UavL/Glider/pcb/r2-mainboard/datasheets/SiC OSD62x-PM/OSD62x-PM Layout Guide _ Octavo Systems_files/Octava-Systems-OSD32MP2-SiP-1024x734.jpg

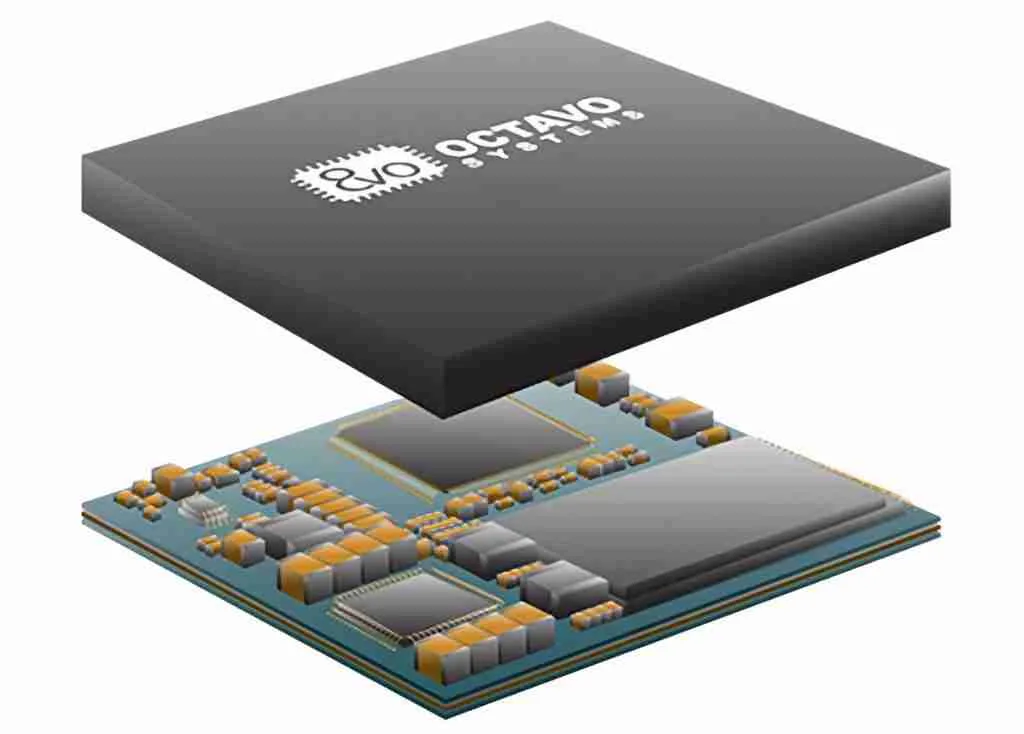
pcb/r2-mainboard/datasheets/SiC OSD62x-PM/OSD62x-PM Layout Guide _ Octavo Systems_files/Octava-Systems-OSD32MP2-SiP-1024x734.jpg
