UavL/Glider/pcb/r2-mainboard/datasheets/SiC OSD62x-PM/OSD62x-PM Thermal Guide _ Octavo Systems_files/osd3358-sm-red-angle-product-carousel.png

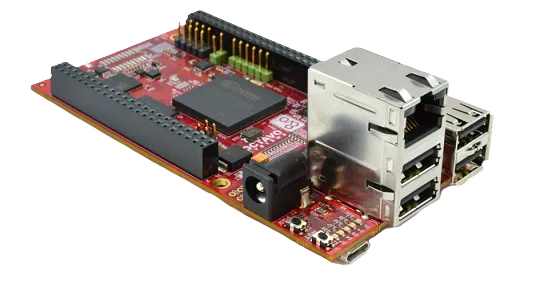
pcb/r2-mainboard/datasheets/SiC OSD62x-PM/OSD62x-PM Thermal Guide _ Octavo Systems_files/osd3358-sm-red-angle-product-carousel.png
