UavL/Glider/pcb/r2-mainboard/docs/libraries.md

# Project-local symbols and footprints — what was made here, and how to check it

Everything in `r2.kicad_sym` and `r2.pretty/` was **created for R2** because it did not exist in
KiCad's stock libraries or in the `pcb_common` submodule that came with Glider. This file is the
audit list: what each thing is, what it was derived from, which script emits it, and what was
actually checked.

**`pcb_common` has never been modified.** It is a submodule shared with R1; every addition went into
the project-local `r2` libraries instead, so `git -C pcb/pcb_common status` should always be clean.
If it is not, something has gone wrong.

Written 2026-08-31, at the owner's request, before rehoming the libraries.

---

## 1. How to re-derive any of these

Every entry is generated by a script in `tools/`, not drawn by hand. That is deliberate: a generated
footprint can be re-emitted and diffed against the datasheet numbers, and most of the generators
assert their own geometry. To check one, read the script's header — it names the drawing and the
page — then re-run it and confirm the file is unchanged.

## 2. Symbols — `r2.kicad_sym`

| Symbol | Part | Generator | Derived from | Checked |
| --- | --- | --- | --- | --- |
| `BQ25892RTW` | charger | `gen_r2_symbols.py` | `datasheets/Battery/bq25890.pdf` pin table | `battery.md` |
| `MAX17048` | fuel gauge | `gen_r2_symbols.py` | `datasheets/Battery/max17048.pdf` | `battery.md` |
| `MT9700` | EPD load switch | `gen_r2_symbols.py` | ported with R1's `epd_power` | `epd-port.md` |
| `SY8120` | buck | `gen_r2_symbols.py` | ported from R1 | `epd-port.md` |
| `TPS22965DSG` | load switch | `gen_r2_symbols.py` | `datasheets/Power/tps22965.pdf` | `power.md` |
| `TPS62A02DRL` | buck | `gen_r2_symbols.py` | `datasheets/Power/tps62a01.pdf` | `power.md` §3 |
| `TPS63802DLA` | buck-boost | `gen_r2_symbols.py` | `datasheets/Power/tps63802.pdf` | `power.md` §3 |
| `TPS7A0233DBV` | LDO | `gen_r2_symbols.py` | `datasheets/Power/tps7a02.pdf` | `power.md` |
| `USBLC6-2SC6` | USB ESD | `gen_r2_symbols.py` | ST datasheet | used on `U202`, `U1403` |
| `LM3630A` | frontlight driver | `gen_frontlight.py` | `datasheets/Frontlight/lm3630a.pdf` | `frontlight.md` |
| `BOM_ITEM` | placeholder for bought items with no pins (`X500`, `MK500`) | `gen_som.py` | — | `som.md` §10 |
| `BTH-060_AB` | SoM connector, module columns A+B | `gen_som_symbol.py` | `som_pinout.json` ← PHYTEC `L-1038e.A5` Tables 7–10 | `som.md` §10–11 |
| `BTH-060_CD` | SoM connector, columns C+D | `gen_som_symbol.py` | same | `som.md` §10–11 |
| **`TPS2553DBV`** | **USB current-limited switch** | **`gen_usb_host.py`** | **`datasheets/Power/tps2553.pdf` Pin Functions table** | **§4 below** |
| **`KLM8G1GETF-B041`** | **Samsung eMMC 5.1, 8 GB, 153-ball FBGA** | **`gen_emmc_symbol.py`** | **`datasheets/Storage/samsung_emmc.pdf` Rev. 1.21 [Table 2], parsed at run time, checked against a hand transcription of Figure 1** | **asserted by the generator: 153 pin numbers = the stock `LFBGA-153…` pads, names verbatim, types by rule, three units, no hidden pin, no two pins at one position, all on the 2.54 grid. Rendered with `kicad-cli sym export svg` and looked at. `sic.md` §6.1** |

The eMMC's **footprint is not ours**: `Package_BGA:LFBGA-153_11.5x13mm_Layout14x14_P0.5mm` from
KiCad's stock library, used as it is (JEDEC MO-276F, 153 lands of 0.24 mm at 0.5 mm pitch). It was
checked against the Samsung drawing — 11.5 × 13 mm body, 0.30 mm balls — and every ball the
datasheet names has a land. The board already places three other stock `Package_BGA` footprints, so
nothing was copied into the project.

## 3. Footprints — `r2.pretty/`

| Footprint | For | Generator | Derived from | Checked |
| --- | --- | --- | --- | --- |
| `Texas_DLA0010A_VSON-HR-10_2x3mm_P0.5mm` | `U13` `TPS63802` | `gen_power.py` | `tps63802.pdf` drawing **4223750/D** p.36 land pattern | `layout.md` §3.1 — two independent geometry assertions |
| `Texas_YFQ0012_DSBGA-12_1.91x1.39mm_Layout3x4_P0.4mm` | `U1300` `LM3630A` | `gen_yfq0012.py` | `lm3630a.pdf` mechanical drawing | `frontlight.md` §9.1 |
| `BTH-060-01-L-D-A-K_AB` | `J501` | `gen_som_footprint.py` | PHYTEC DXF `PCM-071_1573-1.dxf` + Samtec drawing | `som.md` §11, `check_pcb_connectors.py` |
| `BTH-060-01-L-D-A-K_CD` | `J502` | `gen_som_footprint.py` | same | same |
| `PCM-071_Module` | `X500` — outline + 2× M2.5, **no pads** | `gen_som_footprint.py` | PHYTEC DXF, `BOARD_OUTLINE` layer | `som.md` §11 |
| `SolderPads_1x03_P3.50mm_Wire` | `J25` cell solder pads | `gen_solderpads.py` | drawn to spec, no datasheet | `battery.md` §9 |
| **`HC-FPC-05-09-8RLTAG_Mirrored`** | **`J1300` frontlight** | **`gen_mirrored_fpc.py`** | **mirror of `pcb_common`'s `HC-FPC-05-09-8RLTAG`** | **§4 below** |
| **`Omron_XF2M-4015-1A_1x40-1MP_P0.5mm_Horizontal_Mirrored`** | **`J1000` panel** | **`gen_mirrored_fpc.py`** | **mirror of KiCad's stock `Omron_XF2M-4015-1A…`** | **§4 below** |

## 4. The three added 2026-08-30/31, in more detail

These are the newest and the least reviewed, so they are worth checking first.

### 4.1 `TPS2553DBV` symbol

Pin assignment is straight off the datasheet's **Pin Functions** table (SOT-23 column), which lists
two variants — the `TPS2552` has `EN` active *low* on pin 3 and the **`TPS2553` has `EN` active
high**. We fit the `TPS2553`, so `EN` is active high, which is what lets the SoM's `X_USB1_DRVVBUS`
drive it directly with no inverter.

| Pin | Name | Type |
| ---: | --- | --- |
| 1 | `IN` | power_in |
| 2 | `GND` | power_in |
| 3 | `EN` | input — **active high** |
| 4 | `~{FAULT}` | open_collector |
| 5 | `ILIM` | passive |
| 6 | `OUT` | power_out |

**Footprint is KiCad's stock `Package_TO_SOT_SMD:SOT-23-6`** — nothing new was drawn for it.

⚠ **What to check:** that pin 3 really is `EN` and not `EN` on the part you order. The `-1` suffix is
the latch-off version and the `TPS2552` is the active-low sibling; both are the same package with the
same pin *numbers*. We specify `TPS2553DBVR`, LCSC `C55266`.

### 4.2 The two `_Mirrored` FPC footprints

These are **not new land patterns**. Each is its parent with the *numbered pads mirrored in X* and
the pin-1 silkscreen tick moved; the body, the courtyard and the mechanical pads are untouched.

Both parts happen to carry **two symmetric mechanical pads** (±2.75 mm and ±11.4 mm), so the land
pattern is geometrically identical to the original — the same physical connector solders down in the
same orientation, and only *which net reaches which contact* changes.

They exist because the panel's two tails arrive with their pin 1 at opposite ends, and neither stock
footprint matched: `HC-FPC-05-09-8RLTAG` numbers from +x, `Omron XF2M-4015-1A` from −x. Full
reasoning and the bench measurement in `epd-port.md` §9.6.

⚠ **What to check:** `gen_mirrored_fpc.py` asserts, on every run, that pad 1 lands on pad *N*'s old
x and that the mechanical pads did not move. Re-run it and confirm the files are byte-identical. Then
check the *silkscreen pin-1 marker* has moved with the pads — it is the only thing an assembler sees.

This is also the convention `pcb_common` already uses: it ships **eight** `_Mirrored` variants
(`Xunpu_FPC-05F-8PH20_…`, `Hirose_FH12-…`) for exactly this reason. We put ours in `r2.pretty`
instead of adding to the submodule.

## 5. Not ours

For completeness, so the audit does not chase them:

- **`SAMTEC_BTH-060-X-X-D-A-K.kicad_mod`** in `datasheets/SoM Phycore AM62x/BTH-060-01-L-D-A-K-TR/`
  is Samtec's own download. It is *not* what the board uses — `gen_som_footprint.py` emits the two
  half-connectors with the module's pad names instead (`som.md` §10.2).
- Everything under `pcb_common/` came with Glider and is shared with R1.
- `Connector_Generic_MountingPin:Conn_01x40_MountingPin`, embedded in `epd.kicad_sch`, is KiCad's own
  symbol — but this machine has no KiCad symbol libraries installed, so `patch_j6_40pin.py` generated
  it by transforming the 50-pin variant already embedded in that sheet (drop pins 41–50, shift the
  rest by 12.7 mm). It is why ERC reports one `lib_symbol_mismatch` for it. **If you install KiCad's
  stock libraries, replace the embedded copy with the real one** and that warning goes away.

## 6. The owner's `Reflow` library — entries the assistant generated or checked

`library/Reflow.kicad_sym` and `library/Reflow.pretty/` are the owner's. Two entries arrived on
2026-09-11 from the SamacSys model Mouser links to (`library/LIB_OSD6254-1G-IPM.zip`).

| Entry | Part | Generator / origin | Derived from | Checked |
| --- | --- | --- | --- | --- |
| `OSD6254-1G-IPM` (symbol) | Octavo `OSD62x-PM` SiP | **`gen_osd62x_symbol.py`** — replaces SamacSys's single-unit import in place, same name | `datasheets/SiC OSD62x-PM/osd62x_pm_pinout.json` ← datasheet Rev. 2.0 Tables 5-1…5-7 (`parse_osd62x_pinout.py`), cross-checked against Octavo's own Eagle library in the BRK files, 500/500 | asserted by the generator: pin numbers = datasheet balls = footprint pads; names verbatim; types per `osd62x-symbol-guide.md` §3.3; 11 units, no hidden pin, no two pins at one position, all on the 2.54 grid; `VIDEO` = the 22 DPI balls. Rendered with `kicad-cli sym export svg` and looked at |
| `BGA500C50P28X18_1400X900X130` (footprint) | same | SamacSys, KiCad-5 `(module …)` format, used as downloaded | SamacSys | 500 pads named exactly as the datasheet's balls; **0.20 mm round lands**; 0.5 mm pitch, 28 × 18; row A along the top (top view). **Not yet checked:** courtyard, fab and silk outline against the datasheet's p. 31 drawing. Its 3D model path is a bare `OSD6254-1G-IPM.stp`, which will not resolve |
| `OSD62x-PM` (symbol) | — | the owner's | — | an empty stub — no pins, blank fields, used by no sheet. Left alone |
| **`TPS6521903`** (symbol) | **TI `TPS65219` PMIC — `U1501`** | **`gen_pmic_symbol.py`** — the owner created the container (name, Value, Description, an **embedded copy of the datasheet**); the script supplies pins, body and fields and writes the embedded block back verbatim | **`datasheets/Power/tps65219.pdf` (`SLVSGA0D`) Table 5-1**, transcribed and re-parsed from the PDF at run time | asserted by the generator: 29 of 33 rows re-parse and match the transcription (the other four defeat pdftotext's columns — the script asserts *which* four); pin numbers 1–33 = the stock footprint's pads; names verbatim; no hidden pin, no two pins at one position, all on the 2.54 grid; the embedded datasheet kept. Rendered and looked at |

The PMIC's **footprint is not ours** either: `Package_DFN_QFN:Texas_RHB0032E_VQFN-32-1EP_5x5mm_P0.5mm_EP3.45x3.45mm_ThermalVias`
from KiCad's stock library. The datasheet's package is **`RHB0032W`** (5 × 5 mm, 0.5 mm pitch, exposed
pad 3.5 mm), so the stock `…E` land pattern is 0.05 mm under on the pad; the `_ThermalVias` variant
already carries the ≥ 9 vias the datasheet requires under the power pad. `RHB0032M` is wrong — its
pad is 1.4 mm too small.

The SamacSys originals stay as they arrived: `library/OSD6254-1G-IPM.kicad_sym` (one unit, 500 `passive`
pins, names mangled where the datasheet wraps a line, e.g. `MCU__UART0_RTSN`) and the zip.
