UavL/Glider/pcb/r2-mainboard/docs/layout.md

# Layout — R2 Stage D

Status (2026-09-11): **routing under way on a six-layer, 0.8 mm board** (§4.1.1, owner-confirmed).
The DDR3 bus is being routed. **The SoM corner is frozen:** the compute module is switching from the
`PCM-071` to Octavo's `OSD62x-PM` (`NOTES-R2-osd62x-plan.md`), so `J501`/`J502`/`X500` will be
deleted; the sections below that place and escape the `PCM-071` are the record of that design.
~~Preparation done, placement blocked on ONE owner decision (§1) — where the SoM sits. Nothing has
been placed; `r2.kicad_pcb` does not exist yet.~~

This is the board-level plan. The *circuit-level* rules live with their sheets, and they were
written while each datasheet was open rather than reconstructed now:

| Sheet | Guidelines | The one thing that matters most |
| --- | --- | --- |
| `battery` | `battery.md` §11 | the grounds are not all the same net |
| `power` | `power.md` §11 | four converters, one rule they share; `TPS63802` has **two** switching nodes |
| `mcu` | `mcu.md` §11 | the 32.768 kHz crystal is the most layout-sensitive circuit on that sheet |
| `epd`, `epd_power`, `power_mon` | `epd-port.md` §11 | ⚠ **two ICs have a `GND` pin that is not ground** |
| `fpga_io`, `fpga_ddr`, `fpga_config` | `fpga.md` §11 | 666 MT/s against a 1066 part — the margin is the useful fact |
| `som`, `dpi_in` | `som.md` §8 | MMC1 length-match 12.7 mm; `DPI_R6`/`R206` carry no components |

**Read `epd-port.md` §11.1 before placing anything on the HV chain.** `U1103` and `U1106` are inverting
buck-boosts: their `GND` pins sit on `-VGL` (−20 V) and `-VN` (−15 V), verified from the exported
netlist. Each needs a local copper island with the plane cut away beneath it, and connecting either
to the ground plane destroys the part. It is the only thing on this board that a competent person
would "fix" into failure.

---

## 1. What blocks placement, and what does not

**Revised 2026-08-17. Two of the three are answered; one remains.**

1. **Board outline — the two objects that set it are now known.** The panel module
   (`GDEP103TC2-FT11`) is **174.4 × 216.7 × 1.93 mm**, 110 g ‡, with a 157.25 × 209.66 mm active
   area; the cell (`PL706090`) is **60 × 90 × 7.0 mm**. Those bound the enclosure, and the board has
   to fit in what is left behind the panel and beside the cell. R1 is **90 × 80 mm** for reference —
   so R1's area fits behind this panel with room over, and **thickness, not area, is the binding
   dimension.** The outline itself is still the owner's to draw, but it is no longer unconstrained.
   `panel.md` §0, `battery.md` §8.1.
2. ~~**Where the SoM sits, and on which side**~~ — **position ANSWERED 2026-08-20, side inferred.**
   See §1.1.
3. ~~**Battery cell size and position**~~ — size **closed** (60 × 90 × 7.0 mm). Position follows
   from decision 2.

### 1.1 The SoM goes top-right, beside the USB ports — owner, 2026-08-20

> ⚠ **2026-09-11:** the module in this section is the `PCM-071`, being replaced by the `OSD62x-PM`
> (`NOTES-R2-osd62x-plan.md`). The **position** reasoning carries over unchanged — the USB pair is still
> why the SoC sits beside the ports. The **thickness** table does not: the SiP is 1.3 mm tall, not a
> 5.0 mm stack, so the 7.0 mm cell becomes what sets the device's depth (inferred).

From the owner's layout sketch and its covering note: *"The SoM should be located near the top right
where I would place the USB ports."* Everything else on that sketch is recorded in §1.2.

**Position: top right, adjacent to the USB connectors.** This is the right call for a reason the
sketch does not say out loud, and it is worth writing down because it constrains everything after
it: the `X500` escape carries `USB_DP`/`DM` as a 90 Ω pair (§4), and USB 2.0 high-speed is the one
signal group on this board that is genuinely intolerant of a long, stubby, via-laden route. Putting
the module next to the socket makes that pair short and straight. Nothing else on the module's
escape has that property — DPI is 22 slow single-ended lines, MMC1 is length-matched but short, and
the rest is SPI and UART.

**Side: the face pointing *away* from the panel. Confirmed by the owner 2026-08-20.** The panel is
216.7 × 174.4 mm and sits directly over the board, so a 5 mm module on the panel-facing side would
force a cut-out or a spacer through the largest and most fragile component in the device. The back
face has nothing above it but the case.

The thickness bookkeeping, since it also fixes the enclosure's depth:

| Stack | Height |
| --- | ---: |
| panel module | 1.93 mm |
| mainboard, panel side | PCB ~1.0 mm + whatever is placed there |
| mainboard, back side | + **5.0 mm** for the SoM's stack height, + the module's own PCB |
| the cell, in its own area of the enclosure | 7.0 mm |

**The cell and the SoM do not stack.** The sketch draws the board and the cell as two separate
rectangles that do not overlap in plan — the cell has its own patch of the enclosure beside the
board, rather than sitting behind it. So the device's depth is the *larger* of the two stacks, not
their sum, and the SoM is no longer "the thickest thing in the device" the way earlier revisions of
this section claimed.

**This also decides which side `J1` mounts on** — a mid-mount or through-hole USB-C socket has a
side, and `USB1` (`NOTES-R2-review-round-2.md` D-3) would join it.

**One thing the position costs, and it is not free.** Top-right is also where the panel's own tails
want to be (§1.2), and `epd-port.md` §11 needs the HV chain near `J1000`. Those two groups now compete
for the same corner. The resolution is in `Project_description.md`'s favour: the SoM's USB pair is
the timing-critical one, the HV chain is DC, so **the HV chain moves and the SoM does not**.

### 1.2 The rest of the sketch — recorded, and what each thing constrains

Read off the owner's hand sketch of 2026-08-20. Dimensions are approximate where the sketch says so.

| Object | Sketch | Against what is already known |
| --- | --- | --- |
| Enclosure | ≈ **220 × 180 mm** | panel module is 216.7 × 174.4 mm ‡ — so the case is the panel plus ~3 mm of bezel each way. Consistent. |
| Mainboard | ≈ **90 × 70 mm**, *"the same as R1 but can be made bigger"* | R1 is 90 × 80 mm. So R2 is R1's footprint or slightly smaller, with room to grow. |
| Cell | **90 × 60 mm**, beside the board | matches `PL706090` exactly (60 × 90 × 7.0 mm, `battery.md` §8.1) ✓ |
| Power switch | right-hand edge, marked `ON` / `OFF` | this is `SW400` (`mcu.md` §5.5). An edge slider, not the recessed pinhole the doc left open. |
| Touch | its own small board | consistent with `io-expansion.md` §4 — the `GT9110H` is on its own PCB, not on the panel flex. |
| *"TTL Interface"* | a block ≈ **40 × 37 mm** | **not a board** — see below |

**The `TTL Interface` block is not a second PCB — it is where the panel's flex lands.** The owner,
2026-08-20: *"the TTL interface is just the flex cable that is bent under the display and that's
about where it lands on the PCB, so the connector can be fit accordingly."* **This closes D-7 as
"no separate board"**, and it turns the block from an architectural question into the most useful
kind of layout constraint: a fixed landing zone.

So `J1000` is **enclosure-fixed, and now positionally fixed too**. It is not free to move to wherever
routing prefers; it goes where the folded tail arrives, facing the fold. Two consequences worth
carrying into placement:

- The **HV chain has to follow `J1000`** (`epd-port.md` §11), and §1.1 already said the HV chain is
  what moves when it competes with the SoM. That is now settled in both directions: the SoM is
  fixed at top-right by USB, `J1000` is fixed by the flex, and the HV chain fits around both.
- The connector's **orientation matters as much as its position.** A tail folded under the panel
  arrives from one direction only; a horizontal FPC connector facing the wrong way adds a 180° loop
  in a 0.5 mm flex, which is a reliability problem, not a routing one.

**`J1400`/`J1401`, touch and pen, are the same story.** The owner: *"touch is also a flexible connector
that is folded under."* So they join `J1000` and `J1300` in the enclosure-fixed group and want the same
treatment — landing zone first, orientation second, routing last. `io-expansion.md` §4's open item
is unaffected: it is about the *pin order* on the `GT9110H`'s tail, which is still a vendor
question, not about where the connector sits.

**`J1300`, the frontlight, is the one that is still undrawn.** The owner: *"the frontlight I still
haven't drawn because the schematics in the display docs don't define it."* That is consistent with
`frontlight.md` §6.2 — the tail is `LED1±`/`LED2±`, bare anodes and cathodes, and the vendor has not
given the per-string current. The 8-pin FPC is on the board and the `LM3630A` drives it; what is
missing is a number for the bench to confirm, not a circuit.

**Three placement facts that arrived with the panel**, none of them blocking:

- **A new connector, `J1300`** — the 8-pin frontlight FPC (`frontlight.md` §6.2). It joins `J1000`,
  `J1400` and `J1401` in the enclosure-fixed group, because all four tails emerge from the panel.
  That corner is now four connectors plus a DSBGA boost.
- **`frontlight`'s layout rules changed completely.** `power.md` §11.2 no longer applies to that
  sheet — different part, different topology, and asynchronous, so the diode is in the hot loop.
  `frontlight.md` §9 is the replacement.
- **`epd_power` gains one changed resistor**, `R1117` (`epd-port.md` §10). No geometry consequence.

**Not blocking, and worth saying so:** the layer count. R1 runs *this same* DDR3-666 and Spartan-6
on **4 layers** (`F.Cu / In1.Cu / In2.Cu / B.Cu`, 0.127 prepreg / 0.6 core / 0.127 prepreg, ~1.0 mm),
and it works. R2 adds the SoM, but the module carries its own DDR4 and eMMC internally; what
crosses `X500` is DPI at ~101 MP/s, USB 2.0, SPI, UART and MMC1. **Recommendation: 4 layers, R1's
stackup**, and only revisit if the `X500` escape proves tight — which is unlikely, because 115 of the
240 pins are no-connects and need no escape at all (§4).

## 2. Where the design stands

| | R1 | R2 |
| --- | --- | --- |
| Board | 90 × 80 mm, 4 layers | outline undecided |
| Footprints placed | 379 (333 front, 46 back) | **312 parts, 0 without a footprint** |
| Footprints that do not resolve | — | **2** (§3) |
| Netlist | — | 504 nets, hierarchy fully connected, 0 dangling |

The footprint audit is the useful result: **every one of the 312 parts has a footprint assigned,
and only two do not resolve against the project's own libraries.** The project `fp-lib-table` is
healthy and points at `pcb_common/footprints.pretty` (204 footprints) and `r2.pretty`; the broken
tables are the *global* ones, which are the owner's and do not affect this project.

## 3. Footprints — both gaps closed

### 3.1 ~~`r2:Texas_DLA0010A_VSON-HR-10_2x3mm_P0.5mm`~~ — **built 2026-08-15**

From `datasheets/tps63802.pdf` drawing **4223750/D**, the LAND PATTERN EXAMPLE on p.36, read off
the drawing's printed numerals. KiCad ships the 8-pin sibling (`Texas_VSON-HR-8_1.5x2mm_P0.5mm`)
but not this one, and the generic `WSON-10-1EP_2x3mm` is **not** a substitute — VSON-HR has no
central exposed pad and its pads are deliberately asymmetric.

| Pins | Size | Centre x | Function |
| --- | --- | ---: | --- |
| 1–5 | 0.60 × 0.25 | −0.90 | `EN`, `MODE`, `AGND`, `FB`, `PG` — signals |
| 6, 7, 9, 10 | 0.90 × 0.25 | +0.75 | `VOUT`, `L2`, `L200`, `VIN` — power |
| **8** | **1.30** × 0.25 | +0.55 | **`GND`** — the switching return, hence the widest |

Pitch 0.5 mm, 2.0 mm span, body 2 × 3 mm. **Two independent checks passed**: every pad's outer
edge lands on ±1.20 mm — which is what makes the three different widths and three different centres
consistent rather than arbitrary — and the width tiers match the pin functions exactly, signal
narrow and power-ground widest. The generator asserts both.

### 3.2 The SoM: two connector footprints plus a module outline

> **Built 2026-08-20**, and **restructured the same day** when the owner chose two connector symbols
> over one 240-pin module symbol. `tools/gen_som_footprint.py` now emits three footprints into
> `r2.pretty`. The full derivation and the verification are in **`som.md` §10 and §11**; this
> section keeps what a person placing the board needs.

| Footprint | Ref | Pads | Origin, in the module frame |
| --- | --- | --- | --- |
| `r2:BTH-060-01-L-D-A-K_AB` | `J501` | 120 (`A1`–`A60`, `B1`–`B60`) + 2 NPTH | (4.800, 23.900) |
| `r2:BTH-060-01-L-D-A-K_CD` | `J502` | 120 (`C200`–`C1000`, `D1100`–`D60`) + 2 NPTH | (27.200, 19.100) |
| `r2:PCM-071_Module` | `X500` | **none** — outline and 2× M2.5 only | module centre |

Pads keep the **module's** names, not Samtec's `1`–`120`, so a pad reads straight against
`L-1038e.A5` Tables 7–10 while routing.

| | |
| --- | --- |
| module outline | **32.000 × 43.000 mm**, `BOARD_OUTLINE`, exact |
| connector centrelines | x = **4.800** and **27.200** — 22.400 apart, symmetric about 16.000 |
| stagger | `J502` sits **4.800 mm** lower than `J501` |
| pitch / span | **0.500** / **29.500**, exact |
| rows, left to right | **B A** then **D C**; pin 1 at the bottom |
| M2.5 mounting holes | (2.800, 2.800) and (29.200, 40.200); ⌀2.600 drill, ⌀4.000 plating |
| stack height | 5 mm, set by two M2.5 F-F standoffs |

Both outer rows land **0.990 mm** inside the module's edges, with 0.0 µm of skew — a real check,
since it falls out of the DXF rather than being imposed.

⚠ **`tools/check_pcb_connectors.py` must pass before every fab order.** Nothing in KiCad ties the
three footprints together, so it asserts `J501` = `X500` + (−11.200, −2.400), `J502` = `X500` +
(+11.200, +2.400), same side, same rotation, 122 pads on each receptacle and 2 on the module. It
exits non-zero, so it can gate a release script.

**Two things layout has to know:**

1. **The courtyards cover the connectors, not the module.** The module stands 5 mm off the board, so
   low parts may live underneath — and `X500` has no courtyard at all. ⚠ **DRC will not police
   component height under the SoM.** The 32 × 43 outline is on `F.Fab` and `User.Drawings` with silk
   corner ticks, and *"nothing tall under the module"* is a manual check. Measure against the
   assembled stack, not the 5 mm number.
2. **The alignment holes come from Samtec, not from the DXF** — `som.md` §11.1 explains why the
   DXF's four `MOUNTING_HOLES_LAYER` circles are the *plug's* locating holes rather than ours.
   Trusting them would have put both connectors 0.62 mm out.

**Sourcing:** 2 × `BTH-060-01-L-D-A-K-TR`, LCSC `C3646540`, **60 in stock on 2026-08-20** — 30
boards, the tightest line on the BOM. Plus `MK500`, PHYTEC's M2.5 kit.

## 4. Escape and net classes

115 of the SoM's 240 pins are no-connects, so the `X500` escape is far smaller than the pin count
suggests: about **40 signals plus 3 `VIN` and 45 grounds**. The grounds are what the escape is
really made of, and they are all one net, so they can via straight down.

Proposed net classes, derived from the per-sheet guidelines rather than invented here:

| Class | Nets | Why it is its own class |
| --- | --- | --- |
| `DDR3` | 48 bank-3 nets | length-matched per byte lane; `fpga.md` §11.1 |
| `DDR3_CLK` | `DRAM_CKP`/`CKN` | differential, `R800` 100 Ω at the DRAM end |
| `DPI` | the 22 `DPI_*` | ~101 MP/s, over continuous ground; `DPI_R6`/`R206` carry **no** components |
| `USB` | `USB_DP`/`DM` | 90 Ω differential |
| `MMC1` | the 8 microSD nets | length-match within 12.7 mm; `som.md` §8 |
| `HV` | `+VP`, `+VGH`, `-VCOM`, `-VGL`, `-VN` | not plane nets; clearance, not width |
| `EPD` | the 23 `EPDC_*` | added 2026-08-21 — the table above missed them; R1 had a class for them and they are the second-largest routed group here |
| `PWR` | every rail, and `GND` | width for current |
| default | everything else | |

`DRAM_ADDR13`/`ADDR14` must be **excluded** from the `DDR3` class (`fpga.md` §11.1): they are the
inert density-expansion nets, and a net-class length-match rule would drag the real group's
tolerance around for two dead traces. That is why the address patterns are written as ranges
(`DRAM_ADDR[0-9]`, `DRAM_ADDR1[0-2]`) rather than `DRAM_ADDR*`.

### 4.1 The numbers — imported from R1, 2026-08-21

Run once, with KiCad closed:

```bash
python3 tools/import_r1_settings.py            # dry run, prints every change
python3 tools/import_r1_settings.py --write
```

~~**R2's stackup is byte-identical to R1's**~~ — that was the justification for copying R1's
geometry rather than calculating it, and **it stopped being true on 2026-09-03**, when the owner
chose a 1.0 mm four-layer stack-up (`datasheets/PCB/4-layers PCB.pdf`) and moved to a
**sig / gnd / gnd / sig** arrangement. §4.1.1a has those numbers — and **they were superseded in turn by the 0.8 mm six-layer
board, §4.1.1**. The track widths in the table
below still stand — they are what the BGA escapes and the 76 mm length budget allow — but the
*impedance* they produce has changed, so the copied-from-R1 reasoning no longer carries them.

| Class | Track | Clearance | Via | Pair (W/gap) | Where the number comes from |
| --- | --- | --- | --- | --- | --- |
| default | **0.20** | 0.11 | 0.6/0.3 | 0.2/0.2 | nothing needs less unless it is escaping a fine-pitch part |
| `DDR3` | 0.127 | 0.11 | 0.45/0.3 | 0.127/0.11 | R1's `SDRAM_A`/`_H`/`_L`, verbatim |
| `DDR3_CLK` | 0.127 | 0.11 | 0.45/0.3 | 0.127/0.11 | same, split out so it routes first |
| `DPI` | 0.15 | 0.11 | 0.45/0.3 | — | no length-match to hold, long run |
| `EPD` | 0.11 | 0.11 | 0.45/0.3 | 0.127/0.11 | R1's `EPD`, verbatim |
| `USB` | 0.11 | 0.11 | 0.45/0.3 | 0.15/0.11 | R1's `USB`, verbatim |
| `MMC1` | 0.15 | 0.11 | 0.45/0.3 | — | `som.md` §8 |
| `HV` | 0.30 | 0.11 | 0.6/0.3 | — | handling and etch tolerance, not ampacity |
| `PWR` | **0.60** | 0.11 | 0.8/0.35 | — | a **floor**, not a target — see below |

⚠ **The table above is the import, not the file.** As of 2026-09-03 `r2.kicad_pro` has drifted:
`DDR3` and `DDR3_CLK` are at 0.10 mm clearance with 0.6/0.3 vias, `DDR3_CLK` has no pattern and is
dead, and a new `DDR_DIFF` class (patterns `/fpga_ddr*P` and `/fpga_ddr*N`, which correctly catch
exactly the six differential nets and nothing else) carries the three pairs. Classes `Signals_NET`,
`TX/RX` and `I2C` were added by hand and are not described here at all; `HV <- /EPD*` is putting EPD
signals into the 0.3 mm HV class, which looks unintended. §4.3 covers what to change in `DDR_DIFF`.
Read the file, not this table, before relying on a number.

**Two of these are easy to misread.**

`PWR`'s 0.60 mm is the narrowest a rail may ever neck down to, not the width to draw. `power.md`
§11.6 item 2: the boost pulls **~2.8 A off `+VSYS` at 1 MHz** and wants real copper. `+VSYS` is a
plane. A 0.6 mm trace carries roughly 1.5–2 A on 1 oz outer copper, so anything at that width on a
rail is a mistake waiting to be found with a thermal camera.

`HV`'s clearance is **0.11 mm like everything else**, which looks wrong for rails running +28.4 V to
−20 V. The separation those need is enforced in `r2.kicad_dru` instead, as a rule restricted to
tracks — because a net-class clearance is *also* checked pad-to-pad inside a footprint, and `+VGH`
lands on a 0.5 mm-pitch VSON-HR-10 whose own pads sit 0.25 mm apart. Raising the class clearance
would produce DRC errors that no amount of routing can clear.

### 4.1.1 The 0.8 mm six-layer stack-up — current, owner-confirmed 2026-09-11

**R2 is a six-layer board.** The owner, 2026-09-11: *"It is definitely a 6-layer stack up."* Source:
**`datasheets/PCB/6-layers PCB_3313.pdf`** (2026-09-06; the fab is not named in the PDF, but it uses
the same template as the four-layer PDFs of §4.1.1a). **§4.1.1a — the four-layer decision of
2026-09-03 — is superseded.**

| Layer | Material | After lamination | Role on the board — `r2.kicad_pcb` zones and tracks, 2026-09-10 |
| --- | --- | --- | --- |
| L1 `F.Cu` | 0.5 oz plated to 1 oz | 0.0348 mm finished | signals; `U700`, `U800` |
| prepreg | 3313 RC58 %, DK 4.45 | **0.0925** | |
| L2 `In1.Cu` | 1 oz | 0.035 | **GND**, whole board (the zone is *named* "Power Plane" but its net is `GND`) |
| core | DK 4.6 | 0.13 (0.2 with copper) | |
| L3 `In2.Cu` | 1 oz | 0.035 | **power pours** — `VSYS`, `+3V3`, `+3V3_AON`, `+1V5`, `+1V2_FPGA` |
| prepreg | 3313 RC58 %, DK 4.45 | 0.082 | |
| L4 `In3.Cu` | 1 oz | 0.035 | signals (119 segments) |
| core | DK 4.6 | 0.13 (0.2 with copper) | |
| L5 `In4.Cu` | 1 oz | 0.035 | **GND**, whole board |
| prepreg | 3313 RC58 %, DK 4.45 | 0.0925 | |
| L6 `B.Cu` | 0.5 oz plated to 1 oz | 0.0348 finished | signals |

0.8 mm finished, ENIG.

**What it settles.**

- **UG388's ground reference for the top-side DDR bus is met:** `F.Cu` sits 0.0925 mm over `In1.Cu`,
  which is ground. That was the whole reason §4.1.1a gave up its power plane; six layers get it
  without giving anything up.
- **Impedance** *(inferred — the same Hammerstad–Jensen method as §4.1.1a, outer layers, h 0.0925 mm,
  εr 4.45, t 0.0348 mm; check against the fab's calculator)*: 0.11 mm → 54 Ω · **0.127 mm → 50 Ω** ·
  0.15 mm → 46 Ω · pair 0.11 / 0.17 → 99 Ω · pair 0.127 / 0.15 → 90 Ω. So the DDR bus's 0.127 mm is
  already ~50 Ω, and §4.1.1a's "0.30 mm for 50 Ω is impossible" problem is gone.
- **Crosstalk:** §4.3's 0.38 mm spacing is **4.1 × h** here, against 2.0 × h on the 7628 board.
- **The `OSD62x-PM` swap relies on this stack-up** — `In2.Cu` carries its `VDD_CORE`/`VDDS_DDR`
  island (`NOTES-R2-osd62x-plan.md`).

**Three things to watch.**

1. **`In3.Cu`'s nearest plane is `In2.Cu` — power, 0.082 mm away — not `In4.Cu` (GND, 0.13 mm).** A
   signal on `In3.Cu` returns through whatever `In2.Cu` pour is above it, so keep those pours solid
   under the route, decouple them to ground, and don't route `In3.Cu` across a pour boundary (inferred).
2. **KiCad's Physical Stackup differs from the PDF in two small places:** dielectric 4 (the
   `In3`–`In4` core) is 0.12 mm in KiCad and 0.13 mm in the PDF, and dielectric 5 has εr 4.5 against
   the PDF's 4.45. Fix both in Board Setup; they move impedance and delay figures slightly.
3. **Four real shorts** reported by DRC on 2026-09-10 are all `In3.Cu` tracks crossing through-vias of
   other nets — worth a look before routing more on that layer.

### 4.1.1a ~~The 1.0 mm stack-up, and sig/gnd/gnd/sig — owner, 2026-09-03~~ — superseded

> Kept for the record. Its **reasoning** still applies — the DDR bus on `F.Cu` must reference ground
> (it does: `In1.Cu`), and crosstalk scales with s/h — but its **numbers** belong to a board that will
> not be built: the 7628 dielectric, the 73 Ω / "0.30 mm for 50 Ω" problem and the two-solid-grounds
> arrangement are all gone. The current stack-up is §4.1.1.

`datasheets/PCB/4-layers PCB.pdf`, verbatim: 1.0 mm finished, prepreg **7628 RC46 %, 0.1960 mm
pressed to 0.1855 mm, DK 4.74**, core **0.43 mm, DK 4.6** (0.5 mm with copper), inner copper 1 oz,
**outer 0.5 oz base plated to 1 oz (0.0348 mm)**, 70 % inner residual copper ratio.

⚠ **This file was replaced on 2026-09-03 and the numbers moved a long way.** The first version was
2116 RC58 % (0.1125 mm pressed, DK 4.45) with **2 oz** outer copper. 2 oz was the disqualifier —
§4.1.2 — so the owner took the 1 oz option, and it comes with 7628 prepreg instead: **65 % more
dielectric height and a higher DK**. Anything quoting 0.1125 mm or DK 4.45 predates that swap.

**The plane arrangement changes with it.** R2 inherited R1's sig / pwr / gnd / sig, which put
`In1.Cu` — the layer 0.1125 mm under `F.Cu`, and therefore the reference for everything routed
there — on **`+3V3`**, not ground. UG388 p.42 requires the DDR data group to reference a **GROUND**
plane, and `U700` and `U800` are both on `F.Cu`. The owner's decision is **sig / gnd / gnd / sig**:
`In1.Cu` and `In2.Cu` both solid ground, power distributed as pours on `F.Cu`/`B.Cu`.

Why it is the right call for this board specifically, rather than as general advice:

- It is the only arrangement that satisfies UG388 for a top-side DDR bus, and the bus has 0.05 % of
  timing margin at the MCB (§7.2). It removes the need for any layer change on the data group —
  breakout vias only, inside UG388's two-via budget.
- A signal hopping `F.Cu` → `B.Cu` gets a stitching via to return through. Across a GND/PWR pair the
  return has to cross through decoupling capacitors instead, which is what quietly costs margin.
- Almost nothing is given up: the interplane capacitance of a GND/PWR pair across a **0.6 mm** core
  is negligible, so it was never doing decoupling work.

⚠ **Three conditions come with it.**

1. **Keep `In1.Cu` and `In2.Cu` both solid.** Carving power into `In2.Cu` puts everything on `B.Cu`
   back to a power reference. If some has to go there, confine it to the battery/charger/buck corner,
   which is spatially clear of the FPGA/DDR corner, and keep `B.Cu` signals out of those regions.
   The `-VGL`/`-VN` island cut-outs of §7.1 remain deliberate local breaks in both grounds.
2. **Stitch the two grounds** around the DDR group, the SoM, and every signal via. Two ground planes
   that are not well tied are worse than one.
3. **The PDN gets harder, not easier.** `fpga.md` §11.5 already has the bulk-substitution question
   open; losing the `+3V3` plane raises the inductance from bulk to ball. The 470 nF parts hard
   against their balls with their own vias stops being a preference.

**Impedance on the new geometry** *(inferred — Hammerstad-Jensen with thickness correction, no field
solver, solder mask ignored, ±5 %; check against the fab's own calculator before ordering)*:

Use the **finished** outer copper, 0.0348 mm, not the 0.0175 mm base foil — plating adds copper to
the outer layers and the field sees what is there at the end. Entering the base foil over-estimates
Z0 and sends the width 5 % wide (0.313 mm instead of 0.298 mm).

| At 0.127 mm width | R1 (proven) | 2116, superseded | **7628, current** |
| --- | --- | --- | --- |
| Z0 single-ended | ≈ 64 Ω | 59 Ω | **73 Ω** |
| Γ into the MCB's 50 Ω driver | 12 % | 8 % | **19 %** |
| Width for 50 Ω | 0.19 mm | 0.18 mm | **0.30 mm** |
| §4.3's 0.38 mm spacing, in units of h | 3.0 × h | 3.4 × h | **2.0 × h** |
| Pair geometry for 100 Ω | 0.11 / 0.11 | 0.11 / 0.11 | **0.15 / 0.11** |
| Delay | — | 6.04 ps/mm | 6.11 ps/mm |

Three things follow, and only the first is obvious.

1. **0.30 mm is geometrically impossible on this bus.** The FTG256 leaves 0.60 mm between adjacent
   pads (§4.3), so a 0.30 mm trace at the 0.1 mm floor needs 0.5 mm — exactly one trace fits between
   two balls, and the 3×-width spacing rule is violated everywhere. 43 signals at that width will not
   fit the corner, let alone inside the 76 mm length budget.
2. **Crosstalk is worse on this stack-up at the same spacing**, because coupling scales with s/h, not
   with s. The 0.38 mm rule is 3.4 × h on 2116 and 2.0 × h on 7628 — same rule, roughly twice the
   coupling. The return loop area grows with h too, which erodes part of what §4.1.1's plane change
   was bought for.
3. **The differential pairs get easier.** 0.15 mm on a 0.11 mm gap lands on 100 Ω here, where the
   2116 stack wanted 0.11 / 0.11.

**So: route 0.127 mm through both BGA escapes, where there is no choice, then widen to 0.20–0.25 mm
(61–55 Ω) in the open channel between `U700` and `U800`.** The escape stub is short compared with the
edge rate, and this puts the impedance where it matters over most of the length. R1 runs this bus at
≈ 64 Ω and works — 50 Ω is a target, not a requirement, and it is not the budget that binds here.

⚠ Worth knowing so the tension does not read as an error: **UG388's own "trace widths should be 3 to
5 mils" cannot produce 50 Ω on any four-layer outer layer.** Xilinx wrote it assuming internal-layer
stripline, which is also why p.41 says to route memory on internal layers — something this stack-up
cannot do. Micron's 50 Ω and Xilinx's 3–5 mil are already in conflict on a board like this, and the
width wins, because the BGA escape enforces it.

### 4.1.2 ⚠ Two things to settle before the fab order

> ⚠ **2026-09-11: both items are moot on the six-layer board.** The 2116-versus-7628 question belonged to
> the four-layer PDFs; the six-layer stack uses 3313. And KiCad's Physical Stackup now describes the
> six-layer board, apart from the two small differences listed in §4.1.1.

~~**2 oz outer copper is probably wrong for this board.**~~ **Closed 2026-09-03** — the owner took
PCBWay's 1 oz option. The reasoning stands for the record: 2 oz finished outer raises a fab's minimum
track/space to roughly 0.15–0.2 mm and worsens the etch factor, and this board routes DDR3 at
0.127 mm, `EPD` and `USB` at 0.11 mm, with a 0.125 mm pad gap on the BQ25792 (§4.2).

**Open, and worth one email: ask PCBWay for 2116 prepreg with 1 oz finished outer.** The two options
in front of the owner were 2116-with-2 oz and 7628-with-1 oz, and each is disqualified by its second
term. A 1.0 mm four-layer with 2116 prepreg *and* 1 oz outer is not exotic — 2116 is a stock
prepreg, and impedance-controlled orders are routinely built to a requested stack; the configurator's
list is what is pre-canned, not what the factory can build. The payoff is large: 59 Ω at the existing
0.127 mm width instead of 73 Ω, half the crosstalk coupling, and a tighter return path. Send both
PDF revisions and ask for the hybrid.

**KiCad's stackup still describes the old board.** Board Setup → Physical Stackup says 0.127 mm
prepreg, εr 4.2, 0.035 mm outer copper. Until it matches the PDF, every impedance and length-tuning
number KiCad reports is computed from the wrong dielectric.

### 4.2 ⚠ Why clearance is 0.11 mm and not 0.2 mm

§6.1 originally said to start at **0.2 mm clearance**. That was written before these footprints
existed and it is wrong. Measured on the placed board (different-net pad pairs, per footprint):

| Part | Tightest different-net pad gap |
| --- | --- |
| `U1` BQ25792 QFN-24 | **0.125 mm** |
| `U1101`/`U1102`/`U1400`/`U1401`, `U14`/`U15` | 0.150 mm |
| `U1300` YFQ0012 DSBGA-12 | 0.160 mm |
| `J501`/`J502` BTH-060 | 0.195 mm |
| `J1` USB-C | 0.200 mm |

KiCad checks class clearance **between pads inside one footprint**, so a 0.2 mm default would flag
eight packages on the day of import, with no fix available short of lowering it again. R1's 0.11 mm
clears every one of them — and is what a board this dense was always going to need.

The DRC *floor* (Board Setup → Constraints → minimum clearance) stays at R1's 0.1 mm.

### 4.3 ⚠ Why the DDR spacings are DRC rules and not net-class clearances

> ⚠ **Superseded 2026-09-10.** The rules and classes described below (`DDR_DIFF`, two pad-excluding rules)
> were replaced: `r2.kicad_dru` now carries region-tiered DDR3 rules keyed to the `U700`/`U800` courtyards,
> an explicit diff-pair gap rule and a working HV rule, with the derivation in the file's own comments;
> the net classes were rewritten the same day. **Owner, 2026-09-11: the new rules get in the way of
> interactive routing — open, to be revisited** (`NOTES-R2-osd62x-plan.md` §7). The escape geometry in the
> table below is still correct.

UG388 p.41 asks for two spacings on the memory bus: three times the trace width between DDR traces,
and 20 mil between the differential clocks/strobes and any other signal, serpentines included. Both
are **routing** numbers, and neither can be a net-class clearance — KiCad checks a class clearance
**pad-to-track** as well as track-to-track, and this bus escapes two BGAs:

| Part | Pitch / pad | Gap between adjacent pads | A 0.127 mm track needs |
| --- | --- | --- | --- |
| `U700` FTG256 | 1.0 / 0.4 mm | 0.60 mm | 2 × clearance + 0.127 |
| `U800` BGA-96 | 0.8 / 0.4 mm | 0.40 mm | 2 × clearance + 0.127 |

At 0.38 mm that is **0.887 mm** and nothing leaves either part; at the 0.1 mm class floor it is
0.327 mm and both escape. Setting 0.38 mm on the `DDR_DIFF` class is what stopped the FPGA fanout on
2026-09-03. The fix is the same one §4.1's `HV` row uses: leave the class at the floor and put the
spacing in `r2.kicad_dru` with `A.Type != 'Pad' && B.Type != 'Pad'`. Both rules are in that file.

**Two riders.**

- The strobe rule carries `B.NetClass != 'DDR_DIFF'`, without which it fires between `DRAM_CKP` and
  `DRAM_CKN` and forbids the 0.11 mm intra-pair gap that sets the differential impedance. The cost is
  that CK-to-DQS spacing is not machine-checked; they run to different parts of the bus, so it is a
  placement matter.
- **16 of the 18 violations these rules raise sit inside the FTG256 body**, at 0.343 mm — the
  geometric best available in the fanout. When that becomes noise, draw a rule area named
  `BGA_escape` over the escape and append `&& !A.insideArea('BGA_escape')` to both conditions. The
  two violations outside it — at ≈ (202.7, 76.2), in the channel between the two parts, one of them
  at 0.11 mm — are real and are worth fixing by hand.

**`DDR_DIFF`'s via is 0.6/0.3 and will not fit `U800`.** On an 0.8 mm pitch a via dropped between
four balls sits 0.566 mm from each ball centre, leaving 0.566 − 0.3 − 0.2 = **0.066 mm**, under the
0.1 mm floor. R1's 0.45/0.3 leaves 0.141 mm. It clears under the FTG256 (0.207 mm), but the DRAM is
the part that binds. Also: `DDR_DIFF` has **no diff-pair width or gap set**, so it inherits Default's
0.2/0.2 — ≈ 87 Ω, not 100. §4.1.1 has the geometry to enter.

## 5. Placement order

Superseded by **§6.3**, which has the same order plus the fixed points the panel's folded flex and
the SoM decision have since pinned down, and the instruction to lock each one as it goes.

## 6. Starting the board in KiCad — the order that avoids rework

> **Where this stands, 2026-08-21.** Steps 1, 2 and 5 are done: the board exists, the stackup
> matches R1 byte for byte, all 327 footprints are imported, and the SoM is placed and grouped.
> Steps 3 and 4 are now one script (below). Step 6 is **half done** — there is an `Edge.Cuts`
> rectangle, but it is **185.5 × 95 mm**, a holding pen for the imported heap rather than the
> ≈ 90 × 70 mm the sketch calls for. Drawing the real outline is the first thing left to do.

### 6.1 Set the board up **before** routing anything — now one command

1. ~~**Open the project** and click **PCB Editor.**~~ Done.
2. ~~**Board Setup → Physical Stackup**, 4 layers, R1's stack.~~ Done, and verified identical to
   R1's: `F.Cu` / 0.127 prepreg / `In1.Cu` / 0.6 core / `In2.Cu` / 0.127 prepreg / `B.Cu`,
   0.035 mm outer copper, ENIG, ≈ **1.0 mm** finished.
   **`In1.Cu` is the ground plane and `In2.Cu` the power plane** — §8's rules about "continuous
   reference" all mean `In1.Cu`.
3. **Constraints, track/via presets and all nine net classes**: **close KiCad**, then

   ```bash
   python3 tools/import_r1_settings.py            # dry run
   python3 tools/import_r1_settings.py --write
   ```

   It refuses to write while KiCad is open, because KiCad holds the whole project in memory and
   rewrites `r2.kicad_pro` on save — the edit would vanish without an error. §4.1 has the numbers
   and why each one is what it is.
4. **Reopen and confirm** in **Board Setup → Net Classes** that the assignment columns are
   populated, not empty, and that the toolbar's track-width dropdown now offers 0.1 → 2.0 mm.
   Then `python3 tools/check_pcb.py` — group 5 should read *8 of 8 expected classes present* with
   no dead patterns.

### 6.2 Import, then draw the outline

5. **Tools → Update PCB from Schematic** (**F8**). Everything arrives in a heap off to one side.
   That is normal.
6. **Draw the outline on `Edge.Cuts`** before placing. The sketch says ≈ **90 × 70 mm** (§1.2) —
   draw it as a rectangle to start; it can grow. Add the mounting holes the enclosure needs.
7. **Run `python3 tools/check_pcb.py`.** At this point it should report every part present and
   nothing extra. That is the cheapest moment to catch a footprint that did not come across.

### 6.3 Place in this order, and lock as you go

The first three are not free choices — they are fixed by the enclosure, and everything else
arranges around them. **Lock each one once placed** (select → `L`), so a later drag cannot nudge it.

| | What | Why it is fixed |
| --- | --- | --- |
| 1 | **`J1000`**, the panel connector | the folded flex lands there (§1.2); its *orientation* matters as much as its position |
| 2 | **`J1400`/`J1401`/`J1300`** — touch, pen, frontlight | same corner, same reason; all three tails emerge from the panel |
| 3 | **`J1`** USB-C, and `USB1` if fitted | case opening |
| 4 | **`X500` + `J501` + `J502`**, the SoM | top right, on the face **away from the panel** (§1.1). Place `X500` first, then the two receptacles against it, then run `tools/check_pcb_connectors.py` |
| 5 | **`U700` + `U800`**, FPGA and DRAM, together | the DDR3 group wants to be short; place them as a pair before anything competes for the space |
| 6 | **The four converters** on `power` | each with its input-capacitor loop closed before anything else is placed near it |
| 7 | **The HV chain** on `epd_power`, near `J1000` | with §7's two islands laid out deliberately |
| 8 | **`U400`**, its crystal, and the buttons | the crystal is placed *against* its constraint, not into the space that is left |
| 9 | Everything else | |

### 6.4 Route in this order

**Set the net class, then route — do not pick widths off the toolbar.** With §4.1 imported, KiCad
picks the width for you from the net's class; the dropdown should sit on *"use net class width"*.
The presets exist for the exceptions (a neck-down through a BGA field, a hand-widened rail), not for
everyday routing.

1. **DDR3** — `DDR3_CLK` first as a proper differential pair, then each byte lane. It has no margin
   at the FPGA (§8), and it is the group that dictates where everything else can go.
2. **`USB_DP`/`DM`** — 90 Ω differential, `J1` → `U202` → `J501`. Short is the whole point (§1.1).
3. **`DPI`** — 22 signals, `J501`/`J502` → FPGA bank 1, over continuous ground.
4. **The switching loops** — by hand, deliberately, per §7. Never autoroute these.
5. **`MMC1`**, then everything else.
6. **Pour `In1.Cu` (GND) last**, and check what it did under the HV islands (§7.1).

## 7. ⚠ The five things that destroy the board

Everything in the per-sheet docs matters. These five are the ones where the failure is *permanent*,
*silent in every file*, and *not caught by DRC*. Read them before placing anything.

### 7.1 `U1103` and `U1106` have a `GND` pin that is not ground

`epd-port.md` §11.1, and it is the single most dangerous item in this project.

| Part | Pin 2, labelled `GND` | Actually sits at |
| --- | --- | --- |
| `U1103` `LGS5145` | `-VGL` | **≈ −20 V** |
| `U1106` `LGS5145` | `-VN` | **≈ −15 V** |

Both are inverting buck-boosts, so the IC's ground reference *is* its negative output. Each needs
its **own local copper island**, with the plane **cut away beneath it** — not merely avoided on the
outer layer. Connect either to the ground plane and the part sees its full input across the wrong
terminals.

> **Silkscreen both islands.** This is the one thing on the board that a competent person will
> "fix". `tools/check_pcb.py` refuses a copper zone on `-VGL` or `-VN`, which catches the
> commonest version of the mistake but not a stray plane stitch.

### 7.2 The DDR3 bus has no margin *at the FPGA*

`fpga.md` §1.1 and §11.1. The `-2` part's MCB is rated **667 Mb/s**; this design runs **666.67**.
The DRAM's 1066 rating is irrelevant — you do not get to spend its headroom.

Match within a byte lane (`DQ[7:0]`+`LDM`+`LDQS`/`#`, then `DQ[15:8]`+`UDM`+`UDQS`/`#`); the two
lanes need not match each other. Address/command matched to the clock pair. **Keep the whole bus
over one continuous GROUND plane** — a split under it is the classic way to lose the margin.

⚠ **This sentence used to say `In1.Cu`, and that was wrong.** `In1.Cu` was the `+3V3` "Power Plane"
zone, so a top-side DDR trace referenced +3V3, against UG388 p.42's "a data group should be
referenced to a GROUND plane." The owner's 2026-09-03 move to sig / gnd / gnd / sig (§4.1.1) makes
both inner layers ground and settles it — but check the zone nets before believing any layer name
here, because R1 has the old arrangement and this document was written from it.

⚠ **`DRAM_ADDR13`/`ADDR14` must be excluded from the matched set.** They are inert at both ends and
look exactly like address lines to a net-class rule; matching them drags the real group around.

### 7.3 The crystal is the easiest thing here to break with copper

`mcu.md` §11.3. `Y400` is a 250–630 nA oscillator. `Y400`, `C405`, `C406` hard against pins 4/5, same
layer, **no vias in `OSC32_IN`/`OSC32_OUT`**, a ground guard ring around the whole circuit and solid
ground beneath. Nothing switching crosses or runs beside it on **any** layer — specifically not
`MCU_SWCLK`, the I²C pair, `FL_PWM1/2`, or anything from `power`. The symptom is an RTC that gains
or loses time, which is a miserable bug to chase.

### 7.4 Every switching converter: the input loop, before the inductor

`power.md` §11.1, which is the same sentence from four different TI datasheets. **The capacitor's
ground must land on the IC's own ground pin, not on a plane somewhere else.** The loop that carries
the chopped current has an area, that area is an inductance, and that inductance turns every edge
into a spike on the IC's own reference.

Two riders worth having in front of you:

- **`U12` `TPS61022`: the critical loop is the *output* loop**, not the input — FET → rectifier →
  output caps → back to the FET's ground (`power.md` §11.2 item 1).
- **`U13` `TPS63802` has *two* switching nodes**, `L200` and `L2`. Both are aggressors
  (`power.md` §11.3).

### 7.5 The 20 mΩ shunts need Kelvin connections

`epd-port.md` §11.5. At 20 mΩ, **1 mΩ of trace is a 5 % error**. Sense traces leave from the
**inside edges** of the shunt pads, symmetrically, as a tight pair, routed together and away from
the converters. A shunt sensed at the wrong end of its own pad measures the pad.

## 8. The review loop

**Starting a fresh session?** Paste `docs/session-prompt-layout.md` — it carries the ground rules,
where the board stands, and what is open, so the assistant does not re-derive any of it. Update its
status list when something changes.

**`python3 tools/check_pcb.py`** — run it after every session, not at the end. It exits non-zero on
a failure and it carries each rule's source, so a complaint tells you which doc to read. It checks:

1. every schematic part is on the board, and nothing extra;
2. `X500`/`J501`/`J502` hold PHYTEC's geometry (delegates to `check_pcb_connectors.py`);
3. **33 proximity rules** taken from the per-sheet guidelines — the decoupling and hot-loop
   distances, which are the ones that quietly drift during placement;
4. no copper zone on `-VGL`, `-VN`, `+DRAM_VREF` or `+3V3_VREF`;
5. the seven net classes of §4 exist;
6. DRC, via `kicad-cli`.

**What it cannot check, and therefore what a human review is for:** loop *area* rather than
component distance; whether the plane is actually continuous under the DDR3 group; what the pour did
beneath the HV islands; whether a "quiet" trace is genuinely quiet; length matching; and every
mechanical question. That list is short, and it is exactly §8 plus the per-sheet docs.

### 8.1 The per-sheet detail, indexed

`check_pcb.py` encodes the numbers. These carry the reasoning, and each was written with the
datasheet open:

| Sheet | Guidelines | The one thing that matters most |
| --- | --- | --- |
| `battery` | `battery.md` §11 | the grounds are not all the same net |
| `power` | `power.md` §11 | four converters, one shared rule; `TPS63802` has **two** switching nodes |
| `mcu` | `mcu.md` §11 | the 32.768 kHz crystal |
| `epd`, `epd_power`, `power_mon` | `epd-port.md` §11 | ⚠ **two ICs have a `GND` pin that is not ground** |
| `fpga_*` | `fpga.md` §11 | no margin at the controller; `M5` (`ZIO`) gets **no copper** |
| `som`, `dpi_in` | `som.md` §8, §10.4 | MMC1 within 12.7 mm; `DPI_R6`/`R206` carry no components |
| `frontlight` | `frontlight.md` §9 | it belongs next to `J1300`, not next to `U12` |
| `io_expansion` | `io-expansion.md` §7 | enclosure-fixed, and the load switches follow their connectors |

## 9. ⚠ If the PCB editor says 305 footprints are missing

**Diagnosed 2026-08-20, and it is not a project problem.** The first `Update PCB from Schematic`
produced 305 `Error: Cannot add … (footprint '…' not found)` — every one of them from a *stock*
KiCad library (`Resistor_SMD`, `Capacitor_SMD`, `Package_TO_SOT_SMD`, `Connector_USB` …), while
every `footprints:` and `r2:` footprint resolved. That split is the whole diagnosis: the two project
libraries are found by relative path, and the global table is broken.

**The cause.** `~/.config/kicad/10.0/fp-lib-table` holds a single entry:

```
(lib (name "KiCad") (type "Table")
     (uri "/tmp/.mount_kicadremp4722615889122143643/share/kicad/template/fp-lib-table"))
```

`/tmp/.mount_<random>` is where an **AppImage mounts itself while it runs** — a new name every launch,
gone the moment it exits. The owner does *not* run the AppImage now: KiCad lives as an extracted
AppDir at `~/Apps/kicad-10.0.4` (a symlink to `./AppDir`) and is launched through `AppRun`. So this
is a leftover, written once during an AppImage run before the extraction, and dead ever since. The
symbol table never broke because it was written with absolute paths — compare
`sym-lib-table`, which points straight at `/home/lum/Apps/kicad-10.0.4/share/kicad/symbols/…`.

This is also standing ask 3: the 305 `footprint_link_issues` in every ERC run since WP1 are this
same fault, dismissed as cosmetic because they had only ever been seen in the schematic.

**The fix is `tools/fix_kicad_paths.sh`.** It is idempotent, backs up everything it replaces with a
timestamp, verifies all 155 library paths exist *before* installing, and **refuses to run while
KiCad is open** — KiCad rewrites these files on exit and would silently undo it.

```bash
# close KiCad first
./tools/fix_kicad_paths.sh
```

It does three things: writes the stock library table with absolute paths taken from the running
install; sets `KICAD10_FOOTPRINT_DIR`, `KICAD10_3DMODEL_DIR` and `KICAD10_SYMBOL_DIR` in
`kicad_common.json` (they were literally `"vars": null`); and probes four representative footprints
plus the 3D model tree to prove the result.

Then in KiCad: reopen the project, `F8`, and `python3 tools/check_pcb.py` — presence should read
327 of 327.

**That is also why the 3D viewer is empty**, and it is the larger half of it: every stock footprint
carries `(model "${KICAD10_3DMODEL_DIR}/…")`, so with the variable unset there is no model to load
even for the parts that *did* place. The other half is that this project's own generated footprints
had no `(model …)` at all until now — §9.1.

⚠ **If footprints vanish again after a KiCad update, run the script again** and look at that file
first. Nothing in this project can cause it.

### 9.1 3D models — 322 of 327, and why the other five are honest

After `fix_kicad_paths.sh` set `KICAD10_3DMODEL_DIR`, **311 of 327 footprints resolved on their
own.** `tools/add_3d_models.py` deals with the rest and makes the project self-contained: every
model it uses ends up in `3dmodels/` referenced by `${KIPRJMOD}`, so the 3D view works on any
machine that clones the repo. Re-runnable, backs the board up, refuses to run while KiCad is open.

**Three different reasons a model was missing, needing three different answers.**

**1 — a real model exists, but the path was somebody else's machine.** `pcb_common` keeps its 66
STEP files *next to* the footprints rather than in a `.3dshapes` directory, which is why a search
for 3D directories finds nothing. Several are referenced absolutely: `J1300`'s pointed at
`/Users/wenting/Documents/projects/Enchanter/…`. Copied into `3dmodels/` and re-pointed — **these
are the real parts**:

| Ref | Model |
| --- | --- |
| `J1` | `HRO_TYPE-C-31-M-12.step` — the actual USB-C receptacle. In `pcb_common` its filename has a **double space**, which is the sort of thing that breaks quietly on another filesystem; renamed on the way in |
| `J1300` | `FPC-SMD_8P-P0.50_HC-FPC-05-09-8RLTAG.step` |
| `J500` | `HY-TF1007B.STEP` — the microSD socket |
| `J1000` | `FPC-SMD_50P-P0.50_FPC-05F-50PH20.step` — the panel connector |
| `X500`, `J501`, `J502` | PHYTEC's and Samtec's own downloads |

**2 — no model exists anywhere, so a dimensional stand-in.** `footprints:Xilinx_FTG256` is a
`pcb_common` custom footprint whose model lived on the Modos author's KiCad 6 install — hence
`${KICAD6_3DMODEL_DIR}`, a variable nothing defines any more — and KiCad's own library has no
`Xilinx_FTG256` either.

| Ref | Stand-in matches | Does not match |
| --- | --- | --- |
| **`U700`** Spartan-6 | `BGA-256_17.0x17.0mm_Layout16x16_P1.0mm` — **the FTG256's exact geometry** | generic BGA, no marking |
| `U1` charger | 4 × 4 mm, 24 pins, 0.5 mm | exposed pad 2.7 vs 2.6 mm |
| `U2` gauge | 2 × 2 mm, 8 pins, 0.5 mm | exposed pad 0.6 vs 0.8 mm |
| `U12` boost | 2 × 2 mm, 0.5 mm | 8 pins drawn where the part has 7 |
| `U1200`×3 `INA3221` | 4 × 4 mm, 16 pins, 0.65 mm | exposed pad 2.7 vs 2.1 mm |
| `SW400` | 4.2 × 3.2 mm, same actuator class | different maker — **check actuator height against the enclosure rather than trusting this** |
| `U13` buck-boost | 2 × 3 mm, 10 pins, 0.5 mm | VSON-HR has no exposed pad |

⚠ **A stand-in is for clearance and collision, not for identity.** The body outline and height are
right; pin detail, markings and often the exact pad field are not. Never read a stand-in as
confirmation that the correct part is fitted — that is the BOM's job.

**3 — nothing suitable exists, so nothing is faked.** Five remain, and each is reported by name
every time the tool runs:

| Ref | Why | Where a real one would come from |
| --- | --- | --- |
| `X900` | KiCad ships no `ASE-4Pin` model | Abracon |
| `L200` | no `NR-30xx` model anywhere | Taiyo Yuden publish STEP |
| `J2` | only 1.25 mm PicoBlade exists, a *different* connector — and this one sits at the board edge, where a wrong body would mislead the enclosure check | Molex publish STEP for 504050 |
| `U1300` | 1.9 mm DSBGA, nothing dimensionally close | cosmetic at this size |
| `J25` | bare copper solder pads | **correctly has none** |

**One thing worth knowing about KiCad here:** a footprint edited in the library does **not**
propagate to a board that already has it placed. `X500` kept the model-less copy it was imported with
long after the generator started emitting one. `add_3d_models.py` refreshes every `r2:` footprint's
model from its library file for exactly that reason — so if a model looks stale, run it again.

**To attach one yourself:** right-click the part → *Open in Footprint Editor* →
*Footprint Properties → 3D Models → Add*, then set offset / scale / rotation against the live
preview. Put the file in `3dmodels/` and write the path as `${KIPRJMOD}/3dmodels/<file>` so it is
not machine-specific. KiCad reads `.step`, `.stp` and `.wrl`.

⚠ **The `BTH-060` model's rotation is still a guess** — Samtec draw the connector along X and this
board stands it along Y, so `MODEL_CONN_ROT` is `(0, 0, 90)`. Check it in the viewer and flip to
−90 if it faces the wrong way. Nothing electrical depends on it.

### 9.2 ⚠ `kicad-cli pcb drc` will not tell you a custom rule is broken

`r2.kicad_dru` holds the HV track-separation rule (§4.1). If its syntax is wrong, **`kicad-cli pcb
drc` ignores the file and reports success** — no error, no warning, exit status 0, the rules simply
never applied. Verified 2026-08-21 by feeding it a deliberately unterminated rule: identical clean
output.

So a clean command-line DRC is *not* evidence the rules are live. The only check is the GUI:
**Board Setup → Custom Rules → Check rule syntax.** Do that once after any edit to the file.

The same caution as §9 applies in reverse — `tools/check_pcb.py` reports what `kicad-cli` says, and
`kicad-cli` cannot see this class of problem at all.

### 9.3 ⚠ If `kicad-cli` says &ldquo;Failed to load board&rdquo;

Found 2026-08-21, and it had been silently true from the first board: **`kicad-cli pcb` could not
open `r2.kicad_pcb` at all.** Every `pcb` subcommand — DRC, drill, gerber, render — refused it.

**The cause was ours.** `gen_som_footprint.py` wrote `(layer "User.Drawings")`. That is KiCad's
*display alias*; the canonical name in a board file is **`Dwgs.User`**. The footprint editor accepts
the alias — the library exports to SVG fine — but the board parser does not. On import, Pcbnew put
those three rectangles on a layer literally named **`"Rescue"`**, which is not in the board's layer
list, and from then on its own CLI would not read the file it had just written.

Fixed in the generator, and the placed copy was repaired in place. The lesson generalises:
**write canonical layer names in generated footprints**, and if the CLI ever refuses a board,
compare the layers a footprint uses against the board's `(layers …)` block.

⚠ **This also invalidated a number reported earlier.** `check_pcb.py` was loading
`/tmp/r2-drc.json` without checking that the run had succeeded, so it reported the *previous* run's
results — a board that would not open was described as having 4250 DRC violations. The script now
deletes the report first, checks the exit status, and says `DRC: DID NOT RUN` rather than inventing
a number. A check that reports stale data is worse than no check.

### 9.4 ⚠ Pcbnew's save writes the schematics back, and will undo an edit made under it

Hit on 2026-08-30. A schematic patch ran, was verified by ERC, and reverted minutes later with no
error anywhere. `epd.kicad_sch`, `mcu.kicad_sch` and `r2.kicad_sch` all carried the *same* mtime
afterwards — the signature of KiCad writing the whole project from memory.

**What happened:** the schematic editor was open with state loaded *before* the patch. Saving the
project wrote that stale state over the changed files. `epd.kicad_sch` survived only because KiCad
had been prompted to reload it; the two files patched later did not.

**The rule: close the schematic editor, or File → Revert, before editing a `.kicad_sch` outside
KiCad — and reload afterwards.** The failure is silent in both directions: the patch script reports
success, and KiCad reports nothing. The tell is an ERC violation you had already fixed coming back.

### 9.5 ⚠ Never substitute a designator by bare string — ball names look identical

`tools/renumber_by_page.py` converts every sheet to the owner's page-based designator scheme.
Its first two runs **corrupted the netlist**, both times the same way, and the failure is silent:
a blanket "replace the quoted string `C1`" also rewrites strings that are not designators at all.

Two families collide with the designator grammar:

| Family | Examples | Where they live |
|---|---|---|
| FPGA ball names (`XC6SLX16-FTG256`) | `C1 C2 C7 D1 D2 D4 D5 D7 F1 G7 J1 J2 L1 L6 N11 P3 R1 R2 R4 R7 T1` | `(pin "…")` on `U700`, and every `.ucf` ball |
| BTH-060 pin names | `A1`–`A60`, `B1`–`B60`, `C1`–`C60`, `D1`–`D60` | `J501`/`J502`, and the pin→net maps in `gen_som.py` / `gen_dpi_in.py` |

Run 1 rewrote ball names inside the schematics: 21 collisions, ERC unchanged at 14/32, but **40
named nets came back with a different pin multiset** — the board had been rewired without a
single error message. Run 2 rewrote the pin→net *maps in the generators*: `BOOTMODE_PINS =
{"D2": 16, "D4": 17}` became `{"D1101": 16, "D1103": 17}`, and `("9", "L1", …)` — pin 9 of the
LM3630A, whose **name** is `L1` — became `L200`.

Two rules, both now enforced by the tool:

1. **In a schematic or board, substitute only at the two positions that actually store an
   instance's designator** — `(property "Reference" "X"` and `(reference "X")`. Nothing else.
2. **In Python and Markdown, exclude any name that is also a pin name anywhere in the design.**
   The tool builds that set from every `(name "…")` in the sheets plus the four BTH columns, and
   prints what it held back. `check_pcb.py` is the one file that takes the unrestricted map, and
   only because it quotes no pad names — verify that assumption before relying on it.

**Only the three checkers get updated; the sheet writers do not.** `tools/` splits cleanly into
three scripts that *read* the design (`check_pcb.py`, `check_pcb_connectors.py`, `check_ucf.py`)
and forty-odd `gen_*`/`patch_*`/`port_r1.py` that *wrote* a sheet once and have not been re-runnable
since it was hand-edited in Eeschema. The checkers must track the current names. The writers are a
historical record: rewriting them would claim `gen_power.py` emitted `R1216` when it emitted `R207`,
and `port_r1.py` is worse still — its dict **keys are R1 designators** (`{"R7": "R207"}`) that were
never renumbered, and half its values are computed (`f"C{n + 200}"`), so a literal substitution
corrupts the keys and only half-updates the values. Leave them at the names they actually produced.

**A rename map recovered by diffing needs an invariant.** Reconstructing old→new by matching symbol
UUIDs between `git show HEAD:<sheet>` and the working tree produced 297 pairs, five of which were
false — `R207 -> R1216`, `R311 -> R700` and three more, each pointing at a real but *different* part
on another sheet. They are caught by one cheap assertion: **a genuine rename's old name must no
longer exist anywhere in the design.** `R207` was still on `battery`, so the pair is bogus. Assert
that, and assert every target does exist, before letting a recovered map touch a file.

**How to prove a renumber was clean.** ERC counts are not sufficient — run 1 left them identical.
Compare the *netlist* before and after:

```
nets: 519 -> 519
named nets present in both whose pin multiset changed: 0 []
total pin connections: 1563 -> 1563
```

Then run `tools/check_ucf.py`, which resolves 113 gateware constraints to board nets **by ball
name** and is therefore the sharpest detector of exactly this corruption: 99 matched / 0 failures
means the FPGA's ball→net map survived. And do not use `git stash` to obtain the "before" state —
see [`NOTES-R2-plan.md`] and the DRC-baseline note; the working tree carries the owner's
uncommitted layout work. Read the old file with `git show HEAD:<path>` instead.

## 10. Open

1. ~~**Board outline, SoM position, cell size**~~ — **all answered.** Panel and cell have
   dimensions; the SoM is top-right beside the USB ports, on the face pointing **away from the
   panel** (owner, 2026-08-20). §1.1. **Nothing blocks placement any more.**
2. ~~**The `PCM-071` footprint**~~ — **built and then rebuilt on PHYTEC's DXF, 2026-08-20**, §3.2
   and `som.md` §11. The `footprints:` → `r2:` rename is done. ⚠ **What replaced it as an open
   item is the connector BOM line** — 2 × `C3646540` per board, 60 in stock, `som.md` §10.
3. ~~**The `TPS63802` footprint**~~ — **stale, it exists**: `r2:Texas_DLA0010A_VSON-HR-10_2x3mm_P0.5mm`,
   §3.1. A full audit on 2026-08-20 resolved every `Footprint` property in all 14 sheets against
   `r2.pretty` (4 footprints) and `pcb_common/footprints.pretty` (139), plus 37 KiCad stock
   libraries. **`PCM-071` was the only gap, and it is closed.**
4. **`EPD_THROT` still occupies `U41.M16`** and nothing drives it (`fpga.md` §2.1).
   `NOTES-R2-plan.md` says decide before Stage D: reclaim the ball or keep it reserved.
5. ~~**WP6 is not drawn.**~~ **Both sheets are drawn as of 2026-08-17.** ~~`FL_INT#` now has a pin —
   `PB12`, `mcu.md` §3.4~~ **`FL_INT#` was deleted 2026-08-23 — `frontlight.md` §9.1** — leaving only the DNP touch/pen connectors, whose pad order is a vendor
   question (`io-expansion.md` §5).
6. **A PDS impedance simulation** for the FPGA rails is still the honest answer to `fpga.md` §11.5,
   and is a Stage-D item rather than a defect.
7. **⚠ New, and it is a placement constraint rather than a footprint one: the DDR3 bus has no
   margin at the FPGA.** `fpga.md` §1.1 — the `-2` part's MCB is rated 667 Mb/s against the
   666.67 Mb/s this design runs. §11.1's "666 MT/s is a lot of margin" is true of the DRAM only.
8. ~~**D-7, the separate panel-connector PCB**~~ — **CLOSED 2026-08-20: there is no second board.**
   The sketch's "TTL Interface" block is where the panel's flex lands after folding under the
   display. `J1000` gains a fixed position and, more importantly, a fixed **orientation**; `J1400`/`J1401`
   are the same. §1.2.
9. **`J1300`, the frontlight tail, is drawn but its current is undefined** — the display docs do not
   specify the frontlight, so the per-string current is a bench measurement (`frontlight.md` §6.2,
   D-8). Not a layout blocker; the connector and the `LM3630A` are placed either way.
