UavL/Glider/pcb/r2-mainboard/docs/power.md

# `power.kicad_sch` — rail tree — R2 work package 2

> ⚠ **2026-09-11 — the SoM is being replaced** by Octavo's `OSD62x-PM` (`NOTES-R2-osd62x-plan.md`). Three
> parts of this document describe the `PCM-071` and are rewritten in the plan's Phase 2: **§1** (the SoM
> on `+5V_DCDC`; a `TPS65219` PMIC joins the tree), **§5.1** (the PHYTEC-driven rail order is replaced, not
> edited — the PMIC sequences the SoC itself) and **§8.1** (`+5V_DCDC` loses the SoM's 1.0 A).
> The refdes in this file predate the page scheme: `U10`/`U12`/`U13`/`U14`/`U15` are now
> `U300`/`U301`/`U302`/`U303`/`U304`.

Status: **reviewed once; review-1 fixes applied.** Last updated 2026-08-11.

**§10 answers the points raised in `../manual-analysis/Analysis_power.md` and lists what changed in
the schematic as a result. Read that section first if you are coming from those notes.** One of them
found a real error: the `TPS61022` *does* have true output disconnect in shutdown, so the
`TPS22965` load switch that §2.2 existed to justify has been deleted. Everything here cites either a
datasheet in `../datasheets/` (with the page or table), the LCSC catalogue, or a file in this repo.
Estimates are marked **(est.)** and are the things a bench measurement has to replace.

The sheet has been hand-edited and saved in Eeschema, so **`power.kicad_sch` — not
`tools/gen_power.py` — is the source of truth.** Review-1 was applied with
`tools/patch_power_review1.py`, which patches the file in place and refuses to run twice.

This is the sheet R2 exists for. R1's `pcb/mainboard/power.kicad_sch` wires every buck's `~SHDN`
pin to `+5V`, so 82 % of idle power sits on rails no firmware can switch off (`NOTES-STATUS.md`).
Here **every rail below `+3V3_AON` has a named enable net, a named owner, and a pull-down that makes
"off" the state the board powers up in.**

---

## 1. Rail tree

```
+VSYS  (charger power-path output, battery.kicad_sch; 3.0-4.4 V)
  |
  +-- U10  TPS7A0233   LDO        -> +3V3_AON_DCDC   always on          ~25 nA Iq
  +-- U12  TPS61022    boost      -> +5V_DCDC        MCU_EN_5V
  +-- U13  TPS63802    buck-boost -> +3V3_DCDC       MCU_EN_3V3
  +-- U14  TPS62A02    buck       -> +1V2_DCDC       MCU_EN_FPGA_CORE
  +-- U15  TPS62A02    buck       -> +1V5_DCDC      MCU_EN_DDR
```

`U11` is deliberately absent: it was a `TPS22965` load switch in front of the boost, deleted in
review 1 (§2.2, §10.7). Its reference is not reused, so that the git history and the review notes
stay legible.

`*_DCDC` is R1's naming convention: the converter output goes to a shunt on `power_mon`, and the
load-side net that comes back out of that shunt is the plain rail name. So this sheet ends at
`+3V3_AON_DCDC` / `+5V_DCDC` / `+3V3_DCDC` / `+1V2_DCDC` / `+1V5_DCDC`, and `power_mon` produces
`+3V3_AON`, `+5V`, `+3V3`, `+1V2_FPGA`, `+1V5`. Keeping the convention makes WP4's port of
`power_mon` from R1 a straight copy.

| Rail | Topology | Part | LCSC | Stock | Enable | Loads |
| --- | --- | --- | --- | --- | --- | --- |
| `+3V3_AON_DCDC` | LDO 200 mA | `TPS7A0233DBVR` | `C5142805` | 433 | none (EN tied to IN) | STM32G0, I²C pull-ups, buttons, charger/gauge I²C |
| `+5V_DCDC` | boost 5.0 V | `TPS61022RWUR` | `C915088` | 39457 | `MCU_EN_5V` | SoM `VIN`, EPD HV chain |
| `+3V3_DCDC` | buck-boost 2 A | `TPS63802DLAR` | `C2845237` | 1338 | `MCU_EN_3V3` | FPGA `VCCO`/`VCCAUX`, config NOR, panel logic |
| `+1V2_DCDC` | buck 2 A | `TPS62A02DRLR` | `C5350187` | 3202 | `MCU_EN_FPGA_CORE` | Spartan-6 `VCCINT` |
| `+1V5_DCDC` | buck 2 A | `TPS62A02DRLR` | `C5350187` | 3202 | `MCU_EN_DDR` | DDR3L, FPGA DDR bank `VCCO` |

Four rails, four identical control patterns: one `MCU_EN_*` net, one 100 kΩ pull-down, one
enable pin. That uniformity is a review-1 result — before it, the 5 V rail was the odd one out.

Not on this sheet: the frontlight boost (`frontlight.kicad_sch`, WP6 — an LED driver runs from
`+VSYS` directly, one conversion instead of two), the EPD HV chain (`epd_power.kicad_sch`, WP4,
from `+5V`), and `+3V3_TOUCH` / `+3V3_PEN` (`io_expansion.kicad_sch`, WP6).

## 2. Two findings that changed the plan — and one that was wrong

### 2.1 A 1S cell cannot buck to 3.3 V — `+3V3` needs a buck-boost

`NOTES-R2-plan.md` says "run the bucks from the cell, not from a 5 V intermediate", and for 1.2 V
and 1.5 V that is exactly right. It does not work for 3.3 V: `+VSYS` runs from about 4.4 V down to
3.0 V, so a step-down converter drops out somewhere around half the discharge curve and the FPGA's
I/O rail sags with the battery.

Three ways out, and why the third wins:

| | Efficiency | Cost |
| --- | --- | --- |
| Buck from `+5V_DCDC` | ~92 % boost × ~92 % buck = **~85 %** | ties `+3V3` to the 5 V rail — R1's mistake in a new place |
| LDO from `+5V_DCDC` | 3.3/5.0 = **66 %** | worse |
| **Buck-boost from `+VSYS`** | **~93 %** across the whole cell range | one extra part type |

`TPS63802` also brings **true shutdown with load disconnect** (datasheet §1): when disabled it
isolates the output instead of leaking through a body diode. That matters for standby — see §8.

### 2.2 The boost needs no load switch — **corrected in review 1**

This section previously argued that "a boost passes its input through when disabled", that
`TPS61022`'s high-side body diode would leave ~3.4 V on the SoM's `VIN`, and that a `TPS22965`
(`U11`) was therefore needed on the boost's input. **That was wrong, and `U11` has been deleted.**

`tps61022.pdf` says the opposite three times:

- **p.1 Features:** "**True disconnection between input and output during shutdown**."
- **p.1 Description:** "During shutdown, the load is completely disconnected from the input power."
- **§7.3.2:** "When the voltage at the `EN` pin is below 0.4 V, the internal enable comparator turns
  the device into shutdown mode. In the shutdown mode, the device is entirely turned off. **The
  output is disconnected from input power supply.**"

And §6.5 quantifies it in the direction that matters most: `IVOUT_LKG`, "Leakage current into `VOUT`
pin", is **1 µA typ / 3 µA max** measured at "IC disabled, `VIN` = 0 V, `VSW` = 0 V, `VOUT` = 5.5 V".
Forcing 5.5 V onto a dead `VOUT` and seeing 1 µA proves the isolation blocks `VOUT → VIN` as well as
`VIN → VOUT`; a body-diode path in either direction would show milliamps.

The physics is consistent with the claim. §7.3.5 and Table 5-1 name the high-side device a **PMOS**;
in a synchronous boost built for true shutdown its source sits on `SW`, so its body diode faces
`VOUT → SW` and blocks the `VIN → L → SW → VOUT` path. The price is that the part cannot rectify
through a diode, only through the channel — which is why it is synchronous-only. §7.3.5, the section
the old text cited, describes pass-through while the device is **enabled** and `VIN` exceeds the
setpoint. It says nothing about the disabled state; citing it for the disabled state was the mistake.

So `MCU_EN_5V` now drives `U12.EN` directly, with `R300` 100 kΩ as its pull-down, and the boost runs
from `+VSYS` directly. `VSYS_SW` no longer exists. What the deletion cost and did not cost:

| | |
| --- | --- |
| saved | one 6 A load switch, `C23` (`CT`), `C24` (`VBIAS`) |
| saved, reading state | `VBIAS` quiescent 30–50 µA ‡ (`tps22965.pdf` §7.5/§7.6) ≈ 0.15 mW |
| saved, at load | `RON` 16 mΩ ‡ × (2.3 A **(est.)** input) ² ≈ **85 mW** and 37 mV of drop |
| lost | the switch's quick-output-discharge, a 225 Ω pull-down on its output ‡ §9.3.2 |
| lost | `CT`-programmed 800 µs inrush ramp — see §3.4 for what replaces it |
| not lost | shutdown leakage: `U11` was ≤ 2 µA ‡, `U12` alone is 0.25 µA typ / 3.5 µA max ‡ §6.5 |

The one thing worth watching on a bench: with nothing pulling `+5V_DCDC` down, the rail decays
through the SoM's and the EPD chain's input leakage rather than being discharged. `C304`+`C305` are
44 µF nominal, so the decay is fast if that leakage is tens of µA and slow if it is nanoamps.
**Needs a hardware test.** If it turns out slow enough to matter, the fix is one resistor to `GND`,
not a load switch.

## 3. Arithmetic

### 3.1 Feedback dividers

`VOUT = VFB × (1 + R_top / R_bot)`.

| Rail | VFB | R_top | R_bot | Result | Source |
| --- | --- | --- | --- | --- | --- |
| `+5V_DCDC` | 0.600 V | `R301` 732 k | `R302` 100 k | 0.600 × (1 + 7.32) = **4.992 V** | `tps61022.pdf` §6.5, §8.2.2.1 |
| `+3V3_DCDC` | 0.500 V | `R304` 511 k | `R305` 91 k | 0.500 × (1 + 5.615) = **3.308 V** | `tps63802.pdf` Table 10-5 — TI's own row for 3.3 V |
| `+1V2_DCDC` | 0.600 V | `R309` 100 k | `R310` 100 k | 0.600 × 2 = **1.200 V** | `tps62a01.pdf` §8.2.2.1 |
| `+1V5_DCDC` | 0.600 V | `R313` 150 k | `R314` 100 k | 0.600 × (1 + 1.50) = **1.500 V** | as above |

All E96, all 1 %, all stocked at LCSC in 0402 (checked 2026-08-06).

Margin checks. SoM `VIN` is 4.5–5.5 V; 4.992 V ±2.5 % reference tolerance gives 4.87–5.12 V, inside
with room for load regulation.

**The DDR bank is 1.5 V, not 1.35 V — changed in WP5, 2026-08-12.** The binding number is
not the DRAM's but the FPGA's: `ds162.pdf` Table 7 specifies `SSTL15_II` over VCCO **1.425–1.575 V**
(VREF 0.69–0.81 V), and Caster's UCF constrains all 48 DDR pins to that standard. The previous
1.344 V sat 81 mV below the minimum, and Spartan-6 has no 1.35 V I/O standard to relabel to. At
1.500 V the two windows coincide exactly — DDR3 1.5 V ±0.075 V is also 1.425–1.575 V — which is no
accident, since `SSTL15` exists to drive DDR3. `mt41k64m16.pdf` p.1 makes it legal on the memory
side: "Backward compatible to VDD = VDDQ = 1.5V ±0.075V", so `MT41K64M16TW` stays the fitted part
and simply runs in its 1.5 V compatible mode. **One consequence to carry into WP5:** that same page
says "Refer to the DDR3 (1.5V) SDRAM data sheet specifications when running in 1.5V compatible
mode", so the AC/DC tables in `mt41k64m16.pdf` no longer apply and Micron's DDR3 datasheet is
needed for `fpga_ddr`'s timing and termination work.

`R_bot` is held at or below 100 kΩ everywhere, which is what all three datasheets ask for
(noise sensitivity, and keeping divider current at least 100× the FB leakage). Worst case is
`+3V3_DCDC`: 0.5 V / 91 k = 5.5 µA against 100 nA max FB leakage — 55×, so the 91 k value is TI's
own trade and is kept rather than raised.

### 3.2 Inductors

Ratings re-read off the LCSC catalogue 2026-08-11, because the schematic's `Value` fields said
"/6A" and no inductor here is rated for that (§10.11):

| Ref | Rail | Value | Part | LCSC | Size | Isat | Irms | Rdc |
| --- | --- | --- | --- | --- | --- | --- | --- | --- |
| `L300` | `+5V_DCDC` | 1 µH | `DFE322512F-1R0M` | `C3224227` | 1210 | 4.8 A | 3.8 A | 32 mΩ |
| `L301` | `+3V3_DCDC` | 0.47 µH | `DFE252012F-R47M` | `C703140` | 1008 | 7.4 A | 4.9 A | 23 mΩ |
| `L302` | `+1V2_DCDC` | 1 µH | `DFE322512F-1R0M` | `C3224227` | 1210 | 4.8 A | 3.8 A | 32 mΩ |
| `L303` | `+1V5_DCDC` | 1 µH | `DFE322512F-1R0M` | `C3224227` | 1210 | 4.8 A | 3.8 A | 32 mΩ |

Values: 1 µH for the boost (`tps61022.pdf` Fig. 8-1), 0.47 µH for the buck-boost
(`tps63802.pdf` Table 10-1), 1 µH for both bucks (`tps62a01.pdf` Table 8-3, row `1.2 ≤ VOUT < 1.8`).

Boost peak current, worst case (`tps61022.pdf` eq. 1–3), at `VIN` = 3.0 V, `VOUT` = 5.0 V,
`IOUT` = 1.5 A **(est.)**, η = 0.9:

```
I_L,dc = 5.0 × 1.5 / (3.0 × 0.9)          = 2.78 A   -> vs Irms 3.8 A, 37 % margin
D      = (5.0 − 3.0) / 5.0                = 0.40
ΔI_L   = 3.0 × 0.40 / (1 µH × 1 MHz)      = 1.20 A p-p
I_L,pk = 2.78 + 0.60                      = 3.38 A   -> vs Isat 4.8 A, 42 % margin
```

**Correction to the previous text, which claimed `DFE322512F` is rated "above `TPS61022`'s 6.5 A
minimum valley current limit". It is not: Isat is 4.8 A.** Under an output overload the inductor
therefore soft-saturates before the IC's own limit acts. That is tolerable rather than wrong,
because `DFE322512F` is a metal-composite part: Murata's Isat is the −30 % inductance point and the
roll-off is gradual, so the consequence is more ripple and an earlier valley-limit trip, not the
thermal runaway a ferrite would give. In normal operation the peak is 42 % below Isat. **If the
SoM's `VIN` current comes back from PHYTEC materially above 1.5 A, re-run this block** — at
`IOUT` = 2.0 A the peak is 4.31 A and the margin is gone.

The two bucks are nowhere near their inductors' limits. R1 measured `FPGA CORE` at 165.6 mW active
(`NOTES-STATUS.md`) — about 138 mA at 1.2 V — and `FPGA DDR` at 101.5 mW, about 75 mA at 1.35 V. At
`fSW` = 2.4 MHz ‡ and 1 µH, ΔI_L is 0.36 A p-p and the peak is ~0.32 A, a fifteenth of Isat. The
1210 part is kept anyway because it covers `TPS62A02`'s own 2.7–3.4 A high-side current limit ‡
§6.5, i.e. an output short cannot saturate it, and because three of the four inductors are then one
line item.

### 3.3 Capacitors — all from the datasheets' own tables

| Ref | Value | Where | Source |
| --- | --- | --- | --- |
| `C300`, `C301` | 1 µF/16 V | `U10` in, out | `tps7a02.pdf` §6.3 Recommended Operating Conditions: `CIN` 1 µF nom, `COUT` 1 µF nom (1 µF min, 22 µF max, ≥ 0.5 µF effective for stability) |
| `C302` | 22 µF/10 V | `+VSYS` bulk | not a datasheet requirement; bulk at the rail entry, and the boost draws ~2.8 A pulses at 1 MHz off this plane |
| `C303` | 22 µF/10 V | `U12` in | `tps61022.pdf` §8.2.2.5 — "a 10-µF input capacitor is sufficient for most applications, larger values may be used"; Fig. 8-1 draws 10 µF |
| `C304`, `C305` | 22 µF/10 V | `U12` out | §8.2.2.3 asks for 10–50 µF **effective**; 2 × 22 µF derates into that band at 5 V |
| `C306` | 100 pF/50 V **DNP** | `U12` feedforward | §8.2.2.4: `C202` = 1/(2π·fFFZ·R1) = 1/(2π · 2 kHz · 732 k) = 109 pF, and the 2 kHz zero is only wanted above 40 µF effective — see §10.9 |
| `C307` | 10 µF/10 V | `U13` in | `tps63802.pdf` §10.2.2.4 |
| `C308` | 22 µF/10 V | `U13` out | §10.2.2.3, single 22 µF for VOUT ≤ 3.6 V |
| `C309`, `C311` | 4.7 µF/10 V | `U14`, `U15` in | `tps62a01.pdf` §8.2.2.3 and Table 8-2 |
| `C310`, `C312` | 22 µF/10 V | `U14`, `U15` out | Table 8-3, the `++` recommended combination; 10 V per Table 8-2 (§10.12) |

`C23` and `C24` were `U11`'s `CT` and `VBIAS` parts and are deleted with it (§2.2). The reference
numbers are not reused.

### 3.4 Inrush — now the boost's own, not a load switch's

With `U11` deleted (§2.2) the 800 µs `CT` ramp is gone and `TPS61022`'s own start-up sequence is what
limits the current the cell sees. `tps61022.pdf` §7.3.2 and §6.5:

1. Below `VOUT` = 0.4 V, the pre-charge current is `ILIM_CHG` = **400 mA min / 700 mA typ**.
2. Above 0.4 V and until `VOUT` reaches `VIN`, it charges with "output current capability to drive a
   1 Ω resistance load", bounded by `ILIM_CHG_max` = **2.0 A min / 2.4 A typ**.
3. Only then does it start switching. Typical `tSS` is 700 µs to regulation with 30 µF effective and
   no load.

So the worst case the cell must supply on a 5 V enable is ~2.4 A for a few hundred µs, against
~115 mA over 800 µs before. At a 5000 mAh cell's ~50–100 mΩ ESR that is a **120–240 mV dip on
`+VSYS`**, plus whatever the charger's `SYS` impedance adds. Everything on the board tolerates it:
`+3V3_AON`'s LDO has 270 mV dropout at 200 mA ‡ and `+VSYS` sits at 3.0 V worst case with 3.3 V
wanted — so a dip while the cell is nearly flat is the one case to watch — and the other three
converters have their own UVLOs well below (`TPS63802` 1.25 V ‡, `TPS62A02` 2.3 V ‡).

`C302` + `C303` = 44 µF nominal on `+VSYS` at the boost input is what holds that dip down, which is why
`C302` is kept even though it no longer belongs to a load switch. **Needs a hardware test:** enable
the 5 V rail with the cell at 3.3 V and scope `+VSYS`. If the dip is a problem the answer is more
input bulk, or firmware enabling the rail before the panel rails rather than after.

## 4. Control and status

| Net | Direction | Drives | Default with the MCU unpowered | Guaranteed-on / guaranteed-off |
| --- | --- | --- | --- | --- |
| `MCU_EN_5V` | in | `U12.EN` | **low** — `R300` 100 k pull-down | ≥ 1.2 V / ≤ 0.35 V ‡ `tps61022.pdf` §6.5 |
| `MCU_EN_3V3` | in | `U13.EN` | **low** — `R306` 100 k pull-down | ≥ 1.2 V / ≤ 0.4 V ‡ `tps63802.pdf` §8.5 |
| `MCU_EN_FPGA_CORE` | in | `U14.EN` | **low** — `R311` 100 k pull-down | ≥ 1.2 V / ≤ 0.4 V ‡ `tps62a01.pdf` §6.5 |
| `MCU_EN_DDR` | in | `U15.EN` | **low** — `R315` 100 k pull-down | as above |
| `PG_3V3` | out | `U13.PG` | open-drain, `R308` 470 k to `+3V3_AON` | |
| `PG_1V2` | out | `U14.PG` | open-drain, `R312` 470 k to `+3V3_AON` | |
| `PG_1V5` | out | `U15.PG` | open-drain, `R316` 470 k to `+3V3_AON` | |

Every one of those four `EN` pins carries an explicit "do not leave floating" instruction in its
datasheet, and a pull-down satisfies it in the safe direction. The rails come up **only** because
firmware asked. There is no series resistor in any enable path, so an `MCU_EN_*` pin driven high sits
at the full `+3V3_AON` — 3.3 V against a 1.2 V threshold and a 6.5 V absolute maximum ‡. Held low, the
pull-down has to sink only the pin's own leakage: 100 nA max ‡ × 100 kΩ = **10 mV**, and 0.2 µA ‡ ×
100 kΩ = 20 mV on the `TPS63802`, both far under the 0.35–0.4 V guaranteed-off level. See §10.1.

Three details worth stating:

- **Pull-ups are 470 kΩ, not the 100 kΩ TI draws.** A power-good pin is low whenever its rail is off,
  which in standby is all of them. TI's own figures use 100 kΩ (`tps63802.pdf` Fig. 10-1 `R202`,
  `tps62a01.pdf` Fig. 8-2 `R203` at 499 kΩ), which here would burn 3 × 33 µA = 0.33 mW — about 3 % of
  the ~10 mW standby target, for nothing. At 470 k it is 3 × 7 µA = 0.07 mW. The honest size of the
  win is 0.26 mW; the reason to take it is that it costs no margin at either end. See §10.6 for the
  `VOL` and rise-time arithmetic.
- **They pull up to `+3V3_AON`**, the one rail that is always present, so the MCU can read them
  before it enables anything. Both parts allow a pull-up rail different from their own `VIN`
  (`tps62a01.pdf` §7.4.2: "a pullup resistor to any voltage up to the recommended input voltage
  level"; `tps63802.pdf` §9.3.10: "any voltage rail less than 5.5 V"). §10.4 works through the one
  caveat that comes with that — `VIN` must be present for `PG` to read low — and why it is satisfied
  here.
- **There is no `PG_5V`.** `TPS61022` has no power-good pin — it is a 7-pin part with no room for
  one. The 5 V rail's health is read from its `INA3221` bus-voltage channel on `power_mon` instead,
  which is a measurement the board already has to make.

**`MODE` pins are tied low through a 0 Ω link** (`R303` on `U12`, `R307` on `U13`), selecting automatic
power-save mode on both. This is a hardwired pin, which is the thing R1 got wrong — the difference
is that it is hardwired to the *low-power* state, and no operating mode of this board wants forced
PWM on a rail that spends its life at light load. The 0 Ω link rather than a direct tie leaves a
place to lift it if a bench measurement ever disagrees.

## 5. Sequencing

Enable order is firmware's, and it is not interlocked in hardware — no supervisor, no
enable-chaining. The MCU asserts, waits for `PG`, then asserts the next.

Xilinx recommends `VCCINT → VCCAUX → VCCO` for Spartan-6, which for this board means
`MCU_EN_FPGA_CORE`, then `MCU_EN_3V3` (which carries both `VCCAUX` and `VCCO`), then
`MCU_EN_DDR`.

~~**Whether Spartan-6 actually requires that order or merely prefers it is not verified here.**~~
**Closed in WP5, 2026-08-12: the order is advisory, not required.** `ds162.pdf` is now in
`../datasheets/`, and note 2 under Table 6 says it in one sentence: *"Spartan-6 devices do not have
a required power-on sequence."* So no interlock is needed and firmware's ordering is a preference —
R1 bringing all rails up together was not getting away with something.

**But DS162 replaces that question with a stricter one nobody has checked: Table 6 requires each
supply to ramp within 0.20–50.0 ms.** It applies to `VCCINT`, `VCCAUX` and `VCCO2` alike (`VCCINTR`,
`VCCAUXR`, `VCCO2` — all "0.20 to 50.0 ms"). A rail that ramps *too slowly* is a violation, not just
an inelegance, and nothing in this document has yet been checked against it: the soft-start times of
`U13` (`TPS63802`), `U14`/`U15` (`TPS62A02`) and the `+3V3` buck-boost all need comparing against
that 50 ms ceiling, including the worst case of a nearly-flat cell. **New open item in §9.**

Two smaller requirements from the same table, both already satisfied: `VCCO2` must be ≥ 1.65 V for
power-on reset and configuration (bank 2 is on `+3V3`, so fine), and `VCCO2` is explicitly *not*
required for data retention.

`+3V3_AON` needs no sequencing: it is up whenever `+VSYS` is, which is whenever a cell or USB is
present.

### 5.1 ⚠ SoM rail order — `+5V_SOM`, then `+3V3`, and reset held across both

**Revised 2026-08-15, and the earlier version of this section was wrong in the dangerous
direction.** It concluded "`MCU_EN_3V3` and `PG_3V3` before `MCU_EN_5V`". That is backwards, and it
violates a requirement `L-1038e.A5` §5.4 states as **mandatory**:

> "It is **mandatory to avoid driving the I/O pins of the phyCORE-AM62x SOM when the SOM is not
> fully powered up.** Prematurely driving the pins may cause current to flow through the I/O pins
> before the processor is properly powered, potentially resulting in damage or unknown behavior
> after power-up or reset. Therefore, the peripheral carrier board power should be switched
> on/enabled by the `X_PGOOD` signal … This should be used to sequence the baseboard power supplies
> (3.3V, 1.8V, etc.)."

`+3V3` is `VCCO` for FPGA banks 0/1/2, and bank 1 is the twenty-two DPI lines that face the SoM. So
bringing `+3V3` up first is exactly the case PHYTEC says can damage the module. The old text
reached the opposite conclusion because it optimised for one constraint (below) without checking
whether the SoM had a rule of its own. **It did, in the same manual, three sections earlier.**

**The other constraint is still real.** Two of the eighteen DPI signals — `DPI_R7` and `DPI_R6` —
land on the module's `BOOTMODE_9`/`BOOTMODE_8`, part of the **primary boot mode selection**
(`L-1038e.A5` Table 31 states the mapping outright: `VOUT0_DATA16` → `X1 D2` →
`X_GPMC0_AD8/BOOTMODE_8`, `VOUT0_DATA17` → `X1 D4` → `X_GPMC0_AD9/BOOTMODE_9`, both 100 kΩ pullup
on the SOM). An FPGA whose `VCCO` is off does not present a high impedance — its input ESD
structure clamps toward the unpowered rail, and a forward-biased clamp diode beats a 100 kΩ
pull-up. If `+3V3` is down when the SoM **samples** boot mode, `BOOTMODE_9` latches 0 instead of 1.

**Both are satisfiable, because "the SoM is powered" and "the SoM samples boot mode" are two
different instants** — separated by cold reset, which we already control. `X_nRESET_IN` (`X1 C52`,
10 kΩ pullup + 100 nF on the SOM, Table 13) is the cold system reset input, and `mcu.md` §4 has
declared `SOM_RESET#` as an open-drain GPIO on `PA15` since WP3. Hold it low across the 5 V ramp:

| # | Step | Which rule it serves |
| --- | --- | --- |
| 1 | `SOM_RESET#` asserted low (open-drain, so it sinks; no injection into an unpowered pin) | — |
| 2 | `MCU_EN_5V` high → `+5V_SOM`. SoM PMIC sequences. `+3V3` still **off**, so every FPGA pin facing the SoM is unpowered and drives nothing | **PHYTEC §5.4** |
| 3 | Wait for `X_PGOOD` (`X500` C54, open-drain, 100 kΩ pullup on the SOM) | **PHYTEC §5.4** |
| 4 | `MCU_EN_3V3` high, wait `PG_3V3` → FPGA `VCCO` up | — |
| 5 | Release `SOM_RESET#`. The SOM's own 10 kΩ × 100 nF ≈ 1 ms RC delays the actual release, then `BOOTMODE_8/9` are sampled with `+3V3` already stable | **BOOTMODE** |

The manual gives the latch criterion exactly, which is better than "before reset releases": *"The
BOOTMODE signals must be held at the desired configuration **until `X_PORz_OUT` goes high** to be
properly latched into the system"* (§6.3). Holding `X_nRESET_IN` low holds `PORz` asserted, so
`X_PORz_OUT` (`X1 C57`) cannot go high until step 5 — the sequence satisfies the stated condition by
construction rather than by timing luck. `X_PORz_OUT` is an output and could be brought to the MCU
as a confirmation, but it is not needed to *make* the sequence correct, only to observe it.

Step 4 also keeps the Spartan-6 preference above intact (`MCU_EN_FPGA_CORE` → `MCU_EN_3V3` →
`MCU_EN_DDR`); it simply moves that whole group after the SoM instead of before it. The 100 nF on
`X_nRESET_IN` is a gift here — it makes step 5 self-delaying rather than something firmware has to
time.

**This adds one signal to the design, and it is not drawn yet.** `X_PGOOD` must reach the MCU:

> **`PG_SOM`** — `X500` C54 → a spare MCU GPIO. `PC8` is the suggestion (a plain GPIO; the four
> ADC-capable spares are worth keeping for analogue). The pin is open-drain with its pull-up on the
> SOM's own 3.3 V, so when the SoM is unpowered the net floats — **enable the MCU's internal
> pull-down** so "no SoM" reads as "not good" rather than as noise. A pull-down is the safe
> direction: it sinks, it does not inject.

That is a WP8 item on `som.kicad_sch` and a small edit to `mcu.kicad_sch`, listed in `mcu.md` §9's
open items rather than made silently on a reviewed sheet.

**No hardware interlock is proposed**, though PHYTEC's Figure 20 shows one (a load switch on the
baseboard rails, enabled by `X_PGOOD`). Ours is firmware sequencing against `PG_SOM`, which costs
no parts and keeps firmware's ability to run the SoM with the FPGA rail down — a state the reading
architecture may want. The trade is that a firmware bug can now do what a load switch would have
prevented, so the sequence above is a **hard requirement on `power.c`, not a preference**.

**Not verified on hardware.** Two distinct failure modes now, and they differ in severity: getting
step 4 before step 2 risks *module damage* (PHYTEC's wording), and getting step 5 before step 4
gives an *intermittent wrong boot device*. The first is why this correction matters more than the
original note did.

One ordering consequence of deleting `U11` (§2.2): the boost no longer has to wait for a switched
input to cross its 1.8 V start-up UVLO ‡, so `MCU_EN_5V` high starts it immediately. Firmware's
5 V step is now a plain "assert, wait `tSS` ≈ 700 µs ‡ plus margin, read the rail on `power_mon`" —
there is no `PG_5V` (below), so the 5 V rail is the one step that is confirmed by measurement
rather than by a pin. With `PG_SOM` added, the *SoM* side of that step does get a pin.

## 6. Deviations from `NOTES-R2-plan.md`

| Plan | Here | Why |
| --- | --- | --- |
| `+5V_SOM`, enable `MCU_EN_SOM` | `+5V_DCDC`, enable `MCU_EN_5V` | the rail feeds the SoM *and* the EPD HV chain, so naming it after one consumer misleads |
| "needs a load switch on the boost input" | no load switch | the plan's premise — that a disabled boost passes its input through — is not true of `TPS61022`. §2.2, §10.7 |
| `+3V3_SYS` and `+3V3_FPGA_IO` as two rails | one `+3V3_DCDC` | each 3.3 V rail costs a whole buck-boost (§2.1), and the plan itself says not to build around powering a `VCCO` bank down while the die is configured. Per-rail *measurement* is not lost: `power_mon`'s shunts can still split them |
| bucks direct from the cell | true for 1.2 V and 1.5 V; 3.3 V is buck-boost | §2.1 |
| `+5V2_FL` in the rail table | moved to `frontlight.kicad_sch` | an LED boost from `+VSYS` is one conversion, not two |

## 7. Footprints

Three of the four ICs land on stock KiCad 10 footprints, checked against the package names in each
datasheet's orderable-devices table:

| Part | Package | Footprint |
| --- | --- | --- |
| `TPS7A0233DBVR` | DBV | `Package_TO_SOT_SMD:SOT-23-5` |
| `TPS61022RWUR` | RWU0007A | `Package_DFN_QFN:Texas_RWU0007A_VQFN-7_2x2mm_P0.5mm` |
| `TPS62A02DRLR` | DRL | `Package_TO_SOT_SMD:SOT-563` |
| `TPS63802DLAR` | DLA0010A | **`r2:Texas_DLA0010A_VSON-HR-10_2x3mm_P0.5mm` — does not exist yet** |

Three things to settle before layout:

1. **Author the `DLA0010A` footprint** from `tps63802.pdf`'s mechanical drawing (VSON-HR, 2 × 3 mm,
   0.5 mm pitch, 1 mm max height). VSON-HR has no exposed pad — KiCad's own
   `Texas_VSON-HR-8_1.5x2mm_P0.5mm` numbers pads 1–8 and nothing else, confirming the family
   convention. This is the only footprint that has to be drawn from scratch, and it is the one
   `footprint_link_issues` warns about in ERC today.
2. ~~**`Texas_RWU0007A_VQFN-7_2x2mm_P0.5mm` leaves its thermal-pad segments unnumbered**, so the
   netlist does not connect them and `TPS61022`'s heat path is not tied to `GND`.~~
   **WRONG — withdrawn 2026-08-22. No fix needed; do not "correct" this footprint.**
   The six unnumbered pads are **`F.Paste` only**. They are stencil apertures, not copper: each of
   the three large pads is split into two paste openings to control solder volume, which is the
   standard KiCad idiom for a pad this size. Read off the placed footprint:

   | pad | layers | net |
   | --- | --- | --- |
   | *(six unnumbered)* | `F.Paste` | — |
   | `1` | `F.Cu` `F.Mask` | `GND` |
   | `2` | `F.Cu` `F.Mask` | `Net-(U12-SW)` |
   | `3` | `F.Cu` `F.Mask` | `+5V_DCDC` |
   | `4`–`7` | `F.Cu` `F.Mask` `F.Paste` | `FB`, `MCU_EN_5V`, `MODE`, `+VSYS` |

   Every copper pad is numbered and netted. Pin 1 *is* the thermal path (‡ Table 5-1) and it is on
   `GND`. The original note was written from a pad list that did not show the layer field, and it
   would have sent someone to copy a correct library footprint into `r2.pretty` and renumber paste
   apertures into copper — creating the short it was trying to prevent. §11.2 item 5 amended to
   match.
3. **Both inductor footprints are placeholders.** KiCad has no land pattern for either Murata DFE
   series, so `L300`/`L302`/`L303` currently carry `Inductor_SMD:L_1210_3225Metric` and `L301` carries
   `Inductor_SMD:L_1008_2520Metric`. Those are the right body sizes — 3.2 × 2.5 mm and
   2.5 × 2.0 mm — but a generic chip land is not a molded-inductor land. Check both against
   Murata's recommended pattern and copy corrected versions into `r2.pretty`. Two pads each; low
   risk, but it is a guess until checked.

Deleting `U11` (§2.2) removed the `Texas_DSG0008A_WSON-8-1EP_2x2mm_P0.5mm_EP0.9x1.6mm` line item and
with it one of the three `footprint_link_issues`-adjacent worries; the remaining thermal-pad problem
is item 2 above.

## 8. What this sheet costs

Converter overhead only; loads are elsewhere. Quiescent figures are datasheet typicals, load
figures are **(est.)**.

**Standby — `MCU_EN_*` all low, only `+3V3_AON` alive:**

| | typ | max |
| --- | --- | --- |
| `U10` `TPS7A0233` Iq | 25 nA | |
| `U12` `TPS61022` shutdown, `ISD` into `VIN`+`SW` ‡ §6.5 | 0.25 µA | 3.5 µA |
| `U13` `TPS63802` shutdown ‡ §8.5 | 45 nA | 600 nA |
| `U14`, `U15` `TPS62A02` shutdown ‡ §6.5 | 2 × 0.01 µA | 2 × 2 µA |
| three 470 k `PG` pull-ups, all rails low | 21 µA | |
| **total** | **~21.3 µA ≈ 0.08 mW** | ~29 µA |

That is 1.5 µA *higher* than the number this section carried before `U11` was deleted, because `U11`
used to be the thing isolating `U12`'s `VIN` and now `U12` sits on `+VSYS` and leaks its own 0.25 µA.
Against `U11`'s own ≤ 2 µA of `VBIAS` shutdown current it is a wash, and against the ~10 mW standby
target the whole rail tree is still under 1 %.

Every feedback divider is on a converter *output*, and all three switchers actively discharge their
outputs when disabled (`TPS62A02` names the current: 60–76 mA on `SW` ‡ §6.5), so no divider draws
anything in standby. That is why the number is dominated by the `PG` pull-ups — and why they are
470 k, not TI's 100 k.

**Reading state — all rails on, converters idling:** `U12` 27 µA from `VOUT` ‡ + 0.9 µA from `VIN` ‡,
`U13` 11 µA ‡, `U14`/`U15` 20–23 µA each ‡, plus ~13 µA of divider current and 21 µA of `PG`
pull-up — call it **0.4 mW** against a 135–235 mW budget. Deleting `U11` took ~0.15 mW of `VBIAS`
quiescent out of that. Conversion *loss* under load is the number that actually matters, and it is a
property of the load, not of this sheet — except that `U11`'s 16 mΩ is no longer in series with the
boost's 2.3 A **(est.)** input current, which was ~85 mW at full load.

### 8.1 The `+5V_DCDC` load budget — checked 2026-08-15, and it holds

§3.2 sized `L300` against `IOUT` = 1.5 A **(est.)** and left an explicit trigger: *"if the SoM's
`VIN` current comes back from PHYTEC materially above 1.5 A, re-run this block."* It has come back,
from three places in `L-1038e.A5`, and it is **1.0 A** — below the estimate, not above.

| Load on `+5V` | mA @ 5 V | Source |
| --- | ---: | --- |
| SoM `VIN`, **design bound** | **1000** | §5.1: *"must be supplied with … a minimum 1 A capacity"*, *"in testing the current draw of the SOM did not exceed 1 A"*; Table 12 *"Draw 5 W (1 A)"* |
| SoM, measured under heavy load ‡ | 651 | Table 4 `IVIN` — and that load was `memtester 500M` + `iperf3` over ETH0 + 4 × `yes`, with **two Ethernet cables, two USB drives and HDMI attached**. Glider has none of those |
| SoM, measured idle ‡ | 324 | Table 4 `IVIN`, "idle in Linux, external interfaces down" |
| SoM, measured idle ‡ | 297 | `lowpowermode_phytec.pdf` — an independent run, 8 % apart, which is a useful cross-check |
| SoM, Suspend-to-RAM ‡ | 25.7 | same |
| EPD HV chain, R1 measured active ‡ | 14.4 | `NOTES-STATUS.md`, 71.8 mW on the `EPD HV` channel |
| microSD | **0** | it runs from the SoM's own `SoC_VDDSHV5_SDIO`, not from this sheet — `som.md` §4 |
| **USB1 host port**, added 2026-08-30 | **565** | `U1402` `TPS2553` at `RILIM` = 49.9 kΩ; datasheet `IOS` max over −40…125 °C. `io-expansion.md` §7.3 |

Worst realistic case is the SoM's 1.0 A design bound **plus** an EPD refresh, which do coincide: the
page is being rendered while the panel is driven. Taking the EPD chain's peak at a generous ~10×
its measured average gives ≈ **1.3 A**, inside the 1.5 A the inductor was sized for.

⚠ **The USB1 host port moves that to ≈ 1.865 A** if a stick draws its full limit during a refresh —
still under the 2.0 A row below, but that is the whole remaining margin, and it is why the current
limit is set at 500 mA nominal rather than the 1 A or 1.5 A the part can do. Two mitigations, neither
requiring a change: the SoM's 1.0 A is a *design bound* against 651 mA measured under a load Glider
does not run, and firmware owns `USB1_DRVVBUS`, so it can hold the port off during a refresh if
bring-up shows it matters.

Re-running §3.2's block with the datasheet's own duty equation (eq. 2, which includes η — the
earlier text used `(VOUT−VIN)/VOUT` and so understated the ripple), at `VIN` = 3.0 V:

| `IOUT` | `I_L,dc` | `I_L,pk` | vs `Isat` 4.8 A |
| ---: | ---: | ---: | --- |
| 1.00 A — SoM alone | 1.85 A | 2.54 A | Isat is **89 %** above the peak |
| **1.30 A — SoM + EPD refresh (est.)** | 2.41 A | **3.10 A** | Isat is **55 %** above the peak |
| 1.50 A — the design point | 2.78 A | 3.47 A | Isat is 38 % above the peak |
| 2.00 A — "margin is gone" | 3.70 A | 4.39 A | Isat is 9 % above the peak |

D = 0.460, ΔI_L = 1.38 A p-p. The IC itself is nowhere near: eq. 1 with `ILIM_SW` = 6.5 A min ‡
gives `IOUT(CL)` = **3.88 A** before current limiting, and TI's own reference design in §8.2 is this
exact application (Li-ion → 5 V) at **3 A**. The inductor remains the binding element, as §3.2 said.

**Two numbers to carry forward.** `VIN` tolerance: Table 4 gives 4.5 / 5.0 / **5.5 V**, but §5.1
recommends designing to **5 V ±5 %** (4.75–5.25 V). Our 4.992 V ±2.5 % reference = 4.87–5.12 V,
inside the tighter of the two with ~120 mV each side for load regulation and ripple — so the ±50 mV
output ripple TI designs for still fits, but there is not room for much more. And `IVBAT` = **40 nA**
into the SoM's `VBAT` (B2, RTC backup): trivially small, but it is a rail somebody has to supply,
and it is a `som.kicad_sch` decision (§`som.md` §3), not one this sheet makes.

The honest comparison to R1 is not a percentage. R1's problem was never converter efficiency; it was
that four bucks could not be turned off at all. The result here is that they can.

## 9. Open

- **No rail on this sheet has been checked against Spartan-6's supply ramp-time window.** DS162
  Table 6 requires `VCCINT`, `VCCAUX` and `VCCO2` each to ramp in **0.20–50.0 ms** — a rail that
  comes up *too slowly* violates it. Compare the soft-start of `U13` (`TPS63802`), `U14`/`U15`
  (`TPS62A02`) and the `+3V3` buck-boost against that ceiling, worst case being a nearly-flat cell
  where a buck-boost takes longest to reach regulation. Opened by WP5 (§5); it belongs to this sheet
  because the converters are here.
- ~~**Bank 3's voltage is under review and may move `+1V35_DCDC`.**~~ **Closed 2026-08-12: the rail
  is now 1.500 V and the net is `+1V5_DCDC`.** `R313` 124 k → 150 k; see §3.1's margin check.
  Decided by the hardware owner once `ds162.pdf` and `mt41k64m16.pdf` were both in hand.
- ~~**The 1.5 V decision costs ~1.9 mW of standby.**~~ **Revised 2026-08-14 — it probably costs
  nothing, and may save.** That estimate compared `mt41k64m16.pdf`'s `IDD6` at 1.35 V (8 mA Rev. G
  / 12 mA Rev. J → 10.8–16.2 mW) against an assumed 1.5 V figure, because the DDR3L datasheet does
  not specify 1.5 V operation — it says "refer to the DDR3 (1.5V) SDRAM data sheet". That datasheet
  is now in `datasheets/MT41J.pdf`, and it gives **`IDD6` = 7 mA for all speed grades** (Table,
  notes 1–3: TC ≤ 85 °C, ASR and SRT disabled) → **10.5 mW at 1.5 V**, at or below the DDR3L part's
  own 1.35 V figure.
  ⚠ **This is a proxy, not a spec for the fitted part.** `MT41J64M16` and `MT41K64M16` are
  different orderable devices; the board fits the `MT41K` running in its "1.5 V compatible mode",
  and nobody publishes that combination's `IDD6`. It is the closest published number — same
  density, same organisation, same family, the voltage we actually run at — and it moves the
  1.5 V decision from "small cost" to "no measurable cost".
  **Worth a decision at BOM time:** the MIG is configured for `MT41J64M16` (`mig.prj`), we run the
  bank at 1.5 V, and DDR3L's 1.35 V capability is therefore unused — so fitting the `MT41J` would
  make the datasheet match the design exactly. Against that, the `MT41K` is what R1 proves and what
  is priced and stocked at LCSC (`C2060943`, $4.49). Check `MT41J` availability before changing
  anything.
- ~~The DDR in self-refresh is the **largest single term** in the reading state.~~ **Not any
  more.** PHYTEC measured the SoM at **128.6 mW** in Suspend-to-RAM (`NOTES-R2-hardware-facts.md`
  §4.6), which is 6–12× the DDR rail and 51–66 % of the whole reading budget. The 10.5 mW here is
  now a minor term. **The architectural lever noted below still stands** and is still worth having:
  if the SoM re-pushed the framebuffer on wake, `MCU_EN_DDR` could be off in the reading state and
  the whole term would go, at the cost of resume latency and a full redraw. That is a WP8 question,
  noted here because this is where the number lives — but it is no longer the biggest one.
- ~~**This doc still owes a "Layout guidelines" section.**~~ **Written — §11.**
- ~~**`U10`'s output must be renamed to `+3V3_AON_DCDC`.**~~ **Done by the reviewer** in the
  2026-08-11 save: `#PWR205` now reads `+3V3_AON_DCDC`, so `power_mon`'s `U1201` ch2 shunt (`R1217`) has
  a real upstream net and `+3V3_AON` is the load side. Verified in the exported netlist.
- ~~**`battery.kicad_sch`'s `+3V3_AON` `PWR_FLAG` is an ERC error, delete it.**~~ **Withdrawn — keep
  it.** That ask was correct only while `U10.OUT` sat on `+3V3_AON`. Now that `U10` drives
  `+3V3_AON_DCDC`, the only thing feeding `+3V3_AON` is `R1217`, a passive shunt, so the flag is the
  net's *sole* ERC driver. Deleting it would turn one `pin_to_pin` warning into a
  `power_pin_not_driven` error on every `+3V3_AON` load — the STM32G0's `VDD`/`VBAT` and three
  `INA3221` `VS`/`VPU` pins. `#FLG04` at (360.68, 205.74) stays. The `pin_to_pin` violation is gone
  either way; ERC now reports **nothing at all** on `/power/` and nothing on `/battery/` except the
  `CHG_QON#` item that waits on the MCU sheet.
- **Rail load estimates.** Every current in §1 and §3.2 is an estimate. The SoM figure in particular
  waits on PHYTEC; **if `VIN` peak is materially above 1.5 A, re-run §3.2's peak calculation** — at
  2.0 A the boost inductor's Isat margin is gone.
- **`+5V_DCDC` decay when disabled.** New with the `U11` deletion (§2.2): nothing actively discharges
  the rail. Needs a hardware test.
- **`+VSYS` dip at 5 V enable.** New with the `U11` deletion (§3.4): the boost's own pre-charge can
  pull ~2.4 A for a few hundred µs. Needs a hardware test with the cell near 3.3 V.
- ~~**`+5V` for the EPD HV chain.**~~ **Answered in WP4** (`epd-port.md` §4.1): no. The `LGS5145`
  is a buck with a 4.5 V minimum input, run here as an inverting buck-boost. In steady state its
  `GND` pin sits on the negative rail so it sees ~25 V, but **at startup that rail is at 0 V** and
  the part sees `+VSYS` alone — 3.0 V from a flat cell will not start it. The 5 V feed stays.
- **Spartan-6 sequencing** — §5.
- **The `DLA0010A` footprint** — §7. (The `RWU0007A` thermal pad was also listed here; that
  concern was wrong and is withdrawn — §7 item 2.)
- **BOM fields.** `MPN` and `LCSC` symbol properties are not populated on any sheet yet; §10.13 says
  why that is deliberate and when it happens.

## 10. Review 1 (2026-08-11) — the analysis notes, answered

Source: `../manual-analysis/Analysis_power.md`. ‡ = read out of `../datasheets/tps62a01.pdf`
(SLUSEG9E, which covers `TPS62A01` **and** `TPS62A02`), `../datasheets/tps63802.pdf` (SLVSEU9D),
`../datasheets/tps61022.pdf` (SLVSDX7D), `../datasheets/tps22965.pdf` (SLVSBJ0F),
`../datasheets/tps7a02.pdf` (SBVS277C) or `../datasheets/bq25890.pdf` (SLUSC86D).

Also read back in this round: your edits to the sheet. You renamed `#PWR205` to `+3V3_AON_DCDC`
(standing ask #2 — done, §9), rearranged the `+1V2` block, and pasted TI's Table 8-2 rows into the
`Description` fields of `C309`, `C310` and `L302`. The netlist is otherwise unchanged from what was
captured; nothing was broken by the rearrangement, and ERC reports zero violations on `/power/`.
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
