UavL/Glider/pcb/r2-mainboard/docs/session-prompt-layout.md

# Starting a fresh session for R2 layout

Copy everything between the rules into the first message of a new Claude Code session, run from
`/home/lum/Ereader Projekt/Glider_OG`. It is written to be pasted as-is — it assumes the assistant
has read nothing and knows nothing about this branch.

Keep it up to date: whenever a session ends, the "Where the board stands" list is the part that has
gone stale.

---

I'm laying out R2 in KiCad 10 myself and want you checking my work, not doing it. Branch
`Board-Design`, board is `pcb/r2-mainboard/r2.kicad_pcb`.

**Read these first, in this order, before answering anything:**
1. `CLAUDE.md` — the ground rules. They are not negotiable.
2. `pcb/r2-mainboard/docs/layout.md` — the whole Stage D brief. §4.1 has the net classes and every
   track width with the reason attached; §4.2 explains why clearance is 0.11 mm; §6.3/§6.4 are the
   placement and routing order; §7 is the five things that destroy the board; §9 is troubleshooting.
3. The per-sheet doc for whatever circuit I'm asking about — `docs/<sheet>.md`, §11 of each is its
   layout guidance. Don't answer a layout question about a circuit without reading its §11.
4. **`NOTES-R2-osd62x-plan.md`** if the question touches the SoM corner, `som`, `dpi_in`, `power` or `mcu`
   — the compute module is switching to Octavo's `OSD62x-PM` (owner, 2026-09-11).
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
