UavL/Glider/pcb/r2-mainboard/datasheets/SiC OSD62x-PM/OSD62x-PM Power Application Note _ Octavo Systems_files/1212awe-1.webp

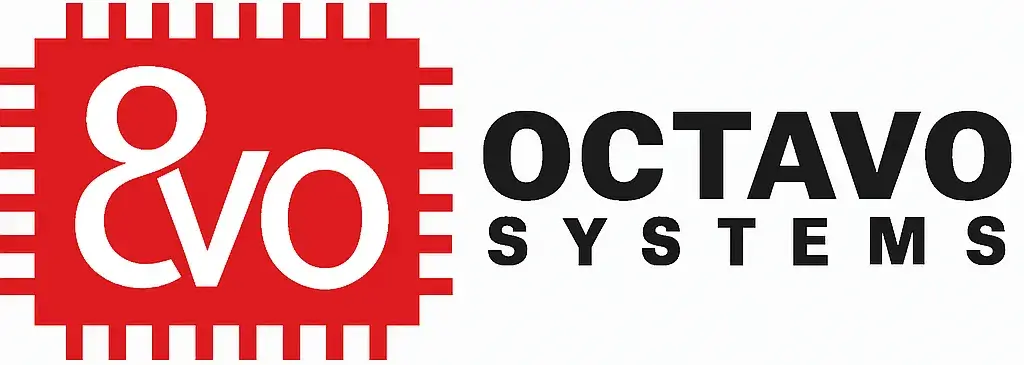
pcb/r2-mainboard/datasheets/SiC OSD62x-PM/OSD62x-PM Power Application Note _ Octavo Systems_files/1212awe-1.webp
