UavL/Glider/pcb/r2-mainboard/datasheets/SiC OSD62x-PM/OSD62x-PM Power Application Note _ Octavo Systems_files/Example-Discrete-Power-Solution-for-OSD62x-PM-875x1024.png

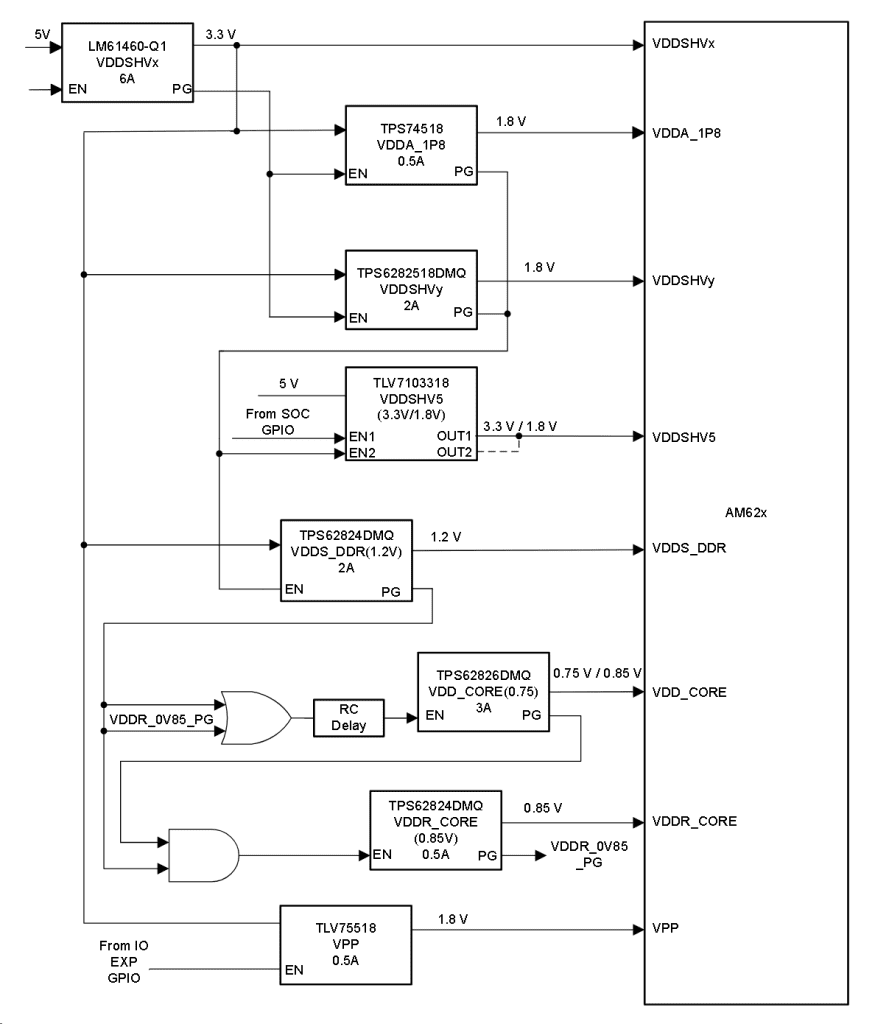
pcb/r2-mainboard/datasheets/SiC OSD62x-PM/OSD62x-PM Power Application Note _ Octavo Systems_files/Example-Discrete-Power-Solution-for-OSD62x-PM-875x1024.png
