UavL/Glider/pcb/r2-mainboard/datasheets/SiC OSD62x-PM/OSD62x-PM Power Application Note _ Octavo Systems_files/osd32mp15x_stack_up_no_words-800x600-c-default.png

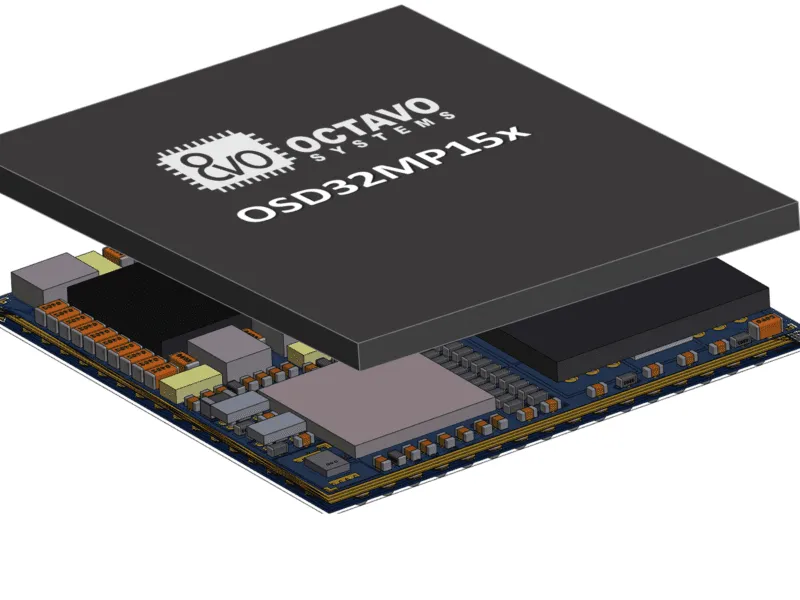
pcb/r2-mainboard/datasheets/SiC OSD62x-PM/OSD62x-PM Power Application Note _ Octavo Systems_files/osd32mp15x_stack_up_no_words-800x600-c-default.png
