UavL/Glider/pcb/r2-mainboard/datasheets/SiC OSD62x-PM/OSD62x-PM Power Application Note _ Octavo Systems_files/OSD62x-PM-Block-Diagram-1.png

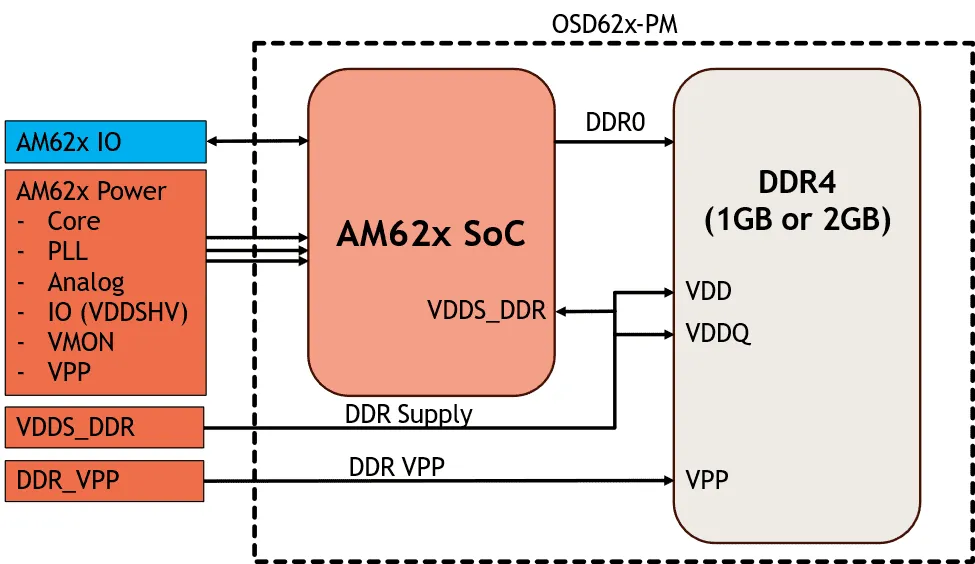
pcb/r2-mainboard/datasheets/SiC OSD62x-PM/OSD62x-PM Power Application Note _ Octavo Systems_files/OSD62x-PM-Block-Diagram-1.png
