UavL/Glider/pcb/r2-mainboard/datasheets/SiC OSD62x-PM/OSD62x-PM Power Application Note _ Octavo Systems_files/OSD62x-PM-Power-Down-Sequencing-1-937x1024.png

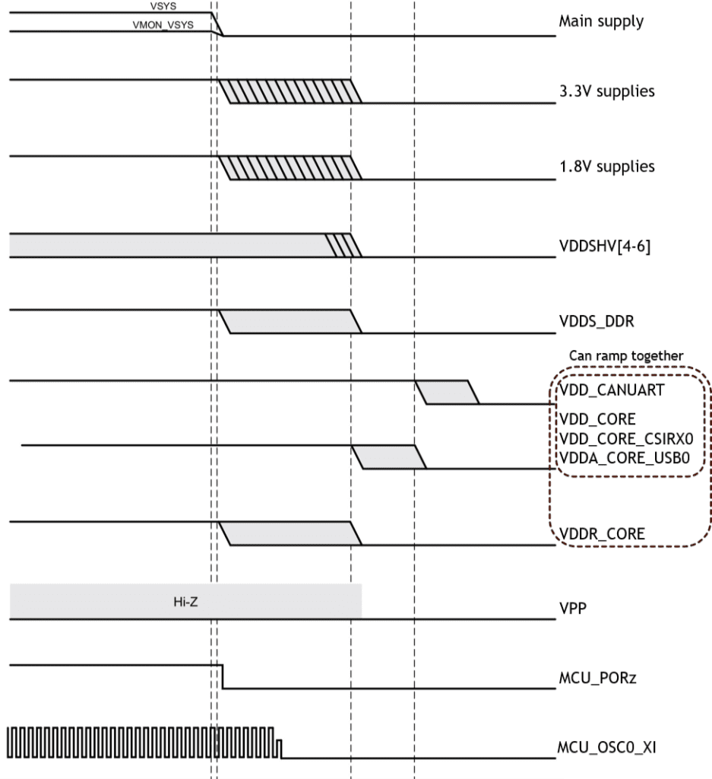
pcb/r2-mainboard/datasheets/SiC OSD62x-PM/OSD62x-PM Power Application Note _ Octavo Systems_files/OSD62x-PM-Power-Down-Sequencing-1-937x1024.png
