UavL/Glider/pcb/r2-mainboard/datasheets/SiC OSD62x-PM/OSD62x-PM Power Design and Budgeting _ Octavo Systems_files/OSD62-PM-BRK-Power-Block-Diagram-1.png

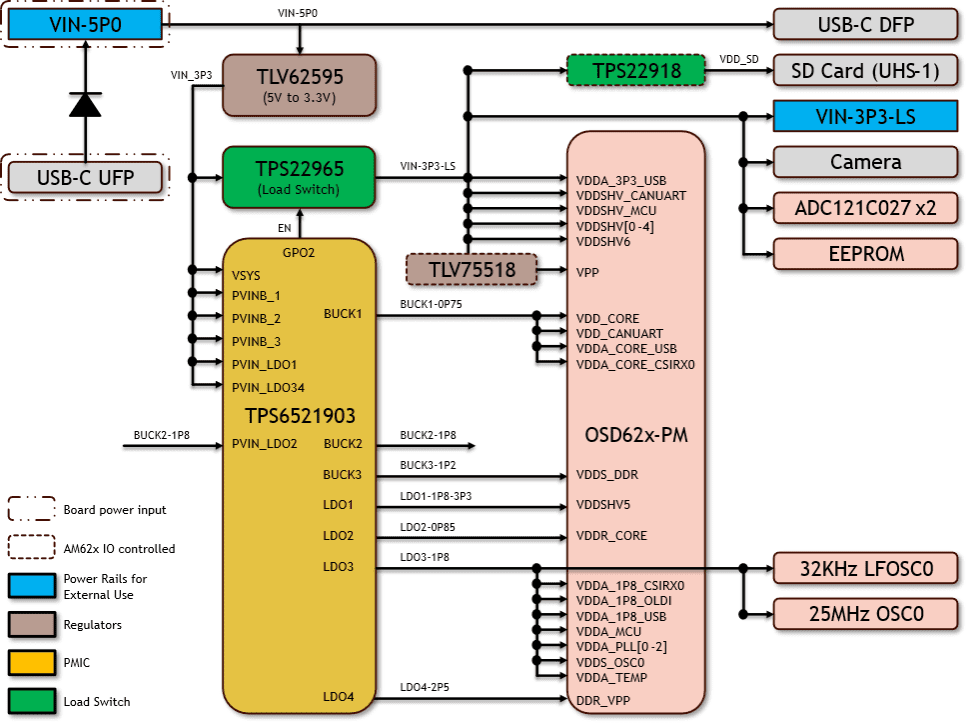
pcb/r2-mainboard/datasheets/SiC OSD62x-PM/OSD62x-PM Power Design and Budgeting _ Octavo Systems_files/OSD62-PM-BRK-Power-Block-Diagram-1.png
