UavL/Glider/pcb/r2-mainboard/datasheets/SiC OSD62x-PM/OSD62x-PM Power Design and Budgeting _ Octavo Systems_files/Power-up-Sequencing-of-the-TPS6521903-1-859x1024.png

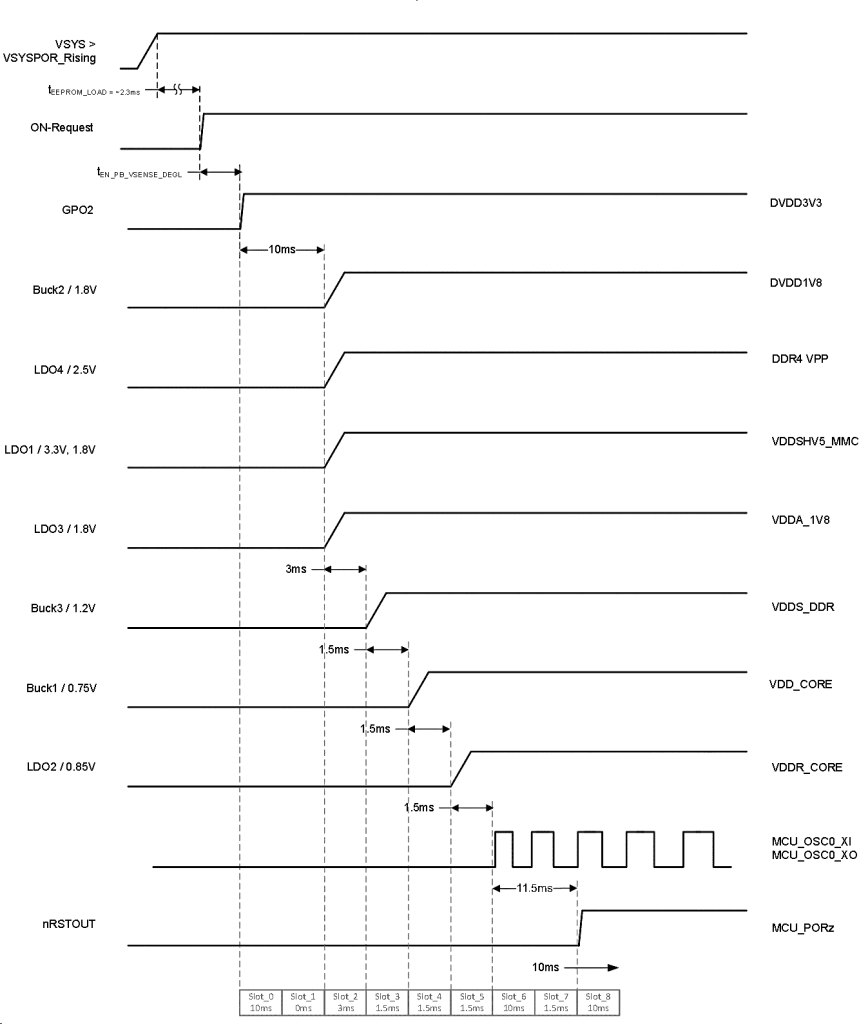
pcb/r2-mainboard/datasheets/SiC OSD62x-PM/OSD62x-PM Power Design and Budgeting _ Octavo Systems_files/Power-up-Sequencing-of-the-TPS6521903-1-859x1024.png
