UavL/Glider/pcb/r2-mainboard/datasheets/SiC OSD62x-PM/OSD62x-PM Power Design and Budgeting _ Octavo Systems_files/TPS6521903-OSD62x-PM-Interface-Connections-1.png

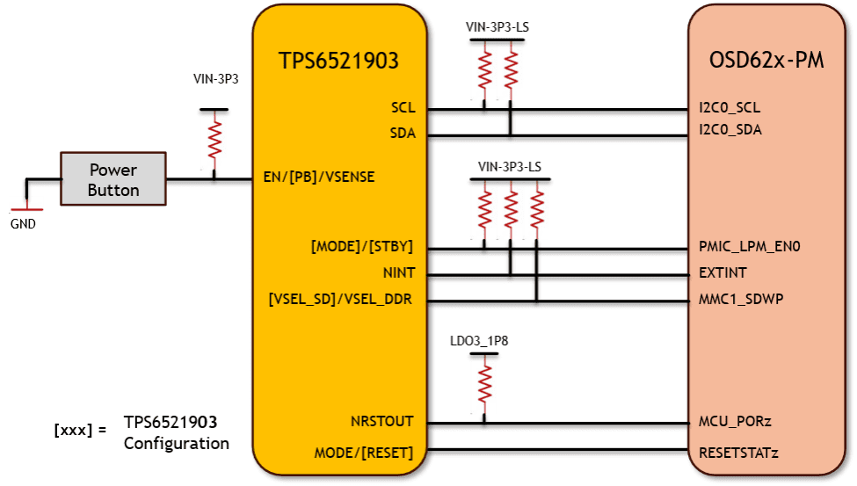
pcb/r2-mainboard/datasheets/SiC OSD62x-PM/OSD62x-PM Power Design and Budgeting _ Octavo Systems_files/TPS6521903-OSD62x-PM-Interface-Connections-1.png
