UavL/Glider/pcb/r2-mainboard/datasheets/SiC OSD62x-PM/OSD62x-PM Schematic Checklist _ Octavo Systems_files/16147-0001-edited.png

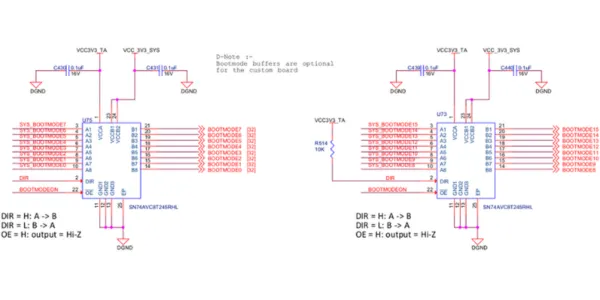
pcb/r2-mainboard/datasheets/SiC OSD62x-PM/OSD62x-PM Schematic Checklist _ Octavo Systems_files/16147-0001-edited.png
