UavL/Glider/pcb/r2-mainboard/datasheets/SiC OSD62x-PM/OSD62x-PM Schematic Checklist _ Octavo Systems_files/word-image-16147-0002.png

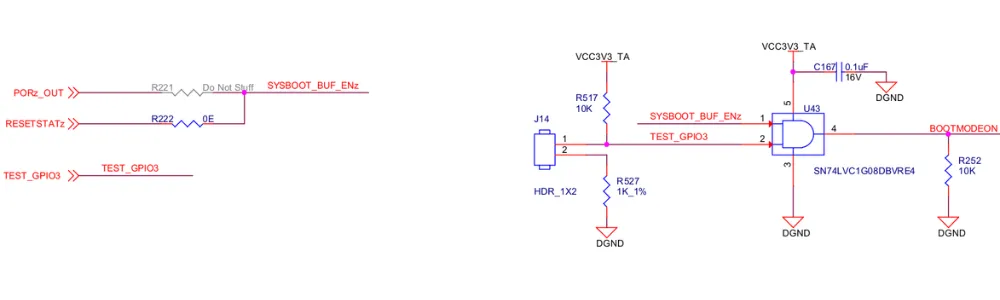
pcb/r2-mainboard/datasheets/SiC OSD62x-PM/OSD62x-PM Schematic Checklist _ Octavo Systems_files/word-image-16147-0002.png
