UavL/Glider/pcb/r2-mainboard/datasheets/SiC OSD62x-PM/OSD62x-PM Thermal Guide _ Octavo Systems_files/Untitled-design-78-1.png

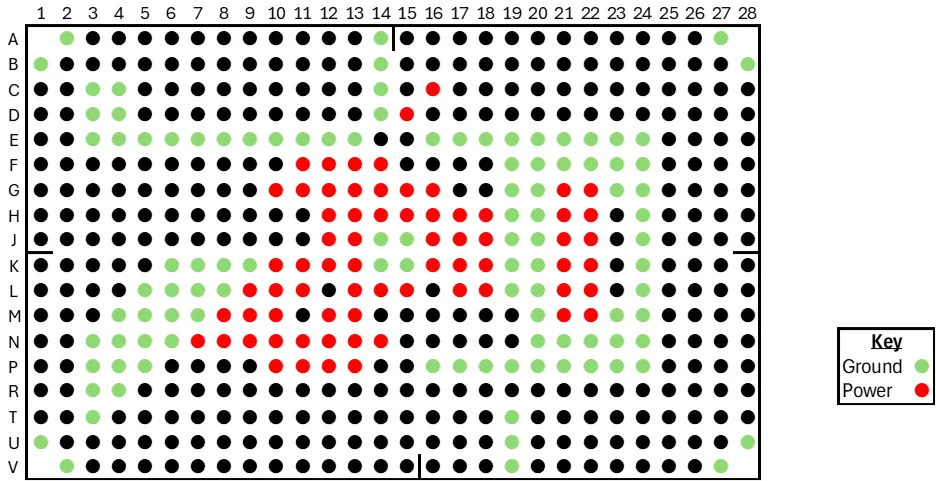
pcb/r2-mainboard/datasheets/SiC OSD62x-PM/OSD62x-PM Thermal Guide _ Octavo Systems_files/Untitled-design-78-1.png
