UavL/Glider/pcb/r2-mainboard/visualisation/glider_r2_power_tree.png

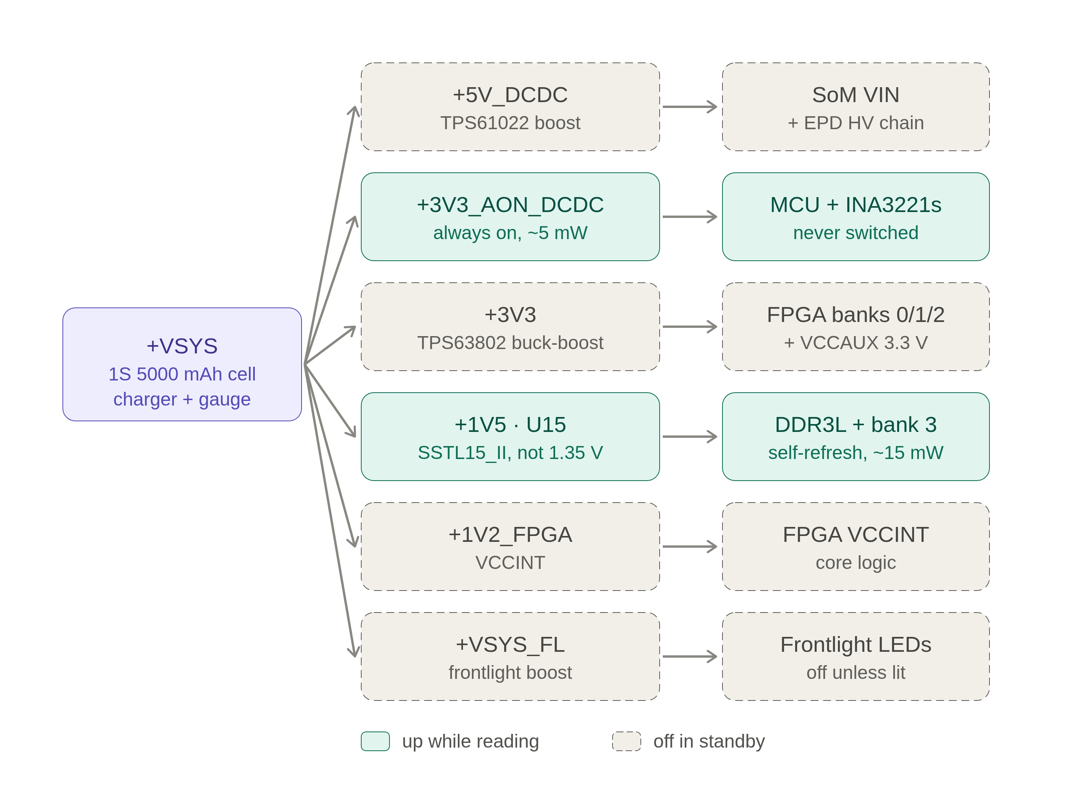
pcb/r2-mainboard/visualisation/glider_r2_power_tree.png
