UavL/Glider/pcb/r2-mainboard/visualisation/glider_r2_signal_architecture.png

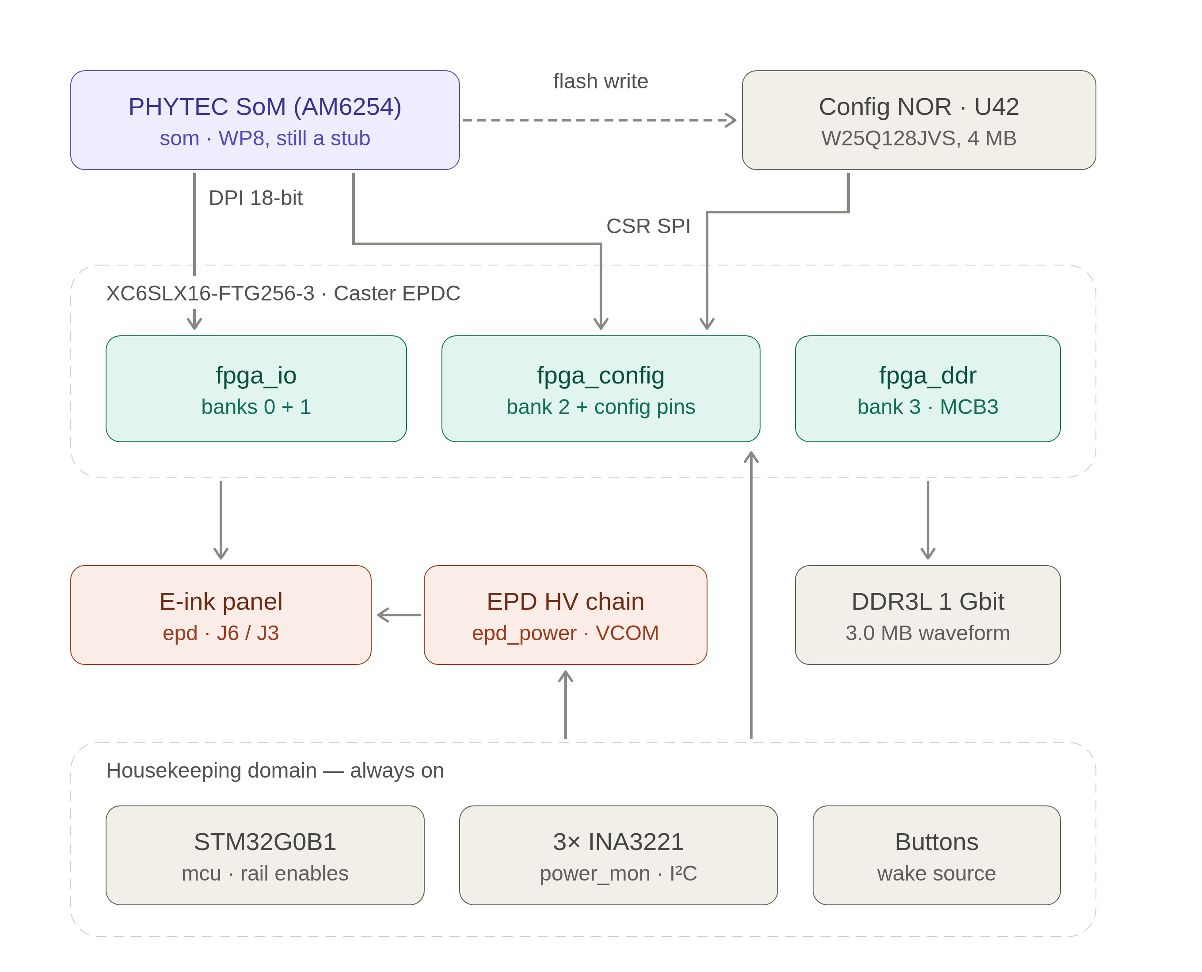
pcb/r2-mainboard/visualisation/glider_r2_signal_architecture.png
