UavL/Glider/parts/parts.md

Batterie: https://dtpbattery.en.made-in-china.com/product/OCvJMfXrkycD/China-Li-Polymer-3-7V-5V-5000mAh-18-5wh-Lipo-Battery-with-Kc-Ce-RoHS-Un38-3-Certificate.html
