UavL/Glider/parts/Battery/battery_description.md

https://de.aliexpress.com/item/1005005956443280.html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

1. Model code : PL706090

2. Cell size : 0.7 cm (thick) x 6.0 cm (width) x 9.0 cm (length)

                                0.27inch x 2.36inch x 3.54inch

3. Nominal capacity: 3.7v 5000mah 18.5Wh

4. Built-in protection circuit PCB for prevent over charging or over discharging.

5. Fit for Remote controller, IPTV Set top box remote controller, LED lighting, Underwater lighting system, Bluetooth device, Mp3/Mp4 player, Safety lamp, GPS, Mobile phone, E-book, Power bank, Portable DVD, Walkie taklie, Notebook, Tablet PC, PDA, Game player, Pos machine, Consumer electronics device, Medical devices, Flash lighting, Garden lighting, Karaoke, Digital Camera, Driving recoder, Recording pen, Headset , Dashcam, Satnav, Navigation, Baby monitor, Navigation, Car camera, Drift camera, Taillight, Bluetooth speaker, Instrumentation, Smart lock, Medical device, Digital light, Air purifier,  Project Desigh ,etc.

6. Each Cell weight : 84g

7. The white wire for thermistor !

Package include :

1pcs 3.7v 5000mah polymer rechargeable li battery 706090 with JST 3pin 1.25mm connector

Electrical characteristics：
1.  if your device still have a PCM protector board lie on motherboard of your device. it will can't work well.
please remove off this PCM from our this li battery. so this battery can work well.
2. if your old one li battery have a PCM board on top of li battery. please instead this old pcm to our new li battery . maybe our PCM board don't fit your device. each device there      are different requirements with PCM board.
3.Standard Charging method ：0.5C （constant current）charge to 4.2V,then CV(constant voltage 4.2V)charge till charge current decline to ≤0.05C
4.  Rated Capacity  ：  The capacity means the discharge capacity of the cell, which is measured with discharge current of 0.2C with 3.0V cut-off voltage after standard charge.
5.   Charging time       ：Standard Charging：3.0 hours(Ref.) ，Rapid charge：     2.0 hours(Ref.)
6.   Max. charge current       ：1.0C
Max. discharge current     ：1.0C
Discharge cut-off voltage   ：3.0V
7.  Operating temperature     ：Charging：  -20℃~60℃  Discharging：-20℃~60℃
8.   Storage temperature       ： -10℃~ +45℃
9.  Cycle life:  600 cycles,Stable performance with 100% in house testing
10.  Warranty: 18 Months
11.  Test condition：
Charge:0.5C to 4.2V
Discharge:0.2C to 3.0V
70% or more of 1st cycle capacity at 0.2C discharge of Operation
Self-discharge ：Residual capacity >90%
After the standard charging, storied the cells under the condition for 30 days, then measured the capacity with 0.2C till 3.0V
12：Temperature  characteristics ：
-20℃: ≥65%
23℃: 100%
60℃: ≥96%
---- According to item at 23±5℃.
----Capacity comparison at each temperature, measured with constant discharge current 0.2C with 3.0V cut-off. Percentage as an index of the capacity compared with 100% at 23℃
13 ：  Mechanical characteristics:
----- Vibration Test : No leakage /  No fire
After standard charging, fixed the cell to vibration table and subjected to vibration cycling that the frequency is to be varied at the rate of 1Hz per minute between 10Hz an 55Hz,the excursion of the vibration is 1.6mm.The cell shall be vibrated for 30 minutes per axis of XYZ axes.
-----  Drop Test : No fire/ no leakage.
The cell is to be dropped from a height of meter twice onto concrete ground.
