UavL/Glider/parts/Display/2817fc604b.jpg

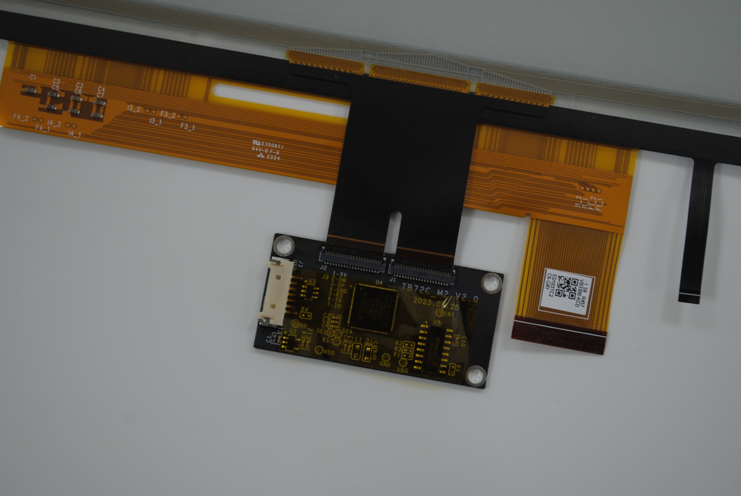
parts/Display/2817fc604b.jpg
