UavL/Glider/parts/Display/Bildschirmfoto_20260819_162728.png

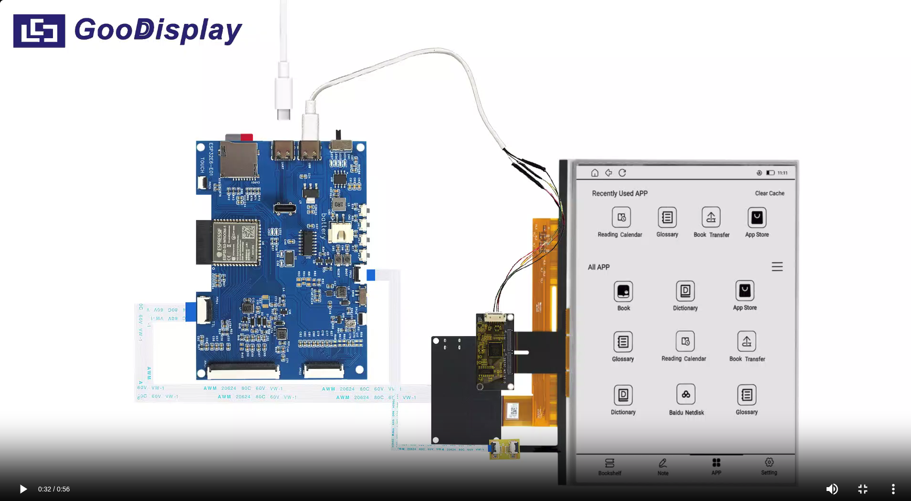
parts/Display/Bildschirmfoto_20260819_162728.png
