UavL/Glider/parts/Display/Download.png

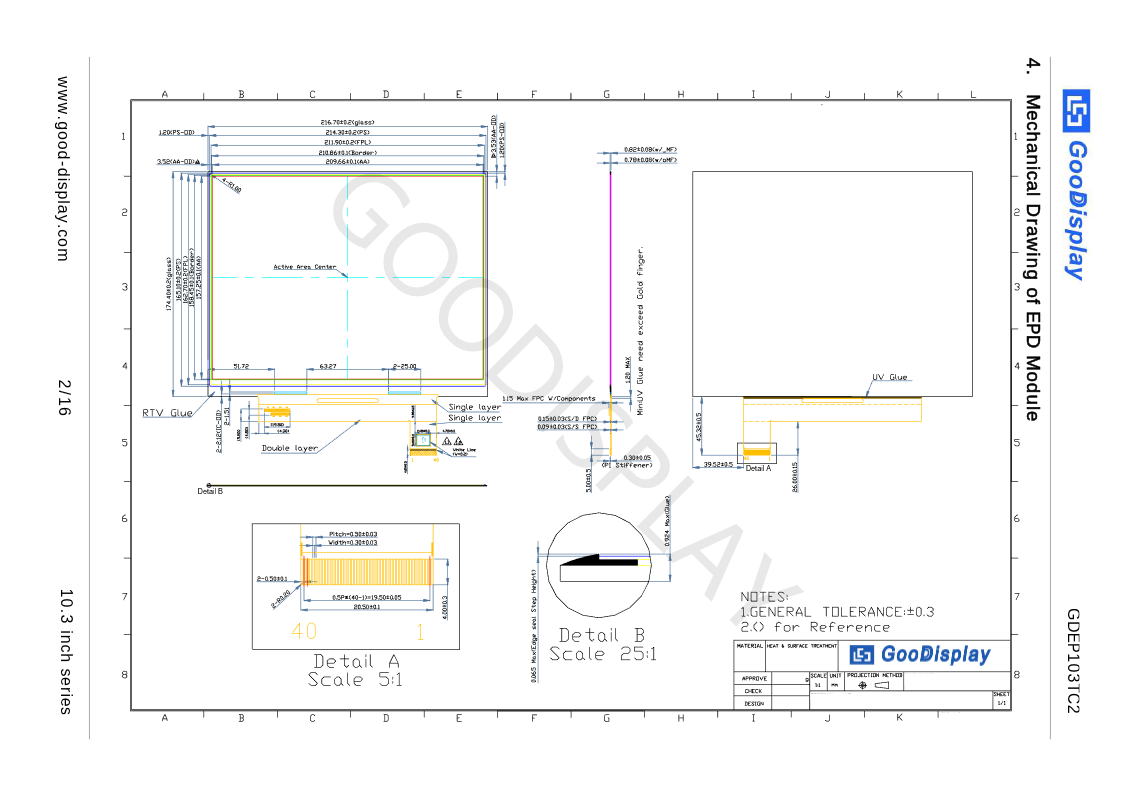
parts/Display/Download.png
