UavL/Glider/parts/Buttons/EVQPU-LC-02K.STEP

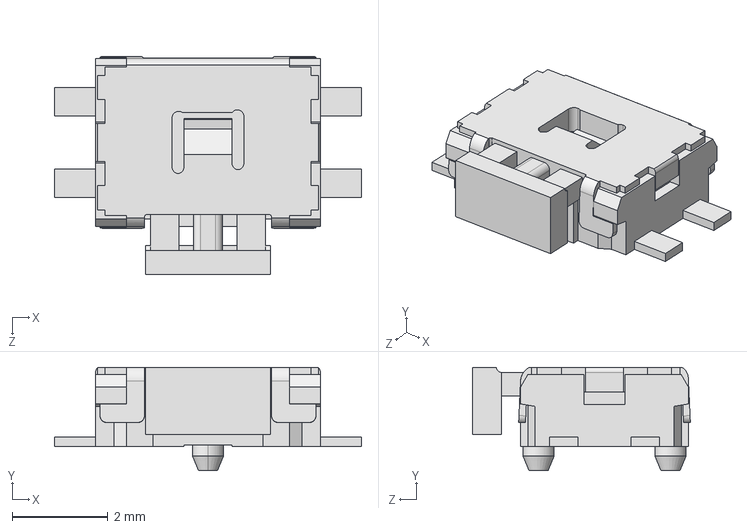
[picture p38: CAD file, 2026-08-26]
parts/Buttons/EVQPU-LC-02K.STEP
6.40 x 2.15 x 4.54 mm
