UavL/Glider/pcb/r2-mainboard/datasheets/SoM Phycore AM62x/PCM-071_1573-1_3d/PCM-071_1573-1.dxf

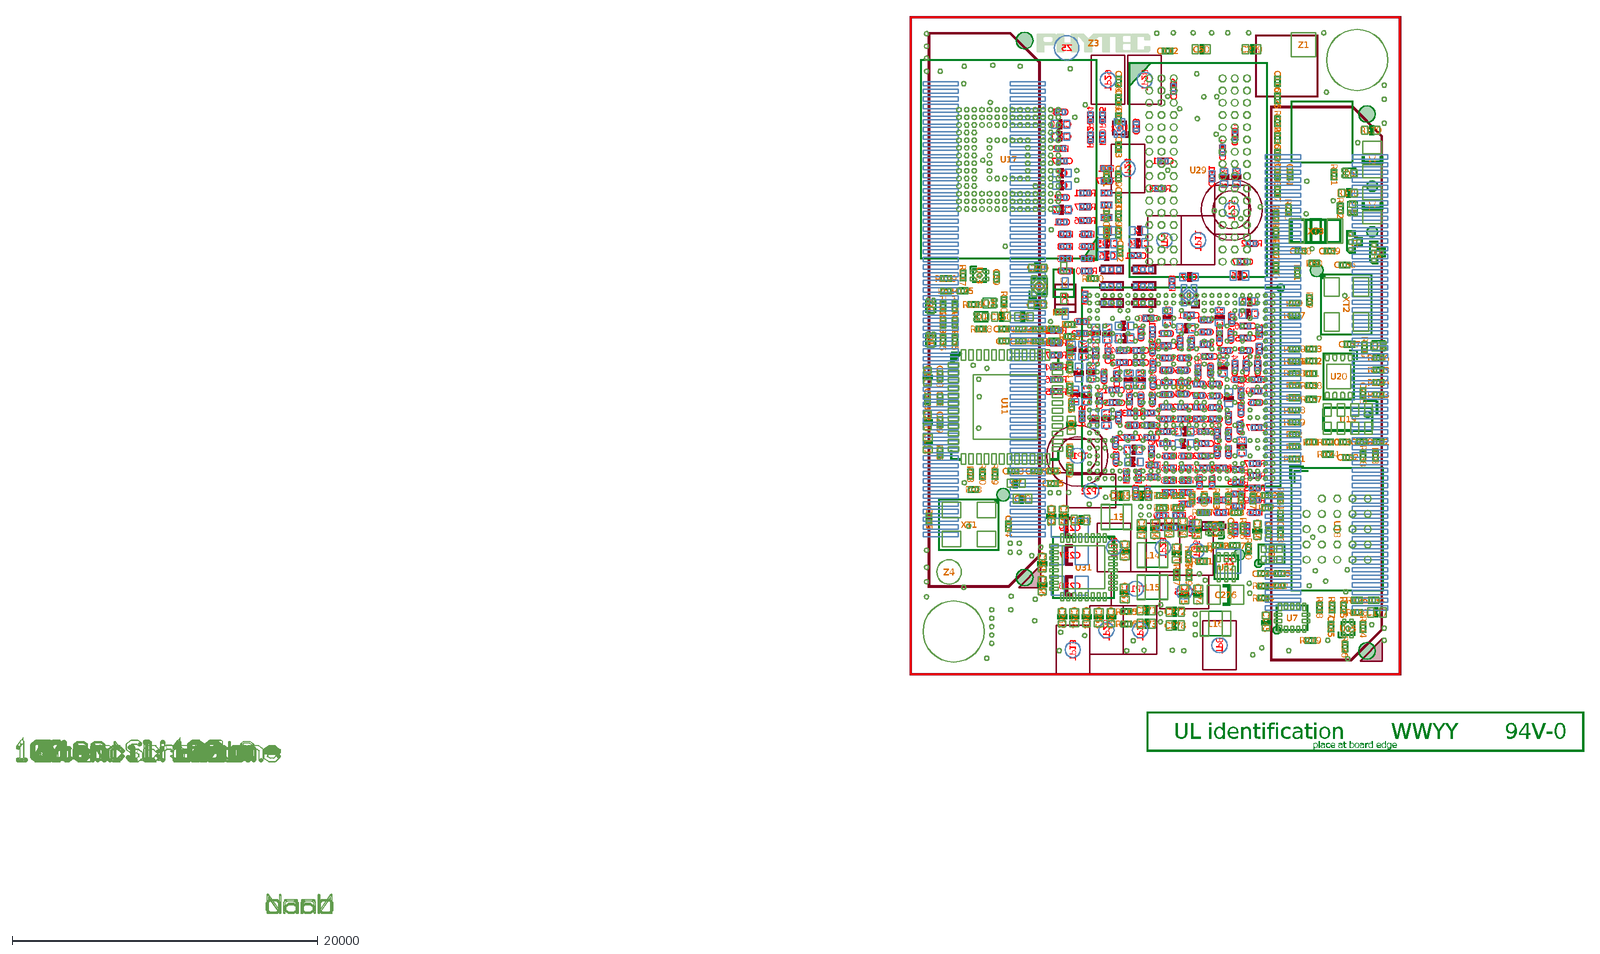
[picture p39: CAD file, 2026-08-20]
pcb/r2-mainboard/datasheets/SoM Phycore AM62x/PCM-071_1573-1_3d/PCM-071_1573-1.dxf
UL identification WWYY 94V-0
place at board edge
C62
C63
C64
C65
C66
R63
C67
C70
C68
C101
C69
C71
C111
C72
C73
TP11
C131
R70
C74
R101
R71
C75
C76
C77
TP29
R131
C171
C78
C80
C181
C201
C81
C79
R129
C169
C211
C191
C82
C179
C221
C83
C231
C84
C219
C199
C241
C85
C86
C239
C87
R189
R84
C88
C90
R85
C89
C91
R86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
