UavL/Glider/pcb/r2-mainboard/datasheets/SoM Phycore AM62x/REF-177862-03.STEP

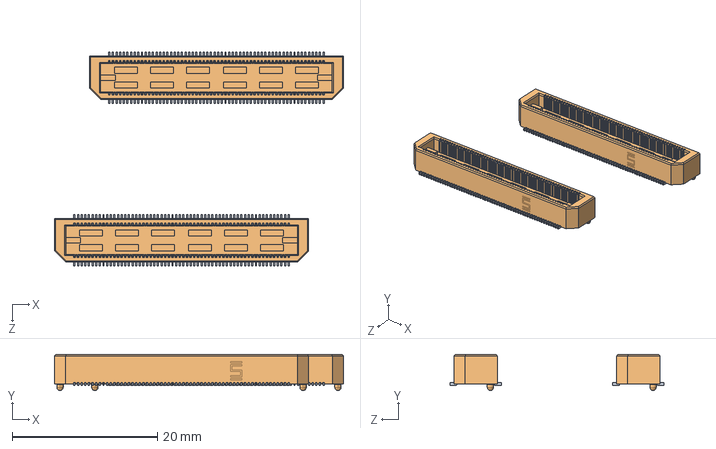
[picture p40: CAD file, 2026-08-20]
pcb/r2-mainboard/datasheets/SoM Phycore AM62x/REF-177862-03.STEP
39.8 x 5.02 x 29.5 mm
T-1S39 x 480
BTH-XX-D x 4
