UavL/Glider/pcb/r2-mainboard/datasheets/SoM Phycore AM62x/ASP-205225-01.STEP

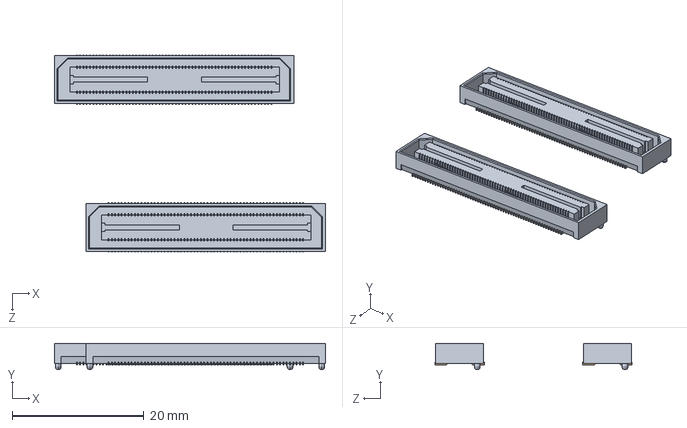
[picture p41: CAD file, 2026-08-20]
pcb/r2-mainboard/datasheets/SoM Phycore AM62x/ASP-205225-01.STEP
41.1 x 4.00 x 29.9 mm
BSH-060-01-L-D-A-TR x 2
