UavL/Glider/pcb/r2-mainboard/docs/manual-analysis/Analysis_dpi_and_som.md

The PIN X_VDOUT0_VSYNC doesnt exist like this but is just: "X_VOUT0_SYNC"; I guess that you just clarified for better understanding and its not a problem. I dont understand the DPI_XY labeling though and why diffrent lines get diffrent labels. instead of data0-15.

In som schematic I dont see the actual physical connectors onto which the som sticks onto? Other then that I will believe you here since your understanding is much better then mine in this complex module.

I additionally want to ask you if there were some changes that have been erased, because I changed some things and then kicad crashed but I clicked to Abort restoration when I started it again.

At last I think that there were some changes you wanted to do to some already reviewed shematics and I think now would be the time to talk about that.
