UavL/Glider/pcb/r2-mainboard/docs/manual-analysis/Analysis_fpga.md

1. 1.5V is fine.
2. Yes, delete J3 connector. What was the reason it existed on the original Caster Design?
3. If this causes no problems, then yeah sure keep the traces, why not?
4. That is a good change you noticed. Its good to keep as the datasheet says.
5. I dont see what decision I have to take here? We dont need DisplayPort, but if you think we need it for debug or prototype purpuses we can discuss for sure.
