UavL/Glider/pcb/r2-mainboard/docs/manual-analysis/Analysis_mcu.md

STM32G0B1RCT6:
    C42: Isnt this capacitor one too much?
    FB20: Where in the doc does it call for this?
    Y20: Doesnt the doc say 8 Mhz resonator? Or am I wrong?
    D20: What is this LED for? Is it only for the prototype or why?
    Buttons: For the final product I want only two buttons. prev and next, since enter will be done with touchscreen. Will these buttons work with mcu unpowered to wake everything up, or why is this specifically mentioned for CHG_QON#? Also I dont know which switches to use since I would like a satisfying click!
    Analysis: I cant really check as much here since the pinconfig and other things are dependent on the code. But is it possible to change things on the mcu if needed? And how do I flash/program the mcu?
