UavL/Glider/pcb/r2-mainboard/datasheets/SiC OSD62x-PM/OSD62x-PM Layout Guide _ Octavo Systems_files/Drill-Annular-Ring-and-Via-Dimensions.png

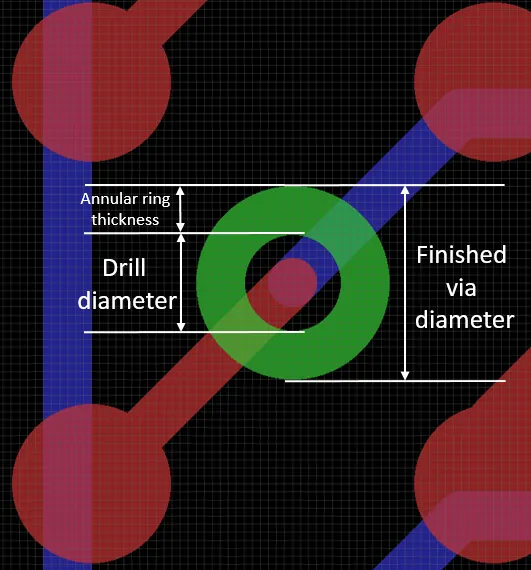
pcb/r2-mainboard/datasheets/SiC OSD62x-PM/OSD62x-PM Layout Guide _ Octavo Systems_files/Drill-Annular-Ring-and-Via-Dimensions.png
