UavL/Glider/pcb/r2-mainboard/datasheets/SiC OSD62x-PM/OSD62x-PM Layout Guide _ Octavo Systems_files/Figure-3-Landing-Pad-Size-for-BGAs-1.png

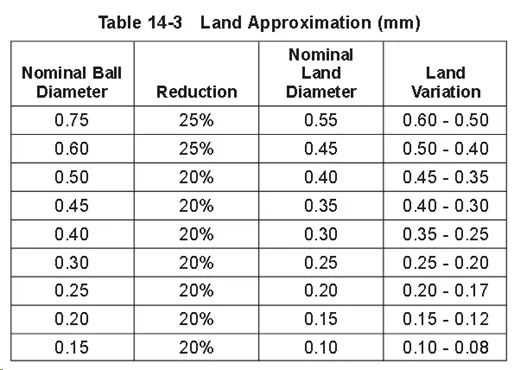
pcb/r2-mainboard/datasheets/SiC OSD62x-PM/OSD62x-PM Layout Guide _ Octavo Systems_files/Figure-3-Landing-Pad-Size-for-BGAs-1.png
