UavL/Glider/pcb/r2-mainboard/datasheets/SiC OSD62x-PM/OSD62x-PM Layout Guide _ Octavo Systems_files/Figure-10-OSD62-PM-BRK-Stack-up-Woutline-1024x492.png

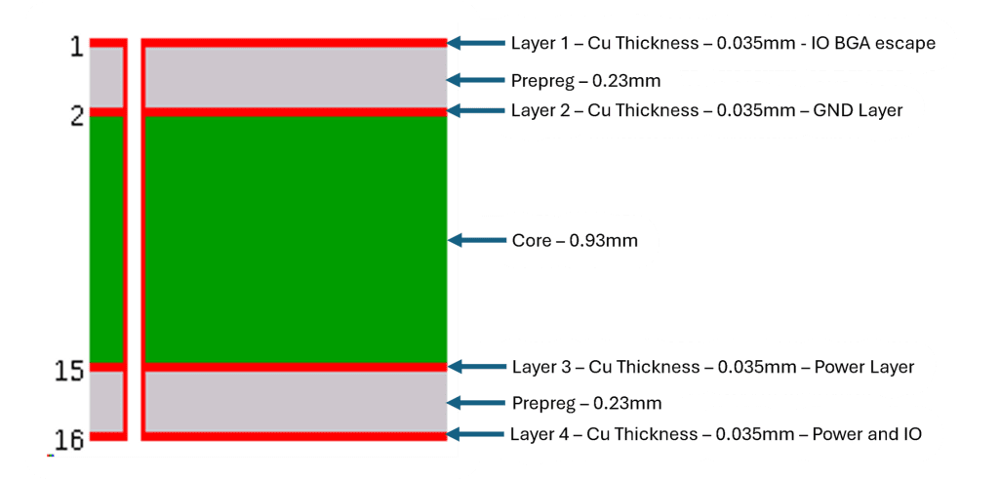
pcb/r2-mainboard/datasheets/SiC OSD62x-PM/OSD62x-PM Layout Guide _ Octavo Systems_files/Figure-10-OSD62-PM-BRK-Stack-up-Woutline-1024x492.png
