UavL/Glider/pcb/r2-mainboard/datasheets/SiC OSD62x-PM/OSD62x-PM Layout Guide _ Octavo Systems_files/Figure-11-OSD62x-PM-Fanout.png

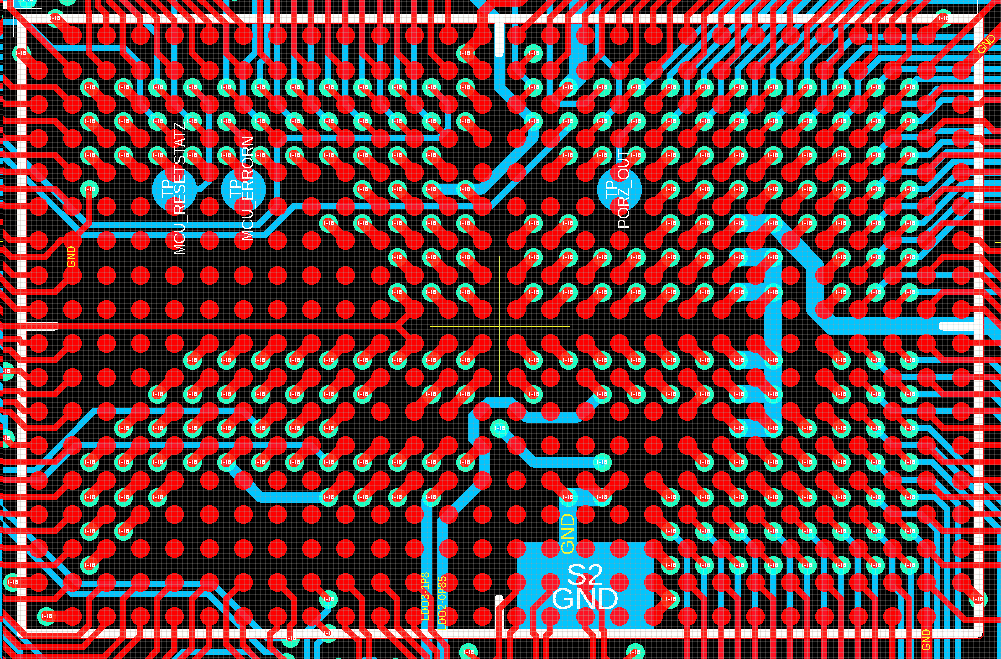
pcb/r2-mainboard/datasheets/SiC OSD62x-PM/OSD62x-PM Layout Guide _ Octavo Systems_files/Figure-11-OSD62x-PM-Fanout.png
