UavL/Glider/pcb/r2-mainboard/datasheets/SiC OSD62x-PM/OSD62x-PM Layout Guide _ Octavo Systems_files/OSD62x-PM-Fanout-with-3mil-Trace-Width-and-Spacing.png

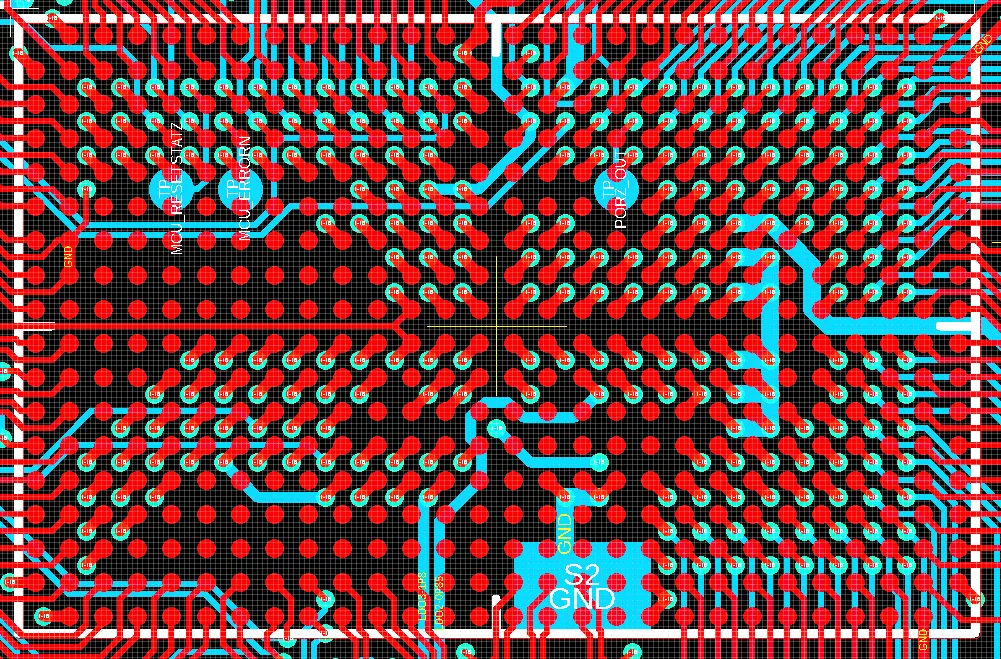
pcb/r2-mainboard/datasheets/SiC OSD62x-PM/OSD62x-PM Layout Guide _ Octavo Systems_files/OSD62x-PM-Fanout-with-3mil-Trace-Width-and-Spacing.png
