UavL/Glider/pcb/r2-mainboard/datasheets/SiC OSD62x-PM/OSD62x-PM Layout Guide _ Octavo Systems_files/Trace-Between-2-Vias-Under-OSD62x-PM-860x1024.png

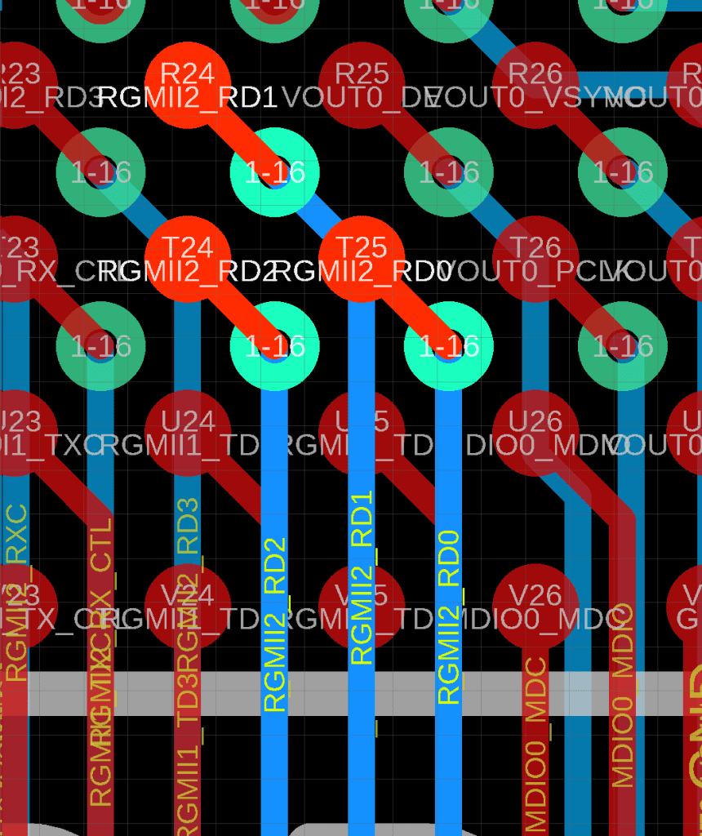
pcb/r2-mainboard/datasheets/SiC OSD62x-PM/OSD62x-PM Layout Guide _ Octavo Systems_files/Trace-Between-2-Vias-Under-OSD62x-PM-860x1024.png
