UavL/Glider/pcb/r2-mainboard/datasheets/SiC OSD62x-PM/OSD62x-PM Thermal Guide _ Octavo Systems_files/a-black-background-with-a-black-square-ai-generat.png

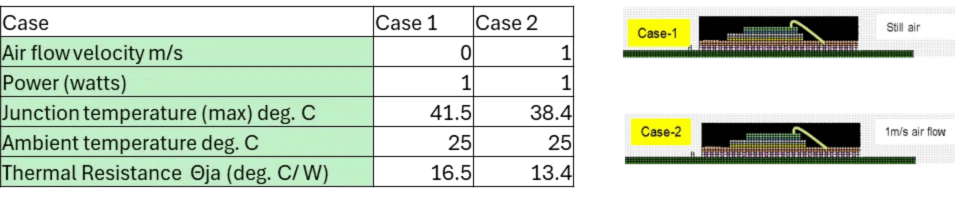
pcb/r2-mainboard/datasheets/SiC OSD62x-PM/OSD62x-PM Thermal Guide _ Octavo Systems_files/a-black-background-with-a-black-square-ai-generat.png
