UavL/Glider/pcb/r2-mainboard/datasheets/SiC OSD62x-PM/OSD62x-PM Thermal Guide _ Octavo Systems_files/a-close-up-of-a-circuit-board-ai-generated-conten-1-1.png

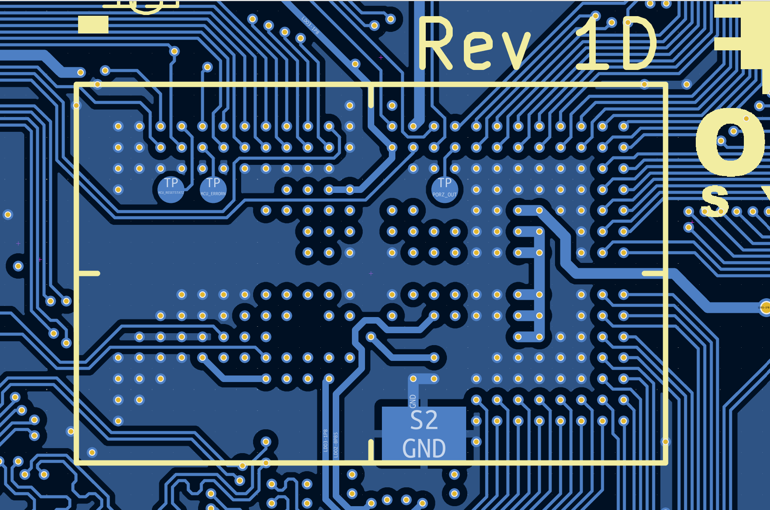
pcb/r2-mainboard/datasheets/SiC OSD62x-PM/OSD62x-PM Thermal Guide _ Octavo Systems_files/a-close-up-of-a-circuit-board-ai-generated-conten-1-1.png
