UavL/Glider/pcb/r2-mainboard/datasheets/SiC OSD62x-PM/OSD62x-PM Thermal Guide _ Octavo Systems_files/a-computer-chip-with-many-dots-and-lines-ai-gener-1-1.png

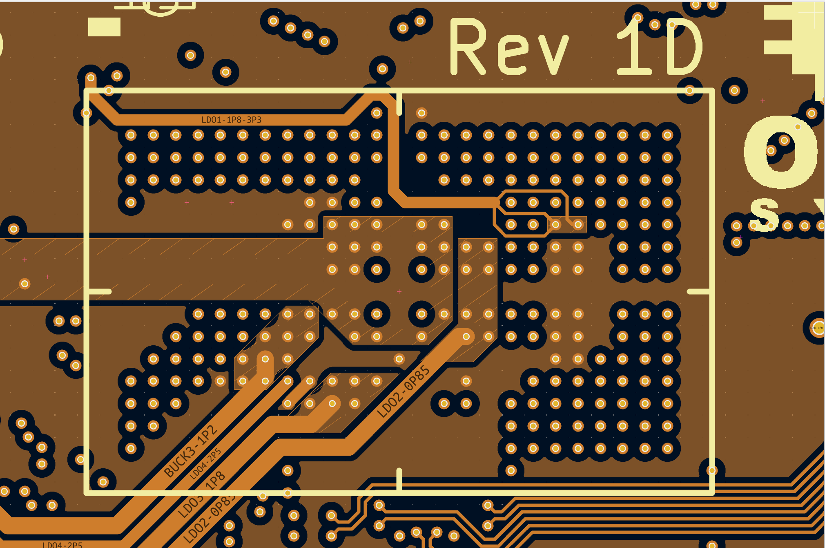
pcb/r2-mainboard/datasheets/SiC OSD62x-PM/OSD62x-PM Thermal Guide _ Octavo Systems_files/a-computer-chip-with-many-dots-and-lines-ai-gener-1-1.png
