UavL/Glider/pcb/r2-mainboard/datasheets/SiC OSD62x-PM/OSD62x-PM Thermal Guide _ Octavo Systems_files/a-red-circuit-board-with-black-and-gold-wires-ai-1.jpeg

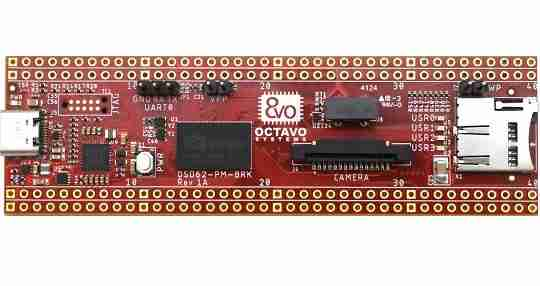
pcb/r2-mainboard/datasheets/SiC OSD62x-PM/OSD62x-PM Thermal Guide _ Octavo Systems_files/a-red-circuit-board-with-black-and-gold-wires-ai-1.jpeg
