UavL/Glider/pcb/r2-mainboard/datasheets/SiC OSD62x-PM/OSD62x-PM Thermal Guide _ Octavo Systems_files/diagram-of-a-diagram-showing-the-flow-of-a-heater-1.png

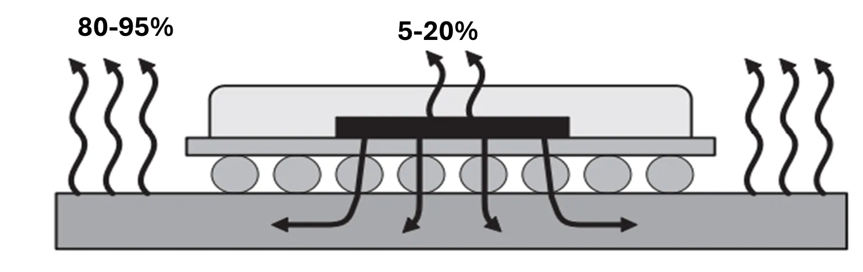
pcb/r2-mainboard/datasheets/SiC OSD62x-PM/OSD62x-PM Thermal Guide _ Octavo Systems_files/diagram-of-a-diagram-showing-the-flow-of-a-heater-1.png
