UavL/Glider/pcb/r2-mainboard/datasheets/SiC OSD62x-PM/OSD62-PM Boot Chain and Debug _ Octavo Systems_files/AM62x-SoC-boot-process.png

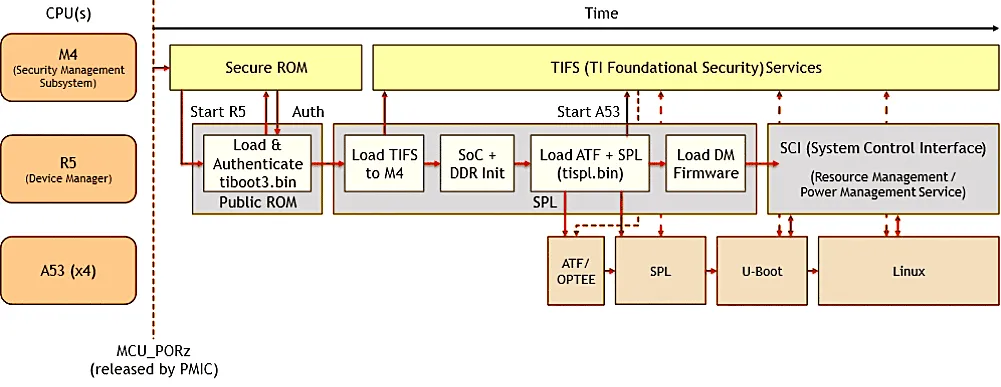
pcb/r2-mainboard/datasheets/SiC OSD62x-PM/OSD62-PM Boot Chain and Debug _ Octavo Systems_files/AM62x-SoC-boot-process.png
