UavL/Glider/pcb/r2-mainboard/visualisation/pcb-F_Cu.pdf

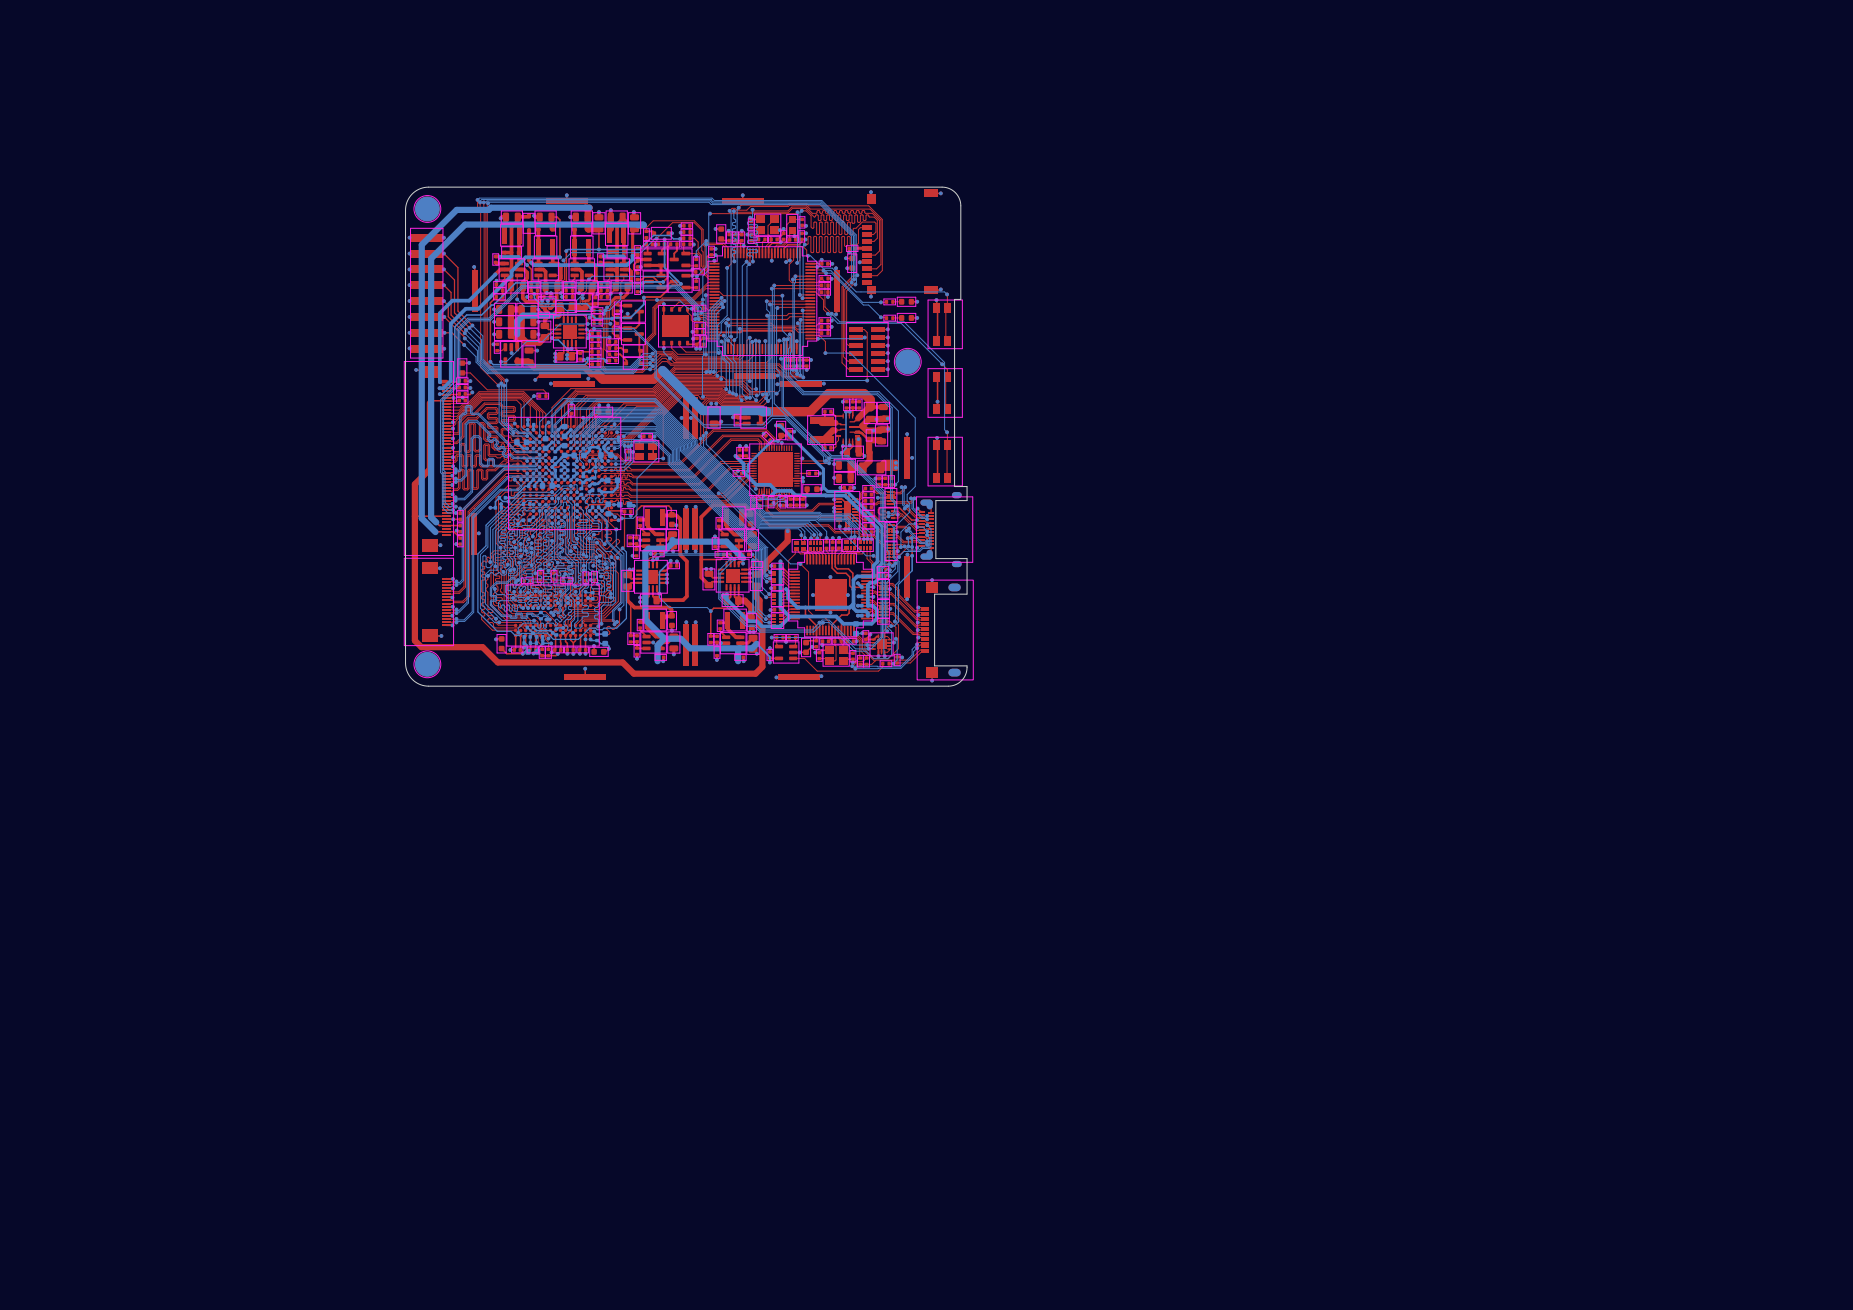
[picture p73: page 1]
