UavL/Glider/pcb/r2-mainboard/r2.kicad_pcb

## KiCad design pcb/r2-mainboard/r2.kicad_pcb (2026-09-11)

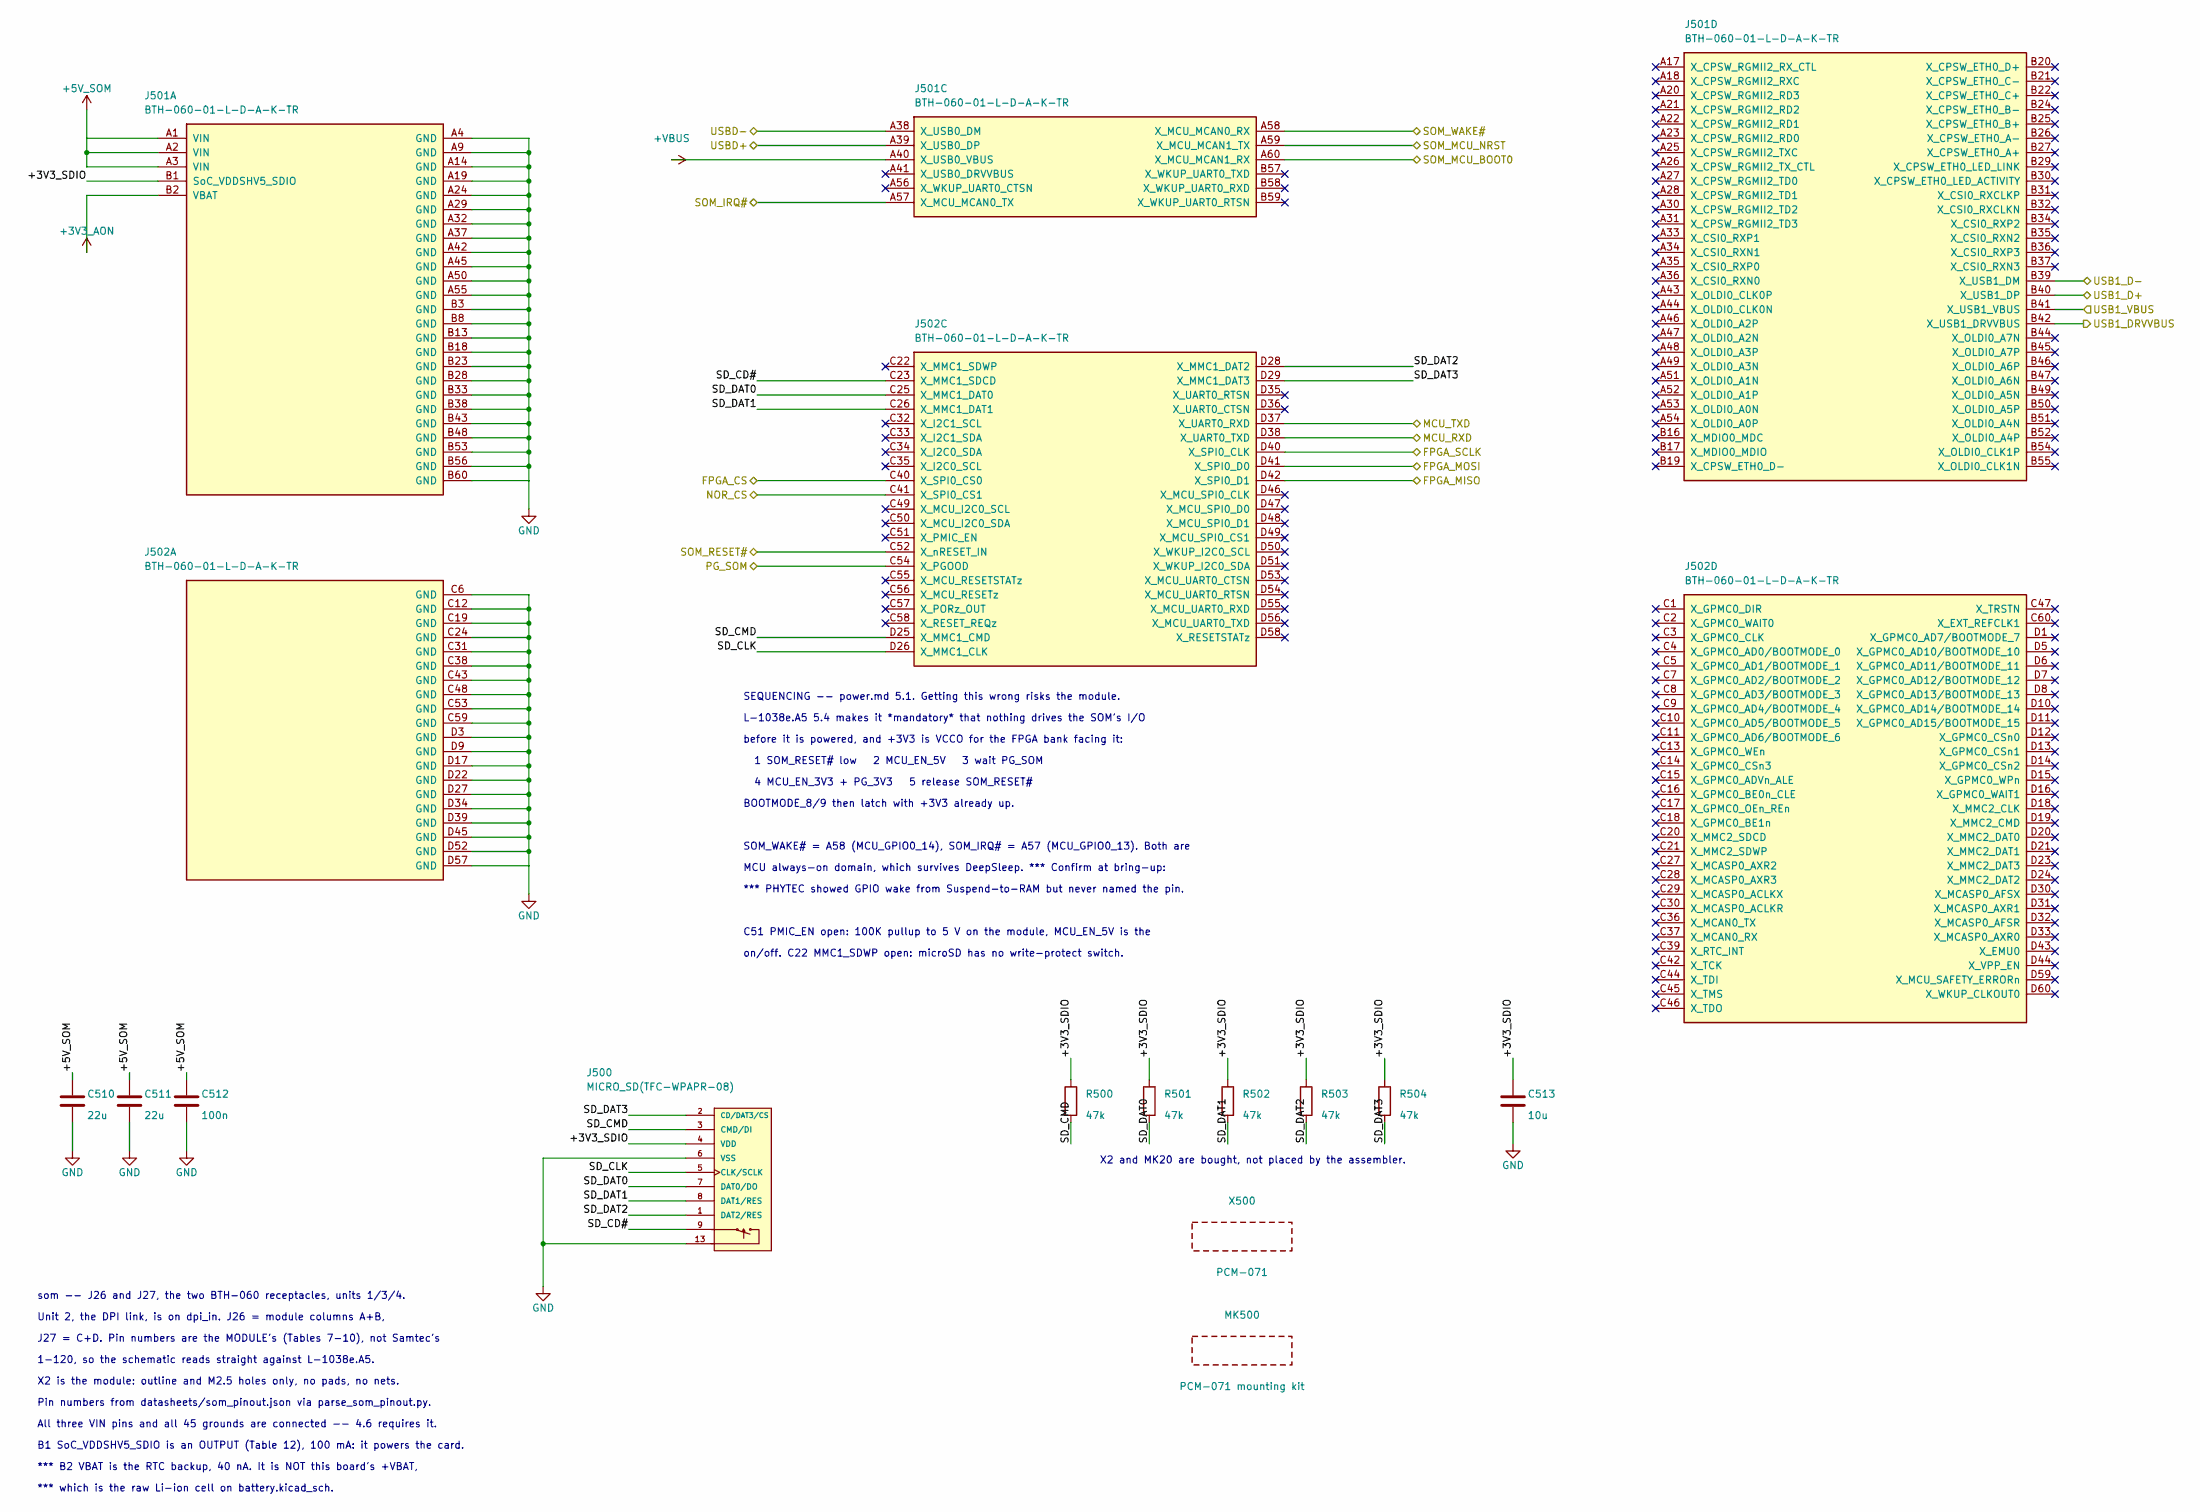
[picture p74: schematic som.kicad_sch, Glider-R2 / Reflow mainboard]

Parts:
C510, C511: 22u; C_0805_2012Metric
C512: 100n; C_0402_1005Metric
C513: 10u; C_0805_2012Metric
J500: MICRO_SD(TFC-WPAPR-08); TFC-WPAPR-08
J501: BTH-060-01-L-D-A-K-TR; BTH-060-01-L-D-A-K_AB; MPN BTH-060-01-L-D-A-K-TR; LCSC C3646540
J502: BTH-060-01-L-D-A-K-TR; BTH-060-01-L-D-A-K_CD; MPN BTH-060-01-L-D-A-K-TR; LCSC C3646540
MK500: PCM-071 mounting kit; MPN 2x M2.5x5 F-F standoff, 4x M2.5x4 screw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
R500, R501, R502, R503, R504: 47k; R_0402_1005Metric
X500: PCM-071; PCM-071_Module; MPN PCM-071

Connections:
+3V3_AON: J501.B2 (VBAT); also elsewhere on the board
+5V_SOM: C510.1, C511.1, C512.1, J501.A1 (VIN), J501.A2 (VIN), J501.A3 (VIN); also elsewhere on the board
+VBUS: J501.A40 (X_USB0_VBUS); also elsewhere on the board
/FPGA_CS: J502.C40 (X_SPI0_CS0); also elsewhere on the board
/FPGA_MISO: J502.D42 (X_SPI0_D1); also elsewhere on the board
/FPGA_MOSI: J502.D41 (X_SPI0_D0); also elsewhere on the board
/FPGA_SCLK: J502.D40 (X_SPI0_CLK); also elsewhere on the board
/MCU_RXD: J502.D38 (X_UART0_TXD); also elsewhere on the board
/MCU_TXD: J502.D37 (X_UART0_RXD); also elsewhere on the board
/NOR_CS: J502.C41 (X_SPI0_CS1); also elsewhere on the board
/PG_SOM: J502.C54 (X_PGOOD); also elsewhere on the board
/SOM_IRQ#: J501.A57 (X_MCU_MCAN0_TX); also elsewhere on the board
/SOM_MCU_BOOT0: J501.A60 (X_MCU_MCAN1_RX); also elsewhere on the board
/SOM_MCU_NRST: J501.A59 (X_MCU_MCAN1_TX); also elsewhere on the board
/SOM_RESET#: J502.C52 (X_nRESET_IN); also elsewhere on the board
/SOM_WAKE#: J501.A58 (X_MCU_MCAN0_RX); also elsewhere on the board
/USB1_D+: J501.B40 (X_USB1_DP); also elsewhere on the board
/USB1_D-: J501.B39 (X_USB1_DM); also elsewhere on the board
/USB1_DRVVBUS: J501.B42 (X_USB1_DRVVBUS); also elsewhere on the board
/USB1_VBUS: J501.B41 (X_USB1_VBUS); also elsewhere on the board
/USBD+: J501.A39 (X_USB0_DP); also elsewhere on the board
/USBD-: J501.A38 (X_USB0_DM); also elsewhere on the board
/som/+3V3_SDIO: C513.1, J500.4 (VDD), J501.B1 (SoC_VDDSHV5_SDIO), R500.1, R501.1, R502.1, R503.1, R504.1
/som/SD_CD#: J500.9, J502.C23 (X_MMC1_SDCD)
/som/SD_CLK: J500.5 (CLK/SCLK), J502.D26 (X_MMC1_CLK)
/som/SD_CMD: J500.3 (CMD/DI), J502.D25 (X_MMC1_CMD), R500.2
/som/SD_DAT0: J500.7 (DAT0/DO), J502.C25 (X_MMC1_DAT0), R501.2
/som/SD_DAT1: J500.8 (DAT1/RES), J502.C26 (X_MMC1_DAT1), R502.2
/som/SD_DAT2: J500.1 (DAT2/RES), J502.D28 (X_MMC1_DAT2), R503.2
/som/SD_DAT3: J500.2 (CD/DAT3/CS), J502.D29 (X_MMC1_DAT3), R504.2
GND: C510.2, C511.2, C512.2, C513.2, J500.6 (VSS), J500.10, J500.11, J500.12, J500.13, J501.A4 (GND), J501.A9 (GND), J501.A14 (GND), J501.A19 (GND), J501.A24 (GND), J501.A29 (GND), J501.A32 (GND), J501.A37 (GND), J501.A42 (GND), J501.A45 (GND), J501.A50 (GND), J501.A55 (GND), J501.B3 (GND), J501.B8 (GND), J501.B13 (GND), J501.B18 (GND), J501.B23 (GND), J501.B28 (GND), J501.B33 (GND), J501.B38 (GND), J501.B43 (GND), J501.B48 (GND), J501.B53 (GND), J501.B56 (GND), J501.B60 (GND), J502.C6 (GND), J502.C12 (GND), J502.C19 (GND), J502.C24 (GND), J502.C31 (GND), J502.C38 (GND), J502.C43 (GND), J502.C48 (GND), J502.C53 (GND), J502.C59 (GND), J502.D3 (GND), J502.D9 (GND), J502.D17 (GND), J502.D22 (GND), J502.D27 (GND), J502.D34 (GND), J502.D39 (GND), J502.D45 (GND), J502.D52 (GND), J502.D57 (GND); also elsewhere on the board

Notes on the sheet:
4 MCU_EN_3V3 + PG_3V3 5 release SOM_RESET#
*** B2 VBAT is the RTC backup, 40 nA. It is NOT this board's +VBAT,
MCU always-on domain, which survives DeepSleep. *** Confirm at bring-up:
BOOTMODE_8/9 then latch with +3V3 already up.
Unit 2, the DPI link, is on dpi_in. J26 = module columns A+B,
Pin numbers from datasheets/som_pinout.json via parse_som_pinout.py.
*** which is the raw Li-ion cell on battery.kicad_sch.
on/off. C22 MMC1_SDWP open: microSD has no write-protect switch.
before it is powered, and +3V3 is VCCO for the FPGA bank facing it:
SEQUENCING -- power.md 5.1. Getting this wrong risks the module.
X2 is the module: outline and M2.5 holes only, no pads, no nets.
B1 SoC_VDDSHV5_SDIO is an OUTPUT (Table 12), 100 mA: it powers the card.
J27 = C+D. Pin numbers are the MODULE's (Tables 7-10), not Samtec's
SOM_WAKE# = A58 (MCU_GPIO0_14), SOM_IRQ# = A57 (MCU_GPIO0_13). Both are
C51 PMIC_EN open: 100K pullup to 5 V on the module, MCU_EN_5V is the
som -- J26 and J27, the two BTH-060 receptacles, units 1/3/4.
1 SOM_RESET# low 2 MCU_EN_5V 3 wait PG_SOM
X2 and MK20 are bought, not placed by the assembler.
*** PHYTEC showed GPIO wake from Suspend-to-RAM but never named the pin.
All three VIN pins and all 45 grounds are connected -- 4.6 requires it.
1-120, so the schematic reads straight against L-1038e.A5.
L-1038e.A5 5.4 makes it *mandatory* that nothing drives the SOM's I/O

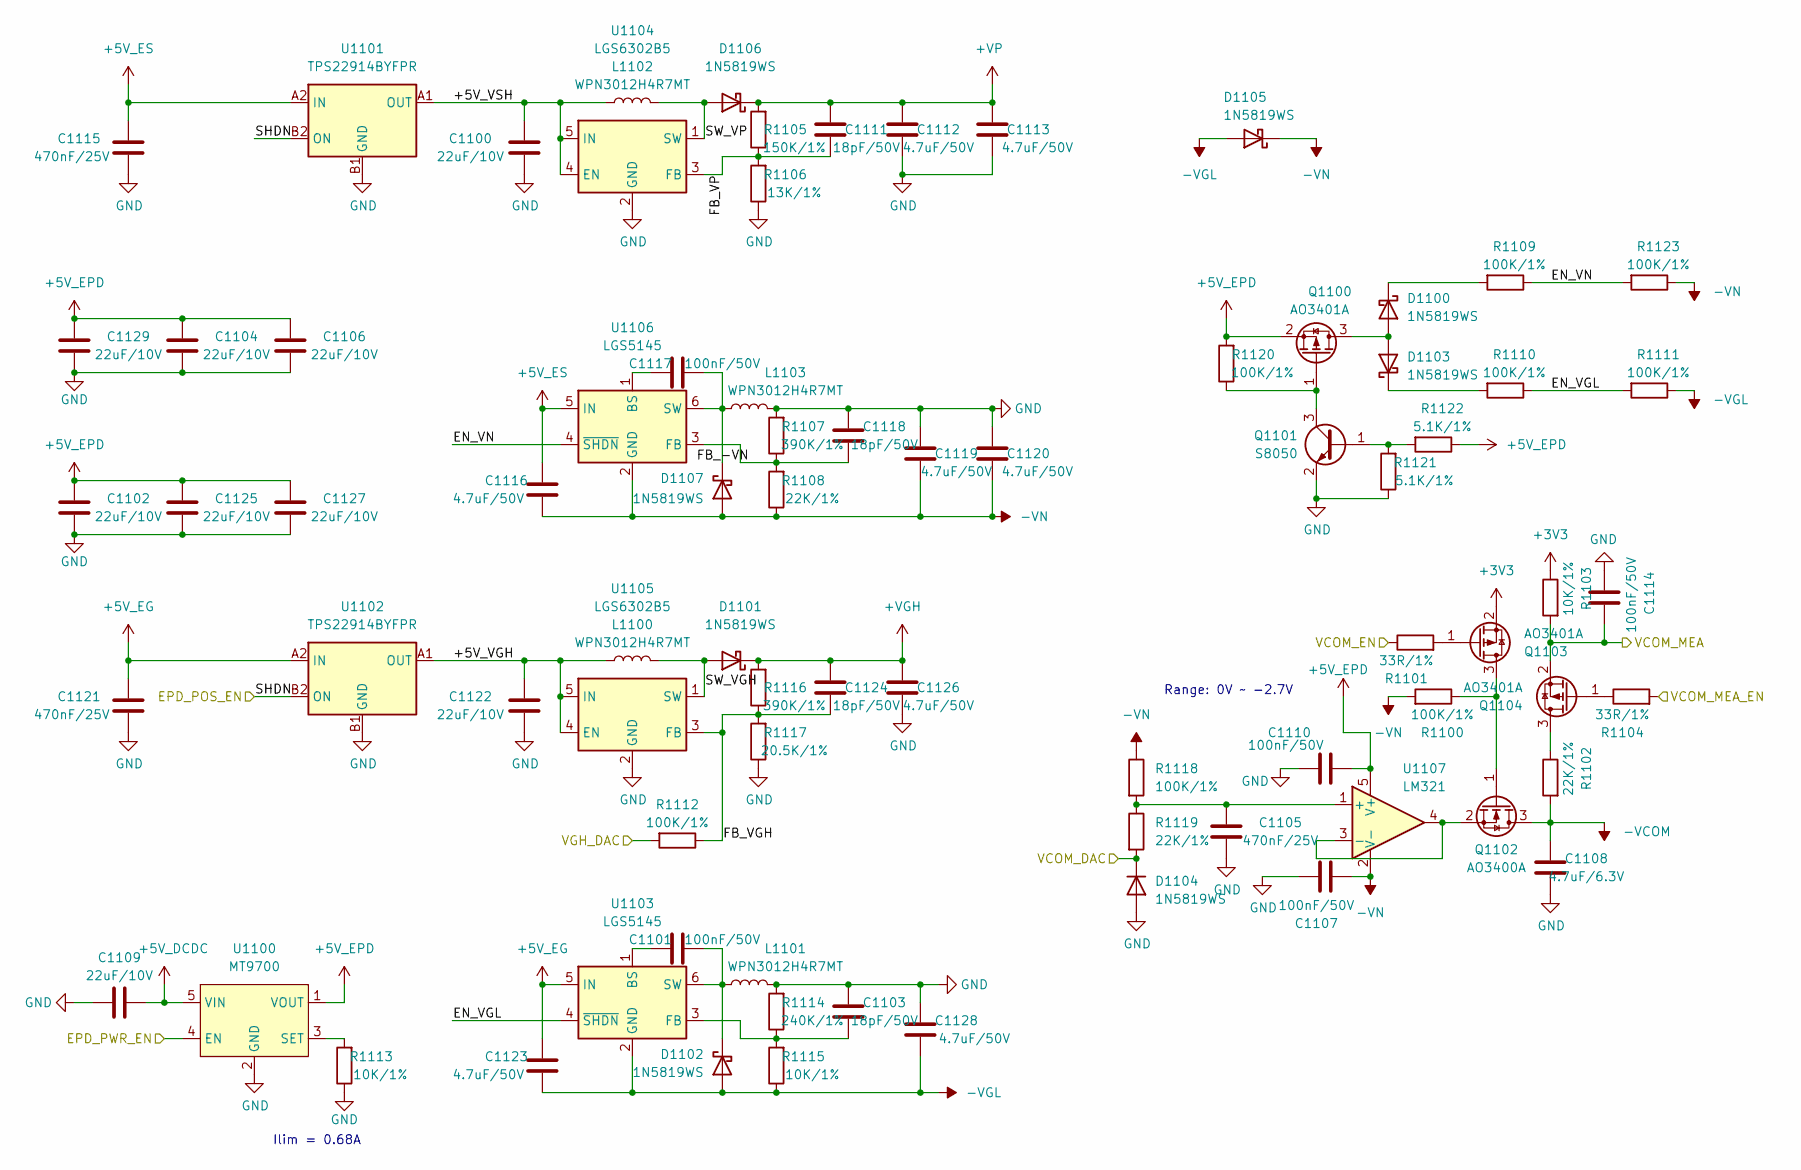
[picture p75: schematic epd_power.kicad_sch, Glider-R2 / Reflow mainboard]

Parts:
C1100, C1102, C1104, C1106, C1109, C1122, C1125, C1127, C1129: 22uF/10V; C_0805_2012Metric; MPN CL21A226MPQNNNE; LCSC C29277
C1101, C1107, C1110, C1114, C1117: 100nF/50V; C_0402_1005Metric; MPN CC0402KRX7R9BB104; LCSC C131394
C1103, C1111, C1118, C1124: 18pF/50V; C_0402_1005Metric; MPN CC0402JRNPO9BN180; LCSC C106202
C1105, C1115, C1121: 470nF/25V; C_0402_1005Metric; MPN CGA0402X5R474K250GT; LCSC C6119801
C1108: 4.7uF/6.3V; C_0402_1005Metric; MPN CL05A475MQ5NRNC; LCSC C307423
C1112, C1113, C1116, C1119, C1120, C1123, C1126, C1128: 4.7uF/50V; C_0805_2012Metric; MPN CGA0805X5R475K500MT; LCSC C6119903
D1100, D1101, D1102, D1103, D1105, D1106, D1107: 1N5819WS; D_SOD-323; MPN B5819WS; LCSC C488405
D1104: 1N5819WS; D_SOD-323_Alt; MPN B5819WS; LCSC C488405
L1100, L1101, L1102, L1103: WPN3012H4R7MT; L_Changjiang_FNR3012S; MPN WPN3012H4R7MT; LCSC C98357
Q1100, Q1103, Q1104: AO3401A; SOT-23; MPN AO3401A; LCSC C347476
Q1101: S8050; SOT-23; MPN S8050; LCSC C444723
Q1102: AO3400A; SOT-23; MPN AO3400A; LCSC C347475
R1100, R1109, R1110, R1111, R1112, R1118, R1120, R1123: 100K/1%; R_0402_1005Metric; MPN 0402WGF1003TCE; LCSC C25741
R1101, R1104: 33R/1%; R_0402_1005Metric; MPN 0402WGF330JTCE; LCSC C25105
R1102, R1108, R1119: 22K/1%; R_0402_1005Metric; MPN 0402WGF2202TCE; LCSC C25768
R1103, R1113, R1115: 10K/1%; R_0402_1005Metric; MPN 0402WGF1002TCE; LCSC C25744
R1105: 150K/1%; R_0402_1005Metric; MPN 0402WGF1503TCE; LCSC C25755
R1106: 13K/1%; R_0402_1005Metric; MPN 0402WGF1302TCE; LCSC C25754
R1107, R1116: 390K/1%; R_0402_1005Metric; MPN HRC0402F3903DNTO; LCSC C54920667
R1114: 240K/1%; R_0402_1005Metric; MPN 0402WGF2403TCE; LCSC C64043
R1117: 20.5K/1%; R_0402_1005Metric; MPN 0402WGF2052TCE; LCSC C57105
R1121, R1122: 5.1K/1%; R_0402_1005Metric; MPN 0402WGF5101TCE; LCSC C25905
U1100: MT9700; SOT-23-5; MPN MT9700; LCSC C89855
U1101, U1102: TPS22914BYFPR; WLCSP-4_0.89x0.89mm_Layout2x2_P0.5mm; MPN TPS22914BYFPR; LCSC C1848394
U1103, U1106: LGS5145; TSOT-23-6; MPN LGS5145; LCSC C5123971
U1104, U1105: LGS6302B5; SOT-23-5; MPN LGS6302B5; LCSC C5123975
U1107: LM321; SOT-23-5; MPN LM321MFX/NOPB; LCSC C9405

Connections:
+3V3: Q1103.2 (S), R1103.1; also elsewhere on the board
+5V_DCDC: C1109.2, U1100.5 (VIN); also elsewhere on the board
+5V_EG: C1121.1, C1123.2, U1102.A2 (IN), U1103.5 (IN); also elsewhere on the board
+5V_EPD: C1102.2, C1104.2, C1106.2, C1110.2, C1125.2, C1127.2, C1129.2, Q1100.2 (S), R1120.2, R1122.1, U1100.1 (VOUT), U1107.5 (V+); also elsewhere on the board
+5V_ES: C1115.1, C1116.2, U1101.A2 (IN), U1106.5 (IN); also elsewhere on the board
+VGH: C1124.2, C1126.2, D1101.1 (K), R1116.2; also elsewhere on the board
+VP: C1111.2, C1112.2, C1113.2, D1106.1 (K), R1105.2; also elsewhere on the board
-VCOM: C1108.2, Q1102.3 (D), R1102.2; also elsewhere on the board
-VGL: C1123.1, C1128.1, D1102.2 (A), D1105.2 (A), R1111.1, R1115.1, U1103.2 (GND); also elsewhere on the board
-VN: C1107.2, C1116.1, C1119.1, C1120.1, D1105.1 (K), D1107.2 (A), R1100.2, R1108.1, R1118.1, R1123.1, U1106.2 (GND), U1107.2 (V-); also elsewhere on the board
/EPD_POS_EN: U1101.B2 (ON), U1102.B2 (ON); also elsewhere on the board
/EPD_PWR_EN: U1100.4 (EN); also elsewhere on the board
/VCOM_DAC: D1104.1 (K), R1119.2; also elsewhere on the board
/VCOM_EN: R1101.1; also elsewhere on the board
/VCOM_MEA: C1114.2, Q1104.2 (S), R1103.2; also elsewhere on the board
/VCOM_MEA_EN: R1104.2; also elsewhere on the board
/VGH_DAC: R1112.2; also elsewhere on the board
/epd_power/+5V_VGH: C1122.2, L1100.1, U1102.A1 (OUT), U1105.4 (EN), U1105.5 (IN)
/epd_power/+5V_VSH: C1100.2, L1102.1, U1101.A1 (OUT), U1104.4 (EN), U1104.5 (IN)
/epd_power/EN_VGL: R1110.1, R1111.2, U1103.4 (~SHDN)
/epd_power/EN_VN: R1109.1, R1123.2, U1106.4 (~SHDN)
/epd_power/FB_-VN: C1118.1, R1107.1, R1108.2, U1106.3 (FB)
/epd_power/FB_VGH: C1124.1, R1112.1, R1116.1, R1117.2, U1105.3 (FB)
/epd_power/FB_VP: C1111.1, R1105.1, R1106.2, U1104.3 (FB)
/epd_power/SW_VGH: D1101.2 (A), L1100.2, U1105.1 (SW)
/epd_power/SW_VP: D1106.2 (A), L1102.2, U1104.1 (SW)
GND: C1100.1, C1102.1, C1103.2, C1104.1, C1105.1, C1106.1, C1107.1, C1108.1, C1109.1, C1110.1, C1112.1, C1113.1, C1114.1, C1115.2, C1118.2, C1119.2, C1120.2, C1121.2, C1122.1, C1125.1, C1126.1, C1127.1, C1128.2, C1129.1, D1104.2 (A), L1101.2, L1103.2, Q1101.2 (E), R1106.1, R1107.2, R1113.1, R1114.2, R1117.1, R1121.1, U1100.2 (GND), U1101.B1 (GND), U1102.B1 (GND), U1104.2 (GND), U1105.2 (GND); also elsewhere on the board
unnamed: D1100.2 (A), D1103.2 (A), Q1100.3 (D)
unnamed: D1100.1 (K), R1109.2
unnamed: C1101.1, D1102.1 (K), L1101.1, U1103.6 (SW)
unnamed: D1103.1 (K), R1110.2
unnamed: C1117.1, D1107.1 (K), L1103.1, U1106.6 (SW)
unnamed: Q1100.1 (G), Q1101.3 (C), R1120.1
unnamed: Q1101.1 (B), R1121.2, R1122.2
unnamed: Q1102.1 (G), Q1103.3 (D), R1100.1
unnamed: Q1102.2 (S), U1107.3 (-), U1107.4
unnamed: Q1103.1 (G), R1101.2
unnamed: Q1104.3 (D), R1102.1
unnamed: Q1104.1 (G), R1104.1
unnamed: R1113.2, U1100.3 (SET)
unnamed: C1101.2, U1103.1 (BS)
unnamed: C1103.1, R1114.1, R1115.2, U1103.3 (FB)
unnamed: C1117.2, U1106.1 (BS)
unnamed: C1105.2, R1118.2, R1119.1, U1107.1 (+)

Notes on the sheet:
Ilim = 0.68A
Range: 0V ~ -2.7V

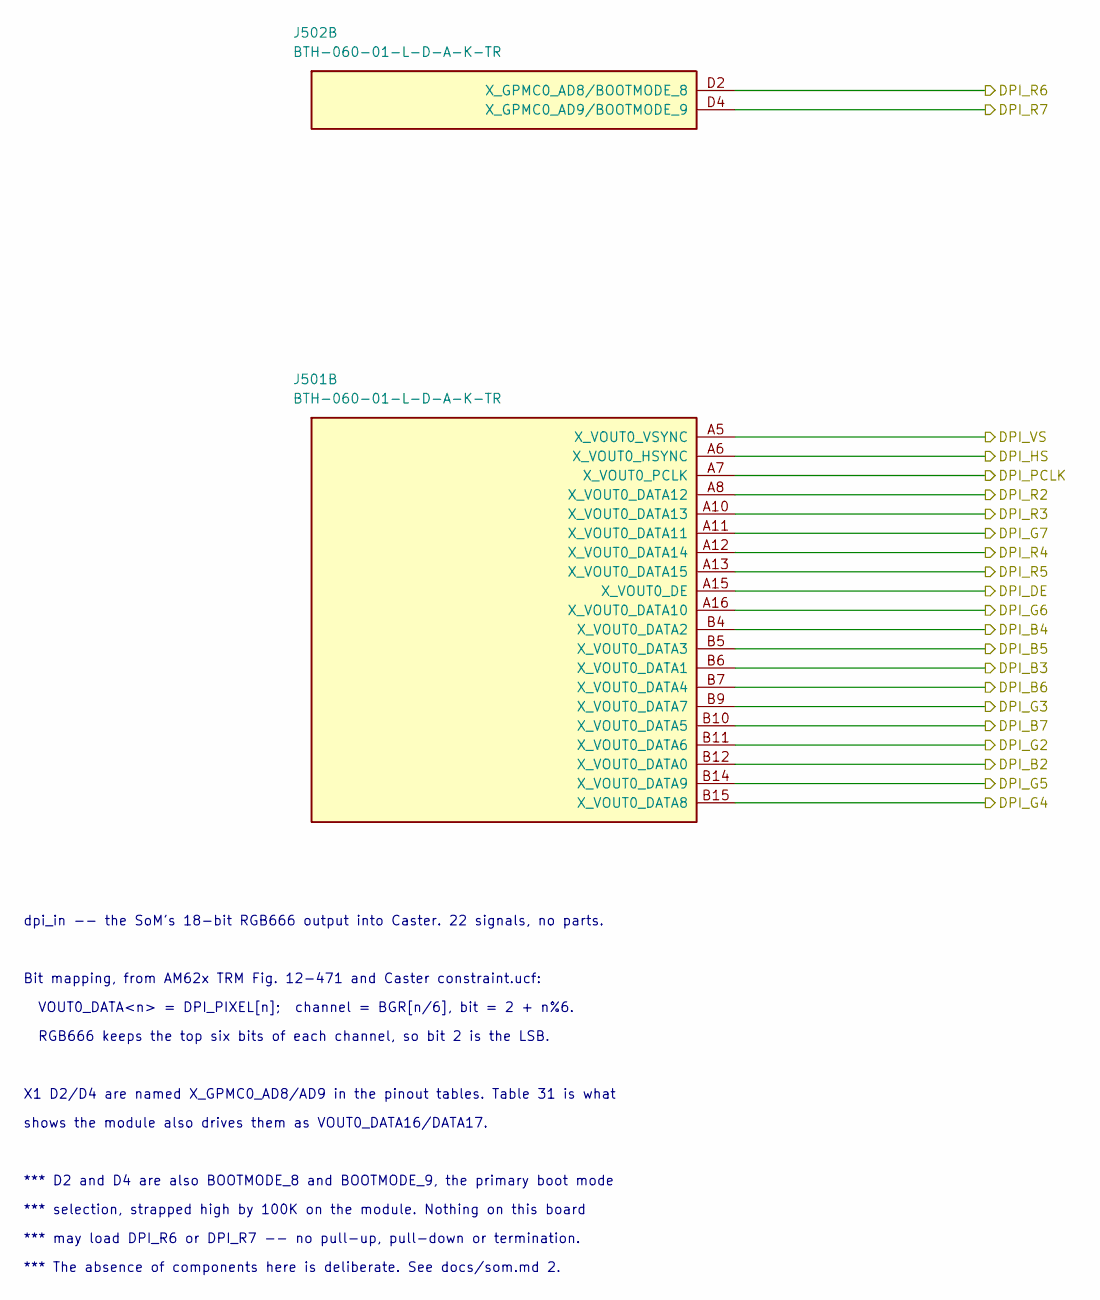
[picture p76: schematic dpi_in.kicad_sch, Glider-R2 / Reflow mainboard]

Parts:
J501: BTH-060-01-L-D-A-K-TR; BTH-060-01-L-D-A-K_AB; MPN BTH-060-01-L-D-A-K-TR; LCSC C3646540
J502: BTH-060-01-L-D-A-K-TR; BTH-060-01-L-D-A-K_CD; MPN BTH-060-01-L-D-A-K-TR; LCSC C3646540

Connections:
/DPI_B2: J501.B12 (X_VOUT0_DATA0); also elsewhere on the board
/DPI_B3: J501.B6 (X_VOUT0_DATA1); also elsewhere on the board
/DPI_B4: J501.B4 (X_VOUT0_DATA2); also elsewhere on the board
/DPI_B5: J501.B5 (X_VOUT0_DATA3); also elsewhere on the board
/DPI_B6: J501.B7 (X_VOUT0_DATA4); also elsewhere on the board
/DPI_B7: J501.B10 (X_VOUT0_DATA5); also elsewhere on the board
/DPI_DE: J501.A15 (X_VOUT0_DE); also elsewhere on the board
/DPI_G2: J501.B11 (X_VOUT0_DATA6); also elsewhere on the board
/DPI_G3: J501.B9 (X_VOUT0_DATA7); also elsewhere on the board
/DPI_G4: J501.B15 (X_VOUT0_DATA8); also elsewhere on the board
/DPI_G5: J501.B14 (X_VOUT0_DATA9); also elsewhere on the board
/DPI_G6: J501.A16 (X_VOUT0_DATA10); also elsewhere on the board
/DPI_G7: J501.A11 (X_VOUT0_DATA11); also elsewhere on the board
/DPI_HS: J501.A6 (X_VOUT0_HSYNC); also elsewhere on the board
/DPI_PCLK: J501.A7 (X_VOUT0_PCLK); also elsewhere on the board
/DPI_R2: J501.A8 (X_VOUT0_DATA12); also elsewhere on the board
/DPI_R3: J501.A10 (X_VOUT0_DATA13); also elsewhere on the board
/DPI_R4: J501.A12 (X_VOUT0_DATA14); also elsewhere on the board
/DPI_R5: J501.A13 (X_VOUT0_DATA15); also elsewhere on the board
/DPI_R6: J502.D2 (X_GPMC0_AD8/BOOTMODE_8); also elsewhere on the board
/DPI_R7: J502.D4 (X_GPMC0_AD9/BOOTMODE_9); also elsewhere on the board
/DPI_VS: J501.A5 (X_VOUT0_VSYNC); also elsewhere on the board

Notes on the sheet:
dpi_in -- the SoM's 18-bit RGB666 output into Caster. 22 signals, no parts.
*** The absence of components here is deliberate. See docs/som.md 2.
RGB666 keeps the top six bits of each channel, so bit 2 is the LSB.
*** may load DPI_R6 or DPI_R7 -- no pull-up, pull-down or termination.
shows the module also drives them as VOUT0_DATA16/DATA17.
VOUT0_DATA<n> = DPI_PIXEL[n]; channel = BGR[n/6], bit = 2 + n%6.
X1 D2/D4 are named X_GPMC0_AD8/AD9 in the pinout tables. Table 31 is what
Bit mapping, from AM62x TRM Fig. 12-471 and Caster constraint.ucf:
*** selection, strapped high by 100K on the module. Nothing on this board
*** D2 and D4 are also BOOTMODE_8 and BOOTMODE_9, the primary boot mode

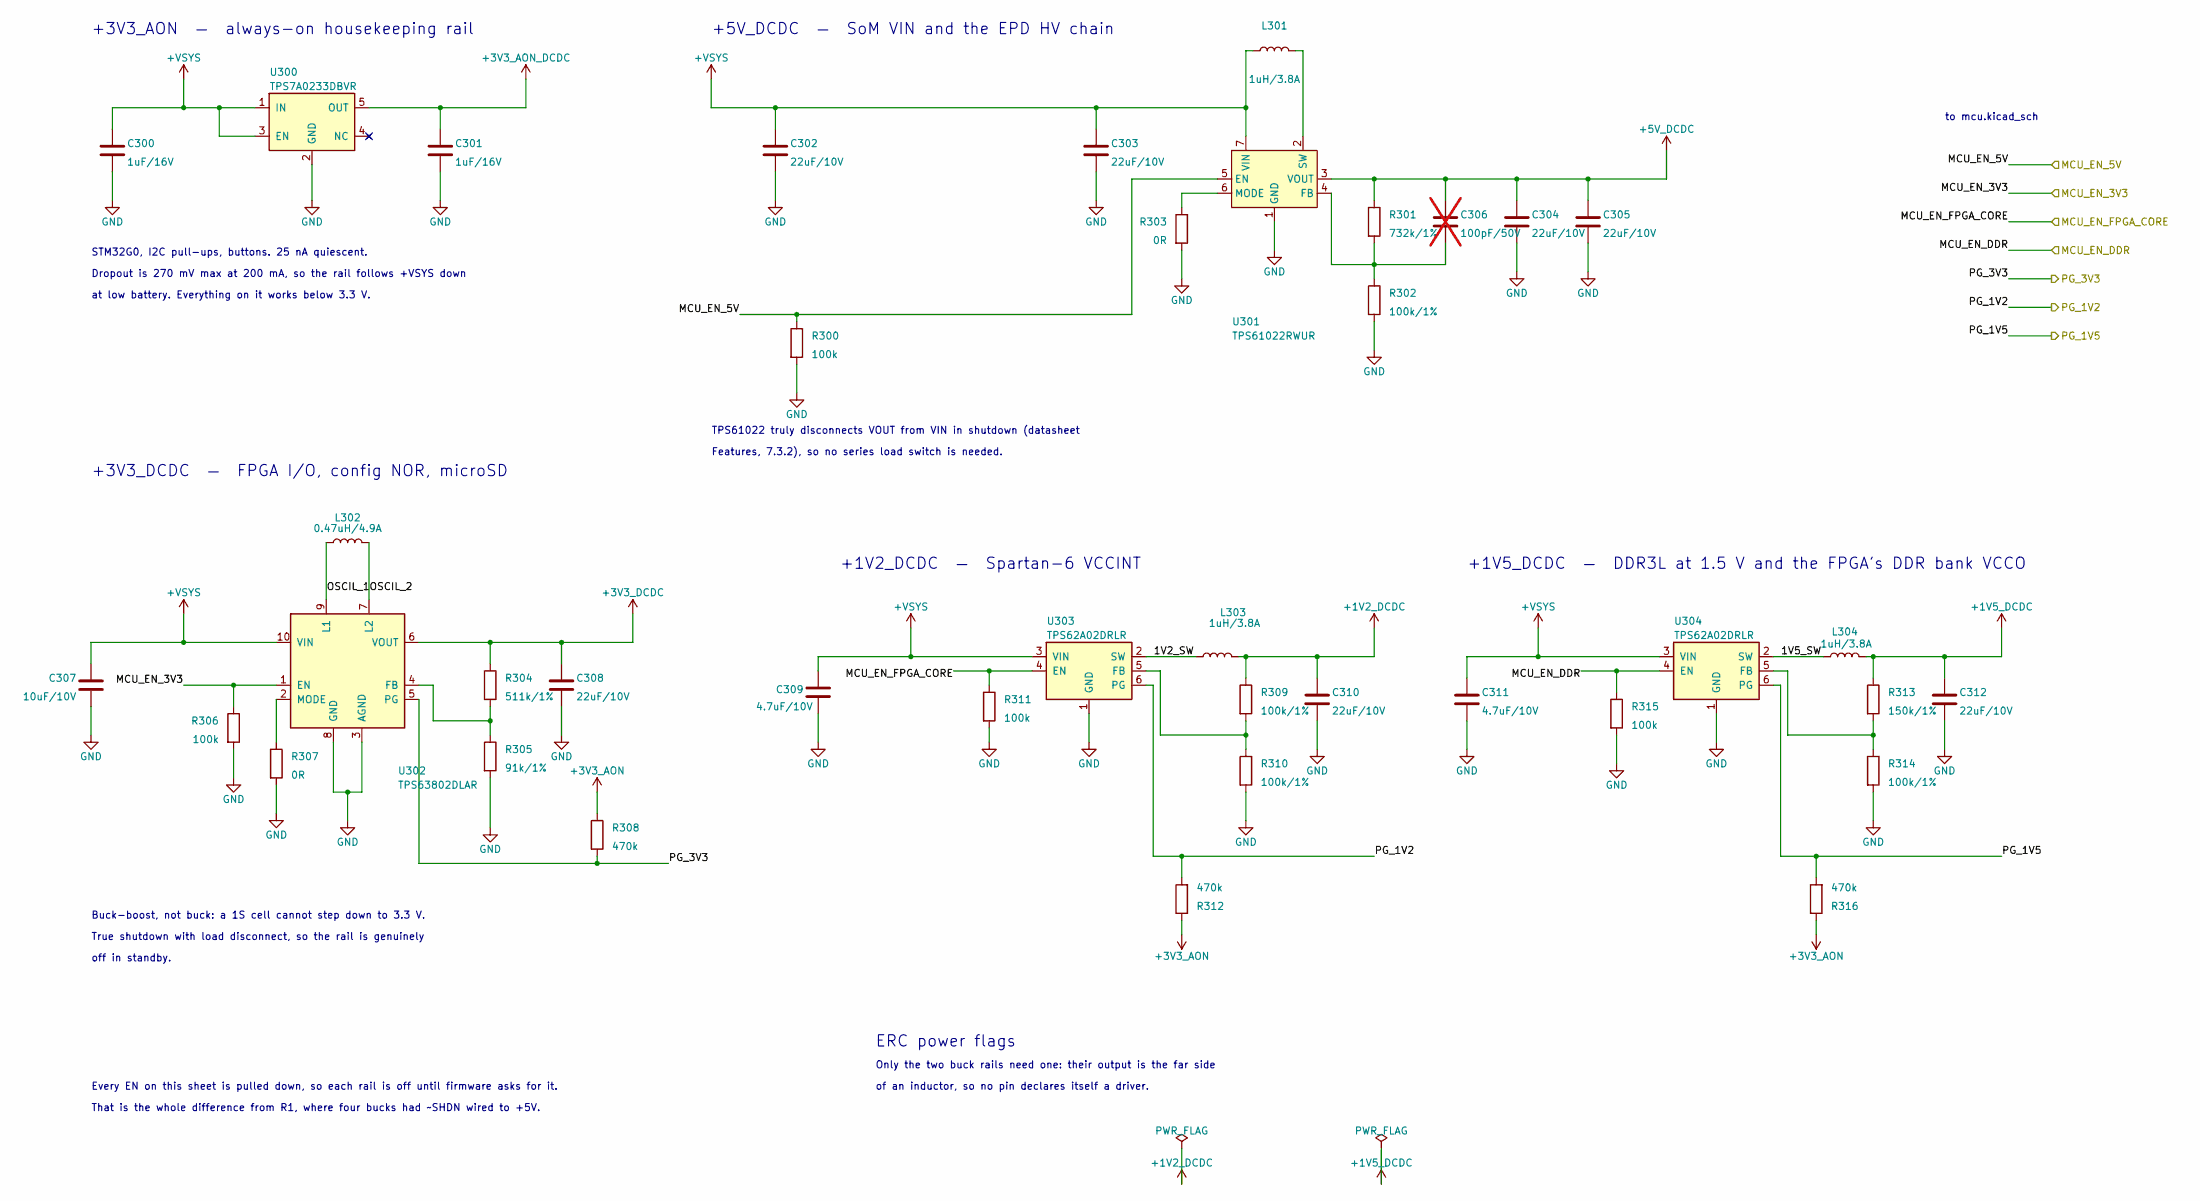
[picture p77: schematic power.kicad_sch, Glider-R2 / Reflow mainboard]

Parts:
C300, C301: 1uF/16V; C_0402_1005Metric
C302, C303, C304, C305, C308, C310, C312: 22uF/10V; C_0805_2012Metric; MPN CL21A226MPQNNNE
C306: 100pF/50V; C_0402_1005Metric; not fitted
C307: 10uF/10V; C_0805_2012Metric
C309, C311: 4.7uF/10V; C_0805_2012Metric
L301, L303, L304: 1uH/3.8A; L_1210_3225Metric; MPN DFE322512F-1R0M; LCSC C3224227
L302: 0.47uH/4.9A; L_1008_2520Metric; MPN DFE252012F-R47M; LCSC C703140
R300, R306, R311, R315: 100k; R_0402_1005Metric
R301: 732k/1%; R_0402_1005Metric
R302, R309, R310, R314: 100k/1%; R_0402_1005Metric
R303, R307: 0R; R_0402_1005Metric
R304: 511k/1%; R_0402_1005Metric
R305: 91k/1%; R_0402_1005Metric
R308, R312, R316: 470k; R_0402_1005Metric
R313: 150k/1%; R_0402_1005Metric
U300: TPS7A0233DBVR; SOT-23-5; MPN TPS7A0233DBVR; LCSC C5142805
U301: TPS61022RWUR; Texas_RWU0007A_VQFN-7_2x2mm_P0.5mm; MPN TPS61022RWUR; LCSC C915088
U302: TPS63802DLAR; Texas_DLA0010A_VSON-HR-10_2x3mm_P0.5mm; MPN TPS63802DLAR; LCSC C2845237
U303, U304: TPS62A02DRLR; SOT-563; MPN TPS62A02DRLR; LCSC C5350187

Connections:
+1V2_DCDC: C310.1, L303.2, R309.1; also elsewhere on the board
+1V5_DCDC: C312.1, L304.2, R313.1; also elsewhere on the board
+3V3_AON: R308.1, R312.1, R316.1; also elsewhere on the board
+3V3_AON_DCDC: C301.1, U300.5 (OUT); also elsewhere on the board
+3V3_DCDC: C308.1, R304.1, U302.6 (VOUT); also elsewhere on the board
+5V_DCDC: C304.1, C305.1, C306.1, R301.1, U301.3 (VOUT); also elsewhere on the board
+VSYS: C300.1, C302.1, C303.1, C307.1, C309.1, C311.1, L301.1, U300.1 (IN), U300.3 (EN), U301.7 (VIN), U302.10 (VIN), U303.3 (VIN), U304.3 (VIN); also elsewhere on the board
/MCU_EN_3V3: R306.1, U302.1 (EN); also elsewhere on the board
/MCU_EN_5V: R300.1, U301.5 (EN); also elsewhere on the board
/MCU_EN_DDR: R315.1, U304.4 (EN); also elsewhere on the board
/MCU_EN_FPGA_CORE: R311.1, U303.4 (EN); also elsewhere on the board
/PG_1V2: R312.2, U303.6 (PG); also elsewhere on the board
/PG_1V5: R316.2, U304.6 (PG); also elsewhere on the board
/PG_3V3: R308.2, U302.5 (PG); also elsewhere on the board
/power/1V2_SW: L303.1, U303.2 (SW)
/power/1V5_SW: L304.1, U304.2 (SW)
/power/OSCIL_1: L302.1, U302.9 (L1)
/power/OSCIL_2: L302.2, U302.7 (L2)
GND: C300.2, C301.2, C302.2, C303.2, C304.2, C305.2, C307.2, C308.2, C309.2, C310.2, C311.2, C312.2, R300.2, R302.2, R303.2, R305.2, R306.2, R307.2, R310.2, R311.2, R314.2, R315.2, U300.2 (GND), U301.1 (GND), U302.3 (AGND), U302.8 (GND), U303.1 (GND), U304.1 (GND); also elsewhere on the board
unnamed: C306.2, R301.2, R302.1, U301.4 (FB)
unnamed: R303.1, U301.6 (MODE)
unnamed: L301.2, U301.2 (SW)
unnamed: R304.2, R305.1, U302.4 (FB)
unnamed: R307.1, U302.2 (MODE)
unnamed: R309.2, R310.1, U303.5 (FB)
unnamed: R313.2, R314.1, U304.5 (FB)

Notes on the sheet:
+5V_DCDC — SoM VIN and the EPD HV chain
off in standby.
at low battery. Everything on it works below 3.3 V.
to mcu.kicad_sch
True shutdown with load disconnect, so the rail is genuinely
Dropout is 270 mV max at 200 mA, so the rail follows +VSYS down
TPS61022 truly disconnects VOUT from VIN in shutdown (datasheet
+3V3_AON — always-on housekeeping rail
STM32G0, I2C pull-ups, buttons. 25 nA quiescent.
Every EN on this sheet is pulled down, so each rail is off until firmware asks for it.
Features, 7.3.2), so no series load switch is needed.
+1V5_DCDC — DDR3L at 1.5 V and the FPGA's DDR bank VCCO
ERC power flags
Buck-boost, not buck: a 1S cell cannot step down to 3.3 V.
+1V2_DCDC — Spartan-6 VCCINT
Only the two buck rails need one: their output is the far side
That is the whole difference from R1, where four bucks had ~SHDN wired to +5V.
of an inductor, so no pin declares itself a driver.
+3V3_DCDC — FPGA I/O, config NOR, microSD

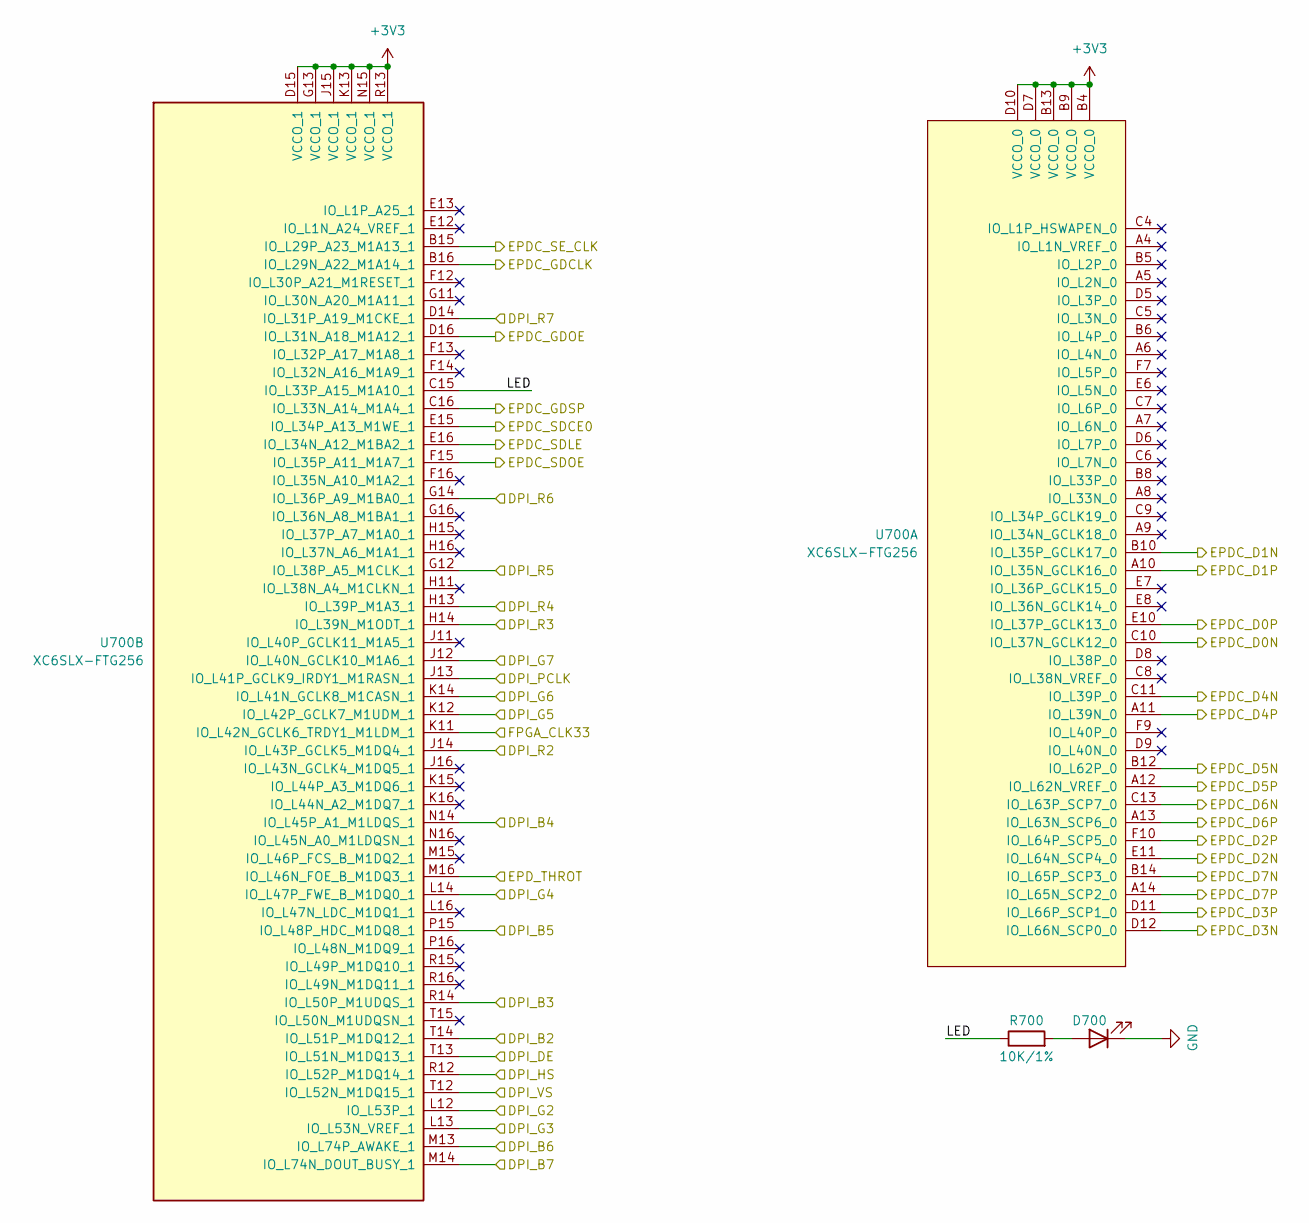
[picture p78: schematic fpga_io.kicad_sch, Glider-R2 / Reflow mainboard]

Parts:
D700: LED GREEN; LED_0603_1608Metric; MPN XL-1608UGC-04; LCSC C965804
R700: 10K/1%; R_0402_1005Metric; MPN 0402WGF1002TCE; LCSC C25744
U700: XC6SLX-FTG256; Xilinx_FTG256; MPN XC6SLX16-2FTG256C; LCSC C39313

Connections:
+3V3: U700.B4 (VCCO_0), U700.B9 (VCCO_0), U700.B13 (VCCO_0), U700.D7 (VCCO_0), U700.D10 (VCCO_0), U700.D15 (VCCO_1), U700.G13 (VCCO_1), U700.J15 (VCCO_1), U700.K13 (VCCO_1), U700.N15 (VCCO_1), U700.R13 (VCCO_1); also elsewhere on the board
/DPI_B2: U700.T14 (IO_L51P_M1DQ12_1); also elsewhere on the board
/DPI_B3: U700.R14 (IO_L50P_M1UDQS_1); also elsewhere on the board
/DPI_B4: U700.N14 (IO_L45P_A1_M1LDQS_1); also elsewhere on the board
/DPI_B5: U700.P15 (IO_L48P_HDC_M1DQ8_1); also elsewhere on the board
/DPI_B6: U700.M13 (IO_L74P_AWAKE_1); also elsewhere on the board
/DPI_B7: U700.M14 (IO_L74N_DOUT_BUSY_1); also elsewhere on the board
/DPI_DE: U700.T13 (IO_L51N_M1DQ13_1); also elsewhere on the board
/DPI_G2: U700.L12 (IO_L53P_1); also elsewhere on the board
/DPI_G3: U700.L13 (IO_L53N_VREF_1); also elsewhere on the board
/DPI_G4: U700.L14 (IO_L47P_FWE_B_M1DQ0_1); also elsewhere on the board
/DPI_G5: U700.K12 (IO_L42P_GCLK7_M1UDM_1); also elsewhere on the board
/DPI_G6: U700.K14 (IO_L41N_GCLK8_M1CASN_1); also elsewhere on the board
/DPI_G7: U700.J12 (IO_L40N_GCLK10_M1A6_1); also elsewhere on the board
/DPI_HS: U700.R12 (IO_L52P_M1DQ14_1); also elsewhere on the board
/DPI_PCLK: U700.J13 (IO_L41P_GCLK9_IRDY1_M1RASN_1); also elsewhere on the board
/DPI_R2: U700.J14 (IO_L43P_GCLK5_M1DQ4_1); also elsewhere on the board
/DPI_R3: U700.H14 (IO_L39N_M1ODT_1); also elsewhere on the board
/DPI_R4: U700.H13 (IO_L39P_M1A3_1); also elsewhere on the board
/DPI_R5: U700.G12 (IO_L38P_A5_M1CLK_1); also elsewhere on the board
/DPI_R6: U700.G14 (IO_L36P_A9_M1BA0_1); also elsewhere on the board
/DPI_R7: U700.D14 (IO_L31P_A19_M1CKE_1); also elsewhere on the board
/DPI_VS: U700.T12 (IO_L52N_M1DQ15_1); also elsewhere on the board
/EPDC_D0N: U700.C10 (IO_L37N_GCLK12_0); also elsewhere on the board
/EPDC_D0P: U700.E10 (IO_L37P_GCLK13_0); also elsewhere on the board
/EPDC_D1N: U700.B10 (IO_L35P_GCLK17_0); also elsewhere on the board
/EPDC_D1P: U700.A10 (IO_L35N_GCLK16_0); also elsewhere on the board
/EPDC_D2N: U700.E11 (IO_L64N_SCP4_0); also elsewhere on the board
/EPDC_D2P: U700.F10 (IO_L64P_SCP5_0); also elsewhere on the board
/EPDC_D3N: U700.D12 (IO_L66N_SCP0_0); also elsewhere on the board
/EPDC_D3P: U700.D11 (IO_L66P_SCP1_0); also elsewhere on the board
/EPDC_D4N: U700.C11 (IO_L39P_0); also elsewhere on the board
/EPDC_D4P: U700.A11 (IO_L39N_0); also elsewhere on the board
/EPDC_D5N: U700.B12 (IO_L62P_0); also elsewhere on the board
/EPDC_D5P: U700.A12 (IO_L62N_VREF_0); also elsewhere on the board
/EPDC_D6N: U700.C13 (IO_L63P_SCP7_0); also elsewhere on the board
/EPDC_D6P: U700.A13 (IO_L63N_SCP6_0); also elsewhere on the board
/EPDC_D7N: U700.B14 (IO_L65P_SCP3_0); also elsewhere on the board
/EPDC_D7P: U700.A14 (IO_L65N_SCP2_0); also elsewhere on the board
/EPDC_GDCLK: U700.B16 (IO_L29N_A22_M1A14_1); also elsewhere on the board
/EPDC_GDOE: U700.D16 (IO_L31N_A18_M1A12_1); also elsewhere on the board
/EPDC_GDSP: U700.C16 (IO_L33N_A14_M1A4_1); also elsewhere on the board
/EPDC_SDCE0: U700.E15 (IO_L34P_A13_M1WE_1); also elsewhere on the board
/EPDC_SDLE: U700.E16 (IO_L34N_A12_M1BA2_1); also elsewhere on the board
/EPDC_SDOE: U700.F15 (IO_L35P_A11_M1A7_1); also elsewhere on the board
/EPDC_SE_CLK: U700.B15 (IO_L29P_A23_M1A13_1); also elsewhere on the board
/EPD_THROT: U700.M16 (IO_L46N_FOE_B_M1DQ3_1); also elsewhere on the board
/FPGA_CLK33: U700.K11 (IO_L42N_GCLK6_TRDY1_M1LDM_1); also elsewhere on the board
/fpga_io/LED: R700.1, U700.C15 (IO_L33P_A15_M1A10_1)
GND: D700.1 (K); also elsewhere on the board
unnamed: D700.2 (A), R700.2
