UavL/Glider/pcb/r2-mainboard/r2.kicad_pcb

## KiCad design pcb/r2-mainboard/r2.kicad_pcb (continued)

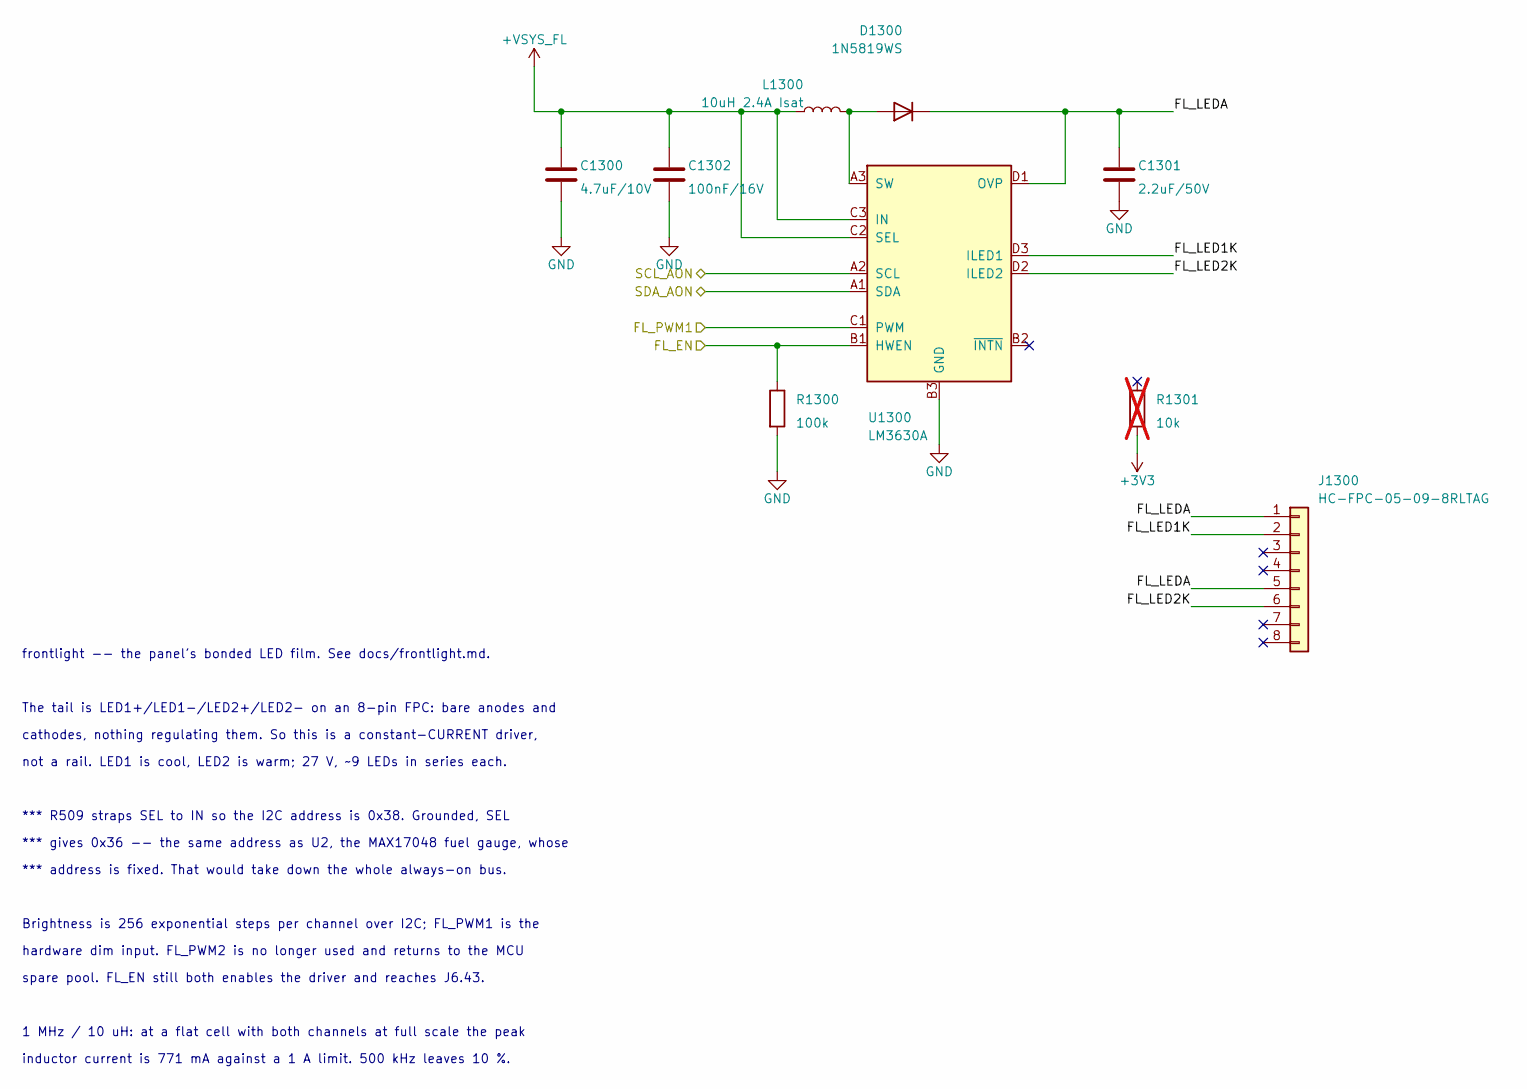
[picture p79: schematic frontlight.kicad_sch, Glider-R2 / Reflow mainboard]

Parts:
C1300: 4.7uF/10V; C_0603_1608Metric
C1301: 2.2uF/50V; C_0805_2012Metric
C1302: 100nF/16V; C_0402_1005Metric
D1300: 1N5819WS; D_SOD-323_Alt; MPN B5819WS; LCSC C488405
J1300: HC-FPC-05-09-8RLTAG; HC-FPC-05-09-8RLTAG_Mirrored; MPN HC-FPC-05-09-8RLTAG; LCSC C5213749
L1300: 10uH 2.4A Isat; L_Changjiang_FNR4030S; MPN FNR4030S100MT; LCSC C167879
R1300: 100k; R_0402_1005Metric
R1301: 10k; R_0402_1005Metric; not fitted
U1300: LM3630A; Texas_YFQ0012_DSBGA-12_1.91x1.39mm_Layout3x4_P0.4mm; MPN LM3630ATMX; LCSC C2678552

Connections:
+VSYS_FL: C1300.1, C1302.1, L1300.1, U1300.C2 (SEL), U1300.C3 (IN); also elsewhere on the board
/FL_EN: R1300.1, U1300.B1 (HWEN); also elsewhere on the board
/FL_PWM1: U1300.C1 (PWM); also elsewhere on the board
/SCL_AON: U1300.A2 (SCL); also elsewhere on the board
/SDA_AON: U1300.A1 (SDA); also elsewhere on the board
/frontlight/FL_LED1K: J1300.2, U1300.D3 (ILED1)
/frontlight/FL_LED2K: J1300.6, U1300.D2 (ILED2)
/frontlight/FL_LEDA: C1301.1, D1300.1 (K), J1300.1, J1300.5, U1300.D1 (OVP)
GND: C1300.2, C1301.2, C1302.2, R1300.2, U1300.B3 (GND); also elsewhere on the board
unnamed: D1300.2 (A), L1300.2, U1300.A3 (SW)

Notes on the sheet:
Brightness is 256 exponential steps per channel over I2C; FL_PWM1 is the
spare pool. FL_EN still both enables the driver and reaches J6.43.
cathodes, nothing regulating them. So this is a constant-CURRENT driver,
hardware dim input. FL_PWM2 is no longer used and returns to the MCU
*** address is fixed. That would take down the whole always-on bus.
1 MHz / 10 uH: at a flat cell with both channels at full scale the peak
*** R509 straps SEL to IN so the I2C address is 0x38. Grounded, SEL
The tail is LED1+/LED1-/LED2+/LED2- on an 8-pin FPC: bare anodes and
*** gives 0x36 -- the same address as U2, the MAX17048 fuel gauge, whose
not a rail. LED1 is cool, LED2 is warm; 27 V, ~9 LEDs in series each.
frontlight -- the panel's bonded LED film. See docs/frontlight.md.
inductor current is 771 mA against a 1 A limit. 500 kHz leaves 10 %.

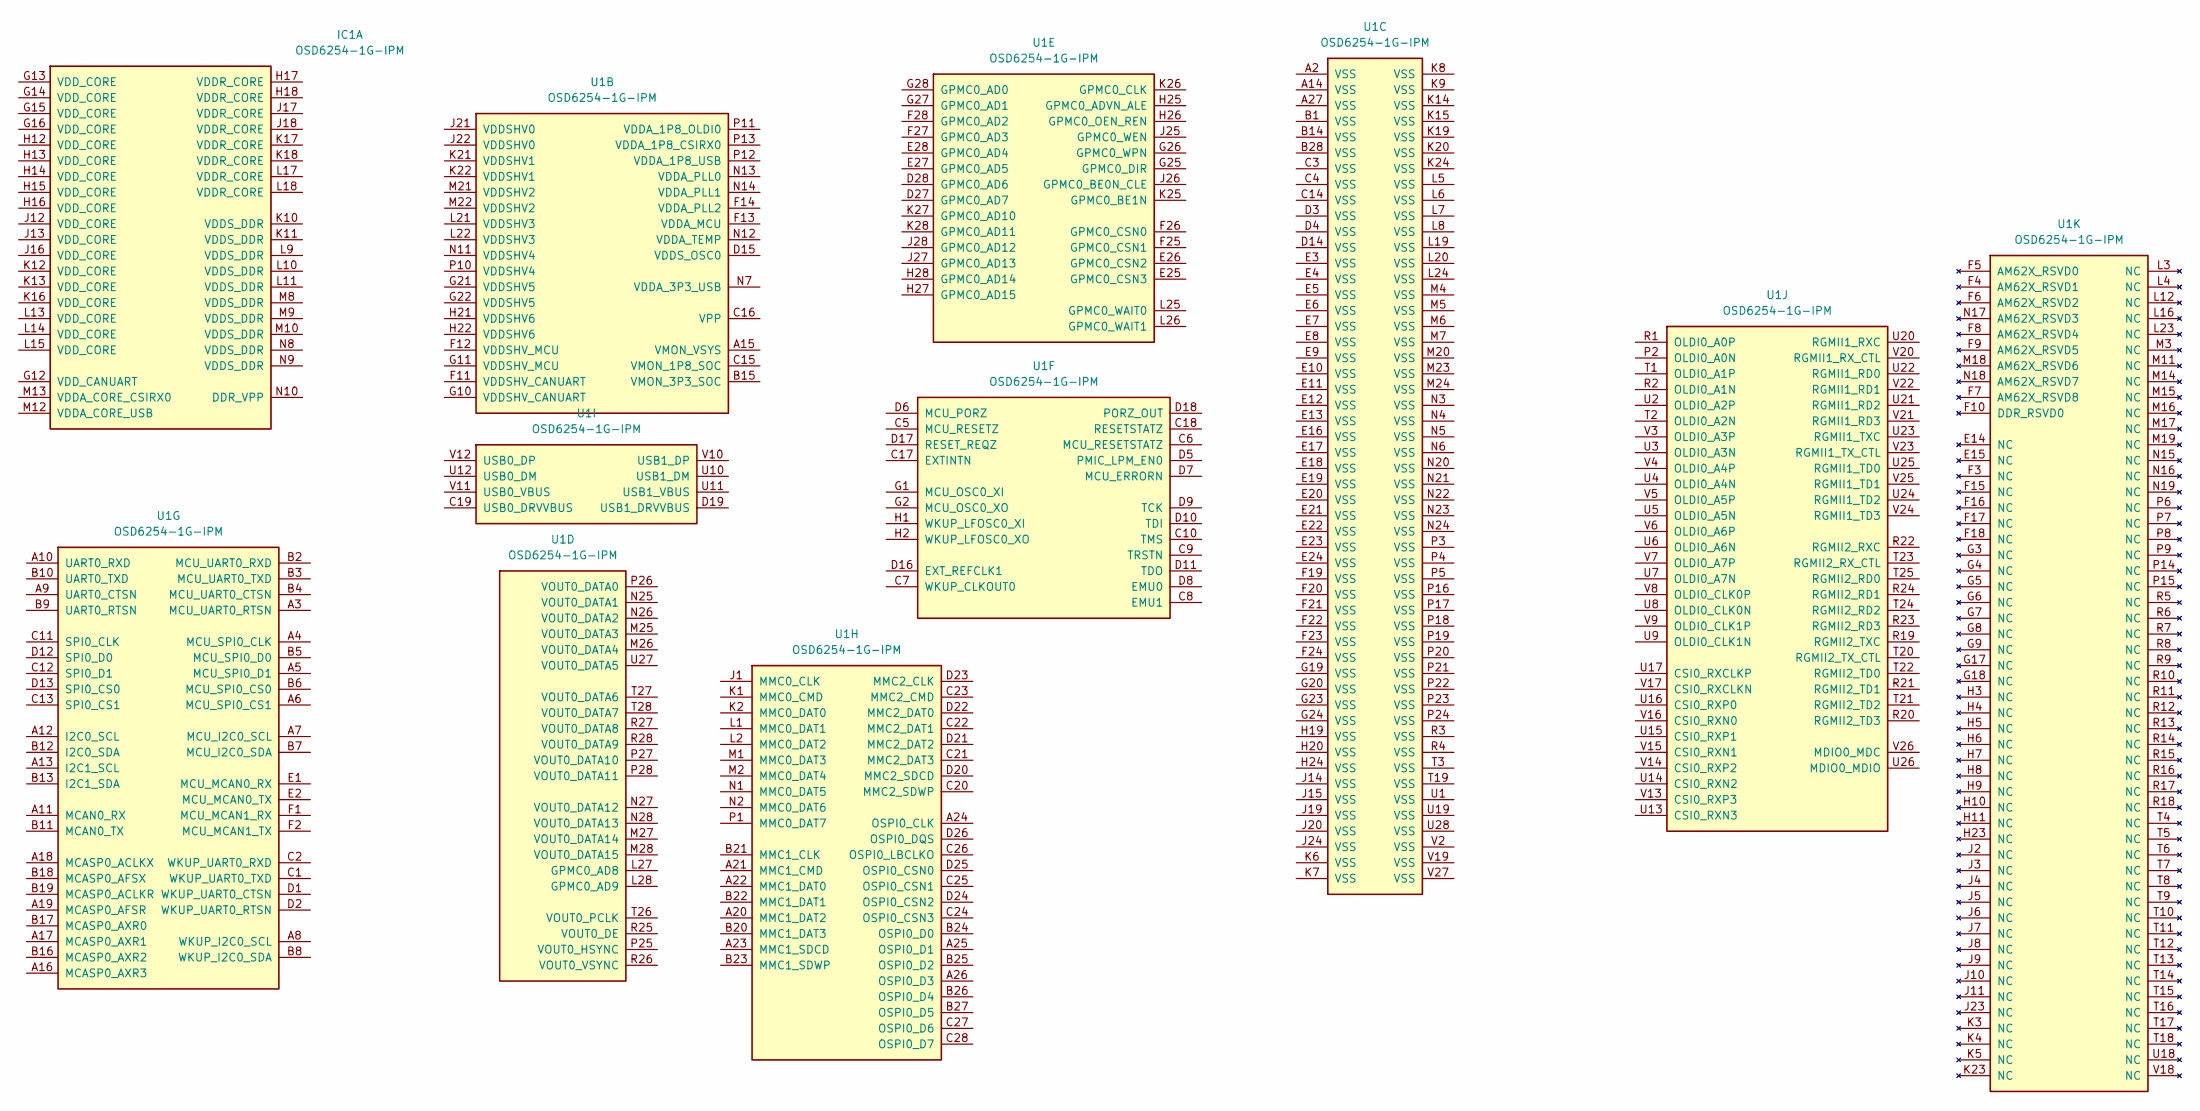
[picture p80: schematic sic.kicad_sch]

Parts:
IC1: OSD6254-1G-IPM; BGA500C50P28X18_1400X900X130; Manufacturer_Part_Number OSD6254-1G-IPM
U1: OSD6254-1G-IPM; BGA500C50P28X18_1400X900X130; Manufacturer_Part_Number OSD6254-1G-IPM

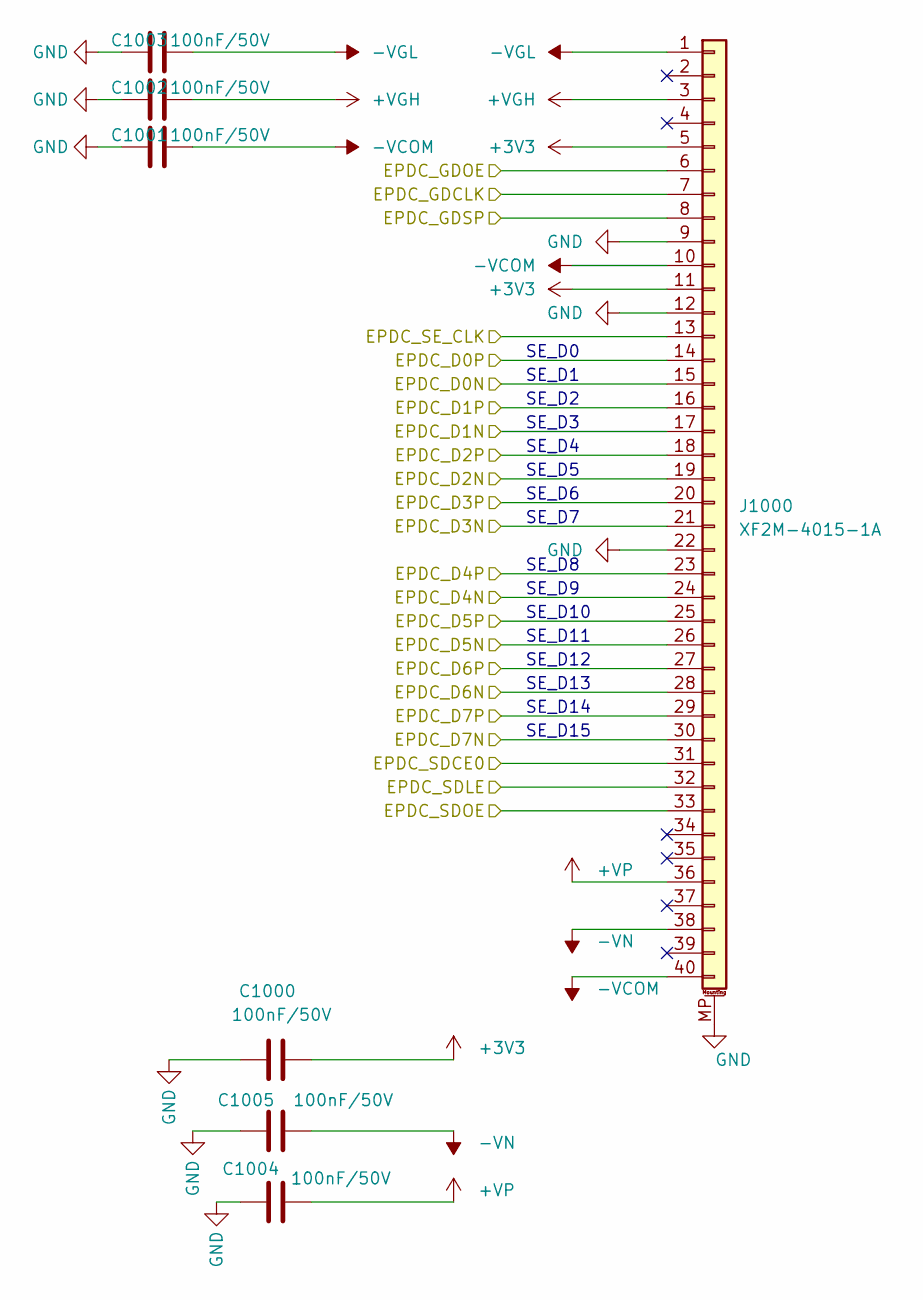
[picture p81: schematic epd.kicad_sch, Glider-R2 / Reflow mainboard]

Parts:
C1000, C1001, C1002, C1003, C1004, C1005: 100nF/50V; C_0402_1005Metric; MPN CC0402KRX7R9BB104; LCSC C131394
J1000: XF2M-4015-1A; Omron_XF2M-4015-1A_1x40-1MP_P0.5mm_Horizontal_Mirrored; MPN XF2M-4015-1A; LCSC C225713

Connections:
+3V3: C1000.1, J1000.5, J1000.11; also elsewhere on the board
+VGH: C1002.1, J1000.3; also elsewhere on the board
+VP: C1004.1, J1000.36; also elsewhere on the board
-VCOM: C1001.1, J1000.10, J1000.40; also elsewhere on the board
-VGL: C1003.1, J1000.1; also elsewhere on the board
-VN: C1005.1, J1000.38; also elsewhere on the board
/EPDC_D0N: J1000.15; also elsewhere on the board
/EPDC_D0P: J1000.14; also elsewhere on the board
/EPDC_D1N: J1000.17; also elsewhere on the board
/EPDC_D1P: J1000.16; also elsewhere on the board
/EPDC_D2N: J1000.19; also elsewhere on the board
/EPDC_D2P: J1000.18; also elsewhere on the board
/EPDC_D3N: J1000.21; also elsewhere on the board
/EPDC_D3P: J1000.20; also elsewhere on the board
/EPDC_D4N: J1000.24; also elsewhere on the board
/EPDC_D4P: J1000.23; also elsewhere on the board
/EPDC_D5N: J1000.26; also elsewhere on the board
/EPDC_D5P: J1000.25; also elsewhere on the board
/EPDC_D6N: J1000.28; also elsewhere on the board
/EPDC_D6P: J1000.27; also elsewhere on the board
/EPDC_D7N: J1000.30; also elsewhere on the board
/EPDC_D7P: J1000.29; also elsewhere on the board
/EPDC_GDCLK: J1000.7; also elsewhere on the board
/EPDC_GDOE: J1000.6; also elsewhere on the board
/EPDC_GDSP: J1000.8; also elsewhere on the board
/EPDC_SDCE0: J1000.31; also elsewhere on the board
/EPDC_SDLE: J1000.32; also elsewhere on the board
/EPDC_SDOE: J1000.33; also elsewhere on the board
/EPDC_SE_CLK: J1000.13; also elsewhere on the board
GND: C1000.2, C1001.2, C1002.2, C1003.2, C1004.2, C1005.2, J1000.9, J1000.12, J1000.22, J1000.MP (MountPin); also elsewhere on the board

Notes on the sheet:
SE_D0
SE_D13
SE_D8
SE_D14
SE_D11
SE_D9
SE_D10
SE_D5
SE_D1
SE_D7
SE_D12
SE_D3
SE_D4
SE_D6
SE_D15
SE_D2

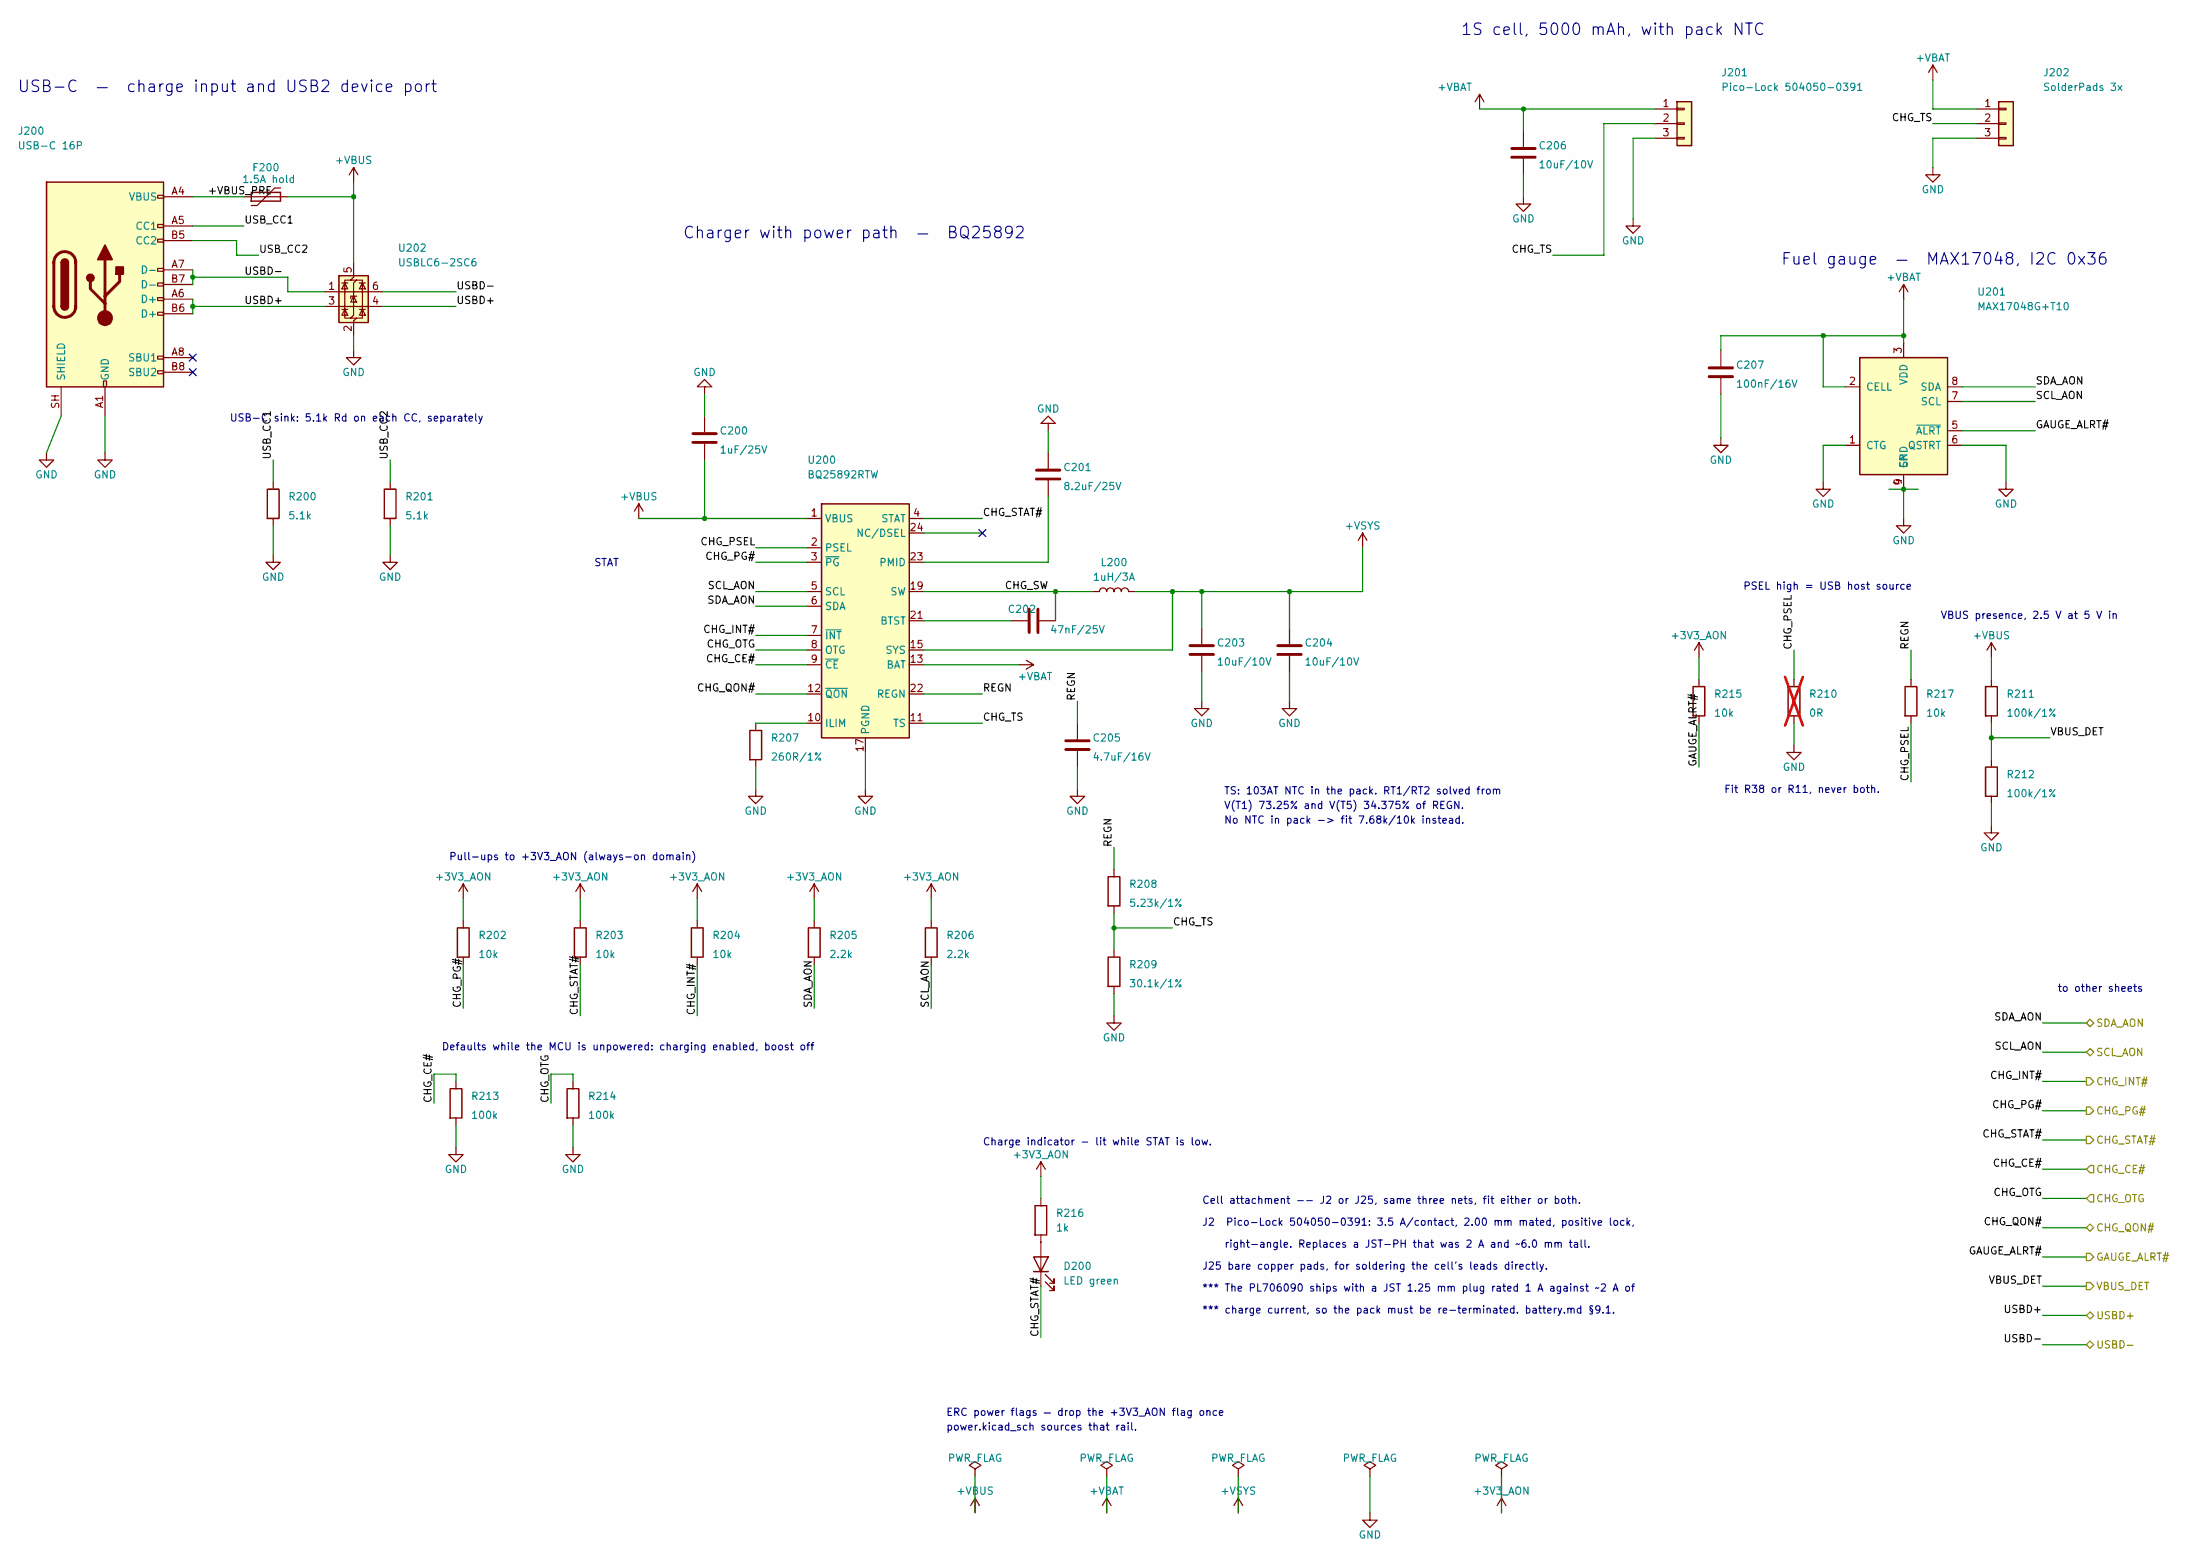
[picture p82: schematic battery.kicad_sch, Glider-R2 / Reflow mainboard]

Parts:
C200: 1uF/25V; C_0402_1005Metric
C201: 8.2uF/25V; C_0805_2012Metric
C202: 47nF/25V; C_0402_1005Metric
C203, C204, C206: 10uF/10V; C_0402_1005Metric
C205: 4.7uF/16V; C_0603_1608Metric
C207: 100nF/16V; C_0402_1005Metric
D200: LED green; LED_0603_1608Metric
F200: 1.5A hold; R_1206_3216Metric
J200: USB-C 16P; USB_C_Receptacle_HRO_TYPE-C-31-M-12; MPN TYPE-C-31-M-12; LCSC C165948
J201: Pico-Lock 504050-0391; Molex_Pico-Lock_504050-0391_1x03-1MP_P1.50mm_Horizontal
J202: SolderPads 3x; SolderPads_1x03_P3.50mm_Wire
L200: 1uH/3A; L_Taiyo-Yuden_NR-30xx
R200, R201: 5.1k; R_0402_1005Metric
R202, R203, R204, R215, R217: 10k; R_0402_1005Metric
R205, R206: 2.2k; R_0402_1005Metric
R207: 260R/1%; R_0402_1005Metric
R208: 5.23k/1%; R_0402_1005Metric
R209: 30.1k/1%; R_0402_1005Metric
R210: 0R; R_0402_1005Metric; not fitted
R211, R212: 100k/1%; R_0402_1005Metric
R213, R214: 100k; R_0402_1005Metric
R216: 1k; R_0402_1005Metric
U200: BQ25892RTW; Texas_RTW_WQFN-24-1EP_4x4mm_P0.5mm_EP2.7x2.7mm_ThermalVias; MPN BQ25892RTWR; LCSC C165480
U201: MAX17048G+T10; TDFN-8-1EP_2x2mm_P0.5mm_EP0.8x1.2mm; MPN MAX17048G+T10; LCSC C2682616
U202: USBLC6-2SC6; SOT-23-6; MPN USBLC6-2SC6; LCSC C7519

Connections:
+3V3_AON: R202.1, R203.1, R204.1, R205.1, R206.1, R215.1, R216.1; also elsewhere on the board
+VBAT: C206.1, C207.1, J201.1, J202.1, U200.13 (BAT), U200.14 (BAT), U201.2 (CELL), U201.3 (VDD)
+VBUS: C200.2, F200.2, R211.1, U200.1 (VBUS), U202.5 (VBUS); also elsewhere on the board
+VSYS: C203.1, C204.1, L200.2, U200.15 (SYS), U200.16 (SYS); also elsewhere on the board
/CHG_CE#: R213.1, U200.9 (~CE); also elsewhere on the board
/CHG_INT#: R204.2, U200.7 (~INT); also elsewhere on the board
/CHG_OTG: R214.1, U200.8 (OTG); also elsewhere on the board
/CHG_PG#: R202.2, U200.3 (~PG); also elsewhere on the board
/CHG_QON#: U200.12 (~QON); also elsewhere on the board
/CHG_STAT#: D200.1 (K), R203.2, U200.4 (STAT); also elsewhere on the board
/GAUGE_ALRT#: R215.2, U201.5 (~ALRT); also elsewhere on the board
/SCL_AON: R206.2, U200.5 (SCL), U201.7 (SCL); also elsewhere on the board
/SDA_AON: R205.2, U200.6 (SDA), U201.8 (SDA); also elsewhere on the board
/USBD+: J200.A6 (USBD+), J200.B6 (USBD+), U202.3 (I/O2), U202.4 (I/O2); also elsewhere on the board
/USBD-: J200.A7 (USBD-), J200.B7 (USBD-), U202.1 (I/O1), U202.6 (I/O1); also elsewhere on the board
/VBUS_DET: R211.2, R212.1; also elsewhere on the board
/battery/+VBUS_PRE: F200.1, J200.A4 (VBUS), J200.A9 (VBUS), J200.B4 (VBUS), J200.B9 (VBUS)
/battery/CHG_PSEL: R210.1, R217.2, U200.2 (PSEL)
/battery/CHG_SW: C202.2, L200.1, U200.19 (SW), U200.20 (SW)
/battery/CHG_TS: J201.2, J202.2, R208.2, R209.1, U200.11 (TS)
/battery/REGN: C205.1, R208.1, R217.1, U200.22 (REGN)
/battery/USB_CC1: J200.A5 (CC1), R200.1
/battery/USB_CC2: J200.B5 (CC2), R201.1
GND: C200.1, C201.1, C203.2, C204.2, C205.2, C206.2, C207.2, J200.A1 (GND), J200.A12 (GND), J200.B1 (GND), J200.B12 (GND), J200.SH (SHIELD), J201.3, J202.3, R200.2, R201.2, R207.2, R209.2, R210.2, R212.2, R213.2, R214.2, U200.17 (PGND), U200.18 (PGND), U200.25 (PGND), U201.1 (CTG), U201.4 (GND), U201.6 (QSTRT), U201.9 (EP), U202.2 (GND); also elsewhere on the board
unnamed: D200.2 (A), R216.2
unnamed: C202.1, U200.21 (BTST)
unnamed: R207.1, U200.10 (ILIM)
unnamed: C201.2, U200.23 (PMID)

Notes on the sheet:
1S cell, 5000 mAh, with pack NTC
*** The PL706090 ships with a JST 1.25 mm plug rated 1 A against ~2 A of
USB-C — charge input and USB2 device port
Charge indicator - lit while STAT is low.
Fuel gauge — MAX17048, I2C 0x36
Defaults while the MCU is unpowered: charging enabled, boost off
right-angle. Replaces a JST-PH that was 2 A and ~6.0 mm tall.
PSEL high = USB host source
ERC power flags — drop the +3V3_AON flag once
J2 Pico-Lock 504050-0391: 3.5 A/contact, 2.00 mm mated, positive lock,
No NTC in pack -> fit 7.68k/10k instead.
J25 bare copper pads, for soldering the cell's leads directly.
TS: 103AT NTC in the pack. RT1/RT2 solved from
power.kicad_sch sources that rail.
Cell attachment -- J2 or J25, same three nets, fit either or both.
*** charge current, so the pack must be re-terminated. battery.md §9.1.
Pull-ups to +3V3_AON (always-on domain)
Charger with power path — BQ25892
to other sheets
V(T1) 73.25% and V(T5) 34.375% of REGN.
STAT
USB-C sink: 5.1k Rd on each CC, separately
VBUS presence, 2.5 V at 5 V in
Fit R38 or R11, never both.

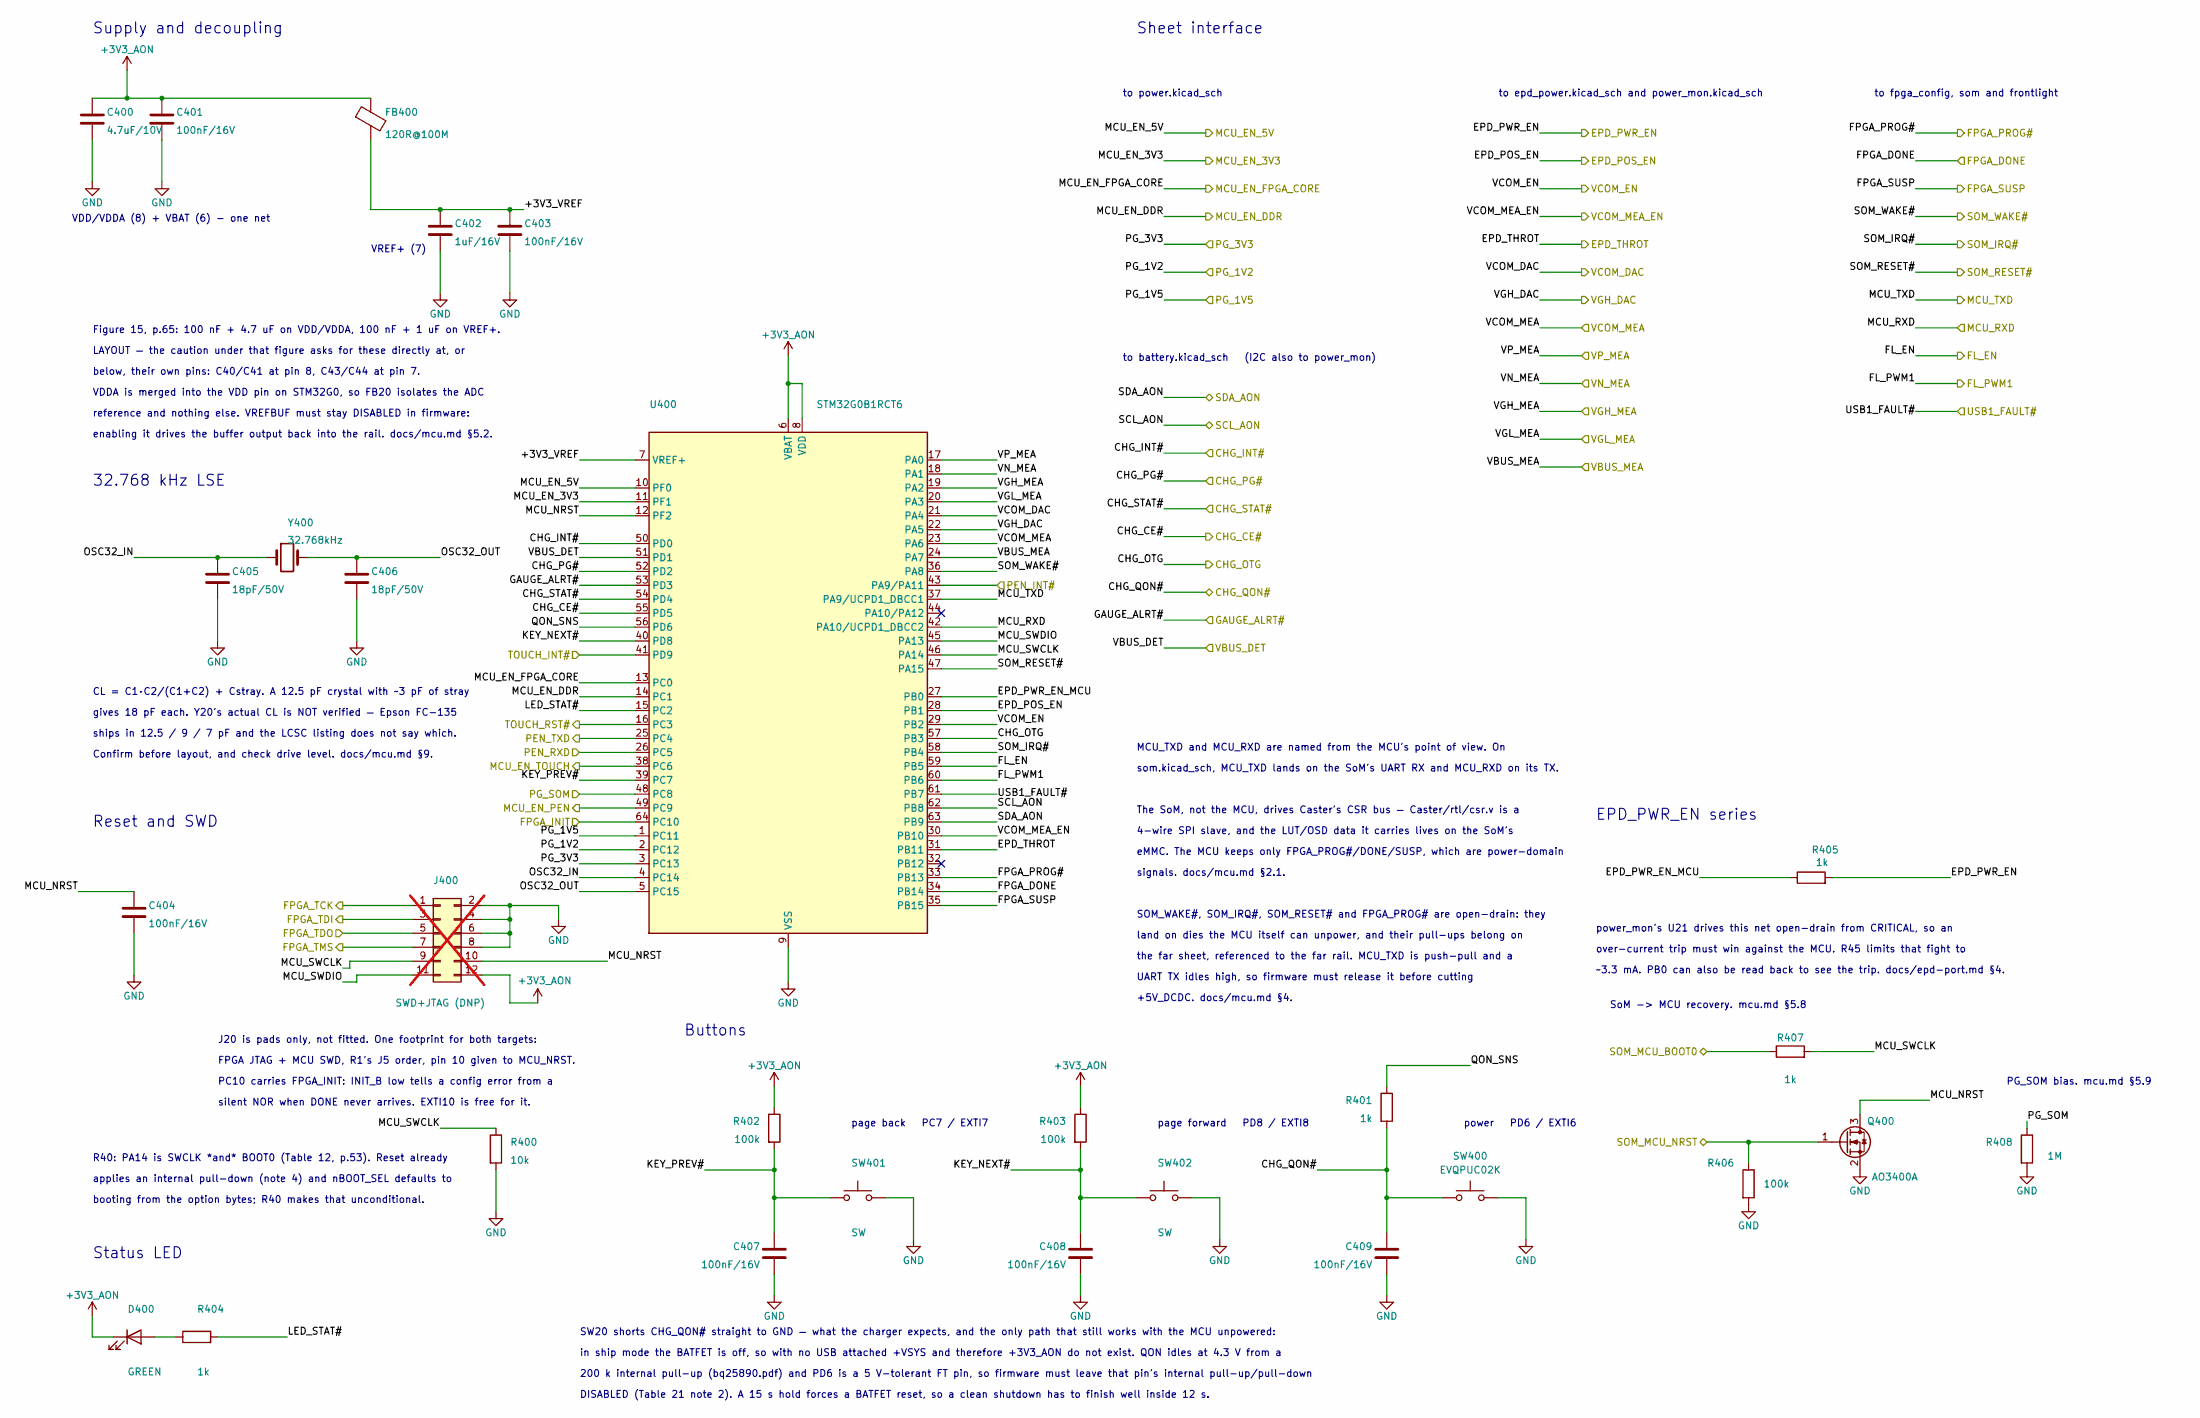
[picture p83: schematic mcu.kicad_sch, Glider-R2 / Reflow mainboard]

Parts:
C400: 4.7uF/10V; C_0402_1005Metric
C401, C403, C404, C407, C408, C409: 100nF/16V; C_0402_1005Metric
C402: 1uF/16V; C_0402_1005Metric
C405, C406: 18pF/50V; C_0402_1005Metric; MPN CC0402JRNPO9BN180
D400: GREEN; LED_0603_1608Metric; MPN LTST-C191KGKT; LCSC C125098
FB400: 120R@100M; L_0402_1005Metric; MPN BLM15AG121SN1D; LCSC C85812
J400: SWD+JTAG (DNP); PinSocket_2x06_P1.27mm_Vertical_SMD; not fitted
Q400: AO3400A; SOT-23; MPN AO3400A; LCSC C347475
R400: 10k; R_0402_1005Metric
R401, R404, R405: 1k; R_0402_1005Metric
R402, R403: 100k; R_0402_1005Metric
R406: 100k; R_0402_1005Metric; MPN 0402WGF1003TCE; LCSC C25741
R407: 1k; R_0402_1005Metric; MPN 0402WGF1001TCE; LCSC C11702
R408: 1M; R_0402_1005Metric; MPN 0402WGF1004TCE; LCSC C26083
SW400: EVQPUC02K; Panasonic_EVQPUL_EVQPUC
SW401, SW402: SW; SW_SPST_Panasonic_EVQPL_3PL_5PL_PT_A15; MPN EVQPLHA15; LCSC C79172
U400: STM32G0B1RCT6; LQFP-64_10x10mm_P0.5mm; MPN STM32G0B1RCT6; LCSC C3034735
Y400: 32.768kHz; Crystal_SMD_3215-2Pin_3.2x1.5mm; MPN Q13FC13500004; LCSC C32346

Connections:
+3V3_AON: C400.1, C401.1, D400.1 (K), FB400.1, J400.12, R402.1, R403.1, U400.6 (VBAT), U400.8 (VDD); also elsewhere on the board
/CHG_CE#: U400.55 (PD5); also elsewhere on the board
/CHG_INT#: U400.50 (PD0); also elsewhere on the board
/CHG_OTG: U400.57 (PB3); also elsewhere on the board
/CHG_PG#: U400.52 (PD2); also elsewhere on the board
/CHG_QON#: C409.1, R401.2, SW400.1; also elsewhere on the board
/CHG_STAT#: U400.54 (PD4); also elsewhere on the board
/EPD_POS_EN: U400.28 (PB1); also elsewhere on the board
/EPD_PWR_EN: R405.2; also elsewhere on the board
/EPD_THROT: U400.31 (PB11); also elsewhere on the board
/FL_EN: U400.59 (PB5); also elsewhere on the board
/FL_PWM1: U400.60 (PB6); also elsewhere on the board
/FPGA_DONE: U400.34 (PB14); also elsewhere on the board
/FPGA_INIT: U400.64 (PC10); also elsewhere on the board
/FPGA_PROG#: U400.33 (PB13); also elsewhere on the board
/FPGA_SUSP: U400.35 (PB15); also elsewhere on the board
/FPGA_TCK: J400.1; also elsewhere on the board
/FPGA_TDI: J400.3; also elsewhere on the board
/FPGA_TDO: J400.5; also elsewhere on the board
/FPGA_TMS: J400.7; also elsewhere on the board
/GAUGE_ALRT#: U400.53 (PD3); also elsewhere on the board
/MCU_EN_3V3: U400.11 (PF1); also elsewhere on the board
/MCU_EN_5V: U400.10 (PF0); also elsewhere on the board
/MCU_EN_DDR: U400.14 (PC1); also elsewhere on the board
/MCU_EN_FPGA_CORE: U400.13 (PC0); also elsewhere on the board
/MCU_EN_PEN: U400.49 (PC9)
/MCU_EN_TOUCH: U400.38 (PC6); also elsewhere on the board
/MCU_RXD: U400.42 (PA10/UCPD1_DBCC2); also elsewhere on the board
/MCU_TXD: U400.37 (PA9/UCPD1_DBCC1); also elsewhere on the board
/PEN_INT#: U400.43 (PA9/PA11)
/PEN_RXD: U400.26 (PC5)
/PEN_TXD: U400.25 (PC4)
/PG_1V2: U400.2 (PC12); also elsewhere on the board
/PG_1V5: U400.1 (PC11); also elsewhere on the board
/PG_3V3: U400.3 (PC13); also elsewhere on the board
/PG_SOM: R408.1, U400.48 (PC8); also elsewhere on the board
/SCL_AON: U400.62 (PB8); also elsewhere on the board
/SDA_AON: U400.63 (PB9); also elsewhere on the board
/SOM_IRQ#: U400.58 (PB4); also elsewhere on the board
/SOM_MCU_BOOT0: R407.1; also elsewhere on the board
/SOM_MCU_NRST: Q400.1 (G), R406.1; also elsewhere on the board
/SOM_RESET#: U400.47 (PA15); also elsewhere on the board
/SOM_WAKE#: U400.36 (PA8); also elsewhere on the board
/TOUCH_INT#: U400.41 (PD9); also elsewhere on the board
/TOUCH_RST#: U400.16 (PC3); also elsewhere on the board
/USB1_FAULT#: U400.61 (PB7); also elsewhere on the board
/VBUS_DET: U400.51 (PD1); also elsewhere on the board
/VBUS_MEA: U400.24 (PA7); also elsewhere on the board
/VCOM_DAC: U400.21 (PA4); also elsewhere on the board
/VCOM_EN: U400.29 (PB2); also elsewhere on the board
/VCOM_MEA: U400.23 (PA6); also elsewhere on the board
/VCOM_MEA_EN: U400.30 (PB10); also elsewhere on the board
/VGH_DAC: U400.22 (PA5); also elsewhere on the board
/VGH_MEA: U400.19 (PA2); also elsewhere on the board
/VGL_MEA: U400.20 (PA3); also elsewhere on the board
/VN_MEA: U400.18 (PA1); also elsewhere on the board
/VP_MEA: U400.17 (PA0); also elsewhere on the board
/mcu/+3V3_VREF: C402.1, C403.1, FB400.2, U400.7 (VREF+)
/mcu/EPD_PWR_EN_MCU: R405.1, U400.27 (PB0)
/mcu/KEY_NEXT#: C408.1, R403.2, SW402.1, U400.40 (PD8)
/mcu/KEY_PREV#: C407.1, R402.2, SW401.1, U400.39 (PC7)
/mcu/LED_STAT#: R404.2, U400.15 (PC2)
/mcu/MCU_NRST: C404.1, J400.10, Q400.3 (D), U400.12 (PF2)
/mcu/MCU_SWCLK: J400.9, R400.1, R407.2, U400.46 (PA14)
/mcu/MCU_SWDIO: J400.11, U400.45 (PA13)
/mcu/OSC32_IN: C405.1, U400.4 (PC14), Y400.1
/mcu/OSC32_OUT: C406.1, U400.5 (PC15), Y400.2
/mcu/QON_SNS: R401.1, U400.56 (PD6)
GND: C400.2, C401.2, C402.2, C403.2, C404.2, C405.2, C406.2, C407.2, C408.2, C409.2, J400.2, J400.4, J400.6, J400.8, Q400.2 (S), R400.2, R406.2, R408.2, SW400.2, SW401.2, SW402.2, U400.9 (VSS); also elsewhere on the board
unnamed: D400.2 (A), R404.1

Notes on the sheet:
J20 is pads only, not fitted. One footprint for both targets:
the far sheet, referenced to the far rail. MCU_TXD is push-pull and a
eMMC. The MCU keeps only FPGA_PROG#/DONE/SUSP, which are power-domain
SW20 shorts CHG_QON# straight to GND — what the charger expects, and the only path that still works with the MCU unpowered:
ships in 12.5 / 9 / 7 pF and the LCSC listing does not say which.
32.768 kHz LSE
PG_SOM bias. mcu.md §5.9
PC10 carries FPGA_INIT: INIT_B low tells a config error from a
VREF+ (7)
below, their own pins: C40/C41 at pin 8, C43/C44 at pin 7.
silent NOR when DONE never arrives. EXTI10 is free for it.
to battery.kicad_sch (I2C also to power_mon)
to fpga_config, som and frontlight
MCU_TXD and MCU_RXD are named from the MCU's point of view. On
page back PC7 / EXTI7
Confirm before layout, and check drive level. docs/mcu.md §9.
SoM -> MCU recovery. mcu.md §5.8
+5V_DCDC. docs/mcu.md §4.
page forward PD8 / EXTI8
VDDA is merged into the VDD pin on STM32G0, so FB20 isolates the ADC
power_mon's U21 drives this net open-drain from CRITICAL, so an
to epd_power.kicad_sch and power_mon.kicad_sch
power PD6 / EXTI6
UART TX idles high, so firmware must release it before cutting
LAYOUT — the caution under that figure asks for these directly at, or
The SoM, not the MCU, drives Caster's CSR bus — Caster/rtl/csr.v is a
land on dies the MCU itself can unpower, and their pull-ups belong on
4-wire SPI slave, and the LUT/OSD data it carries lives on the SoM's
Sheet interface
EPD_PWR_EN series
enabling it drives the buffer output back into the rail. docs/mcu.md §5.2.
over-current trip must win against the MCU. R45 limits that fight to
Reset and SWD
in ship mode the BATFET is off, so with no USB attached +VSYS and therefore +3V3_AON do not exist. QON idles at 4.3 V from a
to power.kicad_sch
SOM_WAKE#, SOM_IRQ#, SOM_RESET# and FPGA_PROG# are open-drain: they
DISABLED (Table 21 note 2). A 15 s hold forces a BATFET reset, so a clean shutdown has to finish well inside 12 s.
booting from the option bytes; R40 makes that unconditional.
gives 18 pF each. Y20's actual CL is NOT verified — Epson FC-135
Figure 15, p.65: 100 nF + 4.7 uF on VDD/VDDA, 100 nF + 1 uF on VREF+.
Buttons
R40: PA14 is SWCLK *and* BOOT0 (Table 12, p.53). Reset already
200 k internal pull-up (bq25890.pdf) and PD6 is a 5 V-tolerant FT pin, so firmware must leave that pin's internal pull-up/pull-down
FPGA JTAG + MCU SWD, R1's J5 order, pin 10 given to MCU_NRST.
som.kicad_sch, MCU_TXD lands on the SoM's UART RX and MCU_RXD on its TX.
CL = C1·C2/(C1+C2) + Cstray. A 12.5 pF crystal with ~3 pF of stray
Status LED
Supply and decoupling
reference and nothing else. VREFBUF must stay DISABLED in firmware:
signals. docs/mcu.md §2.1.
VDD/VDDA (8) + VBAT (6) - one net
~3.3 mA. PB0 can also be read back to see the trip. docs/epd-port.md §4.
applies an internal pull-down (note 4) and nBOOT_SEL defaults to
