UavL/Glider/pcb/r2-mainboard/r2.kicad_pcb

## KiCad design pcb/r2-mainboard/r2.kicad_pcb (continued)

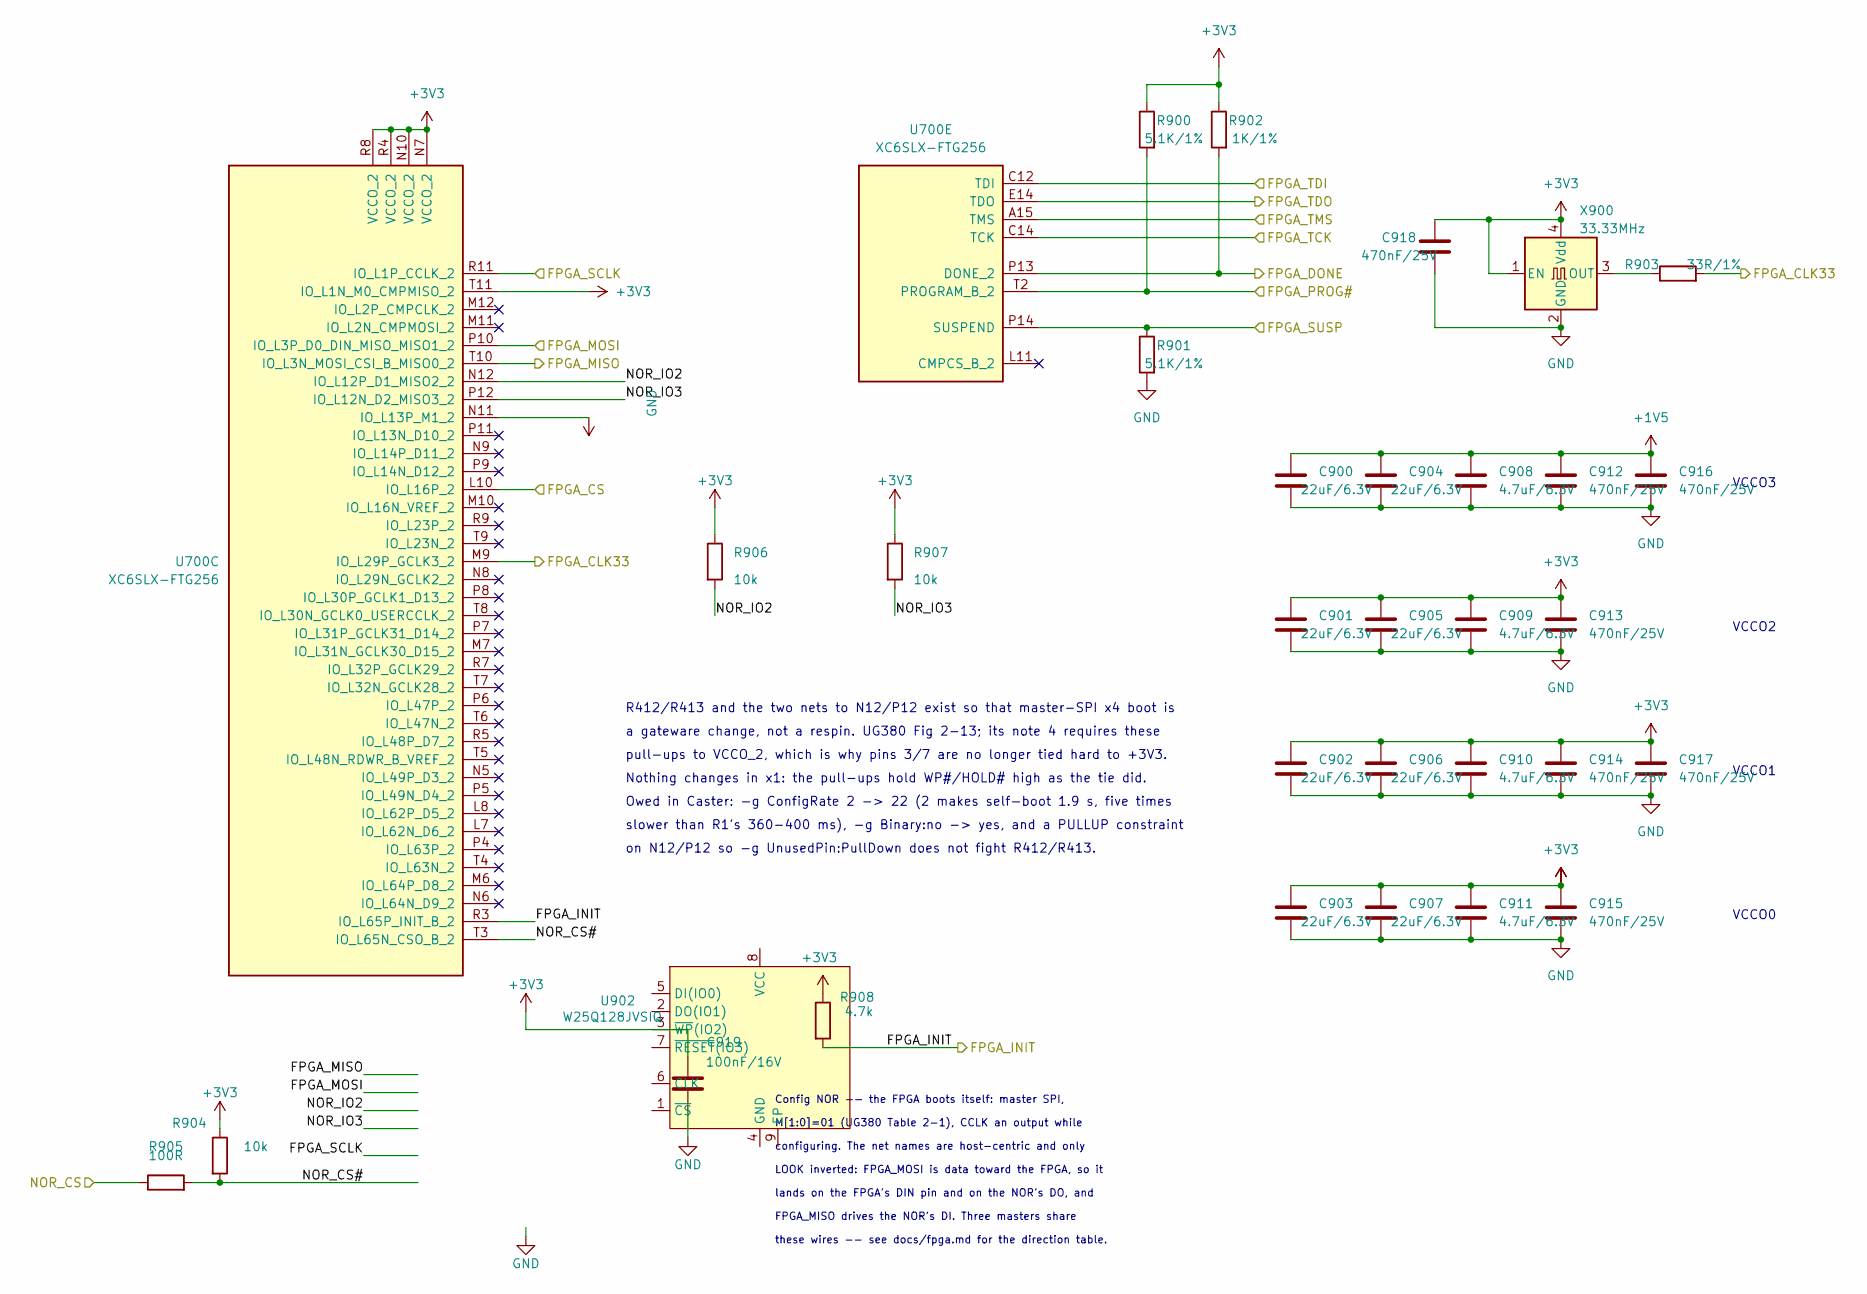
[picture p84: schematic fpga_config.kicad_sch, Glider-R2 / Reflow mainboard]

Parts:
C900, C901, C902, C903, C904, C905, C906, C907: 22uF/6.3V; C_0603_1608Metric; MPN CL10A226MQ8NRNC; LCSC C59461
C908, C909, C910, C911: 4.7uF/6.3V; C_0402_1005Metric; MPN CL05A475MQ5NRNC; LCSC C307423
C912, C913, C914, C915, C916, C917, C918: 470nF/25V; C_0402_1005Metric; MPN CGA0402X5R474K250GT; LCSC C6119801
C919: 100nF/16V; C_0402_1005Metric
R900, R901: 5.1K/1%; R_0402_1005Metric; MPN 0402WGF5101TCE; LCSC C25905
R902: 1K/1%; R_0402_1005Metric; MPN 0402WGF1001TCE; LCSC C11702
R903: 33R/1%; R_0402_1005Metric; MPN 0402WGF330JTCE; LCSC C25105
R904, R906, R907: 10k; R_0402_1005Metric
R905: 100R; R_0402_1005Metric
R908: 4.7k; R_0402_1005Metric
U700: XC6SLX-FTG256; Xilinx_FTG256; MPN XC6SLX16-2FTG256C; LCSC C39313
U902: W25Q128JVSIQ; QSPI Flash SOIC; MPN W25Q128JVSIQ; LCSC C97521
X900: 33.33MHz; Oscillator_SMD_Abracon_ASE-4Pin_3.2x2.5mm; MPN 1532H-33.333JWVDTSL; LCSC C46598403

Connections:
+1V5: C900.1, C904.1, C908.1, C912.1, C916.1; also elsewhere on the board
+3V3: C901.1, C902.1, C903.1, C905.1, C906.1, C907.1, C909.1, C910.1, C911.1, C913.1, C914.1, C915.1, C917.1, C918.2, C919.1, R900.1, R902.1, R904.1, R906.1, R907.1, R908.1, U700.N7 (VCCO_2), U700.N10 (VCCO_2), U700.R4 (VCCO_2), U700.R8 (VCCO_2), U700.T11 (IO_L1N_M0_CMPMISO_2), U902.8 (VCC), X900.1 (EN), X900.4 (Vdd); also elsewhere on the board
/FPGA_CLK33: R903.2, U700.M9 (IO_L29P_GCLK3_2); also elsewhere on the board
/FPGA_CS: U700.L10 (IO_L16P_2); also elsewhere on the board
/FPGA_DONE: R902.2, U700.P13 (DONE_2); also elsewhere on the board
/FPGA_INIT: R908.2, U700.R3 (IO_L65P_INIT_B_2); also elsewhere on the board
/FPGA_MISO: U700.T10 (IO_L3N_MOSI_CSI_B_MISO0_2), U902.5 (DI(IO0)); also elsewhere on the board
/FPGA_MOSI: U700.P10 (IO_L3P_D0_DIN_MISO_MISO1_2), U902.2 (DO(IO1)); also elsewhere on the board
/FPGA_PROG#: R900.2, U700.T2 (PROGRAM_B_2); also elsewhere on the board
/FPGA_SCLK: U700.R11 (IO_L1P_CCLK_2), U902.6 (CLK); also elsewhere on the board
/FPGA_SUSP: R901.1, U700.P14 (SUSPEND); also elsewhere on the board
/FPGA_TCK: U700.C14 (TCK); also elsewhere on the board
/FPGA_TDI: U700.C12 (TDI); also elsewhere on the board
/FPGA_TDO: U700.E14 (TDO); also elsewhere on the board
/FPGA_TMS: U700.A15 (TMS); also elsewhere on the board
/NOR_CS: R905.1; also elsewhere on the board
/fpga_config/NOR_CS#: R904.2, R905.2, U700.T3 (IO_L65N_CSO_B_2), U902.1 (~CS)
/fpga_config/NOR_IO2: R906.2, U700.N12 (IO_L12P_D1_MISO2_2), U902.3 (~WP(IO2))
/fpga_config/NOR_IO3: R907.2, U700.P12 (IO_L12N_D2_MISO3_2), U902.7 (~RESET(IO3))
GND: C900.2, C901.2, C902.2, C903.2, C904.2, C905.2, C906.2, C907.2, C908.2, C909.2, C910.2, C911.2, C912.2, C913.2, C914.2, C915.2, C916.2, C917.2, C918.1, C919.2, R901.2, U700.N11 (IO_L13P_M1_2), U902.4 (GND), X900.2 (GND); also elsewhere on the board
unnamed: R903.1, X900.3 (OUT)

Notes on the sheet:
VCCO1
VCCO2
these wires -- see docs/fpga.md for the direction table.
LOOK inverted: FPGA_MOSI is data toward the FPGA, so it
VCCO3
configuring. The net names are host-centric and only
VCCO0
lands on the FPGA's DIN pin and on the NOR's DO, and
Owed in Caster: -g ConfigRate 2 -> 22 (2 makes self-boot 1.9 s, five times
slower than R1's 360-400 ms), -g Binary:no -> yes, and a PULLUP constraint
a gateware change, not a respin. UG380 Fig 2-13; its note 4 requires these
Config NOR -- the FPGA boots itself: master SPI,
pull-ups to VCCO_2, which is why pins 3/7 are no longer tied hard to +3V3.
Nothing changes in x1: the pull-ups hold WP#/HOLD# high as the tie did.
R412/R413 and the two nets to N12/P12 exist so that master-SPI x4 boot is
on N12/P12 so -g UnusedPin:PullDown does not fight R412/R413.
M[1:0]=01 (UG380 Table 2-1), CCLK an output while
FPGA_MISO drives the NOR's DI. Three masters share

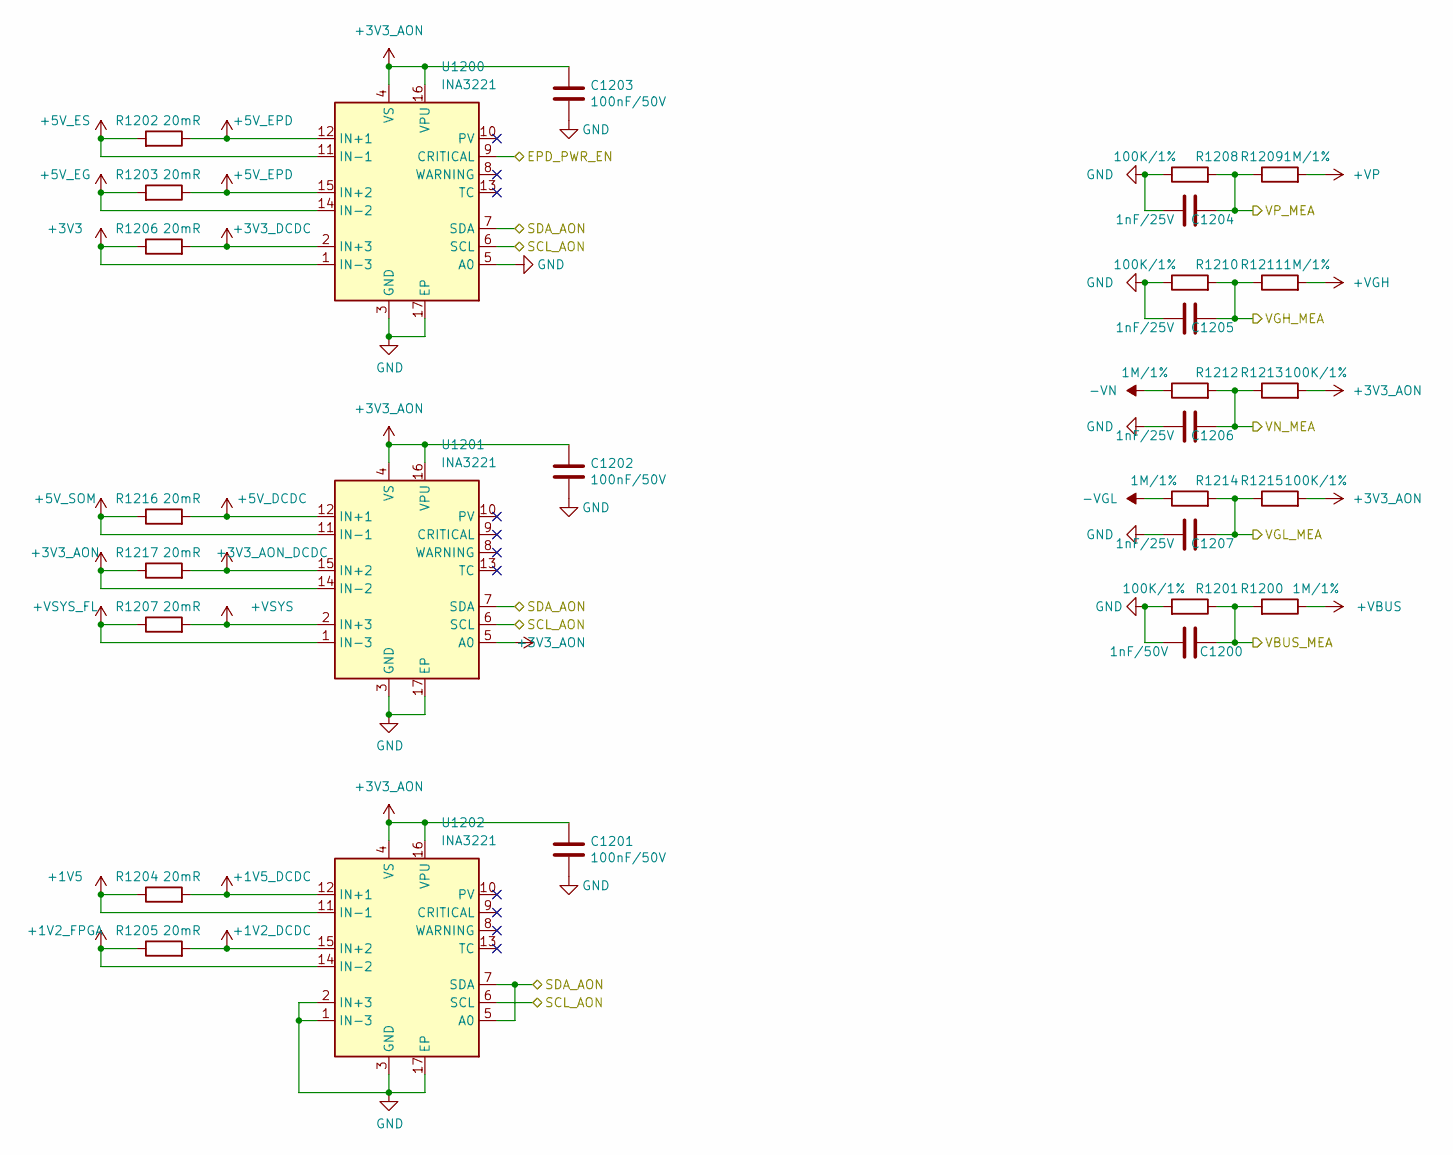
[picture p85: schematic power_mon.kicad_sch, Glider-R2 / Reflow mainboard]

Parts:
C1200: 1nF/50V; C_0402_1005Metric; MPN 0402B102K500NT; LCSC C1523
C1201, C1202, C1203: 100nF/50V; C_0402_1005Metric; MPN CC0402KRX7R9BB104; LCSC C131394
C1204, C1205, C1206, C1207: 1nF/25V; C_0402_1005Metric; MPN 0402B102K500NT; LCSC C1523
R1200, R1209, R1211, R1212, R1214: 1M/1%; R_0402_1005Metric; MPN 0402WGF1004TCE; LCSC C26083
R1201, R1208, R1210, R1213, R1215: 100K/1%; R_0402_1005Metric; MPN 0402WGF1003TCE; LCSC C25741
R1202, R1203, R1204, R1205, R1206, R1207, R1216, R1217: 20mR; R_0805_2012Metric; MPN FRL0805FR020TS; LCSC C7467301
U1200, U1201, U1202: INA3221; Texas_RGV0016A_VQFN-16-1EP_4x4mm_P0.65mm_EP2.1x2.1mm; MPN INA3221AIRGVR; LCSC C181255

Connections:
+1V2_DCDC: R1205.2, U1202.15 (IN+2); also elsewhere on the board
+1V2_FPGA: R1205.1, U1202.14 (IN-2); also elsewhere on the board
+1V5: R1204.1, U1202.11 (IN-1); also elsewhere on the board
+1V5_DCDC: R1204.2, U1202.12 (IN+1); also elsewhere on the board
+3V3: R1206.1, U1200.1 (IN-3); also elsewhere on the board
+3V3_AON: C1201.1, C1202.1, C1203.1, R1213.2, R1215.2, R1217.1, U1200.4 (VS), U1200.16 (VPU), U1201.4 (VS), U1201.5 (A0), U1201.14 (IN-2), U1201.16 (VPU), U1202.4 (VS), U1202.16 (VPU); also elsewhere on the board
+3V3_AON_DCDC: R1217.2, U1201.15 (IN+2); also elsewhere on the board
+3V3_DCDC: R1206.2, U1200.2 (IN+3); also elsewhere on the board
+5V_DCDC: R1216.2, U1201.12 (IN+1); also elsewhere on the board
+5V_EG: R1203.2, U1200.14 (IN-2); also elsewhere on the board
+5V_EPD: R1202.1, R1203.1, U1200.12 (IN+1), U1200.15 (IN+2); also elsewhere on the board
+5V_ES: R1202.2, U1200.11 (IN-1); also elsewhere on the board
+5V_SOM: R1216.1, U1201.11 (IN-1); also elsewhere on the board
+VBUS: R1200.1; also elsewhere on the board
+VGH: R1211.2; also elsewhere on the board
+VP: R1209.2; also elsewhere on the board
+VSYS: R1207.2, U1201.2 (IN+3); also elsewhere on the board
+VSYS_FL: R1207.1, U1201.1 (IN-3); also elsewhere on the board
-VGL: R1214.1; also elsewhere on the board
-VN: R1212.1; also elsewhere on the board
/EPD_PWR_EN: U1200.9 (CRITICAL); also elsewhere on the board
/SCL_AON: U1200.6 (SCL), U1201.6 (SCL), U1202.6 (SCL); also elsewhere on the board
/SDA_AON: U1200.7 (SDA), U1201.7 (SDA), U1202.5 (A0), U1202.7 (SDA); also elsewhere on the board
/VBUS_MEA: C1200.1, R1200.2, R1201.1; also elsewhere on the board
/VGH_MEA: C1205.2, R1210.2, R1211.1; also elsewhere on the board
/VGL_MEA: C1207.2, R1214.2, R1215.1; also elsewhere on the board
/VN_MEA: C1206.2, R1212.2, R1213.1; also elsewhere on the board
/VP_MEA: C1204.2, R1208.2, R1209.1; also elsewhere on the board
GND: C1200.2, C1201.2, C1202.2, C1203.2, C1204.1, C1205.1, C1206.1, C1207.1, R1201.2, R1208.1, R1210.1, U1200.3 (GND), U1200.5 (A0), U1200.17 (EP), U1201.3 (GND), U1201.17 (EP), U1202.1 (IN-3), U1202.2 (IN+3), U1202.3 (GND), U1202.17 (EP); also elsewhere on the board

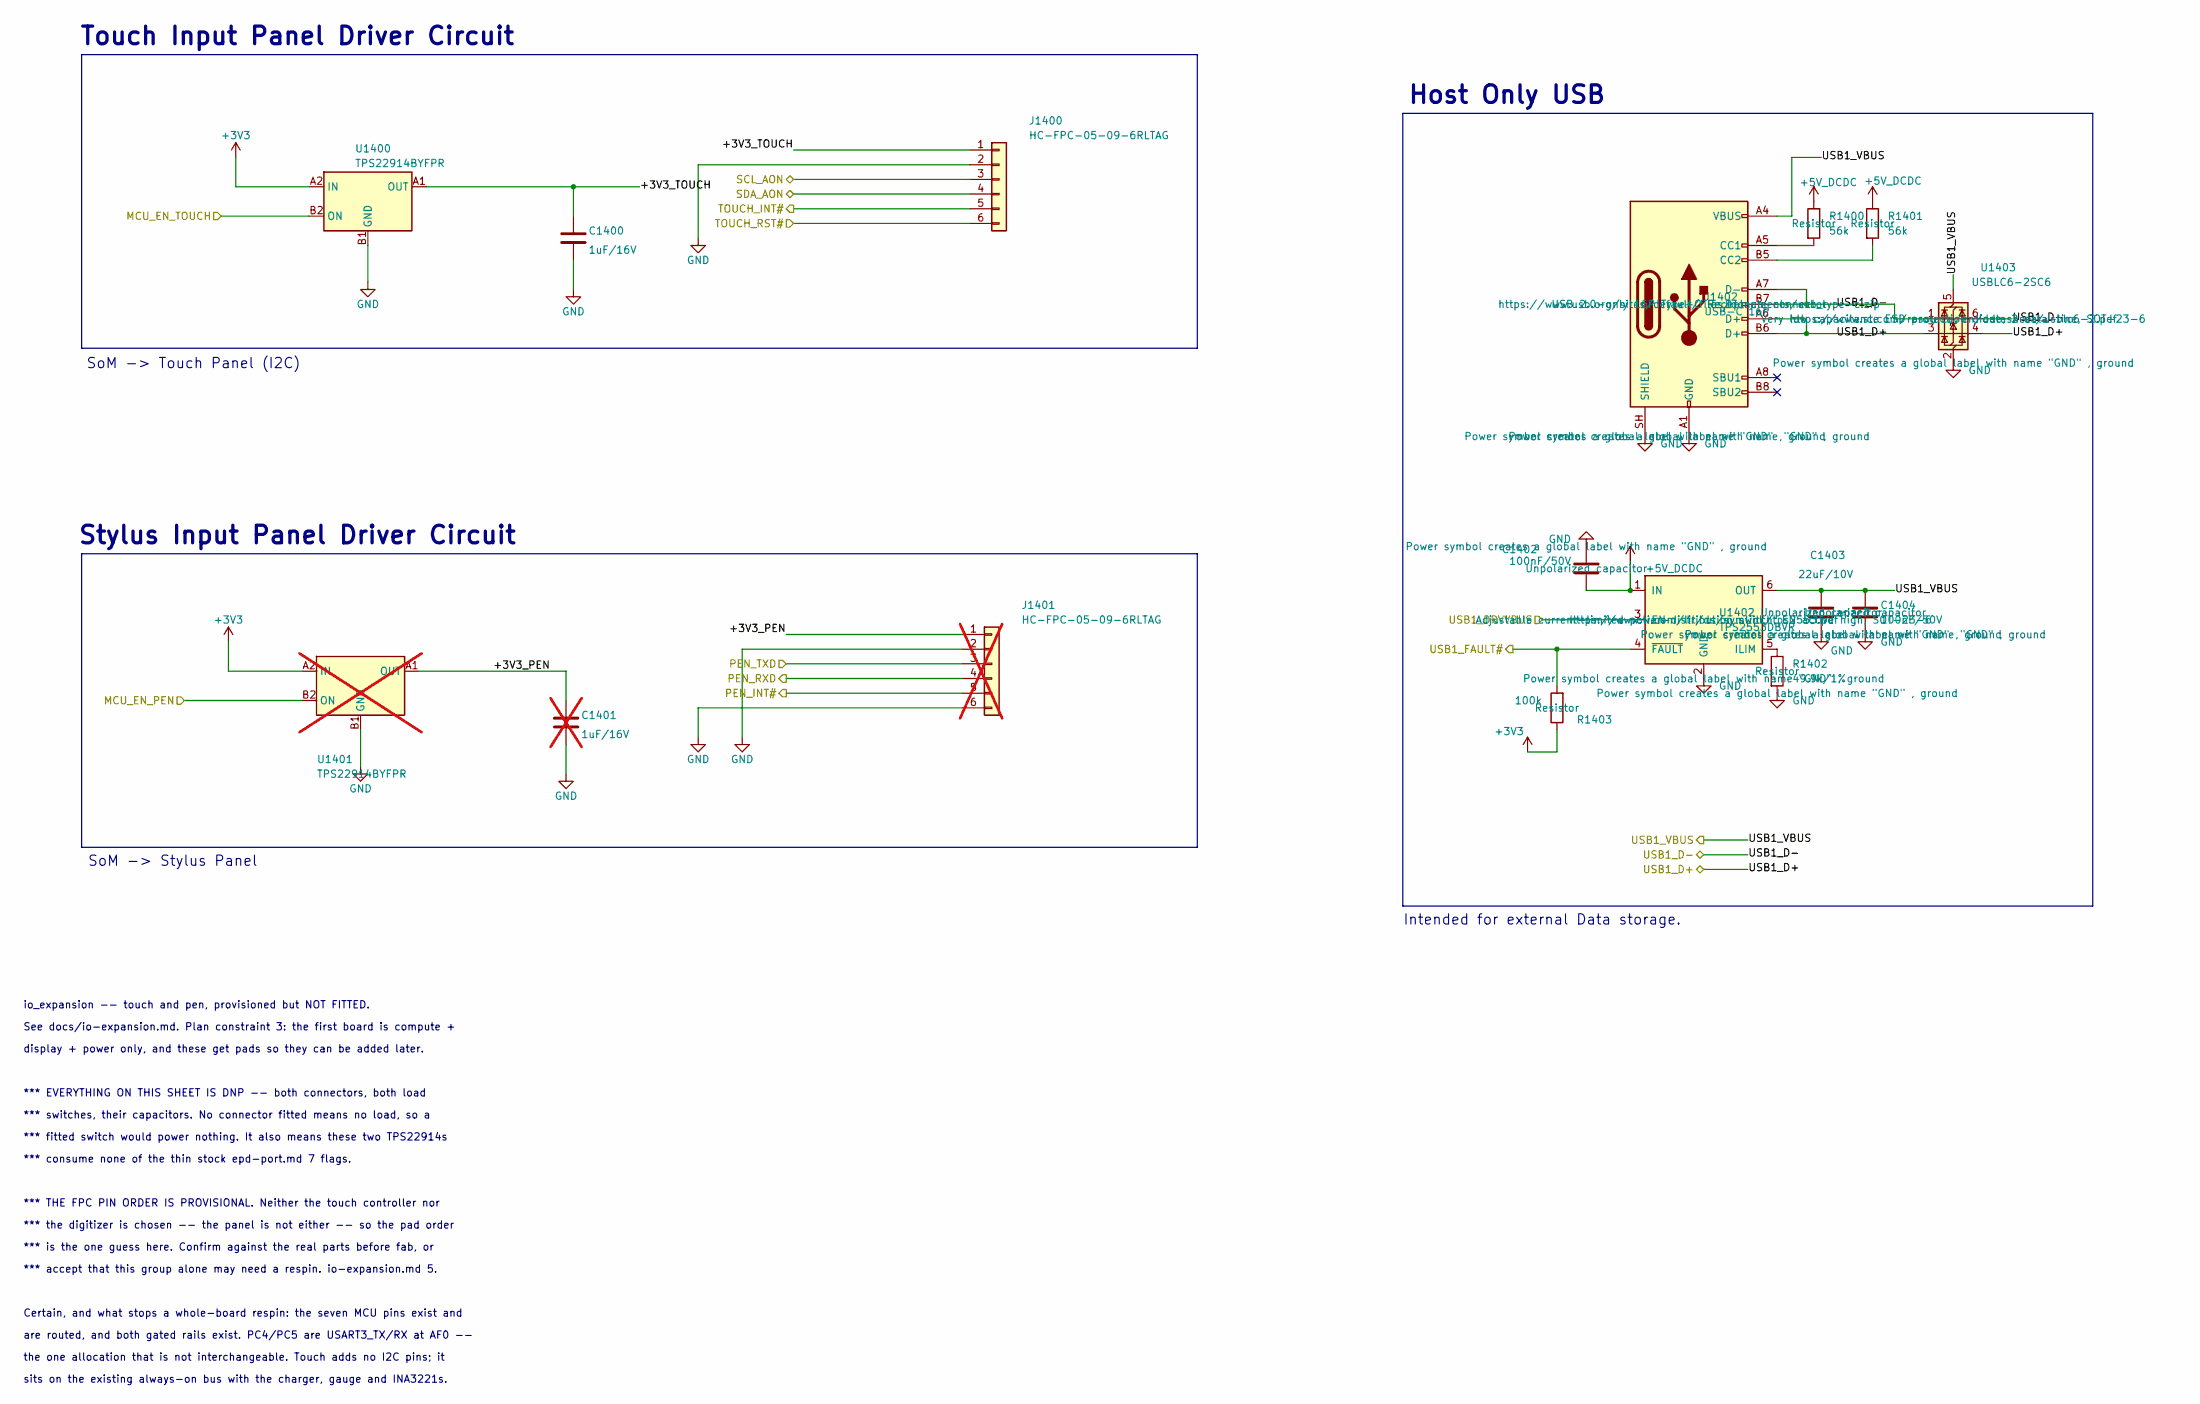
[picture p86: schematic io_expansion.kicad_sch, Glider-R2 / Reflow mainboard]

Parts:
C1400: 1uF/16V; C_0402_1005Metric
C1401: 1uF/16V; C_0402_1005Metric; not fitted
C1402, C1404: 100nF/50V; C_0402_1005Metric
C1403: 22uF/10V; C_0805_2012Metric
J1400: HC-FPC-05-09-6RLTAG; MPN HC-FPC-05-09-6RLTAG; LCSC C5213748
J1401: HC-FPC-05-09-6RLTAG; MPN HC-FPC-05-09-6RLTAG; LCSC C5213748; not fitted
J1402: USB-C 16P; USB_C_Receptacle_HRO_TYPE-C-31-M-12; MPN TYPE-C-31-M-12; LCSC C165948
R1400, R1401: 56k; R_0402_1005Metric
R1402: 49.9k/1%; R_0402_1005Metric
R1403: 100k; R_0402_1005Metric
U1400: TPS22914BYFPR; WLCSP-4_0.89x0.89mm_Layout2x2_P0.5mm; MPN TPS22914BYFPR; LCSC C1848394
U1401: TPS22914BYFPR; WLCSP-4_0.89x0.89mm_Layout2x2_P0.5mm; MPN TPS22914BYFPR; LCSC C1848394; not fitted
U1402: TPS2553DBVR; SOT-23-6; MPN TPS2553DBVR; LCSC C55266
U1403: USBLC6-2SC6; SOT-23-6; MPN USBLC6-2SC6; LCSC C7519

Connections:
+3V3: R1403.1, U1400.A2 (IN), U1401.A2 (IN); also elsewhere on the board
+5V_DCDC: C1402.1, R1400.1, R1401.1, U1402.1 (IN); also elsewhere on the board
/MCU_EN_TOUCH: U1400.B2 (ON); also elsewhere on the board
/SCL_AON: J1400.3; also elsewhere on the board
/SDA_AON: J1400.4; also elsewhere on the board
/TOUCH_INT#: J1400.5; also elsewhere on the board
/TOUCH_RST#: J1400.6; also elsewhere on the board
/USB1_D+: J1402.A6 (USBD+), J1402.B6 (USBD+), U1403.3 (I/O2), U1403.4 (I/O2); also elsewhere on the board
/USB1_D-: J1402.A7 (USBD-), J1402.B7 (USBD-), U1403.1 (I/O1), U1403.6 (I/O1); also elsewhere on the board
/USB1_DRVVBUS: U1402.3 (EN); also elsewhere on the board
/USB1_FAULT#: R1403.2, U1402.4 (~FAULT); also elsewhere on the board
/USB1_VBUS: C1403.1, C1404.1, J1402.A4 (VBUS), J1402.A9 (VBUS), J1402.B4 (VBUS), J1402.B9 (VBUS), U1402.6 (OUT), U1403.5 (VBUS); also elsewhere on the board
/io_expansion/+3V3_TOUCH: C1400.1, J1400.1, U1400.A1 (OUT)
GND: C1400.2, C1401.2, C1402.2, C1403.2, C1404.2, J1400.2, J1401.2, J1401.6, J1402.A1 (GND), J1402.A12 (GND), J1402.B1 (GND), J1402.B12 (GND), J1402.SH (SHIELD), R1402.2, U1400.B1 (GND), U1401.B1 (GND), U1402.2 (GND), U1403.2 (GND); also elsewhere on the board
unnamed: C1401.1, J1401.1, U1401.A1 (OUT)
unnamed: J1402.A5 (CC1), R1400.2
unnamed: J1402.B5 (CC2), R1401.2
unnamed: R1402.1, U1402.5 (ILIM)

Notes on the sheet:
*** is the one guess here. Confirm against the real parts before fab, or
are routed, and both gated rails exist. PC4/PC5 are USART3_TX/RX at AF0 --
sits on the existing always-on bus with the charger, gauge and INA3221s.
display + power only, and these get pads so they can be added later.
*** switches, their capacitors. No connector fitted means no load, so a
*** consume none of the thin stock epd-port.md 7 flags.
Intended for external Data storage.
SoM -> Stylus Panel
Host Only USB
Touch Input Panel Driver Circuit
*** the digitizer is chosen -- the panel is not either -- so the pad order
*** accept that this group alone may need a respin. io-expansion.md 5.
Certain, and what stops a whole-board respin: the seven MCU pins exist and
SoM -> Touch Panel (I2C)
the one allocation that is not interchangeable. Touch adds no I2C pins; it
See docs/io-expansion.md. Plan constraint 3: the first board is compute +
io_expansion -- touch and pen, provisioned but NOT FITTED.
Stylus Input Panel Driver Circuit
*** EVERYTHING ON THIS SHEET IS DNP -- both connectors, both load
*** THE FPC PIN ORDER IS PROVISIONAL. Neither the touch controller nor
*** fitted switch would power nothing. It also means these two TPS22914s

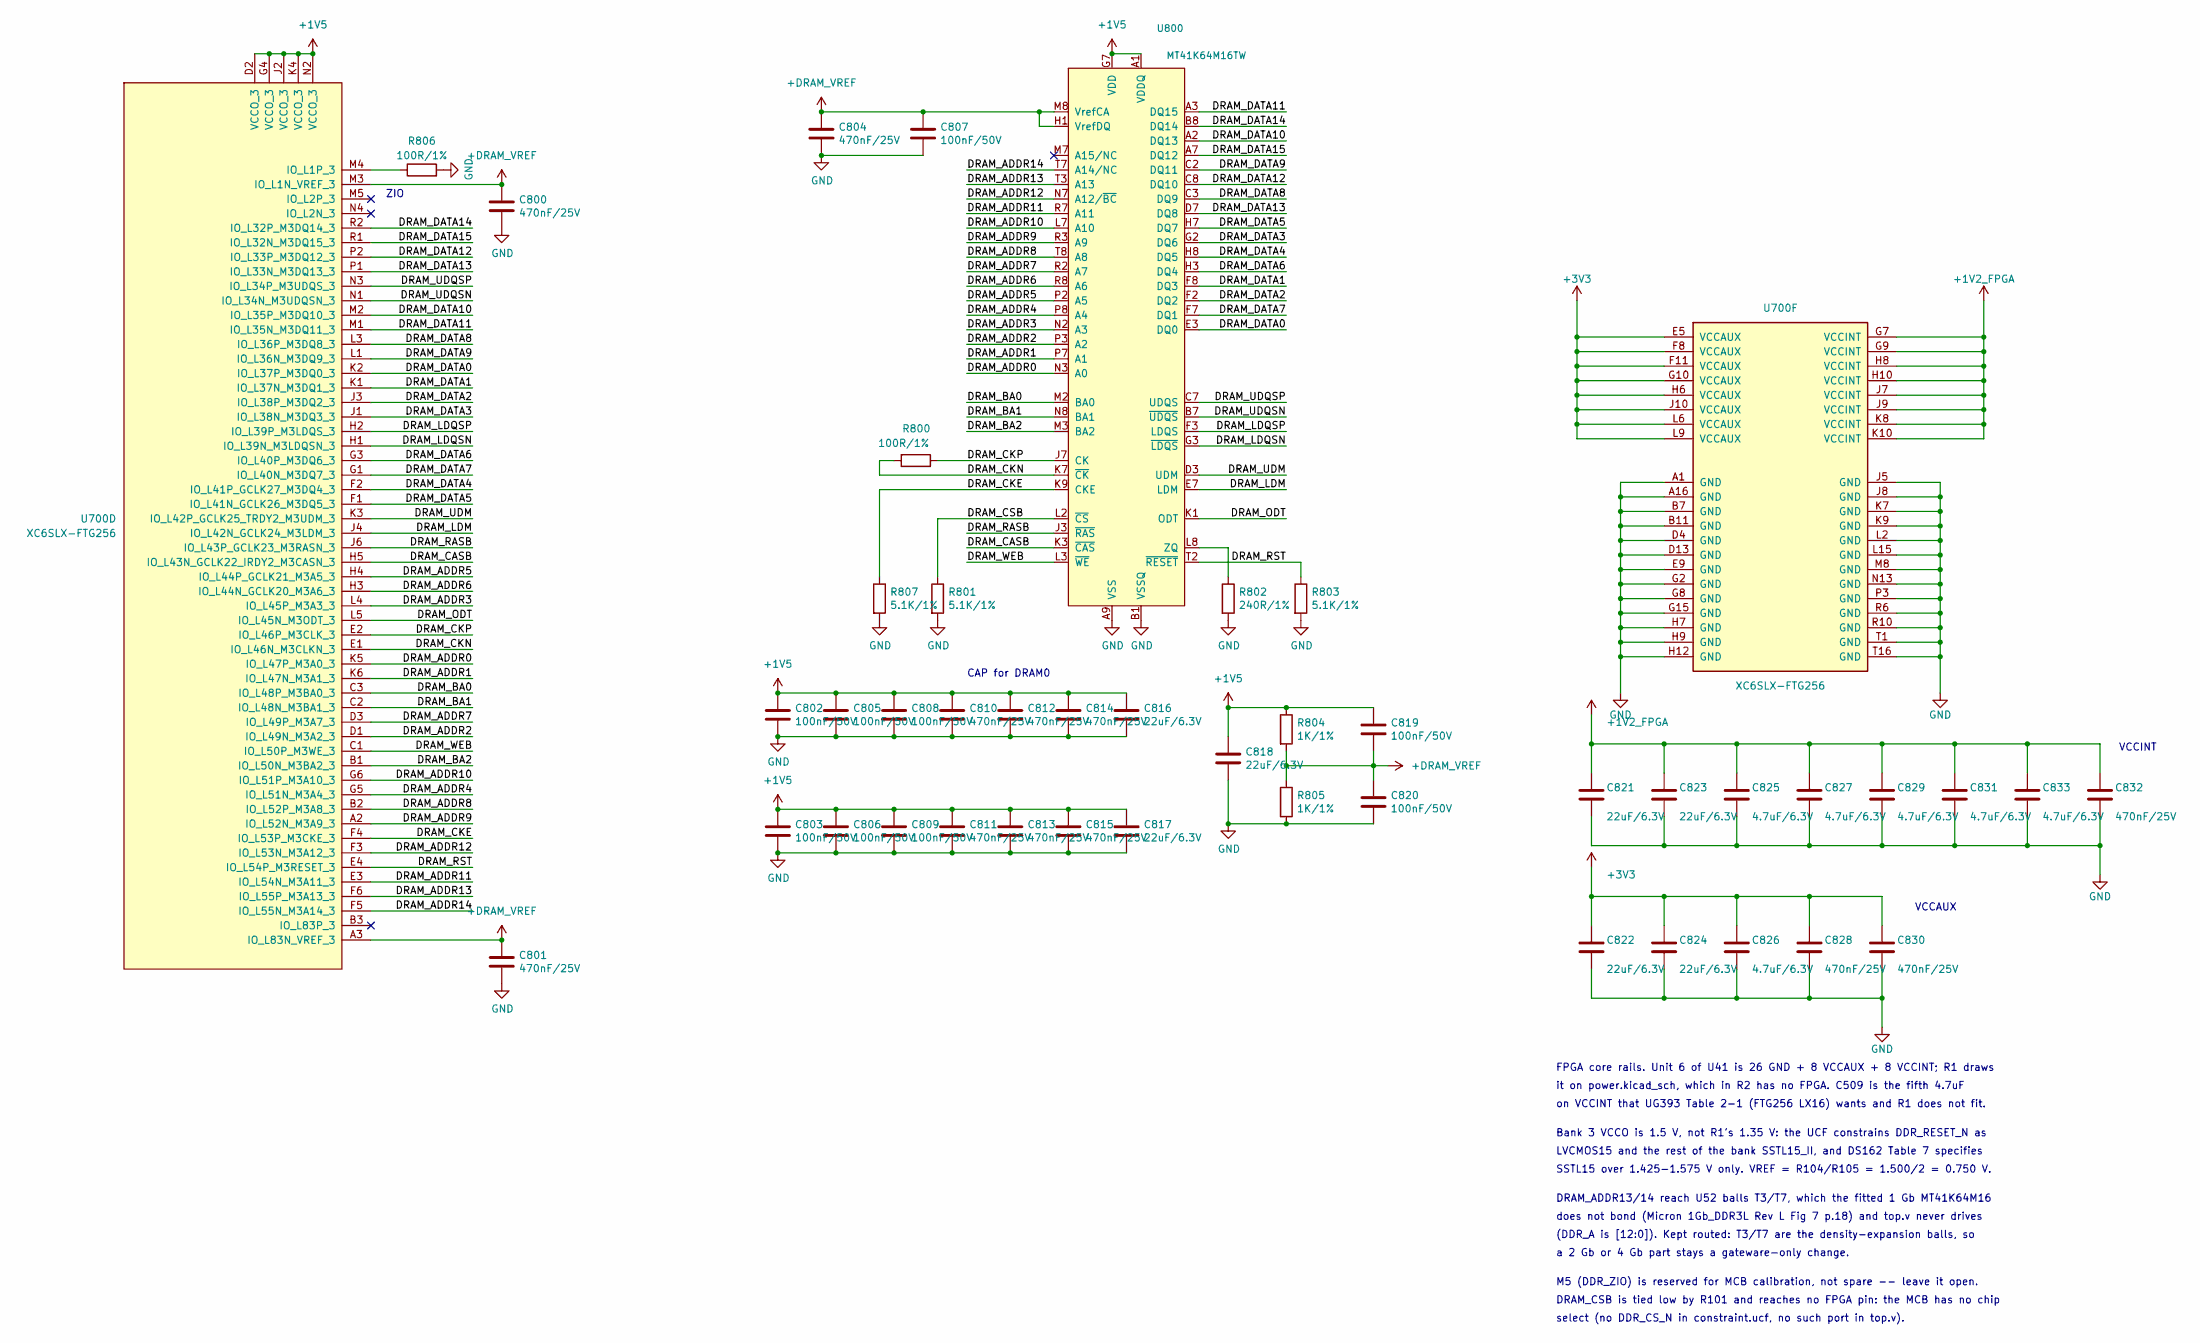
[picture p87: schematic fpga_ddr.kicad_sch, Glider-R2 / Reflow mainboard]

Parts:
C800, C801, C804, C810, C811, C812, C813, C814, C815: 470nF/25V; C_0402_1005Metric; MPN CGA0402X5R474K250GT; LCSC C6119801
C802, C803, C805, C806, C807, C808, C809, C819, C820: 100nF/50V; C_0402_1005Metric; MPN CC0402KRX7R9BB104; LCSC C131394
C816, C817, C818: 22uF/6.3V; C_0603_1608Metric; MPN CL10A226MQ8NRNC; LCSC C59461
C821, C822, C823, C824: 22uF/6.3V; C_0603_1608Metric; MPN CL10A226MQ8NRNC
C825, C826, C827, C829, C831, C833: 4.7uF/6.3V; C_0402_1005Metric; MPN CL05A475MQ5NRNC
C828, C830, C832: 470nF/25V; C_0402_1005Metric; MPN CGA0402X5R474K250GT
R800, R806: 100R/1%; R_0402_1005Metric; MPN 0402WGF1000TCE; LCSC C25076
R801, R803, R807: 5.1K/1%; R_0402_1005Metric; MPN 0402WGF5101TCE; LCSC C25905
R802: 240R/1%; R_0402_1005Metric; MPN 0402WGF2400TCE; LCSC C25094
R804, R805: 1K/1%; R_0402_1005Metric; MPN 0402WGF1001TCE; LCSC C11702
U700: XC6SLX-FTG256; Xilinx_FTG256
U800: MT41K64M16TW; BGA-96_9.0x13.0mm_Layout2x3x16_P0.8mm; MPN MT41K64M16TW-107 IT:J; LCSC C524855

Connections:
+1V2_FPGA: C821.1, C823.1, C825.1, C827.1, C829.1, C831.1, C832.1, C833.1, U700.G7 (VCCINT), U700.G9 (VCCINT), U700.H8 (VCCINT), U700.H10 (VCCINT), U700.J7 (VCCINT), U700.J9 (VCCINT), U700.K8 (VCCINT), U700.K10 (VCCINT); also elsewhere on the board
+1V5: C802.1, C803.1, C805.1, C806.1, C808.1, C809.1, C810.1, C811.1, C812.1, C813.1, C814.1, C815.1, C816.1, C817.1, C818.1, C819.1, R804.1, U700.D2 (VCCO_3), U700.G4 (VCCO_3), U700.J2 (VCCO_3), U700.K4 (VCCO_3), U700.N2 (VCCO_3), U800.A1 (VDDQ), U800.A8 (VDDQ), U800.B2 (VDD), U800.C1 (VDDQ), U800.C9 (VDDQ), U800.D2 (VDDQ), U800.D9 (VDD), U800.E9 (VDDQ), U800.F1 (VDDQ), U800.G7 (VDD), U800.H2 (VDDQ), U800.H9 (VDDQ), U800.K2 (VDD), U800.K8 (VDD), U800.N1 (VDD), U800.N9 (VDD), U800.R1 (VDD), U800.R9 (VDD); also elsewhere on the board
+3V3: C822.1, C824.1, C826.1, C828.1, C830.1, U700.E5 (VCCAUX), U700.F8 (VCCAUX), U700.F11 (VCCAUX), U700.G10 (VCCAUX), U700.H6 (VCCAUX), U700.J10 (VCCAUX), U700.L6 (VCCAUX), U700.L9 (VCCAUX); also elsewhere on the board
+DRAM_VREF: C800.1, C801.1, C804.1, C807.1, C819.2, C820.1, R804.2, R805.1, U700.A3 (IO_L83N_VREF_3), U700.M3 (IO_L1N_VREF_3), U800.H1 (VrefDQ), U800.M8 (VrefCA)
/fpga_ddr/DRAM_ADDR0: U700.K5 (IO_L47P_M3A0_3), U800.N3 (A0)
/fpga_ddr/DRAM_ADDR1: U700.K6 (IO_L47N_M3A1_3), U800.P7 (A1)
/fpga_ddr/DRAM_ADDR2: U700.D1 (IO_L49N_M3A2_3), U800.P3 (A2)
/fpga_ddr/DRAM_ADDR3: U700.L4 (IO_L45P_M3A3_3), U800.N2 (A3)
/fpga_ddr/DRAM_ADDR4: U700.G5 (IO_L51N_M3A4_3), U800.P8 (A4)
/fpga_ddr/DRAM_ADDR5: U700.H4 (IO_L44P_GCLK21_M3A5_3), U800.P2 (A5)
/fpga_ddr/DRAM_ADDR6: U700.H3 (IO_L44N_GCLK20_M3A6_3), U800.R8 (A6)
/fpga_ddr/DRAM_ADDR7: U700.D3 (IO_L49P_M3A7_3), U800.R2 (A7)
/fpga_ddr/DRAM_ADDR8: U700.B2 (IO_L52P_M3A8_3), U800.T8 (A8)
/fpga_ddr/DRAM_ADDR9: U700.A2 (IO_L52N_M3A9_3), U800.R3 (A9)
/fpga_ddr/DRAM_ADDR10: U700.G6 (IO_L51P_M3A10_3), U800.L7 (A10)
/fpga_ddr/DRAM_ADDR11: U700.E3 (IO_L54N_M3A11_3), U800.R7 (A11)
/fpga_ddr/DRAM_ADDR12: U700.F3 (IO_L53N_M3A12_3), U800.N7 (A12/~BC)
/fpga_ddr/DRAM_ADDR13: U700.F6 (IO_L55P_M3A13_3), U800.T3 (A13)
/fpga_ddr/DRAM_ADDR14: U700.F5 (IO_L55N_M3A14_3), U800.T7 (A14/NC)
/fpga_ddr/DRAM_BA0: U700.C3 (IO_L48P_M3BA0_3), U800.M2 (BA0)
/fpga_ddr/DRAM_BA1: U700.C2 (IO_L48N_M3BA1_3), U800.N8 (BA1)
/fpga_ddr/DRAM_BA2: U700.B1 (IO_L50N_M3BA2_3), U800.M3 (BA2)
/fpga_ddr/DRAM_CASB: U700.H5 (IO_L43N_GCLK22_IRDY2_M3CASN_3), U800.K3 (~CAS)
/fpga_ddr/DRAM_CKE: R807.1, U700.F4 (IO_L53P_M3CKE_3), U800.K9 (CKE)
/fpga_ddr/DRAM_CKN: R800.1, U700.E1 (IO_L46N_M3CLKN_3), U800.K7 (~CK)
/fpga_ddr/DRAM_CKP: R800.2, U700.E2 (IO_L46P_M3CLK_3), U800.J7 (CK)
/fpga_ddr/DRAM_CSB: R801.1, U800.L2 (~CS)
/fpga_ddr/DRAM_DATA0: U700.K2 (IO_L37P_M3DQ0_3), U800.E3 (DQ0)
/fpga_ddr/DRAM_DATA1: U700.K1 (IO_L37N_M3DQ1_3), U800.F8 (DQ3)
/fpga_ddr/DRAM_DATA2: U700.J3 (IO_L38P_M3DQ2_3), U800.F2 (DQ2)
/fpga_ddr/DRAM_DATA3: U700.J1 (IO_L38N_M3DQ3_3), U800.G2 (DQ6)
/fpga_ddr/DRAM_DATA4: U700.F2 (IO_L41P_GCLK27_M3DQ4_3), U800.H8 (DQ5)
/fpga_ddr/DRAM_DATA5: U700.F1 (IO_L41N_GCLK26_M3DQ5_3), U800.H7 (DQ7)
/fpga_ddr/DRAM_DATA6: U700.G3 (IO_L40P_M3DQ6_3), U800.H3 (DQ4)
/fpga_ddr/DRAM_DATA7: U700.G1 (IO_L40N_M3DQ7_3), U800.F7 (DQ1)
/fpga_ddr/DRAM_DATA8: U700.L3 (IO_L36P_M3DQ8_3), U800.C3 (DQ9)
/fpga_ddr/DRAM_DATA9: U700.L1 (IO_L36N_M3DQ9_3), U800.C2 (DQ11)
/fpga_ddr/DRAM_DATA10: U700.M2 (IO_L35P_M3DQ10_3), U800.A2 (DQ13)
/fpga_ddr/DRAM_DATA11: U700.M1 (IO_L35N_M3DQ11_3), U800.A3 (DQ15)
/fpga_ddr/DRAM_DATA12: U700.P2 (IO_L33P_M3DQ12_3), U800.C8 (DQ10)
/fpga_ddr/DRAM_DATA13: U700.P1 (IO_L33N_M3DQ13_3), U800.D7 (DQ8)
/fpga_ddr/DRAM_DATA14: U700.R2 (IO_L32P_M3DQ14_3), U800.B8 (DQ14)
/fpga_ddr/DRAM_DATA15: U700.R1 (IO_L32N_M3DQ15_3), U800.A7 (DQ12)
/fpga_ddr/DRAM_LDM: U700.J4 (IO_L42N_GCLK24_M3LDM_3), U800.E7 (LDM)
/fpga_ddr/DRAM_LDQSN: U700.H1 (IO_L39N_M3LDQSN_3), U800.G3 (~LDQS)
/fpga_ddr/DRAM_LDQSP: U700.H2 (IO_L39P_M3LDQS_3), U800.F3 (LDQS)
/fpga_ddr/DRAM_ODT: U700.L5 (IO_L45N_M3ODT_3), U800.K1 (ODT)
/fpga_ddr/DRAM_RASB: U700.J6 (IO_L43P_GCLK23_M3RASN_3), U800.J3 (~RAS)
/fpga_ddr/DRAM_RST: R803.1, U700.E4 (IO_L54P_M3RESET_3), U800.T2 (~RESET)
/fpga_ddr/DRAM_UDM: U700.K3 (IO_L42P_GCLK25_TRDY2_M3UDM_3), U800.D3 (UDM)
/fpga_ddr/DRAM_UDQSN: U700.N1 (IO_L34N_M3UDQSN_3), U800.B7 (~UDQS)
/fpga_ddr/DRAM_UDQSP: U700.N3 (IO_L34P_M3UDQS_3), U800.C7 (UDQS)
/fpga_ddr/DRAM_WEB: U700.C1 (IO_L50P_M3WE_3), U800.L3 (~WE)
GND: C800.2, C801.2, C802.2, C803.2, C804.2, C805.2, C806.2, C807.2, C808.2, C809.2, C810.2, C811.2, C812.2, C813.2, C814.2, C815.2, C816.2, C817.2, C818.2, C820.2, C821.2, C822.2, C823.2, C824.2, C825.2, C826.2, C827.2, C828.2, C829.2, C830.2, C831.2, C832.2, C833.2, R801.2, R802.2, R803.2, R805.2, R806.2, R807.2, U700.A1 (GND), U700.A16 (GND), U700.B7 (GND), U700.B11 (GND), U700.D4 (GND), U700.D13 (GND), U700.E9 (GND), U700.G2 (GND), U700.G8 (GND), U700.G15 (GND), U700.H7 (GND), U700.H9 (GND), U700.H12 (GND), U700.J5 (GND), U700.J8 (GND), U700.K7 (GND), U700.K9 (GND), U700.L2 (GND), U700.L15 (GND), U700.M8 (GND), U700.N13 (GND), U700.P3 (GND), U700.R6 (GND), U700.R10 (GND), U700.T1 (GND), U700.T16 (GND), U800.A9 (VSS), U800.B1 (VSSQ), U800.B3 (VSS), U800.B9 (VSSQ), U800.D1 (VSSQ), U800.D8 (VSSQ), U800.E1 (VSS), U800.E2 (VSSQ), U800.E8 (VSSQ), U800.F9 (VSSQ), U800.G1 (VSSQ), U800.G8 (VSS), U800.G9 (VSSQ), U800.J1 (VSS), U800.J2 (VSS), U800.J8 (VSS), U800.J9 (VSS), U800.L1 (VSS), U800.L9 (VSS), U800.M1 (VSS), U800.M9 (VSS), U800.P1 (VSS), U800.P9 (VSS), U800.T1 (VSS), U800.T9 (VSS); also elsewhere on the board
unnamed: R806.1, U700.M4 (IO_L1P_3)
unnamed: R802.1, U800.L8 (ZQ)

Notes on the sheet:
does not bond (Micron 1Gb_DDR3L Rev L Fig 7 p.18) and top.v never drives
FPGA core rails. Unit 6 of U41 is 26 GND + 8 VCCAUX + 8 VCCINT; R1 draws
LVCMOS15 and the rest of the bank SSTL15_II, and DS162 Table 7 specifies
Bank 3 VCCO is 1.5 V, not R1's 1.35 V: the UCF constrains DDR_RESET_N as
DRAM_ADDR13/14 reach U52 balls T3/T7, which the fitted 1 Gb MT41K64M16
select (no DDR_CS_N in constraint.ucf, no such port in top.v).
CAP for DRAM0
DRAM_CSB is tied low by R101 and reaches no FPGA pin: the MCB has no chip
SSTL15 over 1.425-1.575 V only. VREF = R104/R105 = 1.500/2 = 0.750 V.
(DDR_A is [12:0]). Kept routed: T3/T7 are the density-expansion balls, so
a 2 Gb or 4 Gb part stays a gateware-only change.
M5 (DDR_ZIO) is reserved for MCB calibration, not spare -- leave it open.
ZIO
VCCINT
on VCCINT that UG393 Table 2-1 (FTG256 LX16) wants and R1 does not fit.
VCCAUX
it on power.kicad_sch, which in R2 has no FPGA. C509 is the fifth 4.7uF

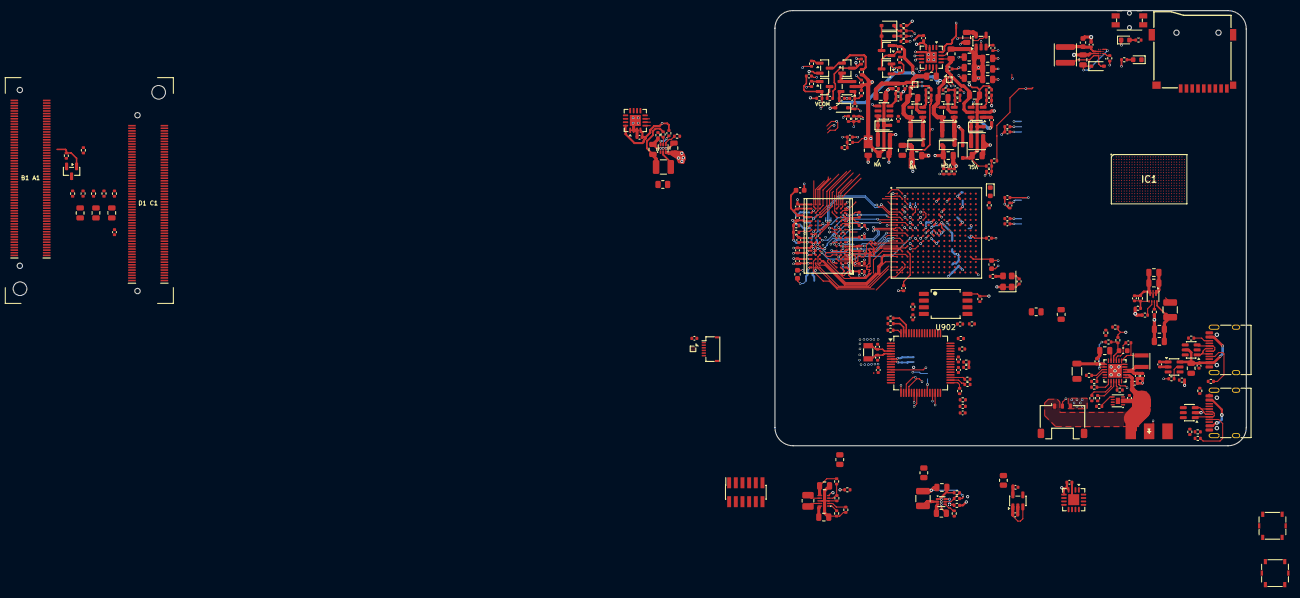
[picture p88: board r2.kicad_pcb from above]

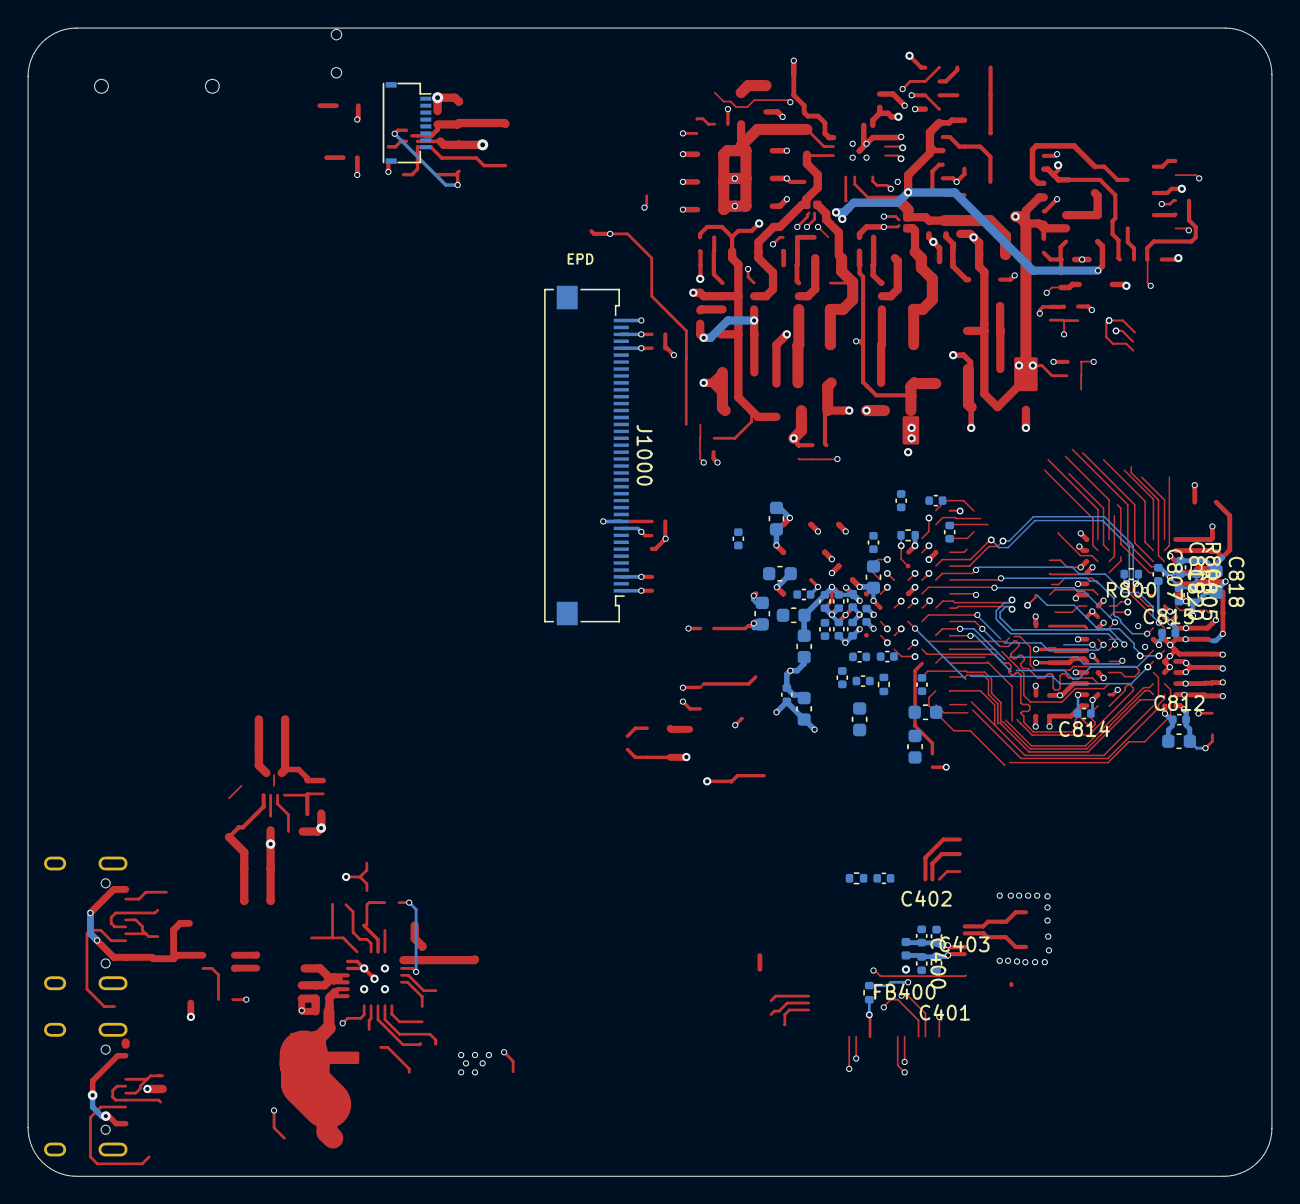
[picture p89: board r2.kicad_pcb from below]

Board: 6 copper layers, 89.8 x 82.8 mm, 329 parts (52 on the bottom side), 266 nets.
