UavL/Glider/pcb/r2-mainboard/r1_glider.kicad_pcb

## KiCad design pcb/r2-mainboard/r1_glider.kicad_pcb (2026-08-26)

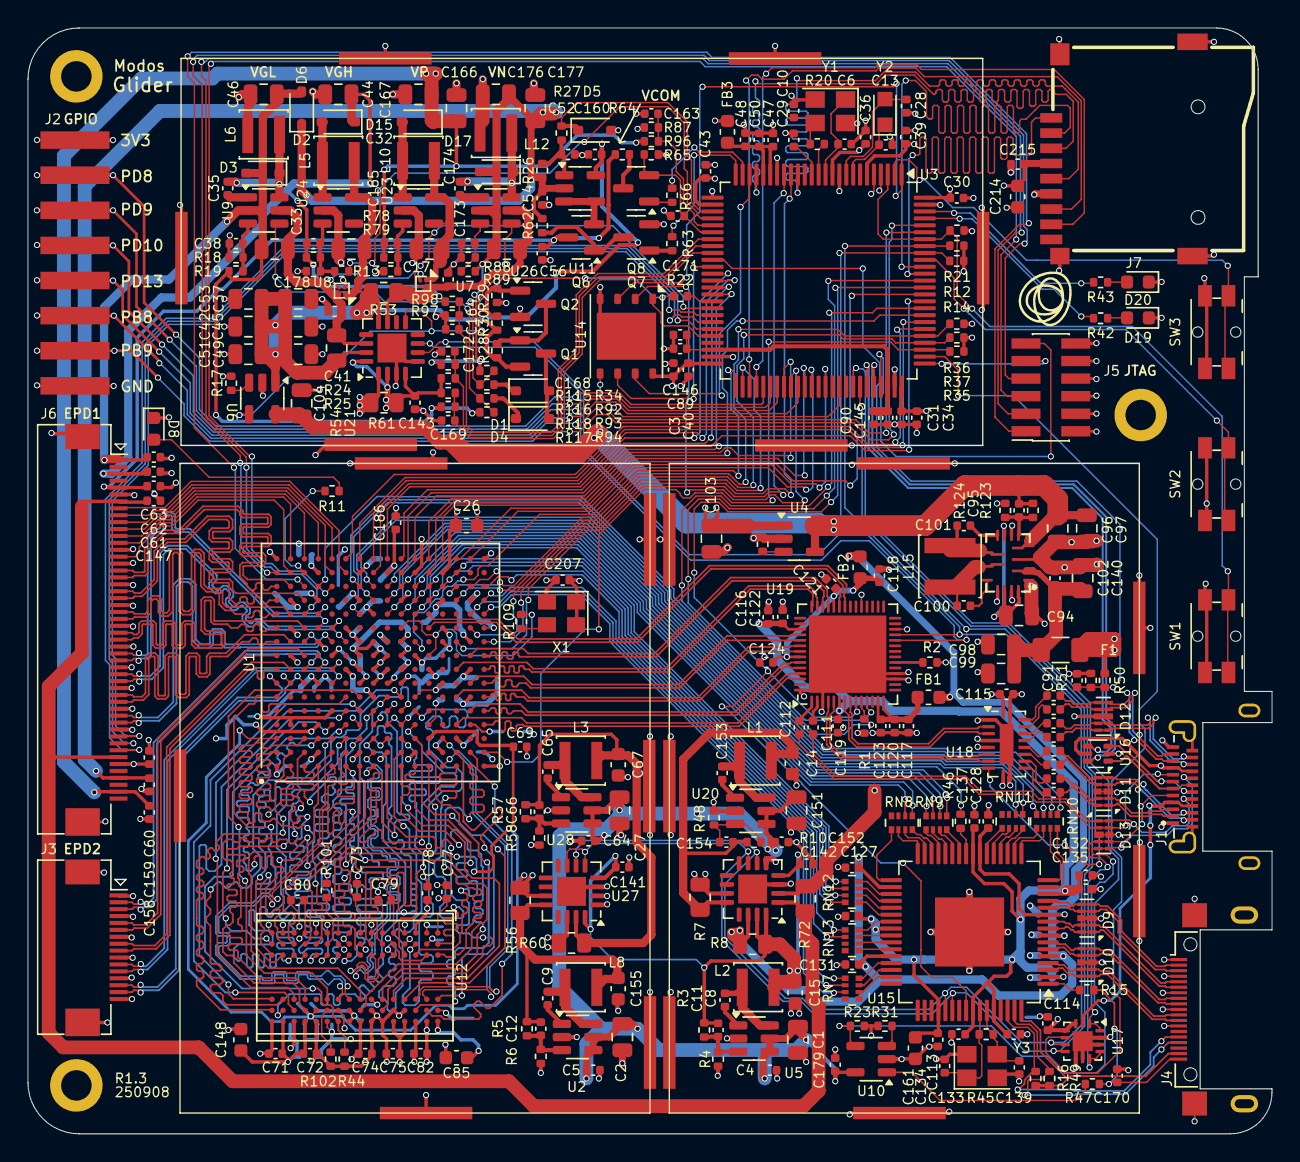
[picture p90: board r1_glider.kicad_pcb from above]

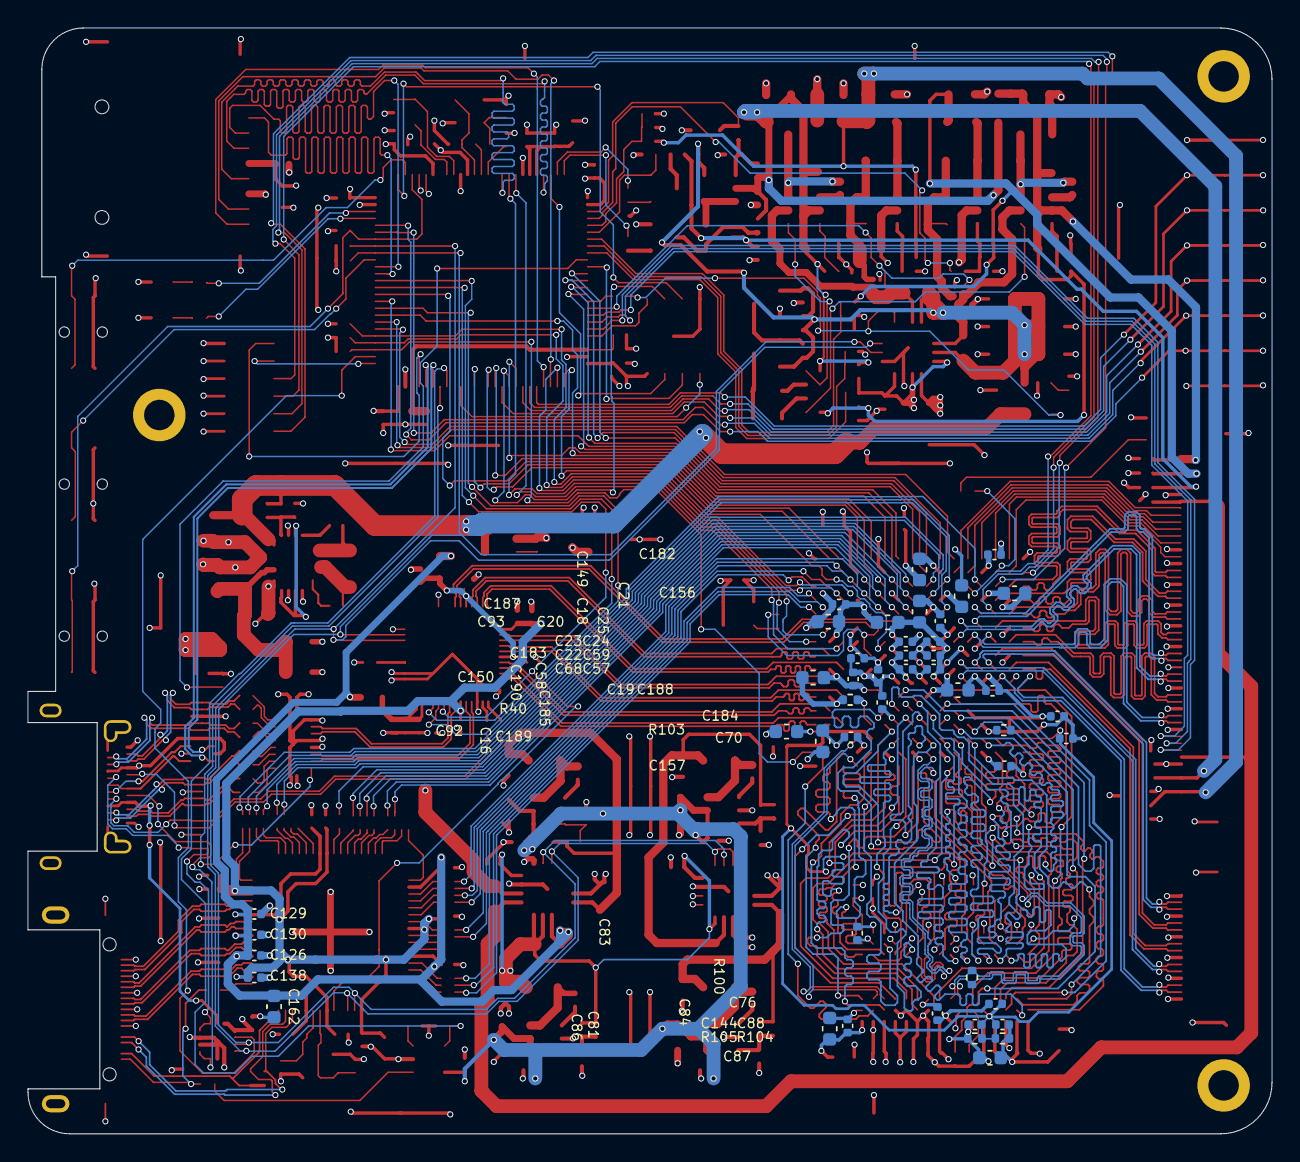
[picture p91: board r1_glider.kicad_pcb from below]

Board: 4 copper layers, 90.0 x 80.0 mm, 378 parts (46 on the bottom side), 356 nets.

Parts:
C1, C2, C17, C27, C32, C37, C42, C45, C49, C51, C53, C94, C96, C97, C103, C104, C151: 22uF/10V; C_0805_2012Metric
C3, C4, C5, C7, C8, C9, C29, C30, C31, C35, C36, C39, C40, C43, C48, C50, C54, C55, C60, C61, C62, C63, C64, C65, C71, C72, C74, C75, C76, C77, C78, C88, C100, C101, C102, C105, C106, C107, C108, C109, C110, C111, C112, C114, C115, C119, C120, C121, C122, C123, C124, C127, C128, C129, C130, C131, C133, C134, C135, C136, C137, C138, C139, C141, C142, C143, C144, C147, C152, C153, C158, C159, C160, C171, C174, C179, C215: 100nF/50V; C_0402_1005Metric
C6, C10, C11, C12, C13, C28, C38, C41, C66, C113, C125, C154, C165, C175: 18pF/50V; C_0402_1005Metric
C14, C15, C16, C18, C19, C20, C21, C26, C67, C85, C86, C87, C92, C93, C148, C149, C150, C155, C156, C161, C162, C214: 22uF/6.3V; C_0603_1608Metric
C22, C23, C24, C34, C47, C56, C57, C59, C89, C90, C116, C117, C118, C126, C132, C145, C146, C157, C182, C183, C184: 4.7uF/6.3V; C_0402_1005Metric
C25, C52, C58, C68, C69, C70, C73, C79, C80, C81, C82, C83, C84, C172, C178, C185, C186, C187, C188, C189, C190, C207: 470nF/25V; C_0402_1005Metric
C33, C44, C46, C98, C99, C140, C166, C167, C173, C176, C177: 4.7uF/50V; C_0805_2012Metric
C91, C95, C170: 1nF/50V; C_0402_1005Metric
C163, C164, C168, C169: 1nF/25V; C_0402_1005Metric
D1, D2, D3, D4, D5, D6, D15, D17: 1N5819WS; D_SOD-323_Alt
D8, D19: LED GREEN; LED_0603_1608Metric
D9, D10, D11, D12, D13: RCLAMP0524P; Diodes_UDFN-10_1.0x2.5mm_P0.5mm
D20: LED RED; LED_0603_1608Metric
F1: 3A; Fuse_1206_3216Metric
FB1, FB2, FB3: 120R@100M; L_0603_1608Metric
H1, H3, H4: MountingHole; MountingHole_2.2mm_M2_DIN965_Pad
H5, H6, H7, H8, H9, H12, H13, H14, H15, H16, H17, H18, H19, H20, H21, H22, H23, H25, H26: ICSRC6508-030SFR
J1: GT-USB-7007A; USB_C_Receptacle_GT-USB-7007A
J2: Conn_01x08_MountingPin; 8P_2.54
J3: FPC-05F-16PH20; Xunpu_FPC-05F-16PH20_1x16-1MP_P0.50mm_Horizontal
J4: HDMI_C_1.3; HDMI_C_GT-HD006A-CGNGX
J5: 2x6_1.27_HDR; PinSocket_2x06_P1.27mm_Vertical_SMD
J6: FPC-05F-50PH20; Xunpu_FPC-05F-50PH20_1x50-1MP_P0.50mm_Horizontal
J7: MICRO_SD(TFC-WPAPR-08); TFC-WPAPR-08
L1, L2, L3, L5, L6, L8, L10, L12: WPN3012H4R7MT; L_Changjiang_FNR3012S
L15: WPN4020H2R2MT; L_Changjiang_FNR4020S
Q1, Q7, Q8: AO3401A; SOT-23
Q2: S8050; SOT-23
Q6: AO3400A; SOT-23
R1, R2, R9, R29, R30, R35, R36, R44, R101, R103: 5.1K/1%; R_0402_1005Metric
R3, R13, R26, R28, R34, R51, R57, R58, R62, R87, R92, R93, R94, R97, R116, R118, R124: 100K/1%; R_0402_1005Metric
R4, R25, R27, R64, R89: 22K/1%; R_0402_1005Metric
R5, R78: 150K/1%; R_0402_1005Metric
R6, R48: 120K/1%; R_0402_1005Metric
R7, R8, R53, R54, R56, R60, R61, R72: 20mR; R_0805_2012Metric
R10, R18: 240K/1%; R_0402_1005Metric
R11, R12, R14, R16, R17, R19, R21, R23, R31, R42, R47, R49, R65: 10K/1%; R_0402_1005Metric
R15, R40, R100: 100R/1%; R_0402_1005Metric
R20, R22, R37, R43, R104, R105: 1K/1%; R_0402_1005Metric
R24, R88: 390K/1%; R_0402_1005Metric
R45, R50, R96, R98, R115, R117: 1M/1%; R_0402_1005Metric
R46, R63, R66, R109: 33R/1%; R_0402_1005Metric
R79: 13K/1%; R_0402_1005Metric
R102: 240R/1%; R_0402_1005Metric
R123: 470K/1%; R_0402_1005Metric
RN7, RN8, RN9, RN10, RN11, RN12, RN13: 33R / 4D02WGF330JTCE; R_Array_Convex_4x0402
SW1, SW2, SW3: SW; Panasonic_EVQPUL_EVQPUC
U1: XC6SLX-FTG256; Xilinx_FTG256
U2, U5, U20, U28: SY8113C; TSOT-23-6
U3: STM32H750VBTx; LQFP-100_14x14mm_P0.5mm
U4, U6, U10: MT9700; SOT-23-5
U7, U8: TPS22914BYFPR; WLP-4_0.83x0.83mm_P0.4mm
U9, U26: LGS5145; TSOT-23-6
U11: LM321; SOT-23-5
U12: MT41K64M16TW; BGA-96_9.0x14.0mm_P0.8mm
U13: JW3651QFNE; QFN15_3X4_JW3651
U14: W25Q32JV; WSON-8-1EP_6x5mm_P1.27mm_EP3.4x4.3mm
U15: ADV7611; LQFP-64-1EP_10x10mm_P0.5mm_EP5x5mm
U16: USBLC6-2P6; SOT-666-Alt
U17: FUSB302BMPX; WQFN-14-1EP_2.5x2.5mm_P0.5mm_EP1.45x1.45mm
U18: CBTL02043A; WQFN-20-1EP_2.5x4.5mm_P0.5mm_EP1x2.9mm
U19: PTN3460; QFN-56-1EP_7x7mm_P0.4mm_EP5.6x5.6mm
U21, U22, U27: INA3221; Texas_RGV0016A_VQFN-16-1EP_4x4mm_P0.65mm_EP2.1x2.1mm
U23, U24: LGS6302B5; SOT-23-5
X1: 33.33MHz; Oscillator_SMD_Abracon_ASE-4Pin_3.2x2.5mm
Y1, Y3: 24MHz; Crystal_SMD_3225-4Pin_3.2x2.5mm
Y2: 32.768K; Crystal_SMD_TXC_9HT11-2Pin_2.0x1.2mm_HandSoldering

Connections:
+1V2_DCDC: C66.1, C67.1, L3.2, R57.1, R60.2, U27.15 (IN+2)
+1V2_FPGA: C18.1, C20.1, C22.1, C24.1, C57.1, C59.1, C68.1, R60.1, U1.G7 (VCCINT), U1.G9 (VCCINT), U1.H8 (VCCINT), U1.H10 (VCCINT), U1.J7 (VCCINT), U1.J9 (VCCINT), U1.K8 (VCCINT), U1.K10 (VCCINT), U27.14 (IN-2)
+1V8_DCDC: C14.1, C154.1, L1.2, R7.2, R10.1, U22.12 (IN+1)
+1V8_VID: C116.1, C119.1, C122.1, C132.1, C133.1, C134.1, C135.1, C136.1, C137.1, C138.1, C139.1, C161.1, R7.1, U15.2 (CVDD), U15.14 (CVDD), U15.24 (DVDD), U15.40 (DVDD), U15.52 (DVDD), U15.57 (PVDD), U15.60 (DVDD), U19.6 (VDD18), U19.45 (VDD18), U22.11 (IN-1)
+1V35: C16.1, C71.1, C72.1, C74.1, C75.1, C77.1, C78.1, C79.1, C80.1, C81.1, C82.1, C83.1, C84.1, C85.1, C86.1, C87.1, C88.1, C148.1, C157.1, C185.1, C189.1, R56.1, R104.1, U1.D2 (VCCO_3), U1.G4 (VCCO_3), U1.J2 (VCCO_3), U1.K4 (VCCO_3), U1.N2 (VCCO_3), U12.A1 (VDDQ), U12.A8 (VDDQ), U12.B2 (VDD), U12.C1 (VDDQ), U12.C9 (VDDQ), U12.D2 (VDDQ), U12.D9 (VDD), U12.E9 (VDDQ), U12.F1 (VDDQ), U12.G7 (VDD), U12.H2 (VDDQ), U12.H9 (VDDQ), U12.K2 (VDD), U12.K8 (VDD), U12.N1 (VDD), U12.N9 (VDD), U12.R1 (VDD), U12.R9 (VDD), U27.11 (IN-1)
+1V35_DCDC: C12.1, C155.1, L8.2, R5.1, R56.2, U27.12 (IN+1)
+3V3: C3.1, C19.1, C21.1, C23.1, C25.1, C26.1, C30.1, C31.1, C34.1, C36.1, C39.1, C40.1, C43.1, C58.1, C60.1, C92.1, C93.1, C114.1, C115.1, C149.1, C150.1, C156.1, C182.1, C183.1, C184.1, C186.1, C187.1, C188.1, C190.1, C207.2, C214.1, C215.1, FB3.1, J2.1, J5.12, J6.6, J6.45, J7.4 (VDD), Q7.2 (S), R12.1, R14.1, R35.1, R37.1, R61.1, R65.1, SW1.2, SW2.2, SW3.2, U1.B4 (VCCO_0), U1.B9 (VCCO_0), U1.B13 (VCCO_0), U1.D7 (VCCO_0), U1.D10 (VCCO_0), U1.D15 (VCCO_1), U1.E5 (VCCAUX), U1.F8 (VCCAUX), U1.F11 (VCCAUX), U1.G10 (VCCAUX), U1.G13 (VCCO_1), U1.H6 (VCCAUX), U1.J10 (VCCAUX), U1.J15 (VCCO_1), U1.K13 (VCCO_1), U1.L6 (VCCAUX), U1.L9 (VCCAUX), U1.N7 (VCCO_2), U1.N10 (VCCO_2), U1.N11 (IO_L13P_M1_2), U1.N15 (VCCO_1), U1.R4 (VCCO_2), U1.R8 (VCCO_2), U1.R13 (VCCO_1), U1.T11 (IO_L1N_M0_CMPMISO_2), U3.6 (VBAT), U3.11 (VDD), U3.27 (VDD), U3.50 (VDD), U3.75 (VDD), U3.100 (VDD), U14.8 (VCC), U17.3 (VDD), U17.4 (VDD), U18.1 (VDD), U18.6 (VDD), U18.10 (VDD), U21.1 (IN-3), U22.5 (A0), X1.1 (EN), X1.4 (Vdd)
+3V3A: C47.1, C48.1, C50.1, FB3.2, U3.20 (VREF+), U3.21 (VDDA)
+3V3_DCDC: C11.1, C15.1, C141.1, C142.1, C143.1, L2.2, R3.1, R8.2, R61.2, R116.2, R118.2, U21.2 (IN+3), U21.4 (VS), U21.16 (VPU), U22.4 (VS), U22.15 (IN+2), U22.16 (VPU), U27.4 (VS), U27.16 (VPU)
+3V3_VID: C126.1, C127.1, C128.1, C129.1, C130.1, C131.1, C162.1, FB1.1, FB2.1, R8.1, U15.5 (TVDD), U15.8 (TVDD), U15.11 (TVDD), U15.23 (DVDDIO), U15.34 (DVDDIO), U15.44 (DVDDIO), U22.14 (IN-2)
+5V: C1.2, C2.2, C4.2, C5.2, C27.2, C64.2, C103.2, C151.2, C152.2, C179.1, U2.4 (~SHDN), U2.5 (IN), U4.1 (VOUT), U5.4 (~SHDN), U5.5 (IN), U10.5 (VIN), U20.4 (~SHDN), U20.5 (IN), U28.4 (~SHDN), U28.5 (IN)
+5V2_FL: C147.1, J6.7, J6.44, R72.1, U22.1 (IN-3)
+5V_DCDC: C95.1, C96.2, C97.2, C104.2, R72.2, R123.1, U4.4 (EN), U4.5 (VIN), U6.5 (VIN), U13.4 (VO), U22.2 (IN+3)
+5V_EG: C33.2, C178.1, R54.2, U8.A2 (IN), U9.5 (IN), U21.14 (IN-2)
+5V_EPD: C37.2, C42.2, C45.2, C49.2, C51.2, C53.2, C160.2, Q1.2 (S), R28.2, R30.1, R53.1, R54.1, U6.1 (VOUT), U11.5 (V+), U21.12 (IN+1), U21.15 (IN+2)
+5V_ES: C172.1, C173.2, R53.2, U7.A2 (IN), U21.11 (IN-1), U26.5 (IN)
+5V_HDMI: J4.18 (+5V), R16.2, R49.2, U15.64 (RXA_5V)
+DRAM_VREF: C69.1, C70.1, C73.1, C76.1, C88.2, C144.1, R104.2, R105.1, U1.A3 (IO_L83N_VREF_3), U1.M3 (IO_L1N_VREF_3), U12.H1 (VrefDQ), U12.M8 (VrefCA)
+VBUS: F1.1, J1.A4 (VBUS), J1.A9 (VBUS), J1.B4 (VBUS), J1.B9 (VBUS), R50.1, U16.5 (VBUS), U17.2 (VBUS)
+VGH: C41.2, C44.2, C62.1, D2.1 (K), J6.3, R24.2, R98.2
+VP: C158.1, C165.2, C166.2, C167.2, D15.1 (K), J6.49, R78.2, R96.2
-VCOM: C56.2, C61.1, J6.5, Q6.3 (D), R64.2
-VGL: C33.1, C46.1, C63.1, D3.2 (A), D6.2 (A), J6.1, R19.1, R94.1, R117.1, U9.2 (GND)
-VN: C54.2, C159.1, C173.1, C176.1, C177.1, D6.1 (K), D17.2 (A), J6.47, R26.1, R34.1, R62.2, R89.1, R115.1, U11.2 (V-), U26.2 (GND)
/dp_in/CC1: D13.4 (IO3), D13.7 (NC2), J1.A5 (CC1), U17.10 (CC1), U17.11 (CC1)
/dp_in/CC2: D13.5 (IO4), D13.6 (NC1), J1.B5 (CC2), U17.1 (CC2), U17.14 (CC2)
/dp_in/DP0N: U18.7 (A1_P), U19.5 (DP0_N)
/dp_in/DP0P: U18.8 (A1_N), U19.4 (DP0_P)
/dp_in/DP1N: U18.3 (A0_P), U19.8 (DP1_N)
/dp_in/DP1P: U18.4 (A0_N), U19.7 (DP1_P)
/dp_in/DPAUXN: C112.2, U19.1 (AUX_N)
/dp_in/DPAUXP: C111.2, U19.2 (AUX_P)
/dp_in/RX1N: C105.1, D11.2 (IO2), D11.9 (NC3), J1.A3 (TX1-)
/dp_in/RX1NC: C105.2, U18.13 (C1_P)
/dp_in/RX1P: C106.1, D11.1 (IO1), D11.10 (NC4), J1.A2 (TX1+)
/dp_in/RX1PC: C106.2, U18.12 (C1_N)
/dp_in/RX2N: C109.1, D12.2 (IO2), D12.9 (NC3), J1.B3 (TX2-)
/dp_in/RX2NC: C109.2, U18.17 (B1_P)
/dp_in/RX2P: C110.1, D12.1 (IO1), D12.10 (NC4), J1.B2 (TX2+)
/dp_in/RX2PC: C110.2, U18.16 (B1_N)
/dp_in/SBU1: C112.1, D13.2 (IO2), D13.9 (NC3), J1.A8 (SBU1)
/dp_in/SBU2: C111.1, D13.1 (IO1), D13.10 (NC4), J1.B8 (SBU2)
/dp_in/TX1N: C7.1, D11.5 (IO4), D11.6 (NC1), J1.B10 (RX1-)
/dp_in/TX1NC: C7.2, U18.15 (C0_P)
/dp_in/TX1P: C55.1, D11.4 (IO3), D11.7 (NC2), J1.B11 (RX1+)
/dp_in/TX1PC: C55.2, U18.14 (C0_N)
/dp_in/TX2N: C107.1, D12.5 (IO4), D12.6 (NC1), J1.A10 (RX2-)
/dp_in/TX2NC: C107.2, U18.19 (B0_P)
/dp_in/TX2P: C108.1, D12.4 (IO3), D12.7 (NC2), J1.A11 (RX2+)
/dp_in/TX2PC: C108.2, U18.18 (B0_N)
/epd_power/+5V_VGH: C32.2, L5.1, U8.A1 (OUT), U24.4 (EN), U24.5 (IN)
/epd_power/+5V_VSH: C17.2, L10.1, U7.A1 (OUT), U23.4 (EN), U23.5 (IN)
/epd_power/EN_VGL: R93.1, R94.2, U9.4 (~SHDN)
/epd_power/EN_VN: R34.2, R92.1, U26.4 (~SHDN)
/fpga_ddr/DRAM_ADDR0: U1.K5 (IO_L47P_M3A0_3), U12.N3 (A0)
/fpga_ddr/DRAM_ADDR1: U1.K6 (IO_L47N_M3A1_3), U12.P7 (A1)
/fpga_ddr/DRAM_ADDR2: U1.D1 (IO_L49N_M3A2_3), U12.P3 (A2)
/fpga_ddr/DRAM_ADDR3: U1.L4 (IO_L45P_M3A3_3), U12.N2 (A3)
/fpga_ddr/DRAM_ADDR4: U1.G5 (IO_L51N_M3A4_3), U12.P8 (A4)
/fpga_ddr/DRAM_ADDR5: U1.H4 (IO_L44P_GCLK21_M3A5_3), U12.P2 (A5)
/fpga_ddr/DRAM_ADDR6: U1.H3 (IO_L44N_GCLK20_M3A6_3), U12.R8 (A6)
/fpga_ddr/DRAM_ADDR7: U1.D3 (IO_L49P_M3A7_3), U12.R2 (A7)
/fpga_ddr/DRAM_ADDR8: U1.B2 (IO_L52P_M3A8_3), U12.T8 (A8)
/fpga_ddr/DRAM_ADDR9: U1.A2 (IO_L52N_M3A9_3), U12.R3 (A9)
/fpga_ddr/DRAM_ADDR10: U1.G6 (IO_L51P_M3A10_3), U12.L7 (A10)
/fpga_ddr/DRAM_ADDR11: U1.E3 (IO_L54N_M3A11_3), U12.R7 (A11)
/fpga_ddr/DRAM_ADDR12: U1.F3 (IO_L53N_M3A12_3), U12.N7 (A12/~BC)
/fpga_ddr/DRAM_ADDR13: U1.F6 (IO_L55P_M3A13_3), U12.T3 (A13)
/fpga_ddr/DRAM_ADDR14: U1.F5 (IO_L55N_M3A14_3), U12.T7 (A14/NC)
/fpga_ddr/DRAM_BA0: U1.C3 (IO_L48P_M3BA0_3), U12.M2 (BA0)
/fpga_ddr/DRAM_BA1: U1.C2 (IO_L48N_M3BA1_3), U12.N8 (BA1)
/fpga_ddr/DRAM_BA2: U1.B1 (IO_L50N_M3BA2_3), U12.M3 (BA2)
/fpga_ddr/DRAM_CASB: U1.H5 (IO_L43N_GCLK22_IRDY2_M3CASN_3), U12.K3 (~CAS)
/fpga_ddr/DRAM_CKE: R44.1, U1.F4 (IO_L53P_M3CKE_3), U12.K9 (CKE)
/fpga_ddr/DRAM_CKN: R100.1, U1.E1 (IO_L46N_M3CLKN_3), U12.K7 (~CK)
/fpga_ddr/DRAM_CKP: R100.2, U1.E2 (IO_L46P_M3CLK_3), U12.J7 (CK)
/fpga_ddr/DRAM_CSB: R101.1, U12.L2 (~CS)
/fpga_ddr/DRAM_DATA0: U1.K2 (IO_L37P_M3DQ0_3), U12.E3 (DQ0)
/fpga_ddr/DRAM_DATA1: U1.K1 (IO_L37N_M3DQ1_3), U12.F7 (DQ1)
/fpga_ddr/DRAM_DATA2: U1.J3 (IO_L38P_M3DQ2_3), U12.F2 (DQ2)
/fpga_ddr/DRAM_DATA3: U1.J1 (IO_L38N_M3DQ3_3), U12.F8 (DQ3)
/fpga_ddr/DRAM_DATA4: U1.F2 (IO_L41P_GCLK27_M3DQ4_3), U12.H3 (DQ4)
/fpga_ddr/DRAM_DATA5: U1.F1 (IO_L41N_GCLK26_M3DQ5_3), U12.H8 (DQ5)
/fpga_ddr/DRAM_DATA6: U1.G3 (IO_L40P_M3DQ6_3), U12.G2 (DQ6)
/fpga_ddr/DRAM_DATA7: U1.G1 (IO_L40N_M3DQ7_3), U12.H7 (DQ7)
/fpga_ddr/DRAM_DATA8: U1.L3 (IO_L36P_M3DQ8_3), U12.D7 (DQ8)
/fpga_ddr/DRAM_DATA9: U1.L1 (IO_L36N_M3DQ9_3), U12.C3 (DQ9)
/fpga_ddr/DRAM_DATA10: U1.M2 (IO_L35P_M3DQ10_3), U12.C8 (DQ10)
/fpga_ddr/DRAM_DATA11: U1.M1 (IO_L35N_M3DQ11_3), U12.C2 (DQ11)
/fpga_ddr/DRAM_DATA12: U1.P2 (IO_L33P_M3DQ12_3), U12.A7 (DQ12)
/fpga_ddr/DRAM_DATA13: U1.P1 (IO_L33N_M3DQ13_3), U12.A2 (DQ13)
/fpga_ddr/DRAM_DATA14: U1.R2 (IO_L32P_M3DQ14_3), U12.B8 (DQ14)
/fpga_ddr/DRAM_DATA15: U1.R1 (IO_L32N_M3DQ15_3), U12.A3 (DQ15)
/fpga_ddr/DRAM_LDM: U1.J4 (IO_L42N_GCLK24_M3LDM_3), U12.E7 (LDM)
/fpga_ddr/DRAM_LDQSN: U1.H1 (IO_L39N_M3LDQSN_3), U12.G3 (~LDQS)
/fpga_ddr/DRAM_LDQSP: U1.H2 (IO_L39P_M3LDQS_3), U12.F3 (LDQS)
/fpga_ddr/DRAM_ODT: U1.L5 (IO_L45N_M3ODT_3), U12.K1 (ODT)
/fpga_ddr/DRAM_RASB: U1.J6 (IO_L43P_GCLK23_M3RASN_3), U12.J3 (~RAS)
/fpga_ddr/DRAM_RST: R103.1, U1.E4 (IO_L54P_M3RESET_3), U12.T2 (~RESET)
/fpga_ddr/DRAM_UDM: U1.K3 (IO_L42P_GCLK25_TRDY2_M3UDM_3), U12.D3 (UDM)
/fpga_ddr/DRAM_UDQSN: U1.N1 (IO_L34N_M3UDQSN_3), U12.B7 (~UDQS)
/fpga_ddr/DRAM_UDQSP: U1.N3 (IO_L34P_M3UDQS_3), U12.C7 (UDQS)
/fpga_ddr/DRAM_WEB: U1.C1 (IO_L50P_M3WE_3), U12.L3 (~WE)
/fpga_io/LED: R11.1, U1.C15 (IO_L33P_A15_M1A10_1)
/mcu/G_LED: R42.1, U3.97 (PE0)
/mcu/OSC32_IN: C13.1, U3.8 (PC14), Y2.1
/mcu/OSC32_OUT: C28.1, U3.9 (PC15), Y2.2
/mcu/OSC_IN: C6.1, U3.12 (PH0), Y1.1
/mcu/OSC_OUT: R20.1, U3.13 (PH1)
/mcu/R_LED: R43.1, U3.98 (PE1)
/power/EVDD: C94.2, U13.7 (EN), U13.13 (VCC), U13.15 (CSN)
/tmds_in/ADV_CK: R46.2, U15.25 (LLC)
/tmds_in/ADV_DE: RN7.4 (R4.1), U15.45 (DE)
/tmds_in/ADV_HS: RN7.3 (R3.1), U15.46 (HS)
/tmds_in/ADV_P0: RN13.1 (R1.1), U15.43 (P0)
/tmds_in/ADV_P1: RN13.2 (R2.1), U15.42 (P1)
/tmds_in/ADV_P2: RN13.3 (R3.1), U15.41 (P2)
/tmds_in/ADV_P3: RN13.4 (R4.1), U15.39 (P3)
/tmds_in/ADV_P4: RN12.1 (R1.1), U15.38 (P4)
/tmds_in/ADV_P5: RN12.2 (R2.1), U15.37 (P5)
/tmds_in/ADV_P6: RN12.3 (R3.1), U15.36 (P6)
/tmds_in/ADV_P7: RN12.4 (R4.1), U15.35 (P7)
/tmds_in/ADV_P8: RN8.1 (R1.1), U15.33 (P8)
/tmds_in/ADV_P9: RN8.2 (R2.1), U15.32 (P9)
/tmds_in/ADV_P10: RN8.3 (R3.1), U15.31 (P10)
/tmds_in/ADV_P11: RN8.4 (R4.1), U15.30 (P11)
/tmds_in/ADV_P12: RN9.1 (R1.1), U15.29 (P12)
/tmds_in/ADV_P13: RN9.2 (R2.1), U15.28 (P13)
/tmds_in/ADV_P14: RN9.3 (R3.1), U15.27 (P14)
/tmds_in/ADV_P15: RN9.4 (R4.1), U15.26 (P15)
/tmds_in/ADV_P16: RN11.1 (R1.1), U15.22 (P16)
/tmds_in/ADV_P17: RN11.2 (R2.1), U15.21 (P17)
/tmds_in/ADV_P18: RN11.3 (R3.1), U15.20 (P18)
/tmds_in/ADV_P19: RN11.4 (R4.1), U15.19
/tmds_in/ADV_P20: RN10.1 (R1.1), U15.18 (P20)
/tmds_in/ADV_P21: RN10.2 (R2.1), U15.17 (P21)
/tmds_in/ADV_P22: RN10.3 (R3.1), U15.16 (P22)
/tmds_in/ADV_P23: RN10.4 (R4.1), U15.15 (P23)
/tmds_in/ADV_VS: RN7.2 (R2.1), U15.47 (VS/FIELD/ALSB)
/tmds_in/HDMI_HPD: C170.1, J4.19 (HPD), R15.2, R47.2
/tmds_in/HDMI_SCL: J4.15 (SCL), R16.1, U15.62 (DDCA_SCL)
/tmds_in/HDMI_SDA: J4.16 (SDA), R49.1, U15.63 (DDCA_SDA)
/tmds_in/TMDS_CKN: D10.1 (IO1), D10.10 (NC4), J4.12 (CK-), U15.3 (RXA_C-)
/tmds_in/TMDS_CKP: D10.2 (IO2), D10.9 (NC3), J4.11 (CK+), U15.4 (RXA_C+)
/tmds_in/TMDS_D0N: D10.4 (IO3), D10.7 (NC2), J4.9 (D0-), U15.6 (RXA_0-)
/tmds_in/TMDS_D0P: D10.5 (IO4), D10.6 (NC1), J4.8 (D0+), U15.7 (RXA_0+)
/tmds_in/TMDS_D1N: D9.1 (IO1), D9.10 (NC4), J4.6 (D1-), U15.9 (RXA_1-)
/tmds_in/TMDS_D1P: D9.2 (IO2), D9.9 (NC3), J4.5 (D1+), U15.10 (RXA_1+)
/tmds_in/TMDS_D2N: D9.4 (IO3), D9.7 (NC2), J4.3 (D2-), U15.12 (RXA_2-)
/tmds_in/TMDS_D2P: D9.5 (IO4), D9.6 (NC1), J4.2 (D2+), U15.13 (RXA_2+)
DEC_RST: U3.87 (PD6), U15.56 (~RESET), U19.9 (RST_N)
DPI_B2: RN13.6 (R3.2), U1.T14 (IO_L51P_M1DQ12_1)
DPI_B3: RN13.5 (R4.2), U1.R14 (IO_L50P_M1UDQS_1)
DPI_B4: RN12.8 (R1.2), U1.N14 (IO_L45P_A1_M1LDQS_1)
DPI_B5: RN12.7 (R2.2), U1.P15 (IO_L48P_HDC_M1DQ8_1)
DPI_B6: RN12.6 (R3.2), U1.M13 (IO_L74P_AWAKE_1)
DPI_B7: RN12.5 (R4.2), U1.M14 (IO_L74N_DOUT_BUSY_1)
DPI_DE: RN7.5 (R4.2), U1.T13 (IO_L51N_M1DQ13_1)
DPI_G2: RN8.6 (R3.2), U1.L12 (IO_L53P_1)
DPI_G3: RN8.5 (R4.2), U1.L13 (IO_L53N_VREF_1)
DPI_G4: RN9.8 (R1.2), U1.L14 (IO_L47P_FWE_B_M1DQ0_1)
DPI_G5: RN9.7 (R2.2), U1.K12 (IO_L42P_GCLK7_M1UDM_1)
DPI_G6: RN9.6 (R3.2), U1.K14 (IO_L41N_GCLK8_M1CASN_1)
DPI_G7: RN9.5 (R4.2), U1.J12 (IO_L40N_GCLK10_M1A6_1)
DPI_HS: RN7.6 (R3.2), U1.R12 (IO_L52P_M1DQ14_1)
DPI_PCLK: R46.1, U1.J13 (IO_L41P_GCLK9_IRDY1_M1RASN_1)
DPI_R2: RN11.6 (R3.2), U1.J14 (IO_L43P_GCLK5_M1DQ4_1)
DPI_R3: RN11.5 (R4.2), U1.H14 (IO_L39N_M1ODT_1)
DPI_R4: RN10.8 (R1.2), U1.H13 (IO_L39P_M1A3_1)
DPI_R5: RN10.7 (R2.2), U1.G12 (IO_L38P_A5_M1CLK_1)
DPI_R6: RN10.6 (R3.2), U1.G14 (IO_L36P_A9_M1BA0_1)
DPI_R7: RN10.5 (R4.2), U1.D14 (IO_L31P_A19_M1CKE_1)
DPI_VS: RN7.7 (R2.2), U1.T12 (IO_L52N_M1DQ15_1)
DP_HPD: U3.88 (PD7), U19.11 (HPDRX)
DP_PDN: R1.2, U3.84 (PD3), U19.10 (PD_N)
EPDC_CLKN: J3.2, U1.D8 (IO_L38P_0)
EPDC_CLKP: J3.3, U1.C8 (IO_L38N_VREF_0)
EPDC_D0N: J6.38, U1.C10 (IO_L37N_GCLK12_0)
EPDC_D0P: J6.39, U1.E10 (IO_L37P_GCLK13_0)
EPDC_D1N: J6.35, U1.B10 (IO_L35P_GCLK17_0)
EPDC_D1P: J6.36, U1.A10 (IO_L35N_GCLK16_0)
EPDC_D2N: J6.32, U1.E11 (IO_L64N_SCP4_0)
EPDC_D2P: J6.33, U1.F10 (IO_L64P_SCP5_0)
EPDC_D3N: J6.29, U1.D12 (IO_L66N_SCP0_0)
EPDC_D3P: J6.30, U1.D11 (IO_L66P_SCP1_0)
EPDC_D4N: J6.26, U1.C11 (IO_L39P_0)
EPDC_D4P: J6.27, U1.A11 (IO_L39N_0)
EPDC_D5N: J6.23, U1.B12 (IO_L62P_0)
EPDC_D5P: J6.24, U1.A12 (IO_L62N_VREF_0)
EPDC_D6N: J6.20, U1.C13 (IO_L63P_SCP7_0)
EPDC_D6P: J6.21, U1.A13 (IO_L63N_SCP6_0)
EPDC_D7N: J6.17, U1.B14 (IO_L65P_SCP3_0)
EPDC_D7P: J6.18, U1.A14 (IO_L65N_SCP2_0)
EPDC_D8N: J3.14, U1.A7 (IO_L6N_0)
EPDC_D8P: J3.15, U1.C7 (IO_L6P_0)
EPDC_D9N: J3.11, U1.E8 (IO_L36N_GCLK14_0)
EPDC_D9P: J3.12, U1.E7 (IO_L36P_GCLK15_0)
EPDC_D10N: J3.8, U1.B8 (IO_L33P_0)
EPDC_D10P: J3.9, U1.A8 (IO_L33N_0)
EPDC_D11N: J3.5, U1.C9 (IO_L34P_GCLK19_0)
EPDC_D11P: J3.6, U1.A9 (IO_L34N_GCLK18_0)
EPDC_GDCLK: J6.13, U1.B16 (IO_L29N_A22_M1A14_1)
EPDC_GDOE: J6.11, U1.D16 (IO_L31N_A18_M1A12_1)
EPDC_GDSP: J6.12, U1.C16 (IO_L33N_A14_M1A4_1)
EPDC_SDCE0: J6.10, U1.E15 (IO_L34P_A13_M1WE_1)
EPDC_SDLE: J6.9, U1.E16 (IO_L34N_A12_M1BA2_1)
EPDC_SDOE: J6.8, U1.F15 (IO_L35P_A11_M1A7_1)
EPDC_SE_CLK: J6.15, U1.B15 (IO_L29P_A23_M1A13_1)
EPD_POS_EN: U3.42 (PE12), U7.B2 (ON), U8.B2 (ON)
EPD_PWR_EN: R22.1, U6.4 (EN), U21.9 (CRITICAL)
EPD_THROT: U1.M16 (IO_L46N_FOE_B_M1DQ3_1), U3.83 (PD2)
FL_EN: J6.43, U3.45 (PE15)
FL_PWM1: J6.41, U3.43 (PE13)
FL_PWM2: J6.42, U3.44 (PE14)
FMC_A16: U1.L16 (IO_L47N_LDC_M1DQ1_1), U3.58 (PD11)
FMC_D0: U1.M15 (IO_L46P_FCS_B_M1DQ2_1), U3.61 (PD14)
FMC_D1: U1.R16 (IO_L49N_M1DQ11_1), U3.62 (PD15)
FMC_D2: U1.F16 (IO_L35N_A10_M1A2_1), U3.81 (PD0)
FMC_D3: U1.G16 (IO_L36N_A8_M1BA1_1), U3.82 (PD1)
FMC_D4: U1.H15 (IO_L37P_A7_M1A0_1), U3.37 (PE7)
FMC_D5: U1.H16 (IO_L37N_A6_M1A1_1), U3.38 (PE8)
FMC_D6: U1.J16 (IO_L43N_GCLK4_M1DQ5_1), U3.39 (PE9)
FMC_D7: U1.K15 (IO_L44P_A3_M1DQ6_1), U3.40 (PE10)
FMC_NE1: U1.P16 (IO_L48N_M1DQ9_1), U3.64 (PC7)
FMC_NOE: U1.K16 (IO_L44N_A2_M1DQ7_1), U3.85 (PD4)
FMC_NWE: U1.N16 (IO_L45N_A0_M1LDQSN_1), U3.86 (PD5)
FPGA_CS: U1.L10 (IO_L16P_2), U3.51 (PB12)
FPGA_DONE: R37.2, U1.P13 (DONE_2), U3.79 (PC11)
FPGA_MISO: U1.T10 (IO_L3N_MOSI_CSI_B_MISO0_2), U3.17 (PC2_C)
FPGA_MOSI: U1.P10 (IO_L3P_D0_DIN_MISO_MISO1_2), U3.18 (PC3_C)
FPGA_PROG: R35.2, U1.T2 (PROGRAM_B_2), U3.78 (PC10)
FPGA_SCLK: U1.R11 (IO_L1P_CCLK_2), U3.52 (PB13)
FPGA_SUSP: R36.1, U1.P14 (SUSPEND), U3.80 (PC12)
FPGA_TCK: J5.1, U1.C14 (TCK)
FPGA_TDI: J5.3, U1.C12 (TDI)
FPGA_TDO: J5.5, U1.E14 (TDO)
FPGA_TMS: J5.7, U1.A15 (TMS)
GCLK: R109.2, U1.K11 (IO_L42N_GCLK6_TRDY1_M1LDM_1), U1.M9 (IO_L29P_GCLK3_2)
GND: C1.1, C2.1, C3.2, C4.1, C5.1, C6.2, C10.2, C13.2, C14.2, C15.2, C16.2, C17.1, C18.2, C19.2, C20.2, C21.2, C22.2, C23.2, C24.2, C25.2, C26.2, C27.1, C28.2, C29.1, C30.2, C31.2, C32.1, C34.2, C36.2, C37.1, C38.2, C39.2, C40.2, C42.1, C43.2, C44.1, C45.1, C46.2, C47.2, C48.2, C49.1, C50.2, C51.1, C52.1, C53.1, C54.1, C56.1, C57.2, C58.2, C59.2, C60.2, C61.2, C62.2, C63.2, C64.1, C67.2, C68.2, C69.2, C70.2, C71.2, C72.2, C73.2, C74.2, C75.2, C76.2, C77.2, C78.2, C79.2, C80.2, C81.2, C82.2, C83.2, C84.2, C85.2, C86.2, C87.2, C89.1, C90.1, C91.2, C92.2, C93.2, C94.1, C96.1, C97.1, C98.1, C99.1, C102.1, C103.1, C104.1, C113.2, C114.2, C115.2, C116.2, C117.2, C118.2, C119.2, C120.2, C121.2, C122.2, C123.2, C124.2, C125.2, C126.2, C127.2, C128.2, C129.2, C130.2, C131.2, C132.2, C133.2, C134.2, C135.2, C136.2, C137.2, C138.2, C139.2, C140.1, C141.2, C142.2, C143.2, C144.2, C145.1, C146.1, C147.2, C148.2, C149.2, C150.2, C151.1, C152.1, C155.2, C156.2, C157.2, C158.2, C159.2, C160.1, C161.2, C162.2, C163.1, C164.1, C166.1, C167.1, C168.1, C169.1, C170.2, C171.1, C172.2, C175.2, C176.2, C177.2, C178.2, C179.2, C182.2, C183.2, C184.2, C185.2, C186.2, C187.2, C188.2, C189.2, C190.2, C207.1, C214.2, C215.2, D5.2 (A), D8.1 (K), D9.3 (GND), D9.8 (GND), D10.3 (GND), D10.8 (GND), D11.3 (GND), D11.8 (GND), D12.3 (GND), D12.8 (GND), D13.3 (GND), D13.8 (GND), D19.1 (K), D20.1 (K), H1.1, H3.1, H4.1, H5.1, H6.1, H7.1, H8.1, H9.1, H12.1, H13.1, H14.1, H15.1, H16.1, H17.1, H18.1, H19.1, H20.1, H21.1, H22.1, H23.1, H25.1, H26.1, J1.A1 (GND), J1.A12 (GND), J1.B1 (GND), J1.B12 (GND), J1.S1 (SHIELD), J2.8, J3.1, J3.4, J3.7, J3.10, J3.13, J3.16, J3.MP (MountPin), J4.1 (D2S), J4.4 (D1S), J4.7 (D0S), J4.10 (CKS), J4.13 (GND), J4.SH, J5.2, J5.4, J5.6, J5.8, J5.10, J6.14, J6.16, J6.19, J6.22, J6.25, J6.28, J6.31, J6.34, J6.37, J6.40, J6.MP (MountPin), J7.6 (VSS), J7.10, J7.11, J7.12, J7.13, L6.2, L12.2, Q2.2 (E), R1.1, R2.1, R4.2, R6.2, R9.1, R17.1, R18.2, R21.1, R23.1, R25.1, R29.1, R31.1, R36.2, R40.2, R44.2, R48.2, R51.2, R58.2, R79.1, R87.1, R88.2, R97.1, R101.2, R102.2, R103.2, R105.2, R124.1, U1.A1 (GND), U1.A16 (GND), U1.B7 (GND), U1.B11 (GND), U1.D4 (GND), U1.D13 (GND), U1.E9 (GND), U1.G2 (GND), U1.G8 (GND), U1.G15 (GND), U1.H7 (GND), U1.H9 (GND), U1.H12 (GND), U1.J5 (GND), U1.J8 (GND), U1.K7 (GND), U1.K9 (GND), U1.L2 (GND), U1.L15 (GND), U1.M8 (GND), U1.N13 (GND), U1.P3 (GND), U1.R6 (GND), U1.R10 (GND), U1.T1 (GND), U1.T16 (GND), U2.2 (GND), U3.10 (VSS), U3.19 (VSSA), U3.26 (VSS), U3.49 (VSS), U3.74 (VSS), U3.99 (VSS), U4.2 (GND), U5.2 (GND), U6.2 (GND), U7.B1 (GND), U8.B1 (GND), U10.2 (GND), U12.A9 (VSS), U12.B1 (VSSQ), U12.B3 (VSS), U12.B9 (VSSQ), U12.D1 (VSSQ), U12.D8 (VSSQ), U12.E1 (VSS), U12.E2 (VSSQ), U12.E8 (VSSQ), U12.F9 (VSSQ), U12.G1 (VSSQ), U12.G8 (VSS), U12.G9 (VSSQ), U12.J1 (VSS), U12.J2 (VSS), U12.J8 (VSS), U12.J9 (VSS), U12.L1 (VSS), U12.L9 (VSS), U12.M1 (VSS), U12.M9 (VSS), U12.P1 (VSS), U12.P9 (VSS), U12.T1 (VSS), U12.T9 (VSS), U13.1 (CSP), U13.3 (PGND), U13.6 (OLIM), U13.12 (TEST), U13.14 (GND), U14.4 (GND), U14.9 (EP), U15.65 (GND), U16.2 (GND), U17.8 (GND), U17.9 (GND), U17.12 (VCONN), U17.13 (VCONN), U17.15 (GND), U18.2 (XSD), U18.5 (GND), U18.11 (GND), U18.20 (GND), U18.21 (GND), U19.3 (GND), U19.17 (GNDREG), U19.18 (GNDREG), U19.56 (EPS_N), U19.57 (EP), U20.2 (GND), U21.3 (GND), U21.5 (A0), U21.17 (EP), U22.3 (GND), U22.17 (EP), U23.2 (GND), U24.2 (GND), U27.1 (IN-3), U27.2 (IN+3), U27.3 (GND), U27.17 (EP), U28.2 (GND), X1.2 (GND), Y1.2, Y1.4, Y3.2, Y3.4
HPD_EN: R23.2, U3.68 (PA9), U10.4 (EN)
I2C1_SCL: R14.2, U3.92 (PB6), U15.53 (SCL), U17.6 (SCL), U19.25 (MS_SCL), U21.6 (SCL), U22.6 (SCL), U27.6 (SCL)
I2C1_SDA: R12.2, U3.93 (PB7), U15.54 (SDA), U17.7 (SDA), U19.24 (MS_SDA), U21.7 (SDA), U22.7 (SDA), U27.5 (A0), U27.7 (SDA)
KEY1: R21.2, SW1.1, U3.3 (PE4), U3.94 (BOOT0)
KEY2: SW2.1, U3.91 (PB5)
KEY3: SW3.1, U3.2 (PE3)
LVDS_BKLTEN: U3.4 (PE5), U19.26 (BKLTEN)
LVDS_EVEN_AN: U1.T8 (IO_L30N_GCLK0_USERCCLK_2), U19.42 (LVSAE_N)
LVDS_EVEN_AP: U1.P8 (IO_L30P_GCLK1_D13_2), U19.41 (LVSAE_P)
LVDS_EVEN_BN: U1.T9 (IO_L23N_2), U19.40 (LVSBE_N)
LVDS_EVEN_BP: U1.R9 (IO_L23P_2), U19.39 (LVSBE_P)
LVDS_EVEN_CN: U1.M11 (IO_L2N_CMPMOSI_2), U19.37 (LVSCE_N)
LVDS_EVEN_CP: U1.M12 (IO_L2P_CMPCLK_2), U19.36 (LVSCE_P)
LVDS_ODD_AN: U1.T4 (IO_L63N_2), U19.54 (LVSAO_N)
LVDS_ODD_AP: U1.P4 (IO_L63P_2), U19.53 (LVSAO_P)
LVDS_ODD_BN: U1.T5 (IO_L48N_RDWR_B_VREF_2), U19.52 (LVSBO_N)
LVDS_ODD_BP: U1.R5 (IO_L48P_D7_2), U19.51 (LVSBO_P)
LVDS_ODD_CKN: U1.T7 (IO_L32N_GCLK28_2), U19.47 (LVSCKO_N)
LVDS_ODD_CKP: U1.R7 (IO_L32P_GCLK29_2), U19.46 (LVSCKO_P)
LVDS_ODD_CN: U1.T6 (IO_L47N_2), U19.49 (LVSCO_N)
LVDS_ODD_CP: U1.P6 (IO_L47P_2), U19.48 (LVSCO_P)
LVDS_PVCCEN: U3.5 (PE6), U19.33 (PVCCEN)
MCU_SWCLK: J5.9, U3.76 (PA14)
MCU_SWDIO: J5.11, U3.72 (PA13)
unnamed: C10.1, R20.2, Y1.3
unnamed: C117.1, C120.1, C123.1, FB1.2, U19.13 (VDD33), U19.14 (VDD33)
unnamed: C118.1, C121.1, C124.1, FB2.2, U19.38 (VDD33), U19.50 (VDD33)
unnamed: C89.2, C90.2, C145.2, C146.2, U3.48 (VCAP), U3.73 (VCAP)
unnamed: D1.2 (A), D4.2 (A), Q1.3 (D)
unnamed: D1.1 (K), R92.2
unnamed: D2.2 (A), L5.2, U24.1 (SW)
unnamed: C35.1, D3.1 (K), L6.1, U9.6 (SW)
unnamed: D4.1 (K), R93.2
unnamed: D8.2 (A), R11.2
unnamed: D15.2 (A), L10.2, U23.1 (SW)
unnamed: C174.1, D17.1 (K), L12.1, U26.6 (SW)
unnamed: D19.2 (A), R42.2
unnamed: D20.2 (A), R43.2
unnamed: J1.A6 (D+), J1.B6 (D+), U16.1 (I/O1)
unnamed: J1.A7 (D-), J1.B7 (D-), U16.3 (I/O2)
unnamed: Q1.1 (G), Q2.3 (C), R28.1
unnamed: Q2.1 (B), R29.2, R30.2
unnamed: Q6.1 (G), Q7.3 (D), R62.1
unnamed: Q6.2 (S), U11.3 (-), U11.4
unnamed: Q7.1 (G), R63.2
unnamed: Q8.3 (D), R64.1
unnamed: Q8.1 (G), R66.1
unnamed: R40.1, U1.M4 (IO_L1P_3)
unnamed: C9.2, U2.1 (BS)
unnamed: C12.2, R5.2, R6.1, U2.3 (FB)
unnamed: C9.1, L8.1, U2.6 (SW)
unnamed: C29.2, U3.14 (NRST)
unnamed: R22.2, U3.41 (PE11)
unnamed: R9.2, U4.3 (SET)
unnamed: C8.2, U5.1 (BS)
unnamed: C11.2, R3.2, R4.1, U5.3 (FB)
unnamed: C8.1, L2.1, U5.6 (SW)
unnamed: R17.2, U6.3 (SET)
unnamed: C35.2, U9.1 (BS)
unnamed: C38.1, R18.1, R19.2, U9.3 (FB)
unnamed: R31.2, U10.3 (SET)
unnamed: R47.1, U10.1 (VOUT)
unnamed: C52.2, R26.2, R27.1, U11.1 (+)
unnamed: R102.1, U12.L8 (ZQ)
unnamed: C101.1, U13.8 (BST1)
unnamed: C100.1, U13.11 (BST2)
unnamed: C95.2, R123.2, R124.2, U13.5 (FB)
unnamed: C101.2, L15.2, U13.9 (SW1)
unnamed: C100.2, L15.1, U13.10 (SW2)
unnamed: C98.2, C99.2, C102.2, C140.2, F1.2, U13.2 (VIN)
unnamed: R15.1, U15.1 (HPA_A/INT2)
unnamed: C125.1, R45.1, U15.59 (XTALN), Y3.3
unnamed: C113.1, R45.2, U15.58 (XTALP), Y3.1
unnamed: R2.2, U19.20 (TESTMODE)
unnamed: C153.2, U20.1 (BS)
unnamed: C154.2, R10.2, R48.1, U20.3 (FB)
unnamed: C153.1, L1.1, U20.6 (SW)
unnamed: C165.1, R78.1, R79.2, U23.3 (FB)
unnamed: C41.1, R13.1, R24.1, R25.2, U24.3 (FB)
unnamed: C174.2, U26.1 (BS)
unnamed: C175.1, R88.1, R89.2, U26.3 (FB)
unnamed: C65.2, U28.1 (BS)
unnamed: C66.2, R57.2, R58.1, U28.3 (FB)
unnamed: C65.1, L3.1, U28.6 (SW)
unnamed: R109.1, X1.3 (OUT)
QSPI_SCLK: U3.36 (PB2), U14.6 (CLK)
QSPI_SD0: U3.66 (PC9), U14.5 (DI(IO0))
QSPI_SD1: U3.59 (PD12), U14.2 (DO(IO1))
QSPI_SD2: U3.1 (PE2), U14.3 (IO2)
QSPI_SD3: U3.23 (PA1), U14.7 (IO3)
QSPI_SS: U3.46 (PB10), U14.1 (~CS)
SDIO_CLK: J7.5 (CLK/SCLK), U3.16 (PC1)
SDIO_CMD: J7.3 (CMD/DI), U3.22 (PA0)
SDIO_DAT0: J7.7 (DAT0/DO), U3.53 (PB14)
SDIO_DAT1: J7.8 (DAT1/RES), U3.54 (PB15)
SDIO_DAT2: J7.1 (DAT2/RES), U3.89 (PB3)
SDIO_DAT3: J7.2 (CD/DAT3/CS), U3.90 (PB4)
TCPC_INT: U3.77 (PA15), U17.5 (INT_N)
TYPEC_ORI: U3.69 (PA10), U18.9 (SEL)
USB_DN: U3.70 (PA11), U16.4 (I/O2)
USB_DP: U3.71 (PA12), U16.6 (I/O1)
USER_PB8: J2.6, U3.95 (PB8)
USER_PB9: J2.7, U3.96 (PB9)
USER_PD8: J2.2, U3.55 (PD8)
USER_PD9: J2.3, U3.56 (PD9)
USER_PD10: J2.4, U3.57 (PD10)
USER_PD13: J2.5, U3.60 (PD13)
VBUS_MEA: C91.1, R50.2, R51.1, U3.35 (PB1)
VCOM_DAC: D5.1 (K), R27.2, U3.28 (PA4)
VCOM_EN: R63.1, U3.25 (PA3)
VCOM_MEA: C171.2, Q8.2 (S), R65.2, U3.31 (PA7)
VCOM_MEA_EN: R66.2, U3.24 (PA2)
VGH_DAC: R13.2, U3.29 (PA5)
VGH_MEA: C164.2, R97.2, R98.1, U3.32 (PC4)
VGL_MEA: C169.2, R117.2, R118.1, U3.34 (PB0)
VN_MEA: C168.2, R115.2, R116.1, U3.33 (PC5)
VP_MEA: C163.2, R87.2, R96.1, U3.30 (PA6)
