UavL/Glider/pcb/r2-mainboard/datasheets/SiC OSD62x-PM/OSD62-PM-BRK-3/OSD62-PM-BRK.brd

## EAGLE design pcb/r2-mainboard/datasheets/SiC OSD62x-PM/OSD62-PM-BRK-3/OSD62-PM-BRK.brd (2026-09-11)

Schematic: OSD62-PM-BRK.sch

Parts:
C1, C2, C3, C6, C7, C8, C9, C10, C11, C12, C13, C14, C15, C17, C18, C19, C20, C61: 0.1uF; C0201; VOLTAGE 6.3V
C4, C62, C63: 1uF; C0402; VOLTAGE 6.3V
C5, C60: 4.7uF; C0402; VOLTAGE 10V
C16, C38, C39, C40, C42, C43, C44, C45, C51: 10uF; C0402; VOLTAGE 10V
C21, C22, C23, C41: 2.2uF; C0402; VOLTAGE 10V
C24, C26, C29, C34, C35, C36, C46, C50, C54, C55, C58: 0.1uF; C0402; VOLTAGE 6.3V
C25: 220uF; B/3528-21R
C27, C31, C32, C33, C37, C57: 10uF; C0603; VOLTAGE 10V
C28: DNP; C0402
C30: 120pF; C0402; VOLTAGE 10V
C47, C49, C53: 47uF; C0603; VOLTAGE 6.3V
C48, C52: 22uF; C0402; VOLTAGE 10V
C56: 47uF; C0805; VOLTAGE 10V
C59: 1nF; C0402; VOLTAGE 6.3V
D1: RED; EIA-STD
D2, D3, D4, D5: GREEN; EIA-STD
D6, D7: RB520S30T1G
D8: RBS2MM40C; SOD-123FL
FUD1, FUD2, FUD3, FUD4, FUD5, FUD6: FIDUCIAL; FIDUCIAL_40MIL
J1: PINHD-1X21.27; H1X2-1.27
J2, J7: PINHD-1X2; H1X2-2.54
J4: 1-1734248-5; TE_1-1734248-5
J5: USB4105-GF-A; GCT_USB4105-GF-A
J6: 2171820001; MOLEX_2171820001
J8: 505110-4091; MOLEX_505110-4091
JP1: PINHD-1X3; H1X3-2.54
JP2, JP3, JP4, JP5: PINHD-1X40; H1X40-2.54
L1, L4: 0.47uH; L0806
L2, L3: 0.47uH; L0603
R1, R3, R4, R7, R10, R11, R13, R14, R15, R16, R17, R18, R19, R20, R21, R22, R23, R24, R25, R26, R27, R28, R29, R30, R31, R32, R34, R37, R38, R39, R40, R41, R42, R43, R44, R45, R46, R47, R48, R49, R50, R51, R54, R63, R73, R76: 10k; R0402; TOLERANCE 5%
R2: 100k; R0402; TOLERANCE 5%
R5, R62: 20k; R0402; TOLERANCE 5%
R6: 100k; R0402; TOLERANCE 1%
R8: 270k; R0402; TOLERANCE 1%
R9: 180k; R0402; TOLERANCE 1%
R12, R64, R65, R66: 2k; R0402; TOLERANCE 5%
R33: 22; R0402; TOLERANCE 5%
R35, R36: 5.1K; R0402; TOLERANCE 1%
R52, R53: 4.7k; R0402; TOLERANCE 5%
R55, R56, R74: 0; R0402; TOLERANCE 5%
R57, R58, R59, R60, R61: 1k; R0402; TOLERANCE 5%
R67, R68, R69, R70: DNP; R0402; TOLERANCE 5%
R71, R72: 56K; R0402; TOLERANCE 5%
S1: MF-SW-TACT-4.2MM; TACT4.2MM
TC1: TC2050-IDC-NL
TP1, TP2, TP3, TP6, TP7: TPB0,65; TP_B0,65
U1: OSD6254-1G-IPM; OSD6254-BGA-500
U2, U9: TPD4S012_DRY_6_P1_P; DRY6
U3: TLV62595DMQR; DMQ0006A
U4: 24AA32AT-I/OT; SOT95P280X145-5N
U5: TPS22965DSGT; SON50P200X200X80-9N
U6: TPS6521903RHB; RHB0032W
U7, U8: ADC121C027CIMK; SOT95P280X110-6N
U10: TPS22918DBVR; SOT95P280X145-6N
U11: SN74LVC1G04DSFR; SON35P100X100X40-6N
U12, U13: SN74LVC2G241YZPR; YZP0008
U14: TLV75518PDQNR; DQN0004A
X1: MF-MICROSD
Y1: SIT1533AI-H4-D14-32.768; SIT1533AI_2X1.2MM
Y2: SIT8008BI-73-YYS-25.000000; QFN-4-2X1.6MM

Connections:
3V3_FB: C30.1, R6.2, R8.2, U3.3 (FB)
3V3_FB_0: R8.1, R9.2
3V3_SW: L1.1, U3.5 (SW)
ADC0_ADDR: R15.2, U7.4 (ADDR)
ADC1_ADDR: R16.1, U8.4 (ADDR)
BUCK1-0P75: C10.1, C11.1, C12.1, C13.1, C14.1, C15.1, C16.1, C53.1, L4.2, U1.G12 (VDD_CANUART), U1.G13 (VDD_CORE), U1.G14 (VDD_CORE), U1.G15 (VDD_CORE), U1.G16 (VDD_CORE), U1.H12 (VDD_CORE), U1.H13 (VDD_CORE), U1.H14 (VDD_CORE), U1.H15 (VDD_CORE), U1.H16 (VDD_CORE), U1.J12 (VDD_CORE), U1.J13 (VDD_CORE), U1.J16 (VDD_CORE), U1.K12 (VDD_CORE), U1.K13 (VDD_CORE), U1.K16 (VDD_CORE), U1.L13 (VDD_CORE), U1.L14 (VDD_CORE), U1.L15 (VDD_CORE), U1.M12 (VDDA_CORE_USB), U1.M13 (VDDA_CORE_CSIRX0), U6.1 (FB_B1)
BUCK2-1P8: C21.1, C38.1, C49.1, L3.2, U1.C15 (VMON_1P8_SOC), U6.20 (PVIN_LDO2), U6.32 (FB_B2)
BUCK3-1P2: C7.1, C8.1, C9.1, C47.1, L2.2, U1.K10 (VDDS_DDR), U1.K11 (VDDS_DDR), U1.L9 (VDDS_DDR), U1.L10 (VDDS_DDR), U1.L11 (VDDS_DDR), U1.M8 (VDDS_DDR), U1.M9 (VDDS_DDR), U1.M10 (VDDS_DDR), U1.N8 (VDDS_DDR), U1.N9 (VDDS_DDR), U6.24 (FB_B3)
CH1_LVDS_A0N: J8.11, U1.P2 (OLDI0_A0N)
CH1_LVDS_A0P: J8.12, U1.R1 (OLDI0_A0P)
CH1_LVDS_A1N: J8.14, U1.R2 (OLDI0_A1N)
CH1_LVDS_A1P: J8.15, U1.T1 (OLDI0_A1P)
CH1_LVDS_A2N: J8.20, U1.T2 (OLDI0_A2N)
CH1_LVDS_A2P: J8.21, U1.U2 (OLDI0_A2P)
CH1_LVDS_A3N: J8.23, U1.U3 (OLDI0_A3N)
CH1_LVDS_A3P: J8.24, U1.V3 (OLDI0_A3P)
CH1_LVDS_CLKN: J8.17, U1.U8 (OLDI0_CLK0N)
CH1_LVDS_CLKP: J8.18, U1.V8 (OLDI0_CLK0P)
CH2_LVDS_A0N: J8.26, U1.U4 (OLDI0_A4N)
CH2_LVDS_A0P: J8.27, U1.V4 (OLDI0_A4P)
CH2_LVDS_A1N: J8.29, U1.U5 (OLDI0_A5N)
CH2_LVDS_A1P: J8.30, U1.V5 (OLDI0_A5P)
CH2_LVDS_A2N: J8.35, U1.U6 (OLDI0_A6N)
CH2_LVDS_A2P: J8.36, U1.V6 (OLDI0_A6P)
CH2_LVDS_A3N: J8.38, U1.U7 (OLDI0_A7N)
CH2_LVDS_A3P: J8.39, U1.V7 (OLDI0_A7P)
CH2_LVDS_CLKN: J8.32, U1.U9 (OLDI0_CLK1N)
CH2_LVDS_CLKP: J8.33, U1.V9 (OLDI0_CLK1P)
CLICK0_AN: JP3.1, R56.2, U7.3 (VIN)
CLICK1_AN: JP4.40, R55.2, U8.3 (VIN)
CSI0_RXCLKN: J4.8, U1.V17 (CSI0_RXCLKN)
CSI0_RXCLKP: J4.9, U1.U17 (CSI0_RXCLKP)
CSI0_RXN0: J4.2, U1.V16 (CSI0_RXN0)
CSI0_RXN1: J4.5, U1.V15 (CSI0_RXN1)
CSI0_RXP0: J4.3, U1.U16 (CSI0_RXP0)
CSI0_RXP1: J4.6, U1.U15 (CSI0_RXP1)
EEPROM_WP: J2.2, R7.1, U4.5 (WP)
EMU0: R20.1, TC1.7, U1.D8 (EMU0)
EMU1: R21.1, TC1.10, U1.C8 (EMU1)
EXTINTN: R25.1, U1.C17 (EXTINTN), U6.11 (NINT)
EXT_REFCLK1: R56.1, U1.D16 (EXT_REFCLK1)
GND: C1.2, C2.2, C3.2, C4.2, C5.2, C6.2, C7.2, C8.2, C9.2, C10.2, C11.2, C12.2, C13.2, C14.2, C15.2, C16.2, C17.2, C18.2, C19.2, C20.2, C21.2, C22.2, C23.2, C24.2, C25.-, C26.2, C27.2, C28.2, C29.2, C31.2, C32.2, C33.2, C34.2, C35.2, C36.2, C37.2, C38.2, C39.2, C40.2, C41.2, C42.2, C43.2, C44.2, C45.2, C46.2, C47.2, C48.2, C49.2, C50.2, C51.2, C52.2, C53.2, C54.2, C55.2, C56.2, C57.2, C58.2, C59.2, C60.2, C61.2, C62.2, C63.2, D1.2 (C), D2.2 (C), D3.2 (C), D4.2 (C), D5.2 (C), J2.1, J4.1, J4.4, J4.7, J4.10, J5.A1_B12 (GND/A1/B12), J5.B1_A12 (GND/A12/B1), J5.SH1_B (SH1), J5.SH1_T (SH1), J5.SH2_B (SH2), J5.SH2_T (SH2), J5.SH3_B (SH3), J5.SH3_T (SH3), J5.SH4_B (SH4), J5.SH4_T (SH4), J6.A1 (GND), J6.A12 (GND), J6.B1 (GND), J6.B12 (GND), J6.SH_B_1 (SH1), J6.SH_B_2 (SH2), J6.SH_B_3 (SH3), J6.SH_B_4 (SH4), J6.SH_T_1 (SH1), J6.SH_T_2 (SH2), J6.SH_T_3 (SH3), J6.SH_T_4 (SH4), J8.6, J8.7, J8.10, J8.13, J8.16, J8.19, J8.22, J8.25, J8.28, J8.31, J8.34, J8.37, J8.40, J8.S1 (PAD1), J8.S2 (PAD2), JP1.1, JP2.33, JP2.40, JP3.8, JP3.33, JP4.8, JP4.33, JP5.1, JP5.30, JP5.40, R1.1, R3.1, R4.2, R6.1, R14.1, R15.1, R26.2, R27.2, R29.2, R34.2, R35.1, R36.1, R37.2, R39.2, R40.2, R41.2, R42.2, R63.2, R76.1, S1.P$3, S1.P$4, TC1.3, TC1.5, U1.A2 (VSS), U1.A14 (VSS), U1.A27 (VSS), U1.B1 (VSS), U1.B14 (VSS), U1.B28 (VSS), U1.C3 (VSS), U1.C4 (VSS), U1.C14 (VSS), U1.D3 (VSS), U1.D4 (VSS), U1.D14 (VSS), U1.E3 (VSS), U1.E4 (VSS), U1.E5 (VSS), U1.E6 (VSS), U1.E7 (VSS), U1.E8 (VSS), U1.E9 (VSS), U1.E10 (VSS), U1.E11 (VSS), U1.E12 (VSS), U1.E13 (VSS), U1.E16 (VSS), U1.E17 (VSS), U1.E18 (VSS), U1.E19 (VSS), U1.E20 (VSS), U1.E21 (VSS), U1.E22 (VSS), U1.E23 (VSS), U1.E24 (VSS), U1.F19 (VSS), U1.F20 (VSS), U1.F21 (VSS), U1.F22 (VSS), U1.F23 (VSS), U1.F24 (VSS), U1.G2 (MCU_OSC0_XO), U1.G19 (VSS), U1.G20 (VSS), U1.G23 (VSS), U1.G24 (VSS), U1.H2 (WKUP_LFOSC0_XO), U1.H19 (VSS), U1.H20 (VSS), U1.H24 (VSS), U1.J14 (VSS), U1.J15 (VSS), U1.J19 (VSS), U1.J20 (VSS), U1.J24 (VSS), U1.K6 (VSS), U1.K7 (VSS), U1.K8 (VSS), U1.K9 (VSS), U1.K14 (VSS), U1.K15 (VSS), U1.K19 (VSS), U1.K20 (VSS), U1.K24 (VSS), U1.L5 (VSS), U1.L6 (VSS), U1.L7 (VSS), U1.L8 (VSS), U1.L19 (VSS), U1.L20 (VSS), U1.L24 (VSS), U1.M4 (VSS), U1.M5 (VSS), U1.M6 (VSS), U1.M7 (VSS), U1.M20 (VSS), U1.M23 (VSS), U1.M24 (VSS), U1.N3 (VSS), U1.N4 (VSS), U1.N5 (VSS), U1.N6 (VSS), U1.N20 (VSS), U1.N21 (VSS), U1.N22 (VSS), U1.N23 (VSS), U1.N24 (VSS), U1.P3 (VSS), U1.P4 (VSS), U1.P5 (VSS), U1.P16 (VSS), U1.P17 (VSS), U1.P18 (VSS), U1.P19 (VSS), U1.P20 (VSS), U1.P21 (VSS), U1.P22 (VSS), U1.P23 (VSS), U1.P24 (VSS), U1.R3 (VSS), U1.R4 (VSS), U1.T3 (VSS), U1.T19 (VSS), U1.U1 (VSS), U1.U19 (VSS), U1.U28 (VSS), U1.V2 (VSS), U1.V19 (VSS), U1.V27 (VSS), U2.4 (GND), U3.4 (GND), U4.2 (VSS), U5.5 (GND), U5.9 (EXP), U6.15 (AGND), U6.PAD, U7.2 (GND), U8.2 (GND), U9.4 (GND), U10.2 (GND), U11.3 (GND), U12.A1 (1OEN), U12.D1 (GND), U13.A1 (1OEN), U13.D1 (GND), U14.2 (GND), U14.5 (EP), X1.G0 (GND), X1.G1 (GND), X1.PIN6 (VSS), Y1.2 (GND), Y2.2 (GND)
GPMC0_AD0: JP5.39, R51.1, U1.G28 (GPMC0_AD0)
GPMC0_AD1: JP5.38, R49.1, U1.G27 (GPMC0_AD1)
GPMC0_AD2: JP5.37, R42.1, U1.F28 (GPMC0_AD2)
GPMC0_AD3: JP5.36, R41.1, U1.F27 (GPMC0_AD3)
GPMC0_AD4: JP5.35, R40.1, U1.E28 (GPMC0_AD4)
GPMC0_AD5: JP5.34, R39.1, U1.E27 (GPMC0_AD5)
GPMC0_AD6: JP5.33, R38.1, U1.D28 (GPMC0_AD6)
GPMC0_AD7: JP5.32, R37.1, U1.D27 (GPMC0_AD7)
GPMC0_AD8: JP2.29, R34.1, U1.L27 (GPMC0_AD8)
GPMC0_AD9: JP3.29, R32.1, U1.L28 (GPMC0_AD9)
GPMC0_AD10: JP2.30, R31.1, U1.K27 (GPMC0_AD10)
GPMC0_AD11: JP3.30, R30.1, U1.K28 (GPMC0_AD11)
GPMC0_AD12: JP2.31, R29.1, U1.J28 (GPMC0_AD12)
GPMC0_AD13: JP3.31, R28.1, U1.J27 (GPMC0_AD13)
GPMC0_AD14: JP2.32, R27.1, U1.H28 (GPMC0_AD14)
GPMC0_AD15: JP3.32, R26.1, U1.H27 (GPMC0_AD15)
GPMC0_ADVN_ALE: JP4.31, U1.H25 (GPMC0_ADVN_ALE)
GPMC0_BE0N_CLE: JP2.38, U1.J26 (GPMC0_BE0N_CLE)
GPMC0_BE1N: JP2.36, U1.K25 (GPMC0_BE1N)
GPMC0_CLK: JP2.37, U1.K26 (GPMC0_CLK)
GPMC0_CSN0: JP4.29, U1.F26 (GPMC0_CSN0)
GPMC0_CSN1: JP5.29, U1.F25 (GPMC0_CSN1)
GPMC0_CSN2: JP4.28, U1.E26 (GPMC0_CSN2)
GPMC0_CSN3: JP5.28, U1.E25 (GPMC0_CSN3)
GPMC0_DIR: JP4.30, U1.G25 (GPMC0_DIR)
GPMC0_OEN_REN: JP4.32, U1.H26 (GPMC0_OEN_REN)
GPMC0_WAIT0: JP2.34, U1.L25 (GPMC0_WAIT0)
GPMC0_WAIT1: JP2.35, U1.L26 (GPMC0_WAIT1)
GPMC0_WEN: JP2.39, U1.J25 (GPMC0_WEN)
GPMC0_WPN: JP5.31, U1.G26 (GPMC0_WPN)
I2C0_SCL: J7.2, J8.2, R52.1, U1.A12 (I2C0_SCL), U4.1 (SCL), U6.10 (SCL), U7.5 (SCL), U8.5 (SCL)
I2C0_SDA: J7.1, J8.3, R53.1, U1.B12 (I2C0_SDA), U4.3 (SDA), U6.9 (SDA), U7.6 (SDA), U8.6 (SDA)
I2C1_SCL: JP3.36, R69.1, U1.A13 (I2C1_SCL)
I2C1_SDA: JP3.35, R70.1, U1.B13 (I2C1_SDA)
LDO1-1P8-3P3: C23.1, C42.1, R43.2, R44.2, R45.2, R46.2, R47.2, U1.G21 (VDDSHV5), U1.G22 (VDDSHV5), U6.7 (VLDO1)
LDO2-0P85: C17.1, C18.1, C19.1, C43.1, U1.H17 (VDDR_CORE), U1.H18 (VDDR_CORE), U1.J17 (VDDR_CORE), U1.J18 (VDDR_CORE), U1.K17 (VDDR_CORE), U1.K18 (VDDR_CORE), U1.L17 (VDDR_CORE), U1.L18 (VDDR_CORE), U6.19 (VLDO2)
LDO3-1P8: C1.1, C2.1, C3.1, C4.1, C5.1, C44.1, C46.1, C54.1, R24.2, R50.1, U1.D15 (VDDS_OSC0), U1.F13 (VDDA_MCU), U1.F14 (VDDA_PLL2), U1.N12 (VDDA_TEMP), U1.N13 (VDDA_PLL0), U1.N14 (VDDA_PLL1), U1.P11 (VDDA_1P8_OLDI0), U1.P12 (VDDA_1P8_USB), U1.P13 (VDDA_1P8_CSIRX0), U6.21 (VLDO3), Y1.4 (VDD), Y2.4 (VDD)
LDO4-2P5: C20.1, C45.1, U1.N10 (DDR_VPP), U6.23 (VLDO4)
LED1: D1.1 (A), R57.1
LED2: D2.1 (A), R58.1
LED3: D3.1 (A), R59.1
LED4: D4.1 (A), R60.1
LED5: D5.1 (A), R61.1
LX_B1: L4.1, U6.2 (LX_B1_1), U6.3 (LX_B1_2)
LX_B2: L3.1, U6.29 (LX_B2)
LX_B3: L2.1, U6.27 (LX_B3)
MCAN0_RX: JP3.37, U1.A11 (MCAN0_RX)
MCAN0_TX: JP3.38, U1.B11 (MCAN0_TX)
MCASP0_ACLKR: JP3.39, U1.B19 (MCASP0_ACLKR)
MCASP0_ACLKX: R58.2, U1.A18 (MCASP0_ACLKX)
MCASP0_AFSR: JP3.40, U1.A19 (MCASP0_AFSR)
MCASP0_AFSX: R59.2, U1.B18 (MCASP0_AFSX)
MCASP0_AXR0: R60.2, U1.B17 (MCASP0_AXR0)
MCASP0_AXR1: R61.2, U1.A17 (MCASP0_AXR1)
MCASP0_AXR2: JP4.39, U1.B16 (MCASP0_AXR2)
MCASP0_AXR3: R55.1, U1.A16 (MCASP0_AXR3)
MCU_ERRORN: TP2.TP, U1.D7 (MCU_ERRORN)
MCU_I2C0_SCL: JP5.14, R65.1, U1.A7 (MCU_I2C0_SCL)
MCU_I2C0_SDA: JP4.14, R66.1, U1.B7 (MCU_I2C0_SDA)
MCU_MCAN0_RX: JP5.4, U1.E1 (MCU_MCAN0_RX)
MCU_MCAN0_TX: JP5.5, U1.E2 (MCU_MCAN0_TX)
MCU_MCAN1_RX: JP5.2, U1.F1 (MCU_MCAN1_RX)
MCU_MCAN1_TX: JP5.3, U1.F2 (MCU_MCAN1_TX)
MCU_OSC0_XI: U1.G1 (MCU_OSC0_XI), Y2.3 (OUT)
MCU_PORZ: JP4.15, R24.1, U1.D6 (MCU_PORZ), U6.18 (NRSTOUT)
MCU_RESETSTATZ: TP3.TP, U1.C6 (MCU_RESETSTATZ)
MCU_RESETZ: R10.1, U1.C5 (MCU_RESETZ)
MCU_SPI0_CLK: JP4.11, U1.A4 (MCU_SPI0_CLK)
MCU_SPI0_CS0: JP5.13, U1.B6 (MCU_SPI0_CS0)
MCU_SPI0_CS1: JP4.13, U1.A6 (MCU_SPI0_CS1)
MCU_SPI0_D0: JP5.12, U1.B5 (MCU_SPI0_D0)
MCU_SPI0_D1: JP4.12, U1.A5 (MCU_SPI0_D1)
MCU_UART0_CTSN: JP5.11, U1.B4 (MCU_UART0_CTSN)
MCU_UART0_RTSN: JP4.10, U1.A3 (MCU_UART0_RTSN)
MCU_UART0_RXD: JP4.9, U1.B2 (MCU_UART0_RXD)
MCU_UART0_TXD: JP5.10, U1.B3 (MCU_UART0_TXD)
MDIO0_MDC: JP3.12, U1.V26 (MDIO0_MDC)
MDIO0_MDIO: JP2.12, U1.U26 (MDIO0_MDIO)
MMC0_CLK: JP4.5, R67.1, U1.J1 (MMC0_CLK)
MMC0_CMD: JP4.6, R68.1, U1.K1 (MMC0_CMD)
MMC0_DAT0: JP3.4, U1.K2 (MMC0_DAT0)
MMC0_DAT1: JP3.3, U1.L1 (MMC0_DAT1)
MMC0_DAT2: JP4.1, U1.L2 (MMC0_DAT2)
MMC0_DAT3: JP4.2, U1.M1 (MMC0_DAT3)
MMC0_DAT4: JP3.6, U1.M2 (MMC0_DAT4)
MMC0_DAT5: JP3.5, U1.N1 (MMC0_DAT5)
MMC0_DAT6: JP4.4, U1.N2 (MMC0_DAT6)
MMC0_DAT7: JP4.3, U1.P1 (MMC0_DAT7)
MMC1_CLK: R33.2, U1.B21 (MMC1_CLK)
MMC1_CLK_R: R33.1, X1.PIN5 (CLK)
MMC1_CMD: R45.1, U1.A21 (MMC1_CMD), X1.PIN3 (CMD)
MMC1_DAT0: R46.1, U1.A22 (MMC1_DAT0), X1.PIN7 (DAT0)
MMC1_DAT1: R47.1, U1.B22 (MMC1_DAT1), X1.PIN8 (DAT1)
MMC1_DAT2: R43.1, U1.A20 (MMC1_DAT2), X1.PIN1 (DAT2)
MMC1_DAT3: R44.1, U1.B20 (MMC1_DAT3), X1.PIN2 (CD/DAT3)
MMC1_SDCD: U1.A23 (MMC1_SDCD), U11.4 (Y)
MMC1_SDWP: R13.1, U1.B23 (MMC1_SDWP), U6.12 (VSEL_SD/VSEL_DDR)
MMC2_CLK: JP4.20, U1.D23 (MMC2_CLK)
MMC2_CMD: JP5.20, U1.C23 (MMC2_CMD)
MMC2_DAT0: JP5.19, U1.D22 (MMC2_DAT0)
MMC2_DAT1: JP4.19, U1.C22 (MMC2_DAT1)
MMC2_DAT2: JP5.18, U1.D21 (MMC2_DAT2)
MMC2_DAT3: JP4.18, U1.C21 (MMC2_DAT3)
MMC2_SDCD: JP5.17, U1.D20 (MMC2_SDCD)
MMC2_SDWP: JP4.17, U1.C20 (MMC2_SDWP)
MPU_HFOSC_EN: R50.2, Y2.1 (ST)
OSPI0_CLK: JP4.23, U1.A24 (OSPI0_CLK)
OSPI0_CSN0: JP4.22, U1.D25 (OSPI0_CSN0)
OSPI0_CSN1: D7.CATHODE (C), U1.C25 (OSPI0_CSN1)
OSPI0_CSN2: JP4.21, U1.D24 (OSPI0_CSN2)
OSPI0_CSN3: JP5.21, U1.C24 (OSPI0_CSN3)
OSPI0_D0: JP5.24, U1.B24 (OSPI0_D0)
OSPI0_D1: JP4.24, U1.A25 (OSPI0_D1)
OSPI0_D2: JP5.25, U1.B25 (OSPI0_D2)
OSPI0_D3: JP4.25, U1.A26 (OSPI0_D3)
OSPI0_D4: JP5.26, U1.B26 (OSPI0_D4)
OSPI0_D5: JP4.26, U1.B27 (OSPI0_D5)
OSPI0_D6: JP5.27, U1.C27 (OSPI0_D6)
OSPI0_D7: JP4.27, U1.C28 (OSPI0_D7)
OSPI0_DQS: JP5.23, U1.D26 (OSPI0_DQS)
OSPI0_LBCLKO: JP5.22, R74.2, U1.C26 (OSPI0_LBCLKO)
OSPI0_LBCLKO_R: J1.1, R74.1, U13.C1 (2Y)
PMIC_LPM_EN0: R23.1, U1.D5 (PMIC_LPM_EN0), U6.31 (MODE_STBY)
PMIC_PWR_BTN: R22.1, S1.P$1, S1.P$2, U6.25 (EN/PB/VSENSE)
PORZ_OUT: TP1.TP, U1.D18 (PORZ_OUT)
RESETSTATZ: D6.CATHODE (C), U1.C18 (RESETSTATZ), U6.28 (MODE_RESET), U13.B1 (1A)
RESET_REQZ: R11.1, U1.D17 (RESET_REQZ)
RGMII1_RD0: JP2.8, U1.U22 (RGMII1_RD0)
RGMII1_RD1: JP2.7, U1.V22 (RGMII1_RD1)
RGMII1_RD2: JP2.6, U1.U21 (RGMII1_RD2)
RGMII1_RD3: JP2.5, U1.V21 (RGMII1_RD3)
RGMII1_RXC: JP2.4, U1.U20 (RGMII1_RXC)
RGMII1_RX_CTL: JP2.3, U1.V20 (RGMII1_RX_CTL)
RGMII1_TD0: JP2.11, U1.U25 (RGMII1_TD0)
RGMII1_TD1: JP3.11, U1.V25 (RGMII1_TD1)
RGMII1_TD2: JP2.10, U1.U24 (RGMII1_TD2)
RGMII1_TD3: JP3.10, U1.V24 (RGMII1_TD3)
RGMII1_TXC: JP2.9, U1.U23 (RGMII1_TXC)
RGMII1_TX_CTL: JP3.9, U1.V23 (RGMII1_TX_CTL)
RGMII2_RD0: JP2.18, U1.T25 (RGMII2_RD0)
RGMII2_RD1: JP3.18, U1.R24 (RGMII2_RD1)
RGMII2_RD2: JP2.17, U1.T24 (RGMII2_RD2)
RGMII2_RD3: JP3.17, U1.R23 (RGMII2_RD3)
RGMII2_RXC: JP3.16, U1.R22 (RGMII2_RXC)
RGMII2_RX_CTL: JP2.16, U1.T23 (RGMII2_RX_CTL)
RGMII2_TD0: JP2.15, U1.T22 (RGMII2_TD0)
RGMII2_TD1: JP3.15, U1.R21 (RGMII2_TD1)
RGMII2_TD2: JP2.14, U1.T21 (RGMII2_TD2)
RGMII2_TD3: JP3.14, U1.R20 (RGMII2_TD3)
RGMII2_TXC: JP3.13, U1.R19 (RGMII2_TXC)
RGMII2_TX_CTL: JP2.13, U1.T20 (RGMII2_TX_CTL)
RXD: JP1.2, R76.2, U12.B1 (1A)
SDCD_INV: R48.1, U11.2 (A), X1.PIN9 (DET), X1.PIN10 (DET)
SD_LS_ON: D6.ANODE (A), D7.ANODE (A), R54.2, U10.3 (ON)
SPI0_CLK: JP4.37, U1.C11 (SPI0_CLK)
SPI0_CS0: JP4.38, U1.D13 (SPI0_CS0)
SPI0_CS1: JP3.2, U1.C13 (SPI0_CS1)
SPI0_D0: JP4.36, U1.D12 (SPI0_D0)
SPI0_D1: JP4.35, U1.C12 (SPI0_D1)
TCK: R19.1, TC1.4, U1.D9 (TCK)
TDI: R17.1, TC1.8, U1.D10 (TDI)
TDO: TC1.6, U1.D11 (TDO)
TMS: R18.1, TC1.2, U1.C10 (TMS)
TPS22965_CT: C28.1, U5.6 (CT)
TPS22965_EN: R73.1, U5.3 (ON), U6.17 (GPO2)
TRSTN: R14.2, TC1.9, U1.C9 (TRSTN)
TS_INT#: J8.9, TP7.TP, U13.D2 (2A)
TS_RESET_N: J8.8, TP6.TP, U13.C2 (1Y)
TXD: JP1.3, U12.C1 (2Y)
UART0_CTSN: JP4.16, U1.A9 (UART0_CTSN)
UART0_RTSN: JP5.16, U1.B9 (UART0_RTSN)
UART0_RXD: U1.A10 (UART0_RXD), U12.C2 (1Y)
UART0_TXD: U1.B10 (UART0_TXD), U12.D2 (2A)
USB0_CC1: J5.A5 (CC1), R35.2
USB0_CC2: J5.B5 (CC2), R36.2
USB0_DM: J5.A7 (DN1), J5.B7 (DN2), U1.U12 (USB0_DM), U9.2 (D-)
USB0_DP: J5.A6 (DP1), J5.B6 (DP2), U1.V12 (USB0_DP), U9.1 (D+)
USB0_DRVVBUS: J4.11, U1.C19 (USB0_DRVVBUS)
USB0_VBUS: R62.1, R63.1, U1.V11 (USB0_VBUS)
USB1_CC1: J6.A5 (CC1), R72.1
USB1_CC2: J6.B5 (CC2), R71.1
USB1_DM: J6.A7 (DN1), J6.B7 (DN2), U1.U10 (USB1_DM), U2.2 (D-)
USB1_DP: J6.A6 (DP1), J6.B6 (DP2), U1.V10 (USB1_DP), U2.1 (D+)
USB1_DRVVBUS: J4.12, U1.D19 (USB1_DRVVBUS)
USB1_VBUS: R4.1, R5.1, U1.U11 (USB1_VBUS)
VBUS: C50.1, C60.1, D8.A, J5.A4_B9 (VBUS/A4/B9), J5.B4_A9 (VBUS/A9/B4), U9.6 (VBUS)
VDD1P8_CAP: C41.1, U6.14 (VDD1P8)
VDD_SD: C57.1, C58.1, U10.5 (QOD), U10.6 (VOUT), X1.PIN4 (VDD)
VIN-3P3: C30.2, C31.1, C32.1, C33.1, C39.1, C40.1, C48.1, C51.1, C52.1, L1.2, R9.1, R22.2, R73.2, U5.1 (VIN), U5.2 (VIN), U5.4 (VBIAS), U6.4 (PVIN_B1_1), U6.5 (PVIN_B1_2), U6.6 (PVIN_LDO1), U6.13 (VSYS), U6.22 (PVIN_LDO34), U6.26 (PVIN_B3), U6.30 (PVIN_B2)
VIN-3P3-LS: C6.1, C22.1, C26.1, C29.1, C34.1, C35.1, C36.1, C37.1, C61.1, C63.1, J4.15, J8.1, JP2.2, JP3.7, JP4.34, R7.2, R10.2, R11.2, R12.2, R13.2, R16.2, R17.2, R18.2, R19.2, R20.2, R21.2, R23.2, R25.2, R28.2, R30.2, R31.2, R32.2, R38.2, R48.2, R49.2, R51.2, R52.2, R53.2, R54.1, R57.2, R64.2, R65.2, R66.2, R67.2, R68.2, R69.2, R70.2, TC1.1, U1.B15 (VMON_3P3_SOC), U1.F11 (VDDSHV_CANUART), U1.F12 (VDDSHV_MCU), U1.G10 (VDDSHV_CANUART), U1.G11 (VDDSHV_MCU), U1.H21 (VDDSHV6), U1.H22 (VDDSHV6), U1.J21 (VDDSHV0), U1.J22 (VDDSHV0), U1.K21 (VDDSHV1), U1.K22 (VDDSHV1), U1.L21 (VDDSHV3), U1.L22 (VDDSHV3), U1.M21 (VDDSHV2), U1.M22 (VDDSHV2), U1.N7 (VDDA_3P3_USB), U1.N11 (VDDSHV4), U1.P10 (VDDSHV4), U4.4 (VCC), U5.7 (VOUT), U5.8 (VOUT), U7.1 (VA), U8.1 (VA), U10.1 (VIN), U11.6 (VCC), U12.A2 (VCC), U12.B2 (2OE), U13.A2 (VCC), U13.B2 (2OE), U14.4 (IN)
VIN-5P0: C24.1, C25.+, C27.1, C55.1, C56.1, C59.1, D8.C, J6.A4 (VBUS), J6.A9 (VBUS), J6.B4 (VBUS), J6.B9 (VBUS), JP2.1, JP3.34, JP4.7, R2.2, R5.2, R62.2, R71.2, R72.2, U2.6 (VBUS), U3.1 (EN), U3.6 (VIN)
VMON_ER_SYS: R1.2, R2.1, U1.A15 (VMON_VSYS)
VOUT0_DATA0: JP2.21, U1.P26 (VOUT0_DATA0)
VOUT0_DATA1: JP3.21, U1.N25 (VOUT0_DATA1)
VOUT0_DATA2: JP2.22, U1.N26 (VOUT0_DATA2)
VOUT0_DATA3: JP3.22, U1.M25 (VOUT0_DATA3)
VOUT0_DATA4: JP2.23, U1.M26 (VOUT0_DATA4)
VOUT0_DATA5: JP3.23, U1.U27 (VOUT0_DATA5)
VOUT0_DATA6: JP2.24, U1.T27 (VOUT0_DATA6)
VOUT0_DATA7: JP3.24, U1.T28 (VOUT0_DATA7)
VOUT0_DATA8: JP2.25, U1.R27 (VOUT0_DATA8)
VOUT0_DATA9: JP3.25, U1.R28 (VOUT0_DATA9)
VOUT0_DATA10: JP2.26, U1.P27 (VOUT0_DATA10)
VOUT0_DATA11: JP3.26, U1.P28 (VOUT0_DATA11)
VOUT0_DATA12: JP2.27, U1.N27 (VOUT0_DATA12)
VOUT0_DATA13: JP3.27, U1.N28 (VOUT0_DATA13)
VOUT0_DATA14: JP2.28, U1.M27 (VOUT0_DATA14)
VOUT0_DATA15: JP3.28, U1.M28 (VOUT0_DATA15)
VOUT0_DE: JP2.19, U1.R25 (VOUT0_DE)
VOUT0_HSYNC: JP3.20, U1.P25 (VOUT0_HSYNC)
VOUT0_PCLK: JP3.19, U1.T26 (VOUT0_PCLK)
VOUT0_VSYNC: JP2.20, U1.R26 (VOUT0_VSYNC)
VPP: C62.1, U1.C16 (VPP), U14.1 (OUT)
VPP_EN: J1.2, R3.2, U14.3 (EN)
WKUP_CLKOUT0: JP5.15, U1.C7 (WKUP_CLKOUT0)
WKUP_I2C0_SCL: J4.13, R64.1, U1.A8 (WKUP_I2C0_SCL)
WKUP_I2C0_SDA: J4.14, R12.1, U1.B8 (WKUP_I2C0_SDA)
WKUP_LFOSC0_XI: U1.H1 (WKUP_LFOSC0_XI), Y1.3 (OUT)
WKUP_UART0_CTSN: JP5.6, U1.D1 (WKUP_UART0_CTSN)
WKUP_UART0_RTSN: JP5.7, U1.D2 (WKUP_UART0_RTSN)
WKUP_UART0_RXD: JP5.9, U1.C2 (WKUP_UART0_RXD)
WKUP_UART0_TXD: JP5.8, U1.C1 (WKUP_UART0_TXD)

Notes on the sheet:
OSD62-PM BRK
Version 1D
Table of Contents
Sheet 1: Title
Sheet 2: Notes / Block Diagram / Mechanical
Sheet 3: OSD62-PM Power
Sheet 4: OSD62-PM GND / IO Power
Sheet 5: OSD62-PM Signals
Sheet 6: USB-C / CSI / Power In / Osc
Sheet 7: Power Management
Sheet 8: JTAG / Boot Mode / microSD / etc.
1/12
2/12
8/12
9/12
11/12
6/12
12/12
Sheet 9: IO Headers
Sheet 12: Design Notes
MicroSD
JTAG Headers
Design Notes
Revision 1A - Intial Revision - Pre-Production Revision 1B - Fixed issue with USB connector shorting power and ground - Updated SD card connections to fix UHS-I speed transition - Updated PC / PD headers Revision 1C - Added inverter on microSD card CD pin - Added back current protection for USB-C U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
Mechanical & Misc
Boot Modes Decode: 1, PLL Config B[2:0] = 0b011 : Ref Clock = 25MHz 2, Primary Boot B[9:3] = 0b1001000 : SDCard FS Boot 3, Backup Boot B[13:10] = 0b1011 : UART Boot
Fiducials
UART Header
USB-C Connector
IO Headers
Note: VDDSHV5 is used for this interface. LDO1 from the PMIC supports both 1.8V and 3.3V operation to support SD3.0 speed
Power Management
OSD62-PM Power
OSD62-PM Signals
Oscillators
OSD62-PM Ground
VDD_CORE
VDD_CANUART
VDDR_CORE
VDDA_1P8_OLDI0
VDDA_CORE_CSIRX0
VDDS_DDR
VDDS_DDR_C
0.01uF
0.1uF
1uF
2.2uF
4.7uF
10uF
VDDA_1P8_CSIRX0
1/0
0/0
0/1
0/3
See Documents: - https://www.ti.com/lit/an/sprac76f/sprac76f.pdf (see page 29) - https://www.ti.com/lit/zip/spar001 (See Sheet 14)
VDDA_1V8_USB
VDDA_1V8_MCU
VDDA_1V8_PLL0
VDDA_1V8_PLL1
VDDA_1V8_PLL2
VDDA_CORE_USB
Internal PM / OSD62 BRK Board
0201
0402
Buck 1 (0.75 V)
Buck 3 (1.2 V)
LDO2 (0.85 V)
LDO3 (1.8 V)
1/3
OSD62-PM I/O Power
3.3V DC-DC Converter
Main 3.3V Input
Boot Mode
USB Connector
Vertical USB Host Port (Type-C)
4A DC-DC converter
6A Load Switch
SD Power Load switch
EEPROM
TFM201610ALC-R47MTAA
I2C Table
AOTA-B160808SR47MT
Maximum Current Requirements: - https://www.ti.com/lit/an/sprada6/sprada6.pdf
Total Core: 3100mA
250mA
10mA
20mA
30mA
200mA
40mA
5mA
400mA
50mA
CSI length requirements: - Inter pair: 0.15mm - Intra pair: 1.5mm
I2C0
ADDRESS
DEVICE
0x50
0x13
TPS65219
Power Block Diagram
VIN-B1/2/3
VIN-LDO1
VIN-LDO2
VIN-LDO34
3.3V
Buck 1
Buck 2
Buck 3
LDO 1
LDO 2
LDO 3
LDO 4
Buck 2 Input - Required due to power sequencing
0.75V
1.8V @ 2A
0.75V @ 3.5A
1.2V @ 2A
0.85V @ 400mA
1.8V / 3.3V @ 400mA
1.8V @ 300mA
2.5V @ 300mA
TPS6521903
VDDA_DDR_PLL0
VDDA_MCU
VDDS_DDR (includes DDR4 VDD/VDDQ)
VDDS_OSC0
VDDA_PLLx
VDDA_1P8_USB
VDDA_TEMPx
VDDA_3P3_USB
Buck 3 1.2V @ 600mA
OSD62-PM
Buck 1 0.75V @ 2850mA
LDO 2 0.85V @ 80mA
DDR_VPP
LDO 4 2.5V @ 60mA
LDO 3 1.8V @ 200mA
VDDSHV_CANUART
VDDSHV_MCU
VDDSHV0
VDDSHV1
VDDSHV6
VDDSHV2
VDDSHV3
VDDSHV4
VDDSHV5 (microSD)
ADCs
For Click Connectors
3/12
4/12
10/12
7/12
5/12
I2C Addr: 0x52
I2C Addr: 0x51
Only supports USB2.0; Cannot supply power
CSI Connector
Compatible with Raspberry Pi camera connector
0x51
0x52
ADC121C027
This Page Intentionally Left Blank
Sheet 10: LVDS Connector
Sheet 11: Blank
Connectors support two (2) Mikroe Click Interfaces on the inner headers (East / West)
OSD62-PM Reserved / DNU
LEDs
All IO to headers on OSD62-PM are 3.3V. Other designs will need to set VDDSHV banks to meet their IO voltage needs.
Test Points for unused control signals.
Oscillator used instead of Crystal
Power Button
I2C Pull Ups
Pull up resistors are required for the MCU and WKUP I2C busses regardless of use.
No pull ups required for the Click I2C Interfaces, per spec. Footprints on back of board added for conveniece.
VPP
LDO 1 1.8V/3.3V @ 80mA
TLV75518P LDO
Buck 2 1.8V @ 400mA
5.0V USB-C External Input
TLV62595
TPS22965
DC-DC 4A 5.0V to 3.3V
Load Switch 6A
To System
GPO2
USR3
USR2
USR1
USR0
Click Modules come with I2C pull ups on-board. Footprints added on I2C1 and I2C3 for convenience (see other page).
Click 0
Click 1
DFP Advertisement: Default USB Power (500mA/900mA)
UFP Request: 3.0A
USB-C Power Discussion
The USB-C UFP uses 5.1k pull down resistors on the CC pins to request up to 3A from the DFP. However, this board does not check the voltage of the CC pins to understand the current provided by the DFP port. The USB-C DFP port on this board uses 56k ohm pull up resistors to advertise 500mA of curren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
USB-C UFP
USB-C DFP 500mA
Note: The AM62x ROM code requires CD to have an active-low polarity. Depending on the CD polarity of the SD card holder you may need to add an inverter as shown.

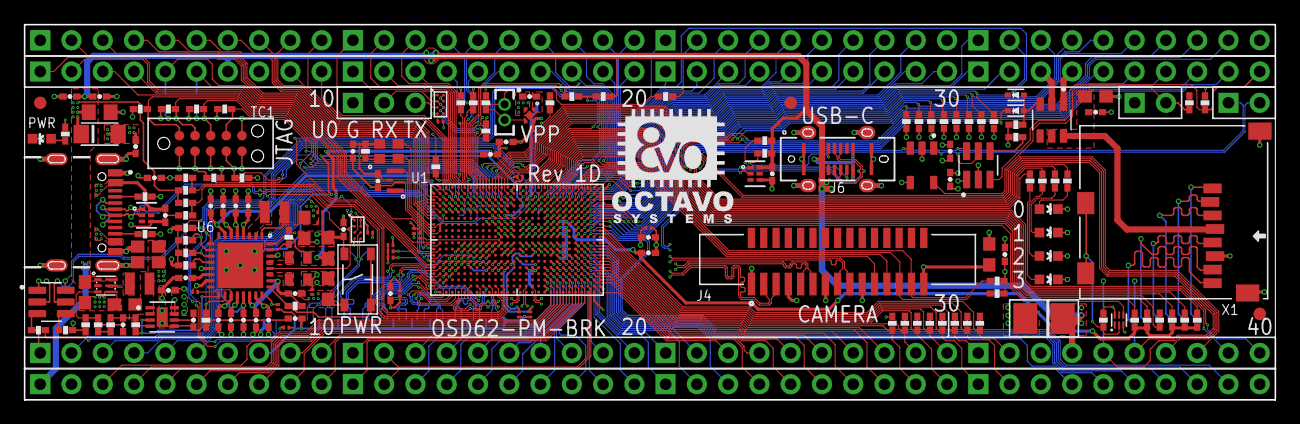
[picture p92: board OSD62-PM-BRK.brd from above]

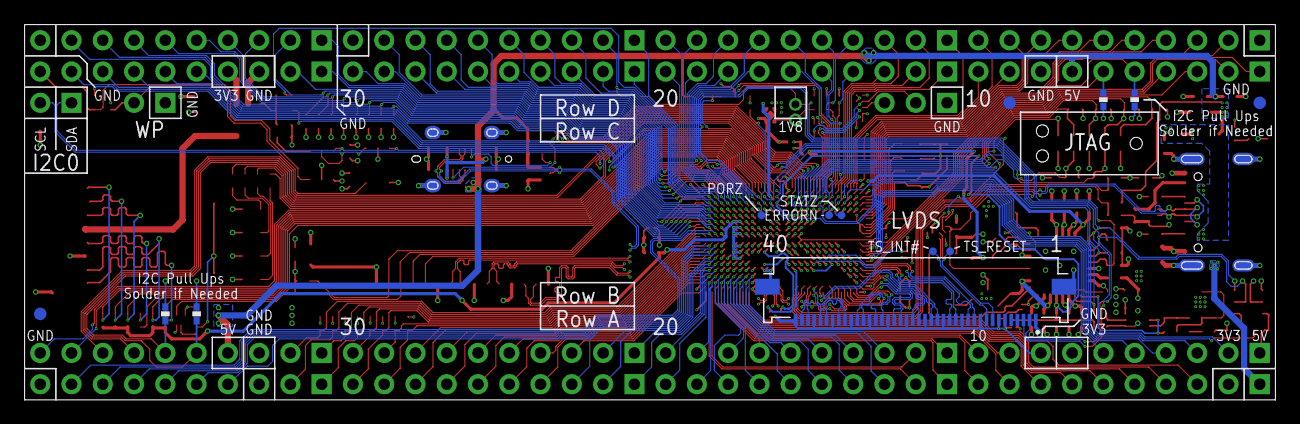
[picture p93: board OSD62-PM-BRK.brd from below]

Board: 4 copper layers, 101.6 x 30.5 mm, 194 parts (13 on the bottom side), 264 nets.

Other parts of the board:
U$1: OCTAVO-LOGO-8VO
U$2: OCTAVO-LOGO-WORDS-SMALL
