UavL/Glider/fw/glider_ec_rtos.ioc

Mcu.UserName=STM32H750VBTx
PA0.Signal=SDMMC2_CMD
PA1.Signal=QUADSPI_BK1_IO3
PA10.Signal=GPIO_Output
PA11.Signal=USB_OTG_FS_DM
PA12.Signal=USB_OTG_FS_DP
PA2.Signal=GPIO_Output
PA3.Signal=GPIO_Output
PA4.Signal=COMP_DAC11_group
PA5.Signal=COMP_DAC12_group
PA6.Signal=ADCx_INP3
PA7.Signal=ADCx_INP7
PA9.Signal=GPIO_Output
PB0.Signal=ADCx_INP9
PB1.Signal=ADCx_INP5
PB10.Signal=QUADSPI_BK1_NCS
PB12.Signal=GPIO_Output
PB13.Signal=SPI2_SCK
PB14.Signal=SDMMC2_D0
PB15.Signal=SDMMC2_D1
PB2.Signal=QUADSPI_CLK
PB5.Signal=GPIO_Input
PB6.Signal=I2C1_SCL
PB7.Signal=I2C1_SDA
PB8.Signal=GPIO_Input
PC1.Signal=SDMMC2_CK
PC10.Signal=GPIO_Output
PC11.Signal=GPIO_Input
PC12.Signal=GPIO_Output
PC2_C.Signal=SPI2_MISO
PC3_C.Signal=SPI2_MOSI
PC4.Signal=ADCx_INP4
PC5.Signal=ADCx_INP8
PC7.Signal=FMC_NE1
PC9.Signal=QUADSPI_BK1_IO0
PD0.Signal=FMC_D2_DA2
PD1.Signal=FMC_D3_DA3
PD11.Signal=FMC_A16_CLE
PD12.Signal=QUADSPI_BK1_IO1
PD14.Signal=FMC_D0_DA0
PD15.Signal=FMC_D1_DA1
PD2.Signal=GPIO_Output
PD3.Signal=GPIO_Output
PD4.Signal=FMC_NOE
PD5.Signal=FMC_NWE
PD6.Signal=GPIO_Output
PD7.Signal=GPIO_Input
PE0.Signal=GPIO_Output
PE1.Signal=GPIO_Output
PE10.Signal=FMC_D7_DA7
PE11.Signal=GPIO_Output
PE12.Signal=GPIO_Output
PE15.Signal=GPIO_Output
PE2.Signal=QUADSPI_BK1_IO2
PE3.Signal=GPIO_Input
PE4.Signal=GPIO_Input
PE7.Signal=FMC_D4_DA4
PE8.Signal=FMC_D5_DA5
PE9.Signal=FMC_D6_DA6
