UavL/Glider/fw/User/shell/shell_cmds.c

//
// Grimoire
// Copyright 2025 Wenting Zhang
//
// Original copyright information:
// Copyright (c) 2022 - Analog Devices Inc. All Rights Reserved.
//
// This file is licensed under the Apache License, Version 2.0 (the "License");
// you may not use this file except in compliance with the License.  You may
// obtain a copy of the License at
//
//  http://www.apache.org/licenses/LICENSE-2.0
//
// Unless required by applicable law or agreed to in writing, software
// distributed under the License is distributed on an "AS IS" BASIS, WITHOUT
// WARRANTIES OR CONDITIONS OF ANY KIND, either express or implied.  See the
// License for the specific language governing permissions and limitations
// under the License.
//

#include "platform.h"
#include "board.h"
#include "shell.h"
#include "shell_printf.h"
#include "term.h"
#include "app_main.h"
#include "app.h"
#include "numfmt.h"
#include "config_timing.h"
#ifdef GLIDER_DIAGNOSTIC_SHELL
#include "autoclear.h"
#include "xmodem.h"
#endif

#ifdef printf
#undef printf
#endif

#ifdef vprintf
#undef vprintf
#endif

#define printf(...) shell_printf(ctx, __VA_ARGS__)
#define vprintf(x,y) shell_vprintf(ctx, x, y)

static void shell_print_fixed(shell_context_t *ctx, float value,
        unsigned decimals) {
    char text[16];

    numfmt_format_fixed(text, sizeof(text), value, decimals);
    printf("%s", text);
}

static bool shell_parse_uint16(const char *text, uint16_t min_value,
        uint16_t max_value, uint16_t *value) {
    char *end = NULL;
    unsigned long parsed;

    if ((text == NULL) || (value == NULL) || (*text == '\0'))
        return false;

    parsed = strtoul(text, &end, 10);
    if ((end == text) || (*end != '\0') || (parsed < min_value) ||
            (parsed > max_value))
        return false;

    *value = (uint16_t)parsed;
    return true;
}

/***********************************************************************
 * Misc helper functions
 **********************************************************************/
#ifdef GLIDER_DIAGNOSTIC_SHELL
static void dump_bytes(shell_context_t *ctx, unsigned char *rdata, unsigned addr, unsigned rlen) {
    unsigned i;
    for (i = 0; i < rlen; i++) {
        if ((i % 16) == 0) {
            if (i) {
                printf("\n");
            }
            printf("%08x: ", addr + i);
        }
        printf("%02x ", rdata[i]);
    }
    printf("\n");
}

int confirm_danger(shell_context_t *ctx, char *warnStr) {
    char c;

    printf( "%s\n", warnStr );
    printf( "Are you sure you want to continue? [y/n]" );

    c = term_getch( &ctx->t, TERM_INPUT_WAIT );
    printf( "%c\n", isprint( c ) ? c : ' ' );

    if( tolower(c) == 'y' ) {
        return(1);
    }

    return(0);
}
#endif

/***********************************************************************
 * CMD: syslog
 **********************************************************************/
const char shell_help_syslog[] = "\n";
const char shell_help_summary_syslog[] = "Show the live system log";

#define MAX_TS_LINE  32
#define MAX_LOG_LINE 256

void shell_syslog(shell_context_t *ctx, int argc, char **argv) {
    char *line;
    char *lbuf;
    char *ts;
    int c;

    ts = SHELL_MALLOC(MAX_TS_LINE);
    lbuf = SHELL_MALLOC(MAX_LOG_LINE);

    c = 0;
    do {
        line = syslog_next(ts, MAX_TS_LINE, lbuf, MAX_LOG_LINE);
        if (line) {
            printf("%s %s\n", ts, line);
        }
        c = term_getch(&ctx->t, TERM_INPUT_DONT_WAIT);
#ifdef FREE_RTOS
        if ((line == NULL) && (c < 0)) {
            vTaskDelay(pdMS_TO_TICKS(50));
        }
#endif
    } while (c < 0);

    if (ts) {
        SHELL_FREE(ts);
    }
    if (lbuf) {
        SHELL_FREE(lbuf);
    }
}

/***********************************************************************
 * CMD: mem
 **********************************************************************/
#ifdef GLIDER_DIAGNOSTIC_SHELL
const char shell_help_mem[] = "[detail]\n"
  "  detail - Show detailed heap information\n";
const char shell_help_summary_mem[] = "Report memory (stack & heap) usage";

static void shell_print_task_stack(shell_context_t *ctx, TaskHandle_t task) {
    if (task) {
        printf(" %s: %u\n",
            pcTaskGetName(task), (unsigned)uxTaskGetStackHighWaterMark(task)
        );
    }
}

static void shell_print_heap_summary(shell_context_t *ctx) {
    size_t total = configTOTAL_HEAP_SIZE;
    size_t free = xPortGetFreeHeapSize();
    size_t used = total - free;
    size_t min_free = xPortGetMinimumEverFreeHeapSize();

    printf("\nHeap Usage:\n");
    printf(" Total:    %u\n", (unsigned)total);
    printf(" Used:     %u\n", (unsigned)used);
    printf(" Free:     %u\n", (unsigned)free);
    printf(" Min Free: %u\n", (unsigned)min_free);
}

static void shell_print_heap_details(shell_context_t *ctx) {
    HeapStats_t stats;

    vPortGetHeapStats(&stats);

    printf("\nHeap Details:\n");
    printf(" Largest Free Block:   %u\n", (unsigned)stats.xSizeOfLargestFreeBlockInBytes);
    printf(" Smallest Free Block:  %u\n", (unsigned)stats.xSizeOfSmallestFreeBlockInBytes);
    printf(" Num Free Blocks:      %u\n", (unsigned)stats.xNumberOfFreeBlocks);
    printf(" Successful Allocs:    %u\n", (unsigned)stats.xNumberOfSuccessfulAllocations);
    printf(" Successful Frees:     %u\n", (unsigned)stats.xNumberOfSuccessfulFrees);
}

void shell_mem(shell_context_t *ctx, int argc, char **argv ) {
    int detail = 0;

    if ((argc > 1) && (strcmp(argv[1], "detail") == 0)) {
        detail = 1;
    }
    else if (argc > 1) {
        printf("Invalid argument. Usage: %s\n", shell_help_mem);
        return;
    }

    printf("High Water Marks are in 32-bit words (zero is bad).\n");
    printf("Task Stack High Water Marks:\n");

    shell_print_task_stack(ctx, startup_task_handle);
    shell_print_task_stack(ctx, housekeeping_task_handle);
    shell_print_task_stack(ctx, usb_device_task_handle);
    shell_print_task_stack(ctx, usb_pd_task_handle);
    shell_print_task_stack(ctx, ui_task_handle);
    shell_print_task_stack(ctx, key_scan_task_handle);
    shell_print_task_stack(ctx, power_mon_task_handle);

    shell_print_heap_summary(ctx);

    if (detail) {
        shell_print_heap_details(ctx);
    }
}

/***********************************************************************
 * CMD: test
 **********************************************************************/
const char shell_help_test[] = "\n";
const char shell_help_summary_test[] = "Test command";

void shell_test(shell_context_t *ctx, int argc, char **argv ) {

//    uint8_t val = atoi(argv[1]);
//    uint8_t buf[2];
//    buf[0] = 0x19;
//    buf[1] = val | 0x80;
//     pal_i2c_write_payload(ADV7611_I2C, ADV7611_I2C_ADDR, buf, 2);

//    uint8_t val;
//
//    val = adv7611_read_reg(ADV7611_I2C_ADDR, 0x6a);
//    if (val & 0x10)
//        printf("TMDS clock detected\n");
//    else
//        printf("No TMDS clock detected\n");
//
//    uint16_t val16;
//    val = adv7611_read_reg(HDMI_I2C_ADDR, 0x51); // D8-D1
//    val16 = (uint16_t)val << 1;
//    val = adv7611_read_reg(HDMI_I2C_ADDR, 0x52);
//    val16 |= val >> 7;
//
//    printf("TMDS frequency %d MHz\n", val16);
//
//    val = adv7611_read_reg(HDMI_I2C_ADDR, 0x04);
//    if (val & 0x2)
//        printf("TMDS PLL locked\n");
//    else
//        printf("TMDS PLL not locked\n");
//
//    val = adv7611_read_reg(HDMI_I2C_ADDR, 0x05);
//    if (val & 0x80)
//        printf("HDMI mode detected\n");
//    else
//        printf("DVI mode detected\n");
//
//    val = adv7611_read_reg(HDMI_I2C_ADDR, 0x07);
//    if (val & 0x20)
//        printf("DE regeneration locked\n");
//    else
//        printf("DE regeneration not locked\n");
//
//    if (val & 0x80)
//        printf("Vertical filter locked\n");
//    else
//        printf("Vertical filter not locked\n");
//
//    val16 = (uint16_t)adv7611_read_reg(HDMI_I2C_ADDR, 0x1e) << 8;
//    val16 |= adv7611_read_reg(HDMI_I2C_ADDR, 0x1f);
//    printf("Total line width: %d\n", val16);
//
//    val16 = (uint16_t)(adv7611_read_reg(HDMI_I2C_ADDR, 0x07) & 0x1f) << 8;
//    val16 |= adv7611_read_reg(HDMI_I2C_ADDR, 0x08);
//    printf("Active line width: %d\n", val16);
//
//    val16 = (uint16_t)(adv7611_read_reg(HDMI_I2C_ADDR, 0x09) & 0x1f) << 8;
//    val16 |= adv7611_read_reg(HDMI_I2C_ADDR, 0x0a);
//    printf("Active field height: %d\n", val16);
}

/***********************************************************************
 * CMD: i2c_probe
 **********************************************************************/
const char shell_help_i2c_probe[] = "<i2c_port>\n"
  "  i2c_port - I2C port to probe\n";
const char shell_help_summary_i2c_probe[] = "Probe an I2C port for active devices";

void shell_i2c_probe(shell_context_t *ctx, int argc, char **argv)
{
    pal_i2c_t *i2c;
    int i;

    if (argc != 2) {
        printf("Invalid arguments. Type help [<command>] for usage.\n");
        return;
    }

    int i2c_port = strtol(argv[1], NULL, 0);
    i2c = NULL;

    if (i2c_port == 1) {
        i2c = &pi2c1;
    }
    else {
        printf("Invalid I2C port!\n");
        return;
    }

    printf("Probing I2C port %d:\n", i2c_port);
    for (i = 0x08; i < 0x78; i++) {
        bool result = pal_i2c_ping(i2c, i);
        if (result == true) {
            printf(" Found device 0x%02x\n", i);
        }
    }
}
#endif


//const char shell_help_fl[] = "<operation> [brightness]\n"
//  "  operation - on | off | set\n"
//  "  brightness - 0-255\n";
//const char shell_help_summary_fl[] = "Control front light";
//
//void shell_fl(shell_context_t *ctx, int argc, char **argv)
//{
//    if ((argc < 2) || (argc > 3)) {
//        printf("Invalid arguments. Type help [<command>] for usage.\n");
//        return;
//    }
//
//    if (strcmp(argv[1], "on") == 0) {
//    	power_on_fl();
//    }
//    else if (strcmp(argv[1], "off") == 0) {
//    	power_off_fl();
//    }
//
//    if (argc == 3) {
//    	int brightness = strtol(argv[2], NULL, 0);
//    	power_set_fl_brightness(brightness);
//    }
//}


/***********************************************************************
 * XMODEM helper functions
 **********************************************************************/
#ifdef GLIDER_DIAGNOSTIC_SHELL
typedef struct {
    shell_context_t *ctx;
} xmodem_state_t;

static void shell_xmodem_putchar(int c, void *usr) {
    xmodem_state_t *x = (xmodem_state_t *)usr;
    shell_context_t *ctx = x->ctx;
    term_state_t *t = &ctx->t;

    term_putch(t, c);
}

static int shell_xmodem_getchar(int timeout, void *usr) {
    xmodem_state_t *x = (xmodem_state_t *)usr;
    shell_context_t *ctx = x->ctx;
    term_state_t *t = &ctx->t;
    int c;

    c = term_getch(t, timeout);

    return(c);
}

typedef struct {
    xmodem_state_t xmodem;
    spiffs_file f;
    void *data;
    int size;
} file_xfer_state_t;

static void file_data_write(void *usr, void *data, int size) {
    file_xfer_state_t *state = (file_xfer_state_t *)usr;

    /*
     * Need to double-buffer the data in order to strip off the
     * trailing packet bytes at the end of an xmodem transfer.
     */
    if (state->data == NULL) {
        state->data = SHELL_MALLOC(1024);
        memcpy(state->data, data, size);
        state->size = size;
    } else {
        if (data) {
            SPIFFS_write(&spiffs_fs, state->f, state->data, state->size);
            memcpy(state->data, data, size);
            state->size = size;
        } else {
            uint8_t *buf = (uint8_t *)state->data;
            while (state->size && buf[state->size-1] == '\x1A') {
               state->size--;
            }
            SPIFFS_write(&spiffs_fs, state->f, state->data, state->size);
            if (state->data) {
                SHELL_FREE(state->data);
                state->data = NULL;
            }
        }
    }
}

static void file_data_read(void *usr, void *data, int size) {
    file_xfer_state_t *state = (file_xfer_state_t *)usr;

    if (size > 0) {
        SPIFFS_read(&spiffs_fs, state->f, data, size);
    }
}

/***********************************************************************
 * CMD: fs - filesystem operations
 **********************************************************************/
const char shell_help_fs[] = "<cp|mv|rm|ls|df|dump|format> [args...]\n"
  "  cp <src> <dest> - Copy file\n"
  "  mv <src> <dest> - Rename/move file\n"
  "  rm <file1> [<file2> ...] - Remove file(s)\n"
  "  ls - List files\n"
  "  df - Show filesystem disk usage\n"
  "  dump <file> [<start> <size>] - Dump file contents in hex\n"
  "  format - Format the internal flash filesystem\n";
const char shell_help_summary_fs[] = "filesystem operations";

#define DUMP_SIZE 512

void shell_fs(shell_context_t *ctx, int argc, char **argv) {
    if (argc < 2) {
        printf("Usage: fs %s", shell_help_fs);
        return;
    }

    if (strcmp(argv[1], "cp") == 0) {
        if (argc < 4) {
            printf("Usage: fs cp <src> <dest>\n");
            return;
        }
        spiffs_file src_fd = SPIFFS_open(&spiffs_fs, argv[2], SPIFFS_RDONLY, 0);
        if (src_fd < 0) {
            printf("Unable to open source '%s'\n", argv[2]);
            return;
        }
        spiffs_file dest_fd = SPIFFS_open(&spiffs_fs, argv[3], SPIFFS_WRONLY | SPIFFS_CREAT | SPIFFS_TRUNC, 0);
        if (dest_fd < 0) {
            printf("Unable to open destination '%s'\n", argv[3]);
            SPIFFS_close(&spiffs_fs, src_fd);
            return;
        }
        char buf[256];
        int32_t n;
        while ((n = SPIFFS_read(&spiffs_fs, src_fd, buf, sizeof(buf))) > 0) {
            SPIFFS_write(&spiffs_fs, dest_fd, buf, n);
        }
        SPIFFS_close(&spiffs_fs, src_fd);
        SPIFFS_close(&spiffs_fs, dest_fd);
    }
    else if (strcmp(argv[1], "mv") == 0) {
        if (argc < 4) {
            printf("Usage: fs mv <src> <dest>\n");
            return;
        }
        if (SPIFFS_rename(&spiffs_fs, argv[2], argv[3]) != 0) {
            printf("Unable to rename '%s' to '%s': %d\n",
                   argv[2], argv[3], SPIFFS_errno(&spiffs_fs));
        }
    }
    else if (strcmp(argv[1], "rm") == 0) {
        int i;
        if (argc < 3) {
            printf("Usage: fs rm <file1> [<file2> ...]\n");
            return;
        }
        for (i = 2; i < argc; i++) {
            if (SPIFFS_remove(&spiffs_fs, argv[i]) != 0) {
                printf("Unable to remove '%s'\n", argv[i]);
            }
        }
    }
    else if (strcmp(argv[1], "ls") == 0) {
        spiffs_DIR d;
        struct spiffs_dirent e;
        SPIFFS_opendir(&spiffs_fs, "/", &d);
        printf("%-32s %10s\n", "Name", "Bytes");
        printf("%-32s %10s\n", "----", "-----");
        while (SPIFFS_readdir(&d, &e)) {
            printf("%-32s %10u\n", e.name, (unsigned)e.size);
        }
        SPIFFS_closedir(&d);
    }
    else if (strcmp(argv[1], "df") == 0) {
        printf("%10s %10s %10s %5s\n", "Size", "Used", "Available", "Use %");
        int32_t serr;
        uint32_t ssize;
        uint32_t sused;
        serr = SPIFFS_info(&spiffs_fs, &ssize, &sused);
        if (serr == SPIFFS_OK) {
            printf("%10u %10u %10u %5u\n",
                (unsigned)ssize, (unsigned)sused, (unsigned)(ssize - sused),
                (unsigned)((100 * sused) / ssize));
        }
    }
    else if (strcmp(argv[1], "dump") == 0) {
        spiffs_file f;
        size_t start = 0;
        size_t size = 0;
        uint8_t *buf = NULL;
        int32_t bytes_read; // MUST be signed to properly check for SPIFFS negative error codes
        int c = -1;

        if (argc < 3) {
            printf("No file given\n");
            return;
        }
        if (argc > 3) {
            start = (size_t)strtoul(argv[3], NULL, 0);
        }
        if (argc > 4) {
            size = (size_t)strtoul(argv[4], NULL, 0);
        }

        f = SPIFFS_open(&spiffs_fs, argv[2], SPIFFS_O_RDONLY, 0);
        if (f >= 0) {
            spiffs_stat stat;

            if (SPIFFS_fstat(&spiffs_fs, f, &stat) >= 0) {

                if (start > stat.size) {
                    start = stat.size;
                }

                size_t max_size = stat.size - start;

                if (argc <= 4 || size > max_size) {
                    size = max_size;
                }

                if (size <= 0) {
                    SPIFFS_close(&spiffs_fs, f);
                    printf("Nothing to dump!\n");
                    return;
                }


                buf = SHELL_MALLOC(DUMP_SIZE);
                if (buf) {
                    SPIFFS_lseek(&spiffs_fs, f, start, SPIFFS_SEEK_SET);

                    do {
                        size_t to_read = (size < DUMP_SIZE) ? size : DUMP_SIZE;

                        // SPIFFS_read returns int32_t. Negative on error/EOF.
                        bytes_read = SPIFFS_read(&spiffs_fs, f, buf, to_read);

                        if (bytes_read > 0) {
                            dump_bytes(ctx, buf, start, bytes_read);
                            size -= bytes_read;
                            start += bytes_read;
                            c = term_getch(&ctx->t, TERM_INPUT_DONT_WAIT);
                        }
                    } while (size > 0 && bytes_read > 0 && (c < 0));

                    SHELL_FREE(buf);
                } else {
                    printf("Memory allocation failed\n");
                }
            } else {
                printf("Failed to stat file\n");
            }
            SPIFFS_close(&spiffs_fs, f);
        }
        else {
            printf("Unable to open '%s' (Error: %d)\n", argv[2], f);
        }
    }
    else if (strcmp(argv[1], "format") == 0) {
        printf("Be patient, this may take a while.\n");
        printf("Formatting...\n");
        TickType_t start = xTaskGetTickCount();
        SPIFFS_unmount(&spiffs_fs);
        if (SPIFFS_format(&spiffs_fs) != SPIFFS_OK) {
            printf("SPIFFS format failed: %d\n", SPIFFS_errno(&spiffs_fs));
        }
        TickType_t end = xTaskGetTickCount();
        printf("Time spent: %d seconds\n", (end - start) / configTICK_RATE_HZ);
        printf("Done. Please reset the board\n");
    }
    else {
        printf("Unknown subcommand: %s\n", argv[1]);
        printf("Usage: fs %s", shell_help_fs);
    }
}


/***********************************************************************
 * CMD: recv
 **********************************************************************/
const char shell_help_recv[] = "<file>\n"
    "  Transfer and save to file\n";
const char shell_help_summary_recv[] = "Receive a file via XMODEM";

void shell_recv( shell_context_t *ctx, int argc, char **argv )
{
    file_xfer_state_t file_state = { 0 };
    long size;

    if( argc != 2 ) {
        printf( "Usage: recv <file>\n" );
        return;
    }

    file_state.xmodem.ctx = ctx;

    file_state.f = SPIFFS_open(&spiffs_fs, argv[1], SPIFFS_O_CREAT | SPIFFS_O_TRUNC | SPIFFS_O_WRONLY, 0);
    if( file_state.f == 0) {
        printf( "unable to open file %s\n", argv[ 1 ] );
        return;
    }
    printf( "Prepare your terminal for XMODEM send ... " );
    term_set_mode(&ctx->t, TERM_MODE_COOKED, 0);
    size = XmodemReceiveCrc(file_data_write, &file_state, 4*1024*1024,
        shell_xmodem_getchar, shell_xmodem_putchar);
    term_set_mode(&ctx->t, TERM_MODE_COOKED, 1);
    if (size < 0) {
        printf( "XMODEM Error: %ld\n", size);
    } else {
        printf( "received and saved as %s\n", argv[ 1 ] );
    }
    SPIFFS_close(&spiffs_fs, file_state.f);
}

/***********************************************************************
 * CMD: send
 **********************************************************************/
const char shell_help_send[] = "<file1> [<file2> ...]\n";
const char shell_help_summary_send[] = "Send files via YMODEM.";

typedef struct {
    file_xfer_state_t state;
    const char *fname;
    size_t fsize;
} ymodem_state_t;

static void ymodem_hdr(void *usr, void *xmodemBuffer, int xmodemSize) {
    ymodem_state_t *y = (ymodem_state_t *)usr;
    snprintf(xmodemBuffer, xmodemSize, "%s%c%u", y->fname, 0, (unsigned)y->fsize);
}

static void ymodem_end(void *xs, void *xmodemBuffer, int xmodemSize) {
}

void shell_send(shell_context_t *ctx, int argc, char **argv)
{
    size_t size;
    spiffs_file fp = 0;
    int ret = -1;
    int i;

    ymodem_state_t y = {
        .state.xmodem.ctx = ctx,
    };

    if (argc < 2) {
        printf("Usage: %s <file1> [<file2> ...]\n", argv[0]);
        return;
    }

    printf ("Prepare your terminal for YMODEM receive...\n");
    term_set_mode(&ctx->t, TERM_MODE_COOKED, 0);
    for (i = 1; i < argc; i++) {
        fp = SPIFFS_open(&spiffs_fs, argv[i], SPIFFS_O_RDONLY, 0);
        if (fp) {
            spiffs_stat s;
            SPIFFS_fstat(&spiffs_fs, fp, &s);
            size = s.size;
            y.fname = argv[i]; y.fsize = size; y.state.f = fp;
            ret = XmodemTransmit(ymodem_hdr, &y, 128, 0, 1,
                shell_xmodem_getchar, shell_xmodem_putchar);
            if (ret >= 0) {
                ret = XmodemTransmit(file_data_read, &y, y.fsize, 1, 0,
                    shell_xmodem_getchar, shell_xmodem_putchar);
            }
            SPIFFS_close(&spiffs_fs, fp);
            if (ret < 0) {
                break;
            }
        }
        else {
            printf("File not found\n");
            ret = -1;
        }
    }
    if (ret >= 0) {
        ret = XmodemTransmit(ymodem_end, &y, 128, 0, 1,
            shell_xmodem_getchar, shell_xmodem_putchar);
    }
    term_set_mode(&ctx->t, TERM_MODE_COOKED, 1);
    if (ret < 0) {
        printf( "YMODEM Error: %ld\n", ret);
    }
}


const char shell_help_setvolt[] = "<rail> <volt>\n";
const char shell_help_summary_setvolt[] = "Set voltage";

void shell_setvolt(shell_context_t *ctx, int argc, char **argv) {
    if (argc < 3) {
        printf("Usage: <rail> <volt>\n", argv[0]);
        return;
    }

    float volt = 0.0f;
    if (!numfmt_parse_float(argv[2], &volt)) {
        printf("Invalid voltage\n");
        return;
    }
    if (strcmp(argv[1], "vcom") == 0) {
        power_set_vcom(volt);
    }
    else if (strcmp(argv[1], "vgh") == 0) {
        power_set_vgh(volt);
    }
}
#endif

const char shell_help_power[] = "[status|off|retain|resume|scanstop [on|off]]\n"
  "  status   - Show suspend state, last wake source, and counters.\n"
  "  off      - Enter device-level suspend.\n"
  "  retain   - EPD rails off, image retained on panel, fast resume.\n"
  "  resume   - Request resume from retain or suspend.\n"
  "  scanstop - Also stop the panel scan engine while retained. Saves FPGA\n"
  "             I/O power but freezes the damage counter, so it only applies\n"
  "             to retain requested without image-change wake. Off by\n"
  "             default and not persisted.\n";
const char shell_help_summary_power[] = "Show or change power state";

static const char *power_shell_state_name(power_state_t state) {
    switch (state) {
    case POWER_STATE_ACTIVE:
        return "active";
    case POWER_STATE_SUSPENDING:
        return "suspending";
    case POWER_STATE_SUSPENDED:
        return "suspended";
    case POWER_STATE_RESUMING:
        return "resuming";
    default:
        return "unknown";
    }
}

static const char *power_shell_suspend_reason_name(
        power_suspend_reason_t reason) {
    switch (reason) {
    case POWER_SUSPEND_NONE:
        return "none";
    case POWER_SUSPEND_USER:
        return "user";
    case POWER_SUSPEND_VIDEO_LOSS:
        return "video-loss";
    case POWER_SUSPEND_USB:
        return "usb";
    case POWER_SUSPEND_RETAIN:
        return "retain";
    default:
        return "unknown";
    }
}

static void power_shell_print_wake_sources(shell_context_t *ctx,
        uint32_t wake_sources) {
    bool printed = false;

    printf("0x%02x", (unsigned)wake_sources);
    if (wake_sources == POWER_WAKE_NONE)
        return;

    printf(" (");
    if (wake_sources & POWER_WAKE_BUTTON) {
        printf("button");
        printed = true;
    }
    if (wake_sources & POWER_WAKE_USB_PD) {
        printf("%susbpd", printed ? "," : "");
        printed = true;
    }
    if (wake_sources & POWER_WAKE_USB) {
        printf("%susb", printed ? "," : "");
        printed = true;
    }
    if (wake_sources & POWER_WAKE_INPUT) {
        printf("%sinput", printed ? "," : "");
        printed = true;
    }
    if (wake_sources & POWER_WAKE_DAMAGE) {
        printf("%sdamage", printed ? "," : "");
    }
    printf(")");
}

void shell_power(shell_context_t *ctx, int argc, char **argv) {
    if ((argc > 1) && (strcmp(argv[1], "off") == 0)) {
        printf("Suspending\n");
        power_off();
        return;
    }

    if ((argc > 1) && (strcmp(argv[1], "retain") == 0)) {
        printf("Requesting retain suspend\n");
        power_post_request(POWER_REQ_RETAIN);
        return;
    }

    if ((argc > 1) && (strcmp(argv[1], "resume") == 0)) {
        printf("Requesting resume\n");
        power_post_request(POWER_REQ_RESUME);
        return;
    }

    if ((argc > 1) && (strcmp(argv[1], "scanstop") == 0)) {
        if (argc > 2)
            ui_set_retain_scan_stop(strcmp(argv[2], "on") == 0);
        printf("retain scan stop: %s\n",
                ui_get_retain_scan_stop() ? "on" : "off");
        return;
    }

    if ((argc > 1) && (strcmp(argv[1], "status") != 0)) {
        printf("Usage: power [status|off|retain|resume|scanstop [on|off]]\n");
        return;
    }

    printf("state: %s\n", power_shell_state_name(power_get_state()));
    printf("caster features: 0x%02x\n", (unsigned)caster_features());
    printf("retain scan stop: %s\n",
            ui_get_retain_scan_stop() ? "on" : "off");
    printf("current reason: %s\n",
            power_shell_suspend_reason_name(
                power_get_current_suspend_reason()));
    printf("last reason: %s\n",
            power_shell_suspend_reason_name(power_get_last_suspend_reason()));
    printf("last wake: ");
    power_shell_print_wake_sources(ctx, power_get_last_wake_sources());
    printf("\n");
    printf("suspend count: %u\n", (unsigned)power_get_suspend_count());
    printf("resume count: %u\n", (unsigned)power_get_resume_count());
}

const char shell_help_setres[] =
    "<size_in> <x_res> <y_res> <ref_hz> <cvt-rb2|cvt-rb>\n"
    "  Calculates display timing, updates config, and saves config.bin.\n";
const char shell_help_summary_setres[] = "Calculate and save display timing";

static void shell_print_timing_summary(shell_context_t *ctx,
        config_timing_standard_t standard, uint16_t refresh_hz) {
    printf("Timing standard: %s\n", config_timing_standard_name(standard));
    printf("Refresh target: %u Hz\n", (unsigned)refresh_hz);
    printf("PCLK: %u Hz\n", (unsigned)config.pclk_hz);
    printf("HACT: %u\n", (unsigned)config.hact);
    printf("HBLK: %u\n", (unsigned)config.hblk);
    printf("HFP:  %u\n", (unsigned)config.hfp);
    printf("HSW:  %u\n", (unsigned)config.hsync);
    printf("VACT: %u\n", (unsigned)config.vact);
    printf("VBLK: %u\n", (unsigned)config.vblk);
    printf("VFP:  %u\n", (unsigned)config.vfp);
    printf("VSW:  %u\n", (unsigned)config.vsync);
    printf("TCON_HACT: %u\n", (unsigned)config.tcon_hact);
    printf("TCON_HFP:  %u\n", (unsigned)config.tcon_hfp);
    printf("TCON_HSW:  %u\n", (unsigned)config.tcon_hsync);
    printf("TCON_HBP:  %u\n", (unsigned)config.tcon_hbp);
    printf("TCON_VACT: %u\n", (unsigned)config.tcon_vact);
    printf("TCON_VFP:  %u\n", (unsigned)config.tcon_vfp);
    printf("TCON_VSW:  %u\n", (unsigned)config.tcon_vsync);
    printf("TCON_VBP:  %u\n", (unsigned)config.tcon_vbp);
}

void shell_setres( shell_context_t *ctx, int argc, char **argv )
{
    float size_in = 0.0f;
    uint16_t x_res;
    uint16_t y_res;
    uint16_t refresh_hz;
    config_timing_standard_t standard;

    if (argc != 6) {
        printf("Usage: setres %s", shell_help_setres);
        return;
    }

    if (!numfmt_parse_float(argv[1], &size_in) || (size_in <= 0.0f)) {
        printf("Invalid size_in\n");
        return;
    }
    if (!shell_parse_uint16(argv[2], 1, 65535, &x_res) ||
            !shell_parse_uint16(argv[3], 1, 65535, &y_res) ||
            !shell_parse_uint16(argv[4], 1, 1000, &refresh_hz)) {
        printf("Invalid resolution or refresh rate\n");
        return;
    }
    if (!config_timing_standard_from_string(argv[5], &standard)) {
        printf("Unknown timing standard: %s\n", argv[5]);
        printf("Usage: setres %s", shell_help_setres);
        return;
    }

    if (!config_apply_display_timing(&config, size_in, x_res, y_res,
            refresh_hz, standard)) {
        printf("Unable to calculate timing\n");
        return;
    }

    config_save();
    shell_print_timing_summary(ctx, standard, refresh_hz);
    printf("Saved config.bin\n");
}


const char shell_help_setcfg[] = "<set|get|save> [key] [value]\n";
const char shell_help_summary_setcfg[] = "Sets configuration. Remember to use save to save it to the flash.";

typedef struct {
    const char *name;
    void *pointer;
    enum {UINT8, UINT16, UINT32, FLOAT32, STRING} type;
} cfg_var_t;

cfg_var_t vars[] = {
    {"pclk_hz", &(config.pclk_hz), UINT32},
    {"hfp", &(config.hfp), UINT8},
    {"vfp", &(config.vfp), UINT8},
    {"hsync", &(config.hsync), UINT8},
    {"vsync", &(config.vsync), UINT8},
    {"hact", &(config.hact), UINT16},
    {"hblk", &(config.hblk), UINT16},
    {"vact", &(config.vact), UINT16},
    {"vblk", &(config.vblk), UINT16},
    {"size_x_mm", &(config.size_x_mm), UINT16},
    {"size_y_mm", &(config.size_y_mm), UINT16},
    {"mfg_week", &(config.mfg_week), UINT8},
    {"mfg_year", &(config.mfg_year), UINT8},
    {"vcom", &(config.vcom), FLOAT32},
    {"vgh", &(config.vgh), FLOAT32},
    {"tcon_vfp", &(config.tcon_vfp), UINT8},
    {"tcon_vsync", &(config.tcon_vsync), UINT8},
    {"tcon_vbp", &(config.tcon_vbp), UINT8},
    {"tcon_vact", &(config.tcon_vact), UINT16},
    {"tcon_hfp", &(config.tcon_hfp), UINT8},
    {"tcon_hsync", &(config.tcon_hsync), UINT8},
    {"tcon_hbp", &(config.tcon_hbp), UINT8},
    {"tcon_hact", &(config.tcon_hact), UINT16},
    {"mirror", &(config.mirror), UINT8},
    {"input_sel", &(config.input_sel), UINT8},
    {"bitstream", &(config.bitstream), STRING}
};
int num_vars = sizeof(vars) / sizeof(cfg_var_t);

static void setcfg_set_helper(shell_context_t *ctx, cfg_var_t *var, char *val) {
    if (var->type == UINT8) {
        *(uint8_t *)(var->pointer) = strtol(val, NULL, 10);
    }
    else if (var->type == UINT16) {
        *(uint16_t *)(var->pointer) = strtol(val, NULL, 10);
    }
    else if (var->type == UINT32) {
        *(uint32_t *)(var->pointer) = strtol(val, NULL, 10);
    }
    else if (var->type == FLOAT32) {
        float parsed = 0.0f;
        if (!numfmt_parse_float(val, &parsed)) {
            printf("Invalid value\n");
            return;
        }
        *(float *)(var->pointer) = parsed;
    }
    else if (var->type == STRING) {
        if (strlen(val) >= BITSTREAM_NAME_MAX) {
            printf("Error: value too long (max %d chars)\n", BITSTREAM_NAME_MAX - 1);
            return;
        }
        strncpy((char *)(var->pointer), val, BITSTREAM_NAME_MAX);
        ((char *)(var->pointer))[BITSTREAM_NAME_MAX - 1] = '\0';
    }
}

static void setcfg_get_helper(shell_context_t *ctx, cfg_var_t *var) {
    if (var->type == UINT8) {
        printf("%d\n", *(uint8_t *)(var->pointer));
    }
    else if (var->type == UINT16) {
        printf("%d\n", *(uint16_t *)(var->pointer));
    }
    else if (var->type == UINT32) {
        printf("%d\n", *(uint32_t *)(var->pointer));
    }
    else if (var->type == FLOAT32) {
        shell_print_fixed(ctx, *(float *)(var->pointer), 3);
        printf("\n");
    }
    else if (var->type == STRING) {
        printf("%s\n", (char *)(var->pointer));
    }
}

void shell_setcfg(shell_context_t *ctx, int argc, char **argv) {
    if (argc < 2) {
        printf("Usage: %s\n", shell_help_setcfg);
        return;
    }

    cfg_var_t *var = NULL;
    if (argc >= 3) {
        for (int i = 0; i < num_vars; i++) {
            if (strcmp(argv[2], vars[i].name) == 0) {
                var = &vars[i];
            }
        }
        if (var == NULL) {
            printf("Unknown key %s", argv[2]);
            return;
        }
    }

    if (strcmp(argv[1], "set") == 0) {
        if (argc < 4) {
            printf("Key and value required for set\n");
            return;
        }
        setcfg_set_helper(ctx, var, argv[3]);
    }
    else if (strcmp(argv[1], "get") == 0) {
        if (argc < 4) {
            // Get every var
            for (int i = 0; i < num_vars; i++) {
                printf("%s: ", vars[i].name);
                setcfg_get_helper(ctx, &vars[i]);
            }
        }
        else {
            setcfg_get_helper(ctx, var);
        }
    }
    else if (strcmp(argv[1], "save") == 0) {
        config_save();
    }
}

#ifdef GLIDER_DIAGNOSTIC_SHELL
const char shell_help_sensor[] = "\n";
const char shell_help_summary_sensor[] = "Get sensor readings";

void shell_sensor(shell_context_t *ctx, int argc, char **argv) {
    printf("EPD Supplies:\n");
    printf("VP:     "); shell_print_fixed(ctx, power_get_rail_voltage(RAIL_VP), 2); printf(" V\n");
    printf("VGH:    "); shell_print_fixed(ctx, power_get_rail_voltage(RAIL_VGH), 2); printf(" V\n");
    printf("VN:     "); shell_print_fixed(ctx, power_get_rail_voltage(RAIL_VN), 2); printf(" V\n");
    printf("VGL:    "); shell_print_fixed(ctx, power_get_rail_voltage(RAIL_VGL), 2); printf(" V\n");
    printf("VCOM:   "); shell_print_fixed(ctx, power_get_rail_voltage(RAIL_VCOM), 2); printf(" V\n");
    printf("5VES:   "); shell_print_fixed(ctx, power_get_rail_voltage(RAIL_5VES), 2); printf(" V "); shell_print_fixed(ctx, power_get_rail_current(RAIL_5VES), 0); printf(" mA\n");
    printf("5VEG:   "); shell_print_fixed(ctx, power_get_rail_voltage(RAIL_5VEG), 2); printf(" V "); shell_print_fixed(ctx, power_get_rail_current(RAIL_5VEG), 0); printf(" mA\n");

    printf("System Supplies:\n");
    printf("VBUS:   "); shell_print_fixed(ctx, power_get_rail_voltage(RAIL_VBUS), 2); printf(" V\n");
    printf("3V3:    "); shell_print_fixed(ctx, power_get_rail_voltage(RAIL_3V3), 2); printf(" V "); shell_print_fixed(ctx, power_get_rail_current(RAIL_3V3), 0); printf(" mA\n");
    printf("1V8VID: "); shell_print_fixed(ctx, power_get_rail_voltage(RAIL_1V8VID), 2); printf(" V "); shell_print_fixed(ctx, power_get_rail_current(RAIL_1V8VID), 0); printf(" mA\n");
    printf("3V3VID: "); shell_print_fixed(ctx, power_get_rail_voltage(RAIL_3V3VID), 2); printf(" V "); shell_print_fixed(ctx, power_get_rail_current(RAIL_3V3VID), 0); printf(" mA\n");
    printf("5V2FL:  "); shell_print_fixed(ctx, power_get_rail_voltage(RAIL_5V2FL), 2); printf(" V "); shell_print_fixed(ctx, power_get_rail_current(RAIL_5V2FL), 0); printf(" mA\n");
    printf("1V35:   "); shell_print_fixed(ctx, power_get_rail_voltage(RAIL_1V35), 2); printf(" V "); shell_print_fixed(ctx, power_get_rail_current(RAIL_1V35), 0); printf(" mA\n");
    printf("1V2:    "); shell_print_fixed(ctx, power_get_rail_voltage(RAIL_1V2), 2); printf(" V "); shell_print_fixed(ctx, power_get_rail_current(RAIL_1V2), 0); printf(" mA\n");

    float p_cur, p_avg, p_max;
    float p_cur_sum, p_avg_sum, p_max_sum;

    printf("Power Consumption (CUR, AVG, MAX):\n");
    power_get_rail_power(RAIL_3V3, &p_cur, &p_avg, &p_max);
    printf("MCU + IO:  "); shell_print_fixed(ctx, p_cur, 1); printf(" mW  "); shell_print_fixed(ctx, p_avg, 1); printf(" mW  "); shell_print_fixed(ctx, p_max, 1); printf(" mW\n");
    power_get_rail_power(RAIL_1V35, &p_cur, &p_avg, &p_max);
    printf("FPGA DDR:  "); shell_print_fixed(ctx, p_cur, 1); printf(" mW  "); shell_print_fixed(ctx, p_avg, 1); printf(" mW  "); shell_print_fixed(ctx, p_max, 1); printf(" mW\n");
    power_get_rail_power(RAIL_1V2, &p_cur, &p_avg, &p_max);
    printf("FPGA CORE: "); shell_print_fixed(ctx, p_cur, 1); printf(" mW  "); shell_print_fixed(ctx, p_avg, 1); printf(" mW  "); shell_print_fixed(ctx, p_max, 1); printf(" mW\n");
    power_get_rail_power(RAIL_1V8VID, &p_cur_sum, &p_avg_sum, &p_max_sum);
    power_get_rail_power(RAIL_3V3VID, &p_cur, &p_avg, &p_max);
    p_cur_sum += p_cur; p_avg_sum += p_avg; p_max_sum += p_max;
    printf("VIDEO IN:  "); shell_print_fixed(ctx, p_cur_sum, 1); printf(" mW  "); shell_print_fixed(ctx, p_avg_sum, 1); printf(" mW  "); shell_print_fixed(ctx, p_max_sum, 1); printf(" mW\n");
    power_get_rail_power(RAIL_5VES, &p_cur_sum, &p_avg_sum, &p_max_sum);
    power_get_rail_power(RAIL_5VEG, &p_cur, &p_avg, &p_max);
    p_cur_sum += p_cur; p_avg_sum += p_avg; p_max_sum += p_max;
    printf("EPD HV:    "); shell_print_fixed(ctx, p_cur_sum, 1); printf(" mW  "); shell_print_fixed(ctx, p_avg_sum, 1); printf(" mW  "); shell_print_fixed(ctx, p_max_sum, 1); printf(" mW\n");
}

const char shell_help_damage[] = "[samples]\n"
  "  samples - Optional number of 200 ms damage-counter samples.\n";
const char shell_help_summary_damage[] = "Show Caster damage counter";

void shell_damage(shell_context_t *ctx, int argc, char **argv) {
    int samples = 1;
    uint32_t accumulated = 0;

    if (argc > 1)
        samples = strtol(argv[1], NULL, 0);
    if (samples < 1)
        samples = 1;

    uint8_t id = fpga_write_reg8(CSR_ID0, 0x00);
    uint8_t status = fpga_write_reg8(CSR_STATUS, 0x00);
    uint32_t threshold = autoclear_scaled_threshold(config.autoclear_threshold,
            config.hact, config.vact);

    printf("fpga id: 0x%02x status: 0x%02x\n", id, status);
    printf("autoclear mode: %d interval: %d threshold: %d scaled: %u\n",
            config.autoclear_mode, config.autoclear_interval,
            config.autoclear_threshold, (unsigned)threshold);

    for (int i = 0; i < samples; i++) {
        uint32_t damage = caster_get_damage_counter();
        uint64_t next_accumulated = (uint64_t)accumulated + damage;
        accumulated = (next_accumulated > UINT32_MAX) ?
                UINT32_MAX : (uint32_t)next_accumulated;
        bool trigger = accumulated > threshold;
        uint32_t remaining = trigger ? 0 : threshold - accumulated;

        printf("%d: damage=%u accumulated=%u remaining=%u%s\n", i,
                (unsigned)damage, (unsigned)accumulated,
                (unsigned)remaining, trigger ? " trigger" : "");
        if (trigger)
            accumulated = 0;
        if (i + 1 < samples)
            vTaskDelay(pdMS_TO_TICKS(200));
    }
}

const char shell_help_caster[] = "frames [<b2w> <w2b>]\n"
  "  Show or set the mono drive length, in frames, for a black<->white\n"
  "  transition. Longer drives darken blacks and reduce ghosting at the\n"
  "  cost of latency; the panel runs at the input frame rate, so 9 frames\n"
  "  is only ~120 ms at 75 Hz. Takes effect immediately, and is not\n"
  "  persisted -- caster_init() restores the compiled-in defaults.\n";
const char shell_help_summary_caster[] = "Show/set Caster drive frame counts";

void shell_caster(shell_context_t *ctx, int argc, char **argv) {
    if ((argc < 2) || (strcmp(argv[1], "frames") != 0)) {
        printf("Usage: caster frames [<b2w> <w2b>]\n");
        return;
    }

    if (argc == 4) {
        long b2w = strtol(argv[2], NULL, 0);
        long w2b = strtol(argv[3], NULL, 0);
        // The gateware field is 6 bits, and 0 would mean "never finish".
        if ((b2w < 1) || (b2w > 63) || (w2b < 1) || (w2b > 63)) {
            printf("Frame counts must be 1..63\n");
            return;
        }
        caster_set_mono_frames((uint8_t)b2w, (uint8_t)w2b);
    }
    else if (argc != 2) {
        printf("Usage: caster frames [<b2w> <w2b>]\n");
        return;
    }

    uint8_t b2w, w2b;
    caster_get_mono_frames(&b2w, &w2b);
    printf("b2w=%u w2b=%u frames\n", (unsigned)b2w, (unsigned)w2b);
}
#endif
