UavL/Glider/fw/User/caster.c

//
// Grimoire
// Copyright 2025 Wenting Zhang
//
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
#include "platform.h"
#include "board.h"
#include "app.h"
#include "tone_lut.h"

static size_t last_update;
static size_t last_update_duration;
static uint8_t waveform_frames;
static uint8_t mono_b2w_frames;
static uint8_t mono_w2b_frames;
// CSR_ENABLE is write-only and holds three independent bits, so track it here
// rather than having each setter guess at the others.
static uint8_t csr_enable_shadow;
static uint8_t csr_features;

enum {
    CASTER_MIN_DRV = 2,
    // Swept against real text on hardware, 2026-08-04: 9 (the old value, ~120 ms
    // at 75 Hz) leaves body text grey and the background visibly off-white,
    // because in auto-LUT a pixel whose target is pure black or white gets this
    // one unipolar drive and then never runs the waveform LUT again. 12/16/20/24
    // were compared with a full clear between each; 12 was the point where the
    // background went clean without the page turn feeling sluggish. w2b is two
    // frames longer so that pixels arriving at black from different histories
    // land closer together -- that shows up as ghost text inside large solid
    // black areas, which nothing else fixes short of a full refresh.
    //
    // These feed BASEMODE_FAST_MONO as well as BASEMODE_AUTO_LUT
    // (pixel_processing.v:460 and :338/:379), so they also lengthen transitions
    // in the fast-mono display mode. Tuned for Reading; see NOTES-STATUS.md.
    CASTER_FASTM_B2W_FRAMES = 12,
    CASTER_FASTM_W2B_FRAMES = 14,
    CASTER_FASTG_B2G_FRAMES = 2,
    CASTER_FASTG_W2G_FRAMES = 2,
};

static uint8_t get_update_frames(void) {
    // Should be worst case time to clear/ update a frame
    //uint8_t min_time = 10; // Minimum time for non-LUT modes
    // actually, just always return 0.5s
    return 16;
}

static uint16_t osd_x_pixel_to_group(uint16_t pixels) {
    return (uint16_t)((pixels + 3u) / 4u);
}

static void wait(void) {
    // Reading is not implemented in the simulator
}

void caster_init(void) {
    waveform_frames = 38; // Need to sync with the RTL code
    fpga_write_reg8(CSR_CFG_V_FP, config.tcon_vfp);
    fpga_write_reg8(CSR_CFG_V_SYNC, config.tcon_vsync);
    fpga_write_reg8(CSR_CFG_V_BP, config.tcon_vbp);
    fpga_write_reg16(CSR_CFG_V_ACT, config.tcon_vact);
    fpga_write_reg8(CSR_CFG_H_FP, config.tcon_hfp);
    fpga_write_reg8(CSR_CFG_H_SYNC, config.tcon_hsync);
    fpga_write_reg8(CSR_CFG_H_BP, config.tcon_hbp);
    fpga_write_reg16(CSR_CFG_H_ACT, config.tcon_hact);
    uint32_t frame_bytes = config.tcon_hact * 4 * config.tcon_vact * 2;
    fpga_write_reg8(CSR_CFG_FBYTES_B0, frame_bytes & 0xff);
    fpga_write_reg8(CSR_CFG_FBYTES_B1, (frame_bytes >> 8) & 0xff);
    fpga_write_reg8(CSR_CFG_FBYTES_B2, (frame_bytes >> 16) & 0xff);
    fpga_write_reg8(CSR_CFG_MINDRV, CASTER_MIN_DRV);
    caster_set_mono_frames(CASTER_FASTM_B2W_FRAMES, CASTER_FASTM_W2B_FRAMES);
    fpga_write_reg8(CSR_CFG_FASTG_B2GFRAME, CASTER_FASTG_B2G_FRAMES);
    fpga_write_reg8(CSR_CFG_FASTG_W2GFRAME, CASTER_FASTG_W2G_FRAMES);
    fpga_write_reg8(CSR_LUT_FRAME, 38);
    caster_osd_set_window(0, 0, CASTER_OSD_WIDTH, CASTER_OSD_HEIGHT);
    fpga_write_reg8(CSR_OSD_EN, 0);
    fpga_write_reg8(CSR_CFG_MIRROR, config.mirror);
    caster_set_tone(config.lightness, config.contrast);
    csr_enable_shadow = CASTER_EN_REFRESH;
    fpga_write_reg8(CSR_ENABLE, csr_enable_shadow); // Enable refresh
    // Cache the feature bitmap: the FPGA is reconfigured from the same file on
    // every pipeline start, so it can only change here.
    uint8_t raw = fpga_write_reg8(CSR_FEATURES, 0x00);
    // Trust the bitmap only if the signature nibble is intact. An undecoded
    // address reads 0 and a stale bitstream can alias this address onto an
    // unrelated register, so anything else means "assume no features".
    csr_features = ((raw & ~CASTER_FEATURE_MASK) == CASTER_FEATURE_MAGIC) ?
            (raw & CASTER_FEATURE_MASK) : 0u;
    syslog_printf("Caster features %02x (raw %02x)", (unsigned)csr_features,
            (unsigned)raw);
}

uint8_t caster_features(void) {
    return csr_features;
}

bool caster_has_feature(uint8_t mask) {
    return (csr_features & mask) == mask;
}

static uint8_t is_busy() {
    uint8_t status = fpga_write_reg8(CSR_STATUS, 0x00);
    return !!(status & STATUS_OP_QUEUE);
}

uint8_t caster_load_waveform(uint8_t *waveform, uint8_t frames) {
    fpga_write_reg8(CSR_LUT_FRAME, 0); // Reset value before loading
    fpga_write_reg16(CSR_LUT_ADDR, 0);
    fpga_write_bulk(CSR_LUT_WR, waveform, WAVEFORM_SIZE);
    waveform_frames = frames;
    return 0;
}

uint8_t caster_redraw(uint16_t x0, uint16_t y0, uint16_t x1, uint16_t y1) {
    //if (is_busy()) return 1;
    fpga_write_reg16(CSR_OP_LEFT, x0);
    fpga_write_reg16(CSR_OP_TOP, y0);
    fpga_write_reg16(CSR_OP_RIGHT, x1);
    fpga_write_reg16(CSR_OP_BOTTOM, y1);
    fpga_write_reg8(CSR_OP_LENGTH, get_update_frames());
    fpga_write_reg8(CSR_OP_CMD, OP_EXT_REDRAW);
    return 0;
}

uint8_t caster_setmode(uint16_t x0, uint16_t y0, uint16_t x1, uint16_t y1,
        update_mode_t mode) {
    //if (is_busy()) return 1;
    fpga_write_reg16(CSR_OP_LEFT, x0);
    fpga_write_reg16(CSR_OP_TOP, y0);
    fpga_write_reg16(CSR_OP_RIGHT, x1);
    fpga_write_reg16(CSR_OP_BOTTOM, y1);
    fpga_write_reg8(CSR_OP_LENGTH, get_update_frames());
    fpga_write_reg8(CSR_OP_PARAM, (uint8_t)mode);
    fpga_write_reg8(CSR_OP_CMD, OP_EXT_SETMODE);
    return 0;
}

uint32_t caster_get_damage_counter(void) {
    uint32_t damage = 0;
    damage |= (uint32_t)(fpga_write_reg8(CSR_DAMAGE_COUNT_HI, 0x00) & 0x1f) << 16;
    damage |= (uint32_t)fpga_write_reg8(CSR_DAMAGE_COUNT_MID, 0x00) << 8;
    damage |= (uint32_t)fpga_write_reg8(CSR_DAMAGE_COUNT_LO, 0x00);
    return damage;
}

// Wait until no host-issued operation is queued or being processed.
// Returns 0 when idle, 1 on timeout.
uint8_t caster_wait_idle(uint32_t timeout_ms) {
    const uint8_t busy_mask =
            (uint8_t)((1u << STATUS_OP_BUSY) | (1u << STATUS_OP_QUEUE));
    uint32_t waited = 0;

    while (1) {
        uint8_t status = fpga_write_reg8(CSR_STATUS, 0x00);
        if ((status & busy_mask) == 0)
            return 0;
        if (waited >= timeout_ms)
            return 1;
        sleep_ms(5);
        waited += 5;
    }
}

// Mono drive length for a black<->white transition, in panel frames. The CSR
// space is write-only below 128, so keep a shadow for readback.
//
// In Reading mode (auto LUT) a pixel whose target is pure black or pure white
// gets exactly one unipolar drive of this length and then nothing else -- the
// waveform LUT is skipped for binary targets -- so this is the single knob
// that controls how hard body text is driven, and therefore how much it
// ghosts. Tunable at runtime so it can be swept against a real page of text
// (see the 'caster frames' shell command).
void caster_set_mono_frames(uint8_t b2w, uint8_t w2b) {
    mono_b2w_frames = b2w;
    mono_w2b_frames = w2b;
    fpga_write_reg8(CSR_CFG_B2WFRAME, b2w);
    fpga_write_reg8(CSR_CFG_W2BFRAME, w2b);
}

void caster_get_mono_frames(uint8_t *b2w, uint8_t *w2b) {
    if (b2w != NULL)
        *b2w = mono_b2w_frames;
    if (w2b != NULL)
        *w2b = mono_w2b_frames;
}

static void csr_enable_update(uint8_t mask, bool set) {
    if (set)
        csr_enable_shadow |= mask;
    else
        csr_enable_shadow &= (uint8_t)~mask;
    fpga_write_reg8(CSR_ENABLE, csr_enable_shadow);
}

// Freeze/unfreeze input tracking. See CASTER_EN_HOLD: a no-op on gateware
// without CASTER_FEATURE_HOLD, so callers must not depend on it alone.
void caster_set_hold(bool hold) {
    csr_enable_update(CASTER_EN_HOLD, hold);
}

// Start/stop the panel scan engine. With the scan stopped the gateware drives
// nothing: the EPD source/gate bus stops toggling and the framebuffer read
// traffic stops, which is where the FPGA's share of the always-on rails goes.
//
// Only safe on gateware with CASTER_FEATURE_HOLD. Before that the video input
// FIFO had no drain path while the scan was stopped and desynced permanently,
// with no way to flush it. It also blinds the damage counter, which is only
// updated while the scan runs -- so this and damage wake are mutually
// exclusive.
void caster_set_refresh(bool enable) {
    if (!caster_has_feature(CASTER_FEATURE_HOLD))
        return;
    csr_enable_update(CASTER_EN_REFRESH, enable);
}

// True while the gateware is still driving pixels. Reads false on gateware
// without STATUS_PANEL_ACTIVE, so treat it as a lower bound on settle time.
bool caster_panel_active(void) {
    uint8_t status = fpga_write_reg8(CSR_STATUS, 0x00);
    return !!(status & (1u << STATUS_PANEL_ACTIVE));
}

uint8_t caster_setinput(uint8_t input_src) {
//    if (is_busy()) return 1;
//    fpga_write_reg8(CSR_CFG_IN_SRC, input_src);
    return 0;
}

void caster_redraw_blank(void) {
    fpga_write_reg16(CSR_OP_LEFT, 0);
    fpga_write_reg16(CSR_OP_TOP, 0);
    fpga_write_reg16(CSR_OP_RIGHT, config.hact);
    fpga_write_reg16(CSR_OP_BOTTOM, config.vact);
    fpga_write_reg8(CSR_OP_LENGTH, get_update_frames());
    csr_enable_update(CASTER_EN_BLANK, true);
    fpga_write_reg8(CSR_OP_CMD, OP_EXT_REDRAW);
}


uint8_t caster_osd_send_buf(uint8_t *buf) {
    fpga_write_reg16(CSR_OSD_ADDR, 0);
    fpga_write_bulk(CSR_OSD_WR, buf, CASTER_OSD_BUF_SIZE);
    return 0;
}

uint8_t caster_osd_set_window(uint16_t left, uint16_t top,
        uint16_t logical_width, uint16_t logical_height) {
    uint16_t scale = config.osd_scale_2x ? 2u : 1u;
    uint16_t right = left + logical_width * scale;
    uint16_t bottom = top + logical_height * scale;

    fpga_write_reg8(CSR_OSD_SCALE, config.osd_scale_2x ? 1 : 0);
    fpga_write_reg16(CSR_OSD_LEFT, osd_x_pixel_to_group(left));
    fpga_write_reg16(CSR_OSD_RIGHT, osd_x_pixel_to_group(right));
    fpga_write_reg16(CSR_OSD_TOP, top);
    fpga_write_reg16(CSR_OSD_BOTTOM, bottom);
    return 0;
}

uint8_t caster_osd_set_enable(bool en) {
    fpga_write_reg8(CSR_OSD_EN, en);
    return 0;
}

void caster_set_tone(int lightness, int contrast) {
    uint8_t lut[TONE_LUT_SIZE];

    tone_lut_build_y(lightness, contrast, lut);
    fpga_write_reg8(CSR_TONE_ADDR, 0);
    fpga_write_bulk(CSR_TONE_WR, lut, TONE_LUT_SIZE);
}

uint8_t caster_input_status(void) {
    return fpga_write_reg8(CSR_INPUT_STATUS, 0x00);
}

void caster_input_force_internal(void) {
    fpga_write_reg8(CSR_INPUT_CTRL, INPUT_CTRL_INTERNAL);
}

void caster_input_request_tmds(void) {
    fpga_write_reg8(CSR_INPUT_CTRL, INPUT_CTRL_TMDS);
}

void caster_input_request_dp(void) {
    fpga_write_reg8(CSR_INPUT_CTRL, INPUT_CTRL_DP);
}

void caster_input_request_auto(void) {
    fpga_write_reg8(CSR_INPUT_CTRL, INPUT_CTRL_AUTO);
}

void caster_input_get_measured(uint16_t *hact, uint16_t *vact,
        uint16_t *htotal, uint16_t *vtotal) {
    uint16_t hact_value = ((uint16_t)fpga_write_reg8(CSR_INPUT_MEAS_HACT_HI, 0x00) << 8) |
            fpga_write_reg8(CSR_INPUT_MEAS_HACT_LO, 0x00);
    uint16_t vact_value = ((uint16_t)fpga_write_reg8(CSR_INPUT_MEAS_VACT_HI, 0x00) << 8) |
            fpga_write_reg8(CSR_INPUT_MEAS_VACT_LO, 0x00);
    uint16_t htotal_value = ((uint16_t)fpga_write_reg8(CSR_INPUT_MEAS_HTOT_HI, 0x00) << 8) |
            fpga_write_reg8(CSR_INPUT_MEAS_HTOT_LO, 0x00);
    uint16_t vtotal_value = ((uint16_t)fpga_write_reg8(CSR_INPUT_MEAS_VTOT_HI, 0x00) << 8) |
            fpga_write_reg8(CSR_INPUT_MEAS_VTOT_LO, 0x00);

    if (hact != NULL)
        *hact = hact_value << 1;
    if (vact != NULL)
        *vact = vact_value;
    if (htotal != NULL)
        *htotal = htotal_value << 1;
    if (vtotal != NULL)
        *vtotal = vtotal_value;
}
