UavL/Glider/fw/User/usbpd.c

//
// Grimoire
// Copyright 2025 Wenting Zhang
//
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
#include "platform.h"
#include "board.h"
#include "app.h"
#include "wake_event_latch.h"
#include "usbpd/usb_pd.h"
#include "usbpd/tcpm.h"

static SemaphoreHandle_t isr_sem = NULL;
bool dp_ready = false;
static wake_event_latch_t wake_latch;
static volatile bool hpd_sent = false;
static volatile bool hpd_low_requested = false;
static volatile bool displayport_suspended = false;

void usbpd_isr(void) {
    BaseType_t context_switch = pdFALSE;

    wake_event_latch_signal(&wake_latch);
    if (isr_sem) {
        xSemaphoreGiveFromISR(isr_sem, &context_switch);
        portYIELD_FROM_ISR(context_switch);
    }
}

void usbpd_arm_wake(void) {
    wake_event_latch_arm(&wake_latch);
}

void usbpd_disarm_wake(void) {
    wake_event_latch_disarm(&wake_latch);
}

bool usbpd_take_wake_event(void) {
    return wake_event_latch_take(&wake_latch);
}

static void usbpd_poke_task(void) {
    if (isr_sem)
        xSemaphoreGive(isr_sem);
}

void usbpd_suspend_displayport(void) {
    displayport_suspended = true;
    dp_ready = false;
    hpd_sent = false;
    hpd_low_requested = true;
    usbpd_poke_task();
}

void usbpd_resume_displayport(void) {
    displayport_suspended = false;
    dp_ready = false;
    hpd_sent = false;
    usbpd_poke_task();
}

portTASK_FUNCTION(usb_pd_task, pvParameters) {
    isr_sem = xSemaphoreCreateCounting(1, 0);
    extern int dp_enabled;

    int result = tcpm_init(0);
    if (result)
    	syslog_printf("Failed to initialize TCPC\n");

    int cc1, cc2;
    tcpc_config[0].drv->get_cc(0, &cc1, &cc2);
    syslog_printf("CC status %d %d\n", cc1, cc2);
    pd_init(0);
    sleep_ms(50);
    int timeout = 0;
    while (1) {
        // pd_run_state_machine returns microseconds until the next scheduled
        // event. Dividing by 1000 truncates anything under a millisecond to
        // zero ticks, which turns this into a non-blocking spin at priority
        // tskIDLE+4 -- so clamp to one tick. Interrupt-driven events are not
        // delayed by this: the ISR gives the semaphore, and the inner loop
        // below already services a still-asserted TCPC_INT without waiting.
        TickType_t wait_ticks = (timeout > 0) ?
                pdMS_TO_TICKS((uint32_t)timeout / 1000u) : 0;
        if (wait_ticks == 0)
            wait_ticks = 1;
        BaseType_t rtos_result = xSemaphoreTake(isr_sem, wait_ticks);
//        if (rtos_result) {
//            syslog_printf("FUSB302 interrupt");
//            //tcpc_alert(0);
//        }
        do {
            tcpc_alert(0);
            timeout = pd_run_state_machine(0);
            if (!dp_enabled) {
                hpd_sent = false;
                hpd_low_requested = false;
                dp_ready = false;
            }
            else if (hpd_low_requested && !pd_is_vdm_busy(0)) {
                syslog_printf("DP HPD low\n");
                pd_send_hpd(0, hpd_low);
                hpd_low_requested = false;
            }
            else if (!displayport_suspended && !hpd_sent && !pd_is_vdm_busy(0)) {
                syslog_printf("DP enabled\n");
                pd_send_hpd(0, hpd_high);
                hpd_sent = true;
                dp_ready = true;
            }
//            vTaskDelay(pdMS_TO_TICKS(5));
            //xSemaphoreTake(isr_sem, 0); // Clear semaphore
        } while (gpio_get(TCPC_INT) == 0);
    }

    vSemaphoreDelete(isr_sem);
}
