UavL/Glider/(commit log)

2025-10-16 Skip empty lines when dumping wbf
    [main.c]
2025-10-16 Update for new boards; Force reset when lost of signal
    [adv7611.c, board.h, config.c, fpga.c, glider_ec_rtos.ioc, main.c, ptn3460.h, ui.c]
2025-11-23 Implement blanking and power-off
2025-11-24 Fix tick time calculation
    [board.c]
2025-12-07 add the hash for current Git head to the 'ver' shell command
2026-01-26 Disable VCOM when powering off
2026-02-27 Fix reboot loop when input source is not auto
    [ui.c]
2026-03-03 Update waveform tools to support multi-voltage panels
2026-05-09 add state tracking for PTN3460 to avoid race condition
    This fixes a bug where the USB PD task may try to send i2c commands to
    PTN3460 after it's being shut down, which causes fw to lock up
2026-05-10 add compiler config for building run-from-RAM debug fw
    * DebugRAM build configuration is added in STM32CubeIDE. The default is
    still 'Debug', so the new config must be intentionally selected when
    building the firmware. The differences from the 'Debug' config are:
    * using STM32H750VBTX_RAM.ld linker script instead of _FLASH.ld
    * define USER_VECT_TAB_ADDRESS and VECT_TAB_SRAM; as far as I
    understand, this way the interrupt vectors table is placed in RAM
    as well
    * the linker script is changed to be suitable for STM32H750; the
    original had some settings that don't make sense like 1M continuous
    AXI RAM. This script also includes brief OpenOCD/GDB usage
    instruction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
2026-07-01 Initial support for damage counter
    [caster.c, caster.h]
2026-07-04 Implement damage counter based auto clear
    [autoclear.c, autoclear.h, fpga.c, shell.c, shell_cmds.c, ui.c]
2026-07-04 Remove floating print, gate most shell commands
2026-07-05 Fix flash script regression of not showing progress
    [flash.py]
2026-07-06 Fix flash script size display
    [flash.py]
2026-07-12 Fix compilation warnings and errors under GCC 15
    [usbpd.c]
2026-07-12 Add retain suspend: EPD rails off with image kept on panel
    Adds a lighter suspend mode that powers down the EPD rails while
    keeping the FPGA, framebuffer and video frontends alive, so resume
    only needs to re-energize the rails and redraw instead of a full
    device-level resume. Exposed via shell (power retain/resume), USB
    HID (USBCMD_POWERDOWN/POWERUP params), and flash.py --powerdown/--powerup.
2026-07-12 Add power_survey.py: compare power draw across suspend states
    Drives the device through active/retain/retain-manual/off over USB HID
    (same path as flash.py --powerdown/--powerup) and reads the diagnostic
    'sensor' command's per-rail power breakdown back over its CDC-ACM shell,
    producing a comparison table (optionally CSV) across states.
    Includes a udev rule for the device's HID/CDC interface (VID 1209/PID
    AE86) so it can be used without sudo -- sudo re-resolves python3's
    environment from root's, which can pick up an unrelated package also
    importable as `hid`.
    [power_survey.py]
2026-07-12 Add tty subsystem rule to 99-glider.rules for CDC-ACM shell access
    hidraw permissions were fixed but /dev/ttyACMx (the shell console
    power_survey.py reads over) is a separate udev subsystem and needs its
    own MODE rule.
2026-07-12 Define GLIDER_DIAGNOSTIC_SHELL in all build configs
    Enables the diagnostic shell commands (sensor, mem, test, i2c_probe,
    recv, send, fs, setvolt, damage) gated behind this macro in shell.c,
    needed for power_survey.py to read per-rail power via 'sensor'.
2026-07-12 Harden power_survey.py's resume-on-exit against a second Ctrl+C
    A KeyboardInterrupt during the post-loop resume wait used to abort the
    whole finally block, potentially leaving the HID handle/serial port
    unclosed and, worse, never sending the powerup command if the interrupt
    landed before it. Send the wake command first and guard the wait
    separately so the device is always at least told to resume.
2026-07-29 Add --monitor mode to power_survey.py for live syslog watching
    screen(1) was showing no output for the user across multiple attempts
    (likely just that the device only prints on activity and screen clears
    the terminal on start, or a port-exclusivity conflict). This reuses the
    same pyserial path already proven to work for sensor/power status reads,
    just streaming raw bytes with no HID/state-transition side effects.
2026-07-29 Add CLAUDE.md with build/test commands and architecture overview
    Covers MCU/FPGA build and flash commands, the three test suites (host
    C unit tests, shell-script wiring checks, flash_tool Python tests), and
    the power/suspend state machine, shell diagnostic-command gating, and
    USB HID+CDC composite interface layout uncovered while working on the
    retain-suspend feature and power_survey.py.
2026-07-29 ptn3460: bound the HPD boot wait and settle after DP_PDN release
    Cherry-picked from the ptn3460.c portion of upstream PR #16
    (Modos-Labs/Glider#16, genneth:feat/hid-power-control, commit ced3fa1
    "fw: hook USB HID power commands to power_suspend and add PTN3460
    safeguards").
    Two independent fixes:
    - ptn3460_init() logged "PTN3460 boot timeout" after 500 ticks but kept
    looping forever, so a PTN3460 that never raises DP_HPD hangs ui_task
    before the display pipeline ever starts. Break out instead.
    - ptn3460_early_init() drove DP_PDN high and immediately returned; give
    the part 50 ms to come out of power-down before the first I2C access.
    The usbapp.c portion of PR #16 is deliberately NOT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
2026-07-29 Add NOTES-power-analysis.md: gray-screen root-cause analysis and PR triage
    Static analysis of the video-loss path, power/suspend state machine, and
    upstream PRs #16 and #17, plus an ordered hardware test plan.
    No hardware was observed; every claim is labelled code-derived, inferred,
    estimated, or needing a test.
2026-07-29 NOTES: session 2 - measured power table, resume-from-off reboot analysis
    Claude-Session: https://claude.ai/code/session_01FUYSzf7ini4MS52SyF4P3E
2026-07-29 ui: don't reset on CSR failures while the video input is acquiring
    After a resume (or cable plug-in), a video source can be present at the
    frontend while the FPGA has not yet reported it live. In that window the
    EPDC and its CSR interface run on the still-training input pixel clock
    (Caster top.v wires clk_epdc to the vin mux v_pclk), so register reads
    can glitch or stall. The bare CSR_ID0 sanity check then fired
    NVIC_SystemReset() on a single bad read.
    Confirmed on hardware: resume-from-off with HDMI connected rebooted the
    MCU every time (syslog restarts at 0.000); with HDMI unplugged the same
    resume completes cleanly in 1.2 s. With input_sel pinned to TMDS the
    switch to the untrained clock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
    [ui.c]
2026-07-31 ui: bound LOST suppression to the acquisition grace period
    The gate added in 39d5b71 suppressed the INPUT_STATUS_LOST reload for as
    long as a source was present but not live -- which never expires if the
    source needs that very reload to re-acquire, permanently blocking video
    bring-up. Tie the suppression (and the CSR-failure tolerance) to a shared
    acquire_grace flag so full original behavior returns when the 10 s grace
    period expires.
    Also retry the FPGA configuration once when SYS_READY does not appear
    after bring-up (observed on hardware: CSR_STATUS 0x90 = MIG_ERROR +
    OP_BUSY after resume-from-off left the powered DDR3 unrefreshed), instead
    of proceeding with a sick FPGA and waiting for t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
    [ui.c]
2026-07-31 config: close config.bin after saving -- fixes SPIFFS fd leak
    config_save() opened config.bin and never closed it. The SPIFFS fd
    buffer (fs_fds[32*4] in spiflash.c) only holds a couple of descriptors,
    so two or three settings changes (shell setcfg, any OSD menu change)
    exhausted the table. The next SPIFFS_open then fails with -10007
    (SPIFFS_ERR_OUT_OF_FILE_DESCS) -- observed on hardware as a resume
    failing with "Unable to open bitstream 'fpga.bit': -10007", leaving
    the FPGA unconfigured and the display dead until reboot.
    Present upstream as well: the video-loss recovery path reloads the
    bitstream the same way, so stock firmware loses its display after ~3
    settings changes followed by a signa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
    [config.c]
2026-07-31 ui/fpga: recover from bitstream load failure instead of hanging forever
    fpga_load_bitstream()/fpga_init() now report failure. restart_fpga()
    previously polled CSR_ID0 in an unbounded loop; with no bitstream on the
    FPGA that never succeeds, wedging ui_task permanently (observed on
    hardware after the config_save fd leak made the bitstream open fail:
    'power status' stuck at 'state: resuming', display dead, all power
    requests ignored until a manual reboot).
    Now: a failed load parks in fatal() (EPD rails off, FPGA reset, shell
    alive for debugging -- e.g. 'fs ls'); a successful load that still gets
    no CSR response within 5 s reboots to clear the wedged state. The
    load-failure case never reaches t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
    [fpga.c, fpga.h, ui.c]
2026-07-31 flash.py: pack HID command fields as unsigned
    send_cmd packed the 16-bit fields with signed 'h', which struct.error's
    out for values >= 0x8000 -- e.g. the low word of fpga.bit's 450366-byte
    size (57150), making any bitstream/file upload crash. The fields are
    unsigned on the wire; '<BHHHHHH' is byte-identical for in-range values.
    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
    [flash.py]
2026-07-31 ui: verify FPGA memory health after pipeline start; log font load failures
    The DDR3/MIG failure on the resume path (status 0x90) only surfaces
    after the pipeline starts generating memory traffic, so the early
    wait_fpga_ready() check passes and the sick FPGA previously limped into
    the 10 s acquisition grace before the safety net reset it. Check the
    final status in start_display_pipeline instead: retry the configuration
    once (rails cycled around the reload), and if it is still failing,
    reboot deliberately -- a clean boot is known to recalibrate.
    load_osd_font failures were silent NULL returns, leaving OSD popups as
    blank white boxes with no way to tell why (open error vs alloc vs
    format). Log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
    [ui.c]
2026-07-31 ui: debounce the FPGA-access-lost reset
    The acquisition guard gates on the frontend's lock status polled over
    I2C, but the FPGA's input mux switches clk_epdc as soon as an incoming
    clock appears -- seconds before the ADV7611 lock bit reads true during
    HDMI training. In that gap the bare CSR check ran and reset the board.
    Observed on hardware: replugging HDMI at idle rebooted the board
    (status 21, Input status 00, then 'FPGA access lost; resetting'), and
    resume-from-off looped through ~7 reboots, each one re-initializing the
    ADV7611 and restarting the handshake it was racing.
    On a failed CSR read, re-poll for up to 10 s and only reset if access
    stays dead. Transition dropouts recover within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
    [ui.c]
2026-07-31 ui: gate the input-mux switch on frontend-reported source stability
    Writing CSR_INPUT_CTRL while the selected source's link is still
    training lets the gateware latch clk_epdc onto a clock that can die
    mid-training. vin_source_ctrl runs on clk_epdc itself (Caster top.v),
    so when the selected clock dies the mux FSM freezes with it -- mux,
    FSM and CSR stay dead until a bitstream reload. Downstream, the
    pipeline health check then reads garbage status through the dead bus,
    'retries', and ends in NVIC_SystemReset; each reboot re-inits the
    ADV7611 and restarts the very handshake it is racing. Observed on
    hardware as a ~10-cycle reboot loop on resume-with-HDMI, with the
    panel darkening each cycle fr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
    [ui.c]
2026-07-31 ui: gate the mux switch on verified video; reload instead of rebooting
    Hardware round 5 exposed two defects in the source-stability gate and
    one wrong policy:
    1. The gate keyed on the ADV7611 TMDS lock bit, which asserts as soon
    as a carrier is present -- long before the source finishes mode-set.
    Observed: 'Input source stable; requesting auto' fired with no video
    flowing, latching the mux onto a clock that then died (frozen panel,
    dead buttons, reset after the debounce). Gate now requires verified
    video: TMDS PLL + vertical filter + DE regeneration locked and the
    ADV7611-measured resolution matching the configured mode (HDMI map
    regs 0x04/0x07-0x0a, same reads as the d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
    [ui.c]
2026-07-31 ui: detect legacy bitstreams without the input-control interface
    The bitstream currently provisioned on the dev board predates the
    INPUT_CTRL/vin_source_ctrl gateware (submodule 2f714ab): it selects the
    video source autonomously, ignores input requests, and always reads
    CSR_INPUT_STATUS as 0x00 -- whereas the current gateware reads at least
    0x19 (INTERNAL + constant STABLE/SUPPORTED) when parked internal. On
    such a bitstream LIVE never asserts, so the live-timeout reload cycled
    the pipeline (and flashed the panel) every ~6 s forever. It also
    explains the long-standing permanent white box: the firmware, blind on
    input status, drew the No Signal popup over working video.
    Detect the 0x00 signa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
2026-07-31 ui: skip the retain-resume redraw when nothing changed while retained
    The retain fast path unconditionally issued a full-screen redraw, which
    drives every pixel through its waveform -- visible as a black flash even
    when the image is identical. enter_retain() records the damage counter
    after the panel settles and the framebuffer stays alive through retain,
    so an unchanged counter at wake means glass and framebuffer still agree:
    resume can simply continue. Damage during retain (content changed while
    rails were off) still triggers the reconciling redraw.
    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
    [ui.c]
2026-07-31 ui: threshold the retain-resume redraw instead of exact-match damage
    The exact damage-counter comparison from 268cfba never skipped in
    practice: with live video a few pixels always change while retained
    (cursor blink, clock digit), so every retain resume still flashed the
    panel. Skip the reconciling redraw unless more than 1% of the panel
    changed while retained -- small churn leaves those pixels stale until
    they next change (invisible in practice), while a page turn is orders
    of magnitude above the threshold and still redraws. Delta is masked
    against the 21-bit counter wrap.
    Note the interaction with damage wake: default retain auto-wakes on the
    first damage change, so deltas at wake are na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
    [ui.c]
2026-07-31 ui/caster: stop the EPDC during retain to prevent glass-state drift
    Retain left CSR_ENABLE=1, so the EPDC kept processing live video with the
    EPD rails off: it drove each new frame into an unpowered panel while
    updating its internal glass-state model to match. On wake, waveforms were
    then selected against a state the glass did not actually hold -- observed
    as scrambled/superimposed text after a page was turned during retain.
    Add caster_set_enable(); enter_retain() now stops the scan (ENABLE=0,
    +50ms for the in-flight frame) before cutting rails, and the retain fast
    resume re-enables it. Stopped, the scan FSM parks at a frame boundary
    with the framebuffer frozen and consistent with the glass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
    [caster.c, caster.h, ui.c]
2026-07-31 flash_tool: add retain_hook.py, host-side idle/wake manager for reading mode
    Runs on the Pi: watches input devices (page-turn buttons, keyboard,
    touch) via evdev and drives the tiered power strategy over HID. On input
    while suspended it sends POWERUP so the rails come up as the reader
    renders; after --idle it sends POWERDOWN retain-manual (matches the
    EPDC-stopped retain state, no autonomous wake); after --deep-idle it
    escalates to full off (~0.19 W standby). Reuses flash.py's HID plumbing
    (open_dev/send_cmd/USBCMD_*). Reconnects across HID and input-device
    drop-outs; --dry-run logs transitions without sending; --list enumerates
    input devices.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
2026-07-31 Revert "ui/caster: stop the EPDC during retain to prevent glass-state drift"
    This reverts commit d53afdbb2bac0fdbd54330595437f6b9a5b7d97e.
    [caster.c, caster.h, ui.c]
2026-07-31 ui/caster: resync the panel when the image changed during retain
    The EPDC keeps its per-pixel state in the framebuffer and writes it back
    unconditionally while scanning (bo_valid = s5_active). During retain the
    scan keeps running with the EPD rails off, so a page turned while
    retained is consumed normally: the framebuffer advances to the new image
    for pixels the glass never moved. The resume redraw then computes
    waveforms from that baseline and leaves the old and new pages
    superimposed -- the reported scramble.
    Confirmed on hardware: static page through retain is clean; only a
    change during retain scrambles. Also explains why stopping the scan
    (d53afdb, reverted) was worse rather than bette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
    [caster.c, caster.h, ui.c]
2026-07-31 ui: accumulate retain damage -- the counter is per-frame, not cumulative
    The retain redraw never fired. CSR_DAMAGE_COUNT is wired to
    damage_counter_last (caster.v:189) and damage_counter is zeroed at every
    vsync (caster.v:858), so it reports per-frame damage, not a running
    total. enter_retain() snapshotted one frame's count (~0, image quiet)
    and resume compared another frame's count (~0, image static again), so
    the delta was ~0 and stayed under the threshold no matter what happened
    in between -- which is why the scramble survived and only a manual
    refresh cleared it. autoclear_adaptive_update() already treats the
    counter correctly by accumulating per poll; the retain path did not.
    Accumulat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
    [caster.c, caster.h, ui.c]
2026-07-31 NOTES: per-frame damage counter broke the retain trigger; RTL shortcuts ruled out
    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
2026-08-01 retain: hold input tracking and fix the auto-LUT settle race
    The auto-LUT engine keeps driving the glass ~1.63 s after the damage
    counter goes quiet: the gateware waits AUTOLUT_QUIET_FRAMES (60) of
    global quiet before releasing the shared greyscale phase, then follows
    the waveform for csr_lut_frame (38) frames. Neither phase asserts
    pixel_diff, so the damage counter reads zero throughout and cannot see
    any of it. enter_retain() cut the rails ~820 ms after the last change --
    before the greyscale phase had even started. Make the settle wait
    mode-aware (1950 ms for auto-LUT) since it has to be open-loop.
    Also drive two gateware features that do not exist yet, both no-ops on
    the current bitstre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
    [caster.c, caster.h, ui.c]
2026-08-02 scripts: add dev_flash_all.sh; NOTES: the board moved to Caster 2f714ab
    dev_flash_fpga.sh passes --skip-mcu, so flashing gateware silently leaves
    the MCU on whatever it had. That is how the board ended up running new
    gateware against firmware predating a7882e8. dev_flash_all.sh builds both
    sides and flashes both -- dfu-util for the MCU, flash.py over HID for the
    bitstream. Both builds run before anything reaches the board, so a failed
    gateware build cannot strand a freshly flashed MCU on a stale bitstream.
    flash.py's own MCU path hardcodes ./glider_ec_rtos.bin, so the script
    drives dfu-util directly (as dev_flash_mcu.sh does) rather than teaching
    flash.py an extra argument.
    test_release_sc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
2026-08-02 NOTES: 2026-08-02 hardware results, and a compact status handoff
    The measurement is the headline: retain 1395 mW vs active 1496 mW. EPD HV
    is already zero in retain, so retain saves 101 mW -- 6.7% -- and has
    nothing further to switch off. MCU+IO plus VIDEO IN is 1147 mW, 82% of
    retain power, and retain touches neither. That makes the section 11
    gateware plan a correctness fix rather than a power fix, and promotes the
    open question in 12.3 -- whether the internal clock lets the CSR bus
    survive video loss -- to the highest-value item by a wide margin.
    Also recorded: bring-up on 2f714ab passed (the legacy-bitstream line is
    gone, the new timing monitor reads 1448x1072 correctly); last wake 0x10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
2026-08-02 flash_tool: add a udev rule for the STM32 DFU bootloader
    In DFU mode the board enumerates as ST's bootloader (0483:df11), not as the
    Glider (1209:ae86), so the existing rules do not apply and dfu-util needs
    sudo -- which is exactly what the header of this file argues against. Covers
    dev_flash_mcu.sh and dev_flash_all.sh.
    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
2026-08-02 power: ghosting root cause, flash-free retain resume, and MCU idle
    Ghosting in Reading mode is root-caused. In BASEMODE_AUTO_LUT a pixel whose
    target is pure black or pure white gets exactly one unipolar drive of 9
    frames (~120 ms at 75 Hz) and then never runs the waveform LUT:
    pixel_processing.v:348 skips STAGE_GREY when autolut_binary_src ==
    pixel_prev, which is always true once a pixel has settled on a rail. Body
    text therefore gets no DC-balancing pulse ever, and unchanged pixels are
    never re-driven. The balanced 0->0 and 15->15 rows do exist in
    default_waveform.mem -- they are simply unreachable in auto-LUT.
    Compounding it, autoclear defaulted to AC_OFF, so there was no periodic
    refres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
    [autoclear.c, caster.c, caster.h, config.c, shell.c, shell_cmds.c, ui.c]
2026-08-02 R2: SoM and video link selection, with sourcing verified
    Stage 1 of the R2 board design: the decision that gates everything else.
    Every figure here is traced to a datasheet page or a live distributor API,
    not device-class knowledge.
    The constraint. Caster has no image framebuffer -- the 3.0 MB in DDR3 is
    the per-pixel waveform state word, and the target colour comes from the
    live video stream every frame. caster.v ties vin_ready = s1_active, so the
    video input is consumed in lockstep with the panel scan: input frame rate
    and panel frame rate are the same thing. 1448x1072@75 therefore needs a
    127.2 MHz pixel clock, and that single number decides the SoM.
    Decisions taken:
    - Video link: rou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
2026-08-03 R2: Stage 2 is already built; resolve module attachment
    Caster's Spartan-6 target already contains a complete DPI receiver
    (rtl/spartan6/vin_dpi.v), instantiated as SRC_DPI in vin.v, with all 22
    pins placed in constraint.ucf and DPI_PCLK constrained to 165 MHz. It is
    the path the R1 board runs on today -- the ADV7611 decodes HDMI and hands
    the FPGA plain 18-bit parallel RGB (pcb/mainboard/tmds_in.kicad_sch sources
    DPI_PCLK/DE/HS/VS/R2..R7/G2..G7/B2..B7 into fpga_io.kicad_sch).
    So R2 does not add a video path, it deletes the chip in front of an
    existing one, and the plan's Stage 2 -- its largest schedule risk -- is
    closed with no RTL to write. The bus is also 18 bits, not 24: 22 signals.
    Mo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
2026-08-03 R2: procurement list, verified against PHYTEC's hardware manual
    NOTES-R2-procurement.md: exactly what to order and ask, with the primary
    source for each claim.
    Verified from L-1038e (phyCORE-AM62xx HW manual), which changes three
    things:
    - VIN is 4.5-5.5 V, so the SoM needs a boost from a 1S cell. The plan's
    "run everything straight off the cell" holds for every rail but this one.
    - Idle is 1.47 W (293 mA at 5 V, Table 3/4), worse than the 0.89-1.20 W
    assumed. No suspend-to-RAM figure is published anywhere -- and that is
    the number the whole battery estimate rests on. It is now question 1
    to PHYTEC.
    - All of VOUT0_PCLK/DE/HSYNC/VSYNC/DATA0..23 reach the SOM connector on
    the 3.3 V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
2026-08-03 R2: correct the PHYTEC facts against manual revisions A5 and A3
    The first sourcing pass used L-1038e.A1, the revision linked from
    phytec.eu. The current manuals (L-1038e.A5 for PCM-071, L-1041e.A3 for
    the DSC) change three things and add a hazard.
    - Idle is 1.62 W (324 mA at 5 V), not 1.47 W -- A5's changelog says the
    idle and under-load currents were revised. Under load is now 3.26 W.
    This only sharpens the conclusion that the reading state cannot be idle.
    - PHYTEC calls the 240-pin interconnect one connector X1 with columns
    A-D, not X1 and X2. DATA16..23 are column D.
    - VOUT0_DATA16..23 are shared with GPMC0_AD8..15 / BOOTMODE_8..15, each
    with a 100K pull on the SOM, and the manua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
2026-08-03 R2: read the AM62x TRM; consolidate the R2 docs into plan + facts
    The TRM (SPRUIV7C) closes three open questions and removes a hazard:
    - Table 12-361: DSS_DPI2_PCLK "maximum interface frequency is 165MHz".
    That settles PHYTEC's "200MHz" against the datasheet's 165 -- the 200
    belongs to the OLDI path. DPI is 165 MHz against the 127 we need at
    75 Hz, so 30% headroom, confirmed at the source.
    - 12.9.1.2.1: VP2 does "RGB 16/18/24-bit output". Figure 12-471 gives the
    18-bit mapping: DATA[5:0]=B, [11:6]=G, [17:12]=R -- byte for byte what
    vin.v already expects. No remapping.
    - Because 18-bit mode drives only DATA[17:0], the BOOTMODE_8..15 strap
    conflict evaporates: of the strap group o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
2026-08-03 caster: merge upstream gateware, guard feature detection with a signature
    The board is running firmware c185813 + gateware 2f714ab -- the pair from
    before 613e8ee. That is why resume still does a full-screen refresh: the
    redraw-free resume path is gated on CASTER_FEATURE_HOLD, 2f714ab does not
    advertise it, and c185813 predates the branch entirely. 'ver' reports
    c185813 and the build timestamp (Aug 2 19:48) is earlier than 613e8ee
    (Aug 2 23:06). The fix is already written; it has not been flashed.
    Upstream added CSR_INPUT_DEBUG at address 144, where this fork had
    CSR_FEATURES. Moved ours to 145 and added a signature nibble, because the
    collision could actively mislead: CSR_INPUT_DEBUG bit 0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
    [caster.c, caster.h]
2026-08-03 scripts: dev_flash_all.sh never reached the bitstream step
    dfu-util's ':leave' makes the STM32 reboot into the application the moment
    the download finishes, so the device detaches before dfu-util can read
    final status and it exits non-zero with "Error during download
    get_status" -- on every completely successful flash. run_cmd runs bare
    under 'set -e', so dev_flash_all.sh aborted right there and the flash.py
    bitstream transfer that follows never ran: MCU updated, gateware silently
    not. That is precisely the mismatched pair the script exists to prevent.
    Found by running it: the MCU flashed, the script reported failure through
    a tee that masked the exit code, and the bitstream had to be pushe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
2026-08-03 NOTES: first hardware measurements of the 613e8ee power work
    Flashed and verified: ver reports 4f7829d, power status reports
    caster features 0x01, and retain resume no longer flashes the panel --
    confirmed by the hardware owner. power_survey.py across all four states:
    off 190 -> 164.5 mW (-13%)
    active 1496 -> 1466.6 mW (-29 mW)
    retain 1395 -> 1389.6 mW (unchanged, within noise)
    The off improvement is the __WFI idle hook, the shell loop no longer
    waking the core ~500x/s, and the usbpd sub-ms spin fix, measured where
    they matter most. Worth noting the estimate was wrong in the optimistic
    direction: MCU idle alone was projected at 40-80 mW and the whole set
    delivered ~25 mW.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
2026-08-03 NOTES: scanstop measured -- 123 mW, not the estimated 250-400
    First hardware test of 'power scanstop on', which the hold bit made
    retryable after the firmware-only attempt in d53afdb was reverted in
    05cfa68 for panel inversion. Entered via retain-manual, since the path is
    gated on !damage_wake (ui.c:1194). Board resumed cleanly, suspend/resume
    counts matched, scanstop returned to off.
    retain 1389.6 mW
    retain+scanstop 1266.5 mW (-123.1, -8.9%)
    The estimate was wrong and so was the reasoning behind it. It rested on
    "~420 of the 559 mW MCU + IO is FPGA I/O switching", but MCU + IO moved
    only 15.6 mW. Almost all of the saving is framebuffer read traffic
    stopping: FPGA DDR fell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
2026-08-03 NOTES: correct the scanstop result -- it still corrupts the panel
    The 123 mW measurement stands but the state it measured is not safe. The
    panel looked clean immediately after the test and the electrical side was
    correct, so it was recorded as a stable recoverable state. The corruption
    was latent: on later page scrolls words scrambled, and recovery took
    several power off/resume cycles plus scrolling.
    Same failure as d53afdb, reverted in 05cfa68. The assumption that the
    hold bit prevents it -- because the old failure was writeback continuing
    while stopped -- is contradicted. Hold demonstrably works: the feature bit
    reads 0x01 and retain resume is flash-free. Scan-stop corrupts anyway, so
    the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
2026-08-03 caster: fix the frame-count underflow, built and flashed
    Caster 373c7b5: pixel_framecnt_2w/2b saturate instead of wrapping, so
    lowering 'caster frames' at runtime no longer strands mid-drive pixels
    with a ~54 frame count.
    Built on the ISE VM and flashed: all constraints met, 0 timing errors,
    no XST warnings on the changed logic. Firmware is unchanged since
    4f7829d, which is already on the board, so this was gateware-only.
    Needs a replug before it takes effect -- the FPGA loads its bitstream
    from SPIFFS at boot.
    Claude-Session: https://claude.ai/code/session_01PSvYugNMUuExsy2u7sQ2yD
2026-08-03 caster: mono drive 9/9 -> 12/14, swept against real text
    Determined on hardware with 'caster frames', comparing 12/16/20/24 with a
    full clear between each so the samples were independent. 9 frames
    (~120 ms at 75 Hz) leaves body text grey and the background visibly
    off-white, because in auto-LUT a pixel whose target is pure black or
    white gets that one unipolar drive and then never runs the waveform LUT
    again. 12 was where the background went clean without the page turn
    feeling sluggish.
    w2b is two frames longer than b2w to attack a specific artifact: inside
    large solid black areas, pixels that arrive at black from different
    histories settle at slightly different shades, showing the previous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
2026-08-03 gitmodules: point Caster at our fork so a recursive clone works
    This branch references Caster commits that exist nowhere upstream --
    c65d5c5 (hold bit, panel-idle status, tunable mono drive), 5385304 (the
    upstream merge that moved CSR_FEATURES off the address upstream took for
    CSR_INPUT_DEBUG) and 373c7b5 (frame-count underflow fix). With the URL
    pointing at gitlab.com/zephray/Caster, `git clone --recursive` cannot
    resolve any of them and the submodule comes up empty.
    Now pushed to github.com/UavL/Caster and .gitmodules follows. The comment
    records how to add upstream back as a second remote for future merges,
    since that is the only thing this costs.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
2026-08-05 R2: KiCad 10 project skeleton and the battery sheet spec
    New board project at pcb/r2-mainboard/ -- 13 hierarchical sheets, KiCad 10
    native format (20260306), ERC clean at 0 violations. pcb/mainboard/ (R1,
    KiCad 8) is untouched and stays the read-only reference.
    Work is ordered so the sheets that do not depend on PHYTEC's answer come
    first; som.kicad_sch and the DSC landing footprint are held until last.
    docs/battery.md specs WP1. Reading the TI datasheets changed the charger
    choice: BQ25890/92/95/96 share one RTW WQFN-24 footprint and register map,
    differing only on pins 2, 3 and 24. BQ25896 has 127 units at LCSC; BQ25892
    has 832 and is the same PSEL/PG variant, which is the one we want si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
    [battery.kicad_sch, dpi_in.kicad_sch, epd.kicad_sch, epd_power.kicad_sch, fpga_config.kicad_sch, fpga_ddr.kicad_sch, fpga_io.kicad_sch, frontlight.kicad_sch]
2026-08-05 R2: capture battery.kicad_sch -- charger, power path, gauge, USB-C
    First real sheet of the R2 schematic. ERC reports 16 violations, all of them
    'the rest of the board does not exist yet' (12 unconnected sheet pins on the
    parent, 4 on CHG_QON# which the MCU and power button drive). No electrical or
    structural errors. Netlist exported and read back node by node.
    tools/schgen.py is a small KiCad schematic writer built on the kicad-happy
    sexp parser: it loads symbol geometry from .kicad_sym, computes absolute pin
    coordinates through the placement transform, and emits KiCad 9 format that
    'kicad-cli sch upgrade' normalises to KiCad 10. Used once per sheet -- after
    a sheet is opened in Eeschema th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
    [battery.kicad_sch, r2.kicad_sch]
2026-08-05 gitignore: keep the AM62x TRM PDFs and analysis scratch out of the repo
    The TI AM62x Technical Reference Manual is 129 MB (24 MB for the
    no-registers edition) -- too large to version, and freely available
    from TI at https://www.ti.com/lit/pdf/spruiv7. analysis/ is scratch
    output from the schematic-analysis tooling, regenerated per run.
2026-08-05 R2: KiCad 10 rewrote r2.kicad_pro with its full default schema
    Opening the project in KiCad 10 expands the settings tree with keys
    that were previously implicit -- zone fill defaults, two new DRC
    severities, tuning_profiles, top_level_sheets. No design value changes.
2026-08-05 R2: capture power.kicad_sch -- the gated rail tree from +VSYS
    WP2. Five converters, every one of them switchable, which is the whole
    reason R2 exists: R1 wires four bucks' ~SHDN to +5V and 82% of idle
    power sits on rails no firmware can reach.
    +3V3_AON TPS7A0233 LDO, always on, 25 nA
    +5V_DCDC TPS61022 boost, behind a TPS22965 load switch
    +3V3_DCDC TPS63802 buck-boost
    +1V2_DCDC TPS62A02 buck
    +1V35_DCDC TPS62A02 buck
    Two findings changed the plan and are recorded in NOTES-R2-plan.md:
    - A 1S cell cannot buck to 3.3 V. +VSYS runs 4.4 V down to 3.0 V, so a
    step-down converter drops out halfway down the discharge curve. +3V3
    is a buck-boost, and the two 3.3 V r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
    [power.kicad_sch, r2.kicad_sch]
2026-08-07 R2: capture mcu.kicad_sch -- STM32G0 housekeeping and the pin assignment
    WP3. The sheet is small; the deliverable is the pin assignment, which is
    one-shot because STM32 peripheral functions are fixed to particular pins.
    Every choice is checked against datasheets/stm32g0b1.pdf (DS13560 Rev 1)
    Table 12 column "LQFP64 - GP" and Tables 13-20.
    STM32G0B1RCT6, LQFP-64, C3034735 (6029 in stock, $1.67). Chosen for its two
    12-bit DACs -- R1 drives VCOM and VGH from DAC_CHANNEL_1/2, and most of the
    G0 line has no DAC -- and for 60 I/O against a signal count of 49. Stop 1
    with the RTC running is 3.7 uA typ, so the always-on domain costs ~14 uW.
    Two decisions worth the reading:
    - The SoM, not the MCU,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
    [mcu.kicad_sch, r2.kicad_sch]
2026-08-07 R2: port epd, epd_power and power_mon from R1
    WP4. These three sheets are copied from pcb/mainboard/ rather than redrawn,
    because the acceptance criterion is "is it the same as R1" -- copying keeps
    every part, value, coordinate and wire, so the two can be diffed directly.
    tools/port_r1.py does it and only ever reads R1.
    Result: epd and epd_power are provably identical to R1. R1's netlist was
    exported from a scratch copy and the partition of each sheet's pins into nets
    compared with R2's, undoing the designator renames first: 49/49 and 44/44 net
    groups, identical. power_mon differs in exactly four groups, all intended.
    103 of 128 parts keep their exact R1 designator; only collisions are ren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
    [epd.kicad_sch, epd_power.kicad_sch, mcu.kicad_sch, power_mon.kicad_sch, r2.kicad_sch]
2026-08-10 R2: battery sheet review pass 1, plus notes and parts scratch
    Rework battery.kicad_sch and its spec after the first review round, and
    carry the follow-on touch-ups into the other R2 sheets. Adds the
    Analyse_battery.md review write-up, the patch_battery_review1.py script
    that applied it, and a parts/ scratch list.
    [battery.kicad_sch, epd.kicad_sch, epd_power.kicad_sch, mcu.kicad_sch, r2.kicad_sch]
2026-08-12 R2: power sheet review pass 1 -- the TPS22965 load switch is deleted
    power.kicad_sch was reviewed against manual-analysis/Analysis_power.md and
    patched in place by tools/patch_power_review1.py. Once Eeschema has saved a
    sheet it is the source of truth, so gen_power.py was not re-run.
    The substantive finding: the TPS61022 boost already has true input/output
    disconnect in shutdown -- datasheet Features (p.1), §7.3.2, and IVOUT_LKG in
    §6.5, which is measured with VOUT forced to 5.5 V while VIN sits at 0 V.
    docs/power.md §2.2 had misread §7.3.5, which describes pass-through while the
    part is *enabled*. U11 (TPS22965) and its C23/C24 are therefore deleted, and
    MCU_EN_5V drives U12.EN directl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
    [battery.kicad_sch, power.kicad_sch]
2026-08-12 R2: mcu sheet review pass 1, plus an R1 comparison
    mcu.kicad_sch was reviewed against manual-analysis/Analysis_mcu.md and patched in
    place by tools/patch_mcu_review1.py; gen_mcu.py was not re-run.
    C42 is deleted. stm32g0b1.pdf Figure 15 (p.65) is the whole of ST's decoupling
    scheme and it shows no capacitor on VBAT. With no coin cell fitted, pin 6 (VBAT)
    is strapped to the same +3V3_AON net as pin 8 (VDD/VDDA) two pitches away, and
    that net already carries C40 4.7 uF + C41 100 nF -- the figure's specified pair.
    C42 was a third capacitor on an already-decoupled net.
    SW21/SW22, the page buttons, move from TS-1187A-B-A-B to Panasonic EVQPLHA15:
    same 1.6 N force and 1.5 mm travel, so the feel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
    [mcu.kicad_sch, power.kicad_sch]
2026-08-12 R2: WP4 review pass 1 -- the panel adapter question, answered
    manual-analysis/Analysis_epd_files.md accepts epd/epd_power/power_mon as a 1:1
    port of R1 and asks one question: why the display is not connected directly to
    the mainboard on the Modos dev kit, and whether R2 should do it differently.
    Answered in docs/epd-port.md section 9, and it is not a dev-kit compromise.
    README.md's "Screen Adapters" states the reason outright -- different screen
    panels have different connectors, and it would take a huge amount of space to put
    every one of them on the motherboard -- and pcb/ holds ten adapter projects that
    bear it out. The mainboard exposes a 50-pin + 16-pin bus and each adapter maps one
    pan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
2026-08-12 R2: WP5 groundwork -- Xilinx/Micron datasheets, LX16 fix, DDR bank to 1.5 V
    Steps 1-3 of the WP5 plan. No FPGA sheet is drawn yet; this is the evidence base
    and the one power change that had to land before fpga_ddr can be.
    DATASHEETS
    AMD's documentation portal no longer serves PDFs at any of the old xilinx.com
    paths -- every URL returns the same 2.5 KB JavaScript shell -- so these came from
    the Wayback Machine: ds162 (DC & Switching), ug380 (Configuration), ug381
    (SelectIO), ug393 (PCB Design). The hardware owner supplied mt41k64m16 from
    DigiKey after micron.com proved unreachable. UG385 Packaging was deliberately
    skipped at 15.8 MB, since pcb_common's XC6SLX-FTG256 symbol already encodes b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
    [mcu.kicad_sch, power.kicad_sch, power_mon.kicad_sch, r2.kicad_sch]
2026-08-12 R2: WP5 -- fpga_io ported, verified pin-for-pin against R1
    Banks 0 and 1 of the XC6SLX16: the EPD panel bus out, DPI in. Ported from R1 by
    an extended tools/port_r1.py rather than redrawn, so the pinout the gateware
    depends on cannot drift -- Caster's constraint.ucf fixes almost all of it and
    ISE 14.7 is the only toolchain that still targets Spartan-6.
    RESULT
    69 signal nets identical to R1, zero mismatches: every EPDC_*, DPI_*, LED,
    EPD_THROT and VCCO ball lands on exactly the pin R1 used. All 33 EPDC_*
    hierarchical labels on epd.kicad_sch have exactly one source here, no more and
    no fewer. ERC on /fpga_io/ is 4, all of them "units C/D/E/F of U41 are not
    placed yet" (missing_unit, missing_p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
    [fpga_io.kicad_sch, r2.kicad_sch]
2026-08-12 R2: WP5 -- fpga_config ported (bank 2, config pins, clock, JTAG)
    Units 3 and 5 of the XC6SLX16: bank 2's I/O, the dedicated configuration pins,
    the 33.33 MHz oscillator and the JTAG group. Ported by tools/port_r1.py; the new
    content this sheet needs (config NOR, the M1 strap change, the debug header, an
    INIT_B pull-up) is NOT here yet and comes next.
    A STALE RAIL, CAUGHT BY THE NETLIST DIFF
    R1 spreads the FPGA's decoupling across sheets, so five of the DDR bank's VCCO
    capacitors are drawn on fpga_config rather than fpga_ddr. They ported across as
    `+1V35` -- the name retired in 8b69e01 when the bank moved to 1.5 V. ERC was
    silent about it; the netlist diff showed a new 5-node +1V35 net appea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
    [fpga_config.kicad_sch, r2.kicad_sch]
2026-08-12 R2: WP5 -- tools/check_ucf.py, and it immediately found EPD_THROT
    The plan called this the strongest check available for WP5, and this session made
    the case twice before it existed: ERC missed fpga_io's cross-sheet short (seven
    FPGA balls silently on VCOM_MEA_EN and friends) and missed fpga_config's stale
    +1V35 rail. Both were caught by hand-rolled netlist comparisons. This makes that
    comparison a repeatable pass/fail against the gateware's own constraints.
    WHAT IT ASSERTS
    1. Every ball with a LOC in Caster's constraint.ucf carries exactly the net the
    gateware expects. The translation is mostly derived rather than hardcoded:
    the UCF's own trailing comments name the board signal (`LOC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
    [check_ucf.py]
2026-08-12 R2: WP5 -- fpga_config gains the config NOR, master-SPI strap and INIT_B pull-up
    The new content the port could not carry. tools/patch_fpga_config_nor.py builds it
    with schgen and splices it into the ported sheet, so the port stays reproducible
    and this stays separately reviewable.
    THE MODE STRAP IS ONE WIRE
    UG380 Table 2-1: Master Serial/SPI is M[1:0] = 01 with CCLK an output; Slave
    Serial, which R1 uses, is 11. R1 straps both mode pins high, so only M1 moves --
    #PWR0261 on ball N11 (IO_L13P_M1_2) goes from +3V3 to GND. UG380 also requires
    the mode pins be tied directly to ground or VCCO_2 rather than through resistors,
    so this is a wire and not a pull-down. Verified in the netlist: N11 ->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
    [fpga_config.kicad_sch, r2.kicad_sch]
2026-08-12 R2: WP5 -- one debug footprint for SWD+JTAG, and INIT_B reaches the MCU
    Both changes to mcu.kicad_sch, decided by the hardware owner 2026-08-12.
    J20 BECOMES A 2x6 CARRYING BOTH TARGETS
    R1 fits J5, a 2x6 1.27 mm socket carrying FPGA JTAG *and* MCU SWD, populated. R2
    had only J20, a 1x5 2.54 mm SWD footprint. The combined footprint lands here
    rather than on fpga_config because fpga_config already exports FPGA_TCK/TDI/TDO/
    TMS as sheet pins from the port -- four labels added to one sheet, instead of
    three local nets reclassified on another.
    Pinout is R1's J5 order with its pin-10 ground given to MCU_NRST, which R1's
    header does not carry:
    1 FPGA_TCK 2 GND 7 FPGA_TMS 8 GND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
    [mcu.kicad_sch, r2.kicad_sch]
2026-08-13 R2: WP5 -- fpga_ddr ported, and the FPGA's core rails get a home
    fpga_ddr is the last of the three FPGA sheets. The port itself is mechanical:
    all 49 local DDR nets come across node-for-node identical to R1 (only U1->U41,
    U12->U52, R40->R340, R44->R344 rename), and the five +1V35 power symbols move
    to +1V5 with the rest of the bank.
    Unit 6 of the FPGA symbol -- 42 pins, 26 GND + 8 VCCAUX + 8 VCCINT -- had no
    home in R2 at all. R1 draws it on power.kicad_sch; R2's power sheet is reviewed
    and has no FPGA on it. Left as it was, ERC reported missing_unit forever and
    eight VCCINT balls would have gone unconnected on the board. It lands here, on
    A3, with its 12 decoupling capacitors relocated fro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
    [fpga_ddr.kicad_sch]
2026-08-13 R2: WP5 -- the root sheet actually connects the sheets now
    Every child sheet has had a hierarchical interface since the work package that
    drew it, and set_sheet_pins has been putting matching pins on the root's sheet
    symbols all along -- but nothing on the root ever joined one sheet's pin to
    another's. epd's EPDC_D0P and fpga_io's EPDC_D0P were two separate one-node
    nets, printed by the netlist exporter as /epd/EPDC_D0P and /fpga_io/EPDC_D0P.
    232 isolated_pin_label violations were all saying the same thing, and the
    schematic would have gone to layout with no panel bus, no EPD power control and
    no MCU-to-FPGA signals whatsoever.
    tools/wire_root.py stubs each of the 187 sheet pins and attache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
    [fpga_config.kicad_sch, r2.kicad_sch]
2026-08-13 R2: WP5 -- NOR IO2/IO3 reach the FPGA, so x4 boot stays a software change
    Owner's decision, 2026-08-13, after the numbers came out of UG380 and DS162.
    The config NOR exists to cut resume latency: R1 reloads the bitstream from the
    MCU's SPIFFS on every wake and measures 360-400 ms, and +1V2_FPGA is off in
    standby so that happens every time. Self-boot only pays if it is faster, and
    how much faster is set by the configuration clock rate and the SPI bus width.
    bitstream 3,731,264 bits UG380 Table 5-5, XC6SLX16
    max master CCLK 40 MHz DS162 FMCCK, -3 speed grade
    master CCLK tolerance +-50% DS162 FMCCKTOL
    x1 @ ConfigRate 2 (today)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
    [fpga_config.kicad_sch]
2026-08-13 R2: WP5 -- docs/fpga.md, and UG388 answers three open questions
    One spec for all three FPGA sheets, in the shape of epd-port.md: what the
    gateware requires, what each sheet holds, what changed from R1 and why,
    verification, layout guidelines for Stage D, and what is owed back to Caster.
    UG388 (Spartan-6 Memory Controller UG) arrived last and turned three things I
    had inferred into things with a source, all three of which R1 already does:
    - p.43: "The active-Low Chip Select (CS#) pin of the target memory device
    should be connected to ground on the board. Because the MCB only supports
    connections to a single memory component, it does not provide a signal to
    control the CS# inpu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
2026-08-13 R2: WP5 -- docs/fpga.md corrections
    Three fixes to my own text, none affecting the schematic:
    - I attributed the "R1 fits a 4 Gb DRAM" error to NOTES-R2-plan.md. It was
    in the WP5 work-package plan; NOTES-R2-hardware-facts.md had the part right
    all along (MT41K64M16TW-107, LCSC C2060943).
    - Open item 6 asked for an LCSC line for the DRAM. It already has one, as does
    the NOR. The FPGA is the only unpriced part on these sheets.
    - Replaced that item with one worth keeping: ExtMasterCclk_en. UG380 p.54 lets
    USERCCLK (ball T8, freed by the LVDS deletion) supply the configuration
    clock, which would take the +-50% FMCCKTOL spread out of the boot-time
    numbers. Not need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
2026-08-13 R2: the SoM becomes the connectorised PCM-071, not the soldered PCL-071
    Hardware owner's decision, 2026-08-13, and it revises constraint 1 of the plan
    ("nothing plugged on afterwards"). Recorded with the reasoning because that
    constraint drove several other choices:
    - PHYTEC (Emma Tholey) quoted PCL-071-001-R at EUR 281 / 272 / 265 at
    1-9 / 10-99 / 100-199, noting that "the current memory chip shortage has
    already been factored in, adding around EUR 190 extra per module."
    - The solder-down part is reel-only, in reels of 5/20/100/250. Minimum spend
    is ~EUR 1405 for five modules, for a prototype that needs one.
    - A soldered module would have to be bought here and consigned t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
2026-08-14 R2: PHYTEC measured the two numbers the architecture rested on
    NOTES-R2-hardware-facts.md §4.4 said, of two missing figures, that "these two
    gaps are the entire remaining risk in the architecture". PHYTEC ran the test
    (report by cbrown 2026-08-12, sent by Khalid Talash 2026-08-14). Both close, and
    the report is for PCM-071 -- the exact variant chosen the day before.
    Idle in Linux, no low-power mode 297.1 mA 1485.7 mW
    Suspend-to-RAM 25.7 mA 128.6 mW -91.3%
    MCU-Only N/A N/A
    128.6/25.7 = 5.004 V, so these are at the module's VIN (L-1038e Table 12: 5.0 V
    on A1/A2/A3). Wake ~150 ms per the covering mail; the kernel log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
    [wire_root.py]
2026-08-14 R2: WP7 -- the BOOTMODE overlap is 2 signals, and it constrains rail order
    First job of WP7+WP8 was never the wiring; it was this. Answered from the AM62x
    TRM (SPRUIV7C), fetched to /tmp -- it is gitignored at 135 MB / 16613 pages.
    Figure 12-471: in 18-bit RGB the video port drives **DATA[17:0] only**, packed
    data[17:12]=red, data[11:6]=green, data[5:0]=blue. Figure 12-472 shows 24-bit
    using DATA[23:0] -- which is the case the old "BOOTMODE conflict avoided
    entirely by 18-bit mode" claim was really about.
    Cross-referenced with L-1038e.A5 Table 31, the overlap is exactly two of the
    eighteen signals, not six and not zero:
    DPI_R7 = data[17] = VOUT0_DATA17 = X1 D4 = BOOTMODE_9 (100K pull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
2026-08-15 R2: WP5 review answer 2 -- J3 is deleted, and with it ten dead nets
    Owner's decision, manual-analysis/Analysis_fpga.md: "Yes, delete J3 connector."
    J3 was the 16-pin panel connector. It carried nothing but EPDC_D8-D11 (eight
    nets), EPDC_CLKP/CLKN and six grounds, and check_ucf.py had already shown that
    no LOC line in Caster's constraint.ucf assigns any of the ten -- EPD_SD is 16
    bits in every build variant and the UCF maps those 16 to panel pairs D0-D7, and
    there is no EPD_CLK port in top.v at all. So this is not an unpopulated option;
    nothing in the gateware could drive it.
    Why it existed upstream, which the owner also asked: Glider is a general-purpose
    EPD monitor. README "Screen Adapter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
    [epd.kicad_sch, fpga_io.kicad_sch, r2.kicad_sch]
2026-08-15 R2: WP5 review answered -- four accepted as drawn, one change, one question dissolved
    docs/fpga.md gains §15, the review answers, in the shape epd-port.md §9 uses.
    15.1 bank 3 at 1.5 V -- accepted, no change.
    15.2 J3 -- deleted; the reasoning, and why the connector existed upstream.
    15.3 DRAM_ADDR13/14 -- kept, with the one real cost named: they look like
    address lines to a net-class length-match rule and must be excluded from
    it. Written into §11.1 as a layout guideline rather than left in prose.
    15.4 C509 -- accepted; restates what was deliberately NOT changed with it.
    15.5 the FPD-Link deletion -- the owner asked what the decision actually was,
    and on checking there is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
2026-08-15 R2: a bigger colour tablet does not need J3 -- the ceiling is pixel rate
    Owner's follow-up to the J3 deletion: could a later, bigger 8"+ and maybe
    colour tablet still be built? Yes, and the connector was the least of it.
    README's panel table is 126 TTL / 11 MiniLVDS, and the MiniLVDS set is short
    enough to enumerate: 8.0" AC080KH1/KH2 and 11.8" AC118TC1, all Gallery 3, plus
    the 25.3"/28" signage panels. So of tablet-sized panels the only things behind
    J3 are 8" and 11.8" Gallery 3. Bigger-and-colour on J6 alone covers 7.8", 10.3"
    and 13.3" in Kaleido 3, Gallery 4000 and Spectra 3000.
    The split is physical. Kaleido is a colour filter array and README states the
    consequence -- "the low-level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
2026-08-15 R2: WP7/WP8 -- parse the PCM-071's 240 pins out of the manual, checked
    tools/parse_som_pinout.py extracts Tables 7-10 of L-1038e.A5 ("Connector X1,
    Column A/B/C/D Pinout") into datasheets/som_pinout.json: for all 240 pins, the
    SOM signal name, type, voltage level, AM62x ball and description.
    Parsed rather than typed because 240 pins is where hand transcription produces
    two or three silent errors, and a wrong pin on a SoM connector is a dead board
    with no ERC warning -- the same failure class check_ucf.py exists to catch on
    the FPGA side. The extraction is checked, not trusted: exactly 60 rows per
    column numbered 1..60, every processor ball well-formed, and no ball claimed by
    two pins. Resul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
    [parse_som_pinout.py]
2026-08-15 R2: correct the SoM rail order -- my earlier version was backwards and unsafe
    power.md §5.1, added 2026-08-14, concluded "MCU_EN_3V3 and PG_3V3 before
    MCU_EN_5V". That is the wrong way round, and it violates a rule L-1038e.A5
    §5.4 states as mandatory:
    "It is mandatory to avoid driving the I/O pins of the phyCORE-AM62x SOM when
    the SOM is not fully powered up. Prematurely driving the pins may cause
    current to flow through the I/O pins before the processor is properly
    powered, potentially resulting in damage or unknown behavior after power-up
    or reset. Therefore, the peripheral carrier board power should be switched
    on/enabled by the X_PGOOD signal ... This should be used t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
2026-08-15 R2: +5V budget checked and holds; microSD specified; boot device settled
    Three things the owner asked for, in one pass over L-1038e.A5.
    POWER BUDGET (power.md 8.1). 3.2 sized L10 against IOUT = 1.5 A (est.) and
    left a trigger: "if the SoM's VIN current comes back from PHYTEC materially
    above 1.5 A, re-run this block". It has come back and it is 1.0 A -- below the
    estimate. Three independent statements agree: 5.1 "must be supplied with a
    minimum 1A capacity" and "in testing the current draw of the SOM did not exceed
    1A", and Table 12 "Draw 5W (1A)". Table 4 measures 651 mA under a load heavier
    than Glider can produce (memtester + iperf3 over ETH0 + four yes, with two
    Ethernet cables, two USB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
2026-08-15 R2: the 240-pin PCM-071 symbol, generated from the manual
    tools/gen_som_symbol.py builds it into r2.kicad_sym from
    datasheets/som_pinout.json -- no pin typed by hand. Four units, split by
    function rather than by the manual's four columns, because the DPI group spans
    columns A, B AND D and a column-shaped symbol could not put video on dpi_in and
    the rest on som:
    unit 1 POWER 50 VIN x3, VBAT, SoC_VDDSHV5_SDIO, 45 x GND som
    unit 2 VIDEO 22 VOUT0_* plus D2/D4 dpi_in
    unit 3 CTRL 49 SPI0, UART0, MMC1, USB0, I2C, reset/status, som
    plus the MCU_*/WKUP_* always-on groups
    unit 4 NC 119 everything R2 does not use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
    [gen_som_symbol.py, parse_som_pinout.py]
2026-08-15 R2: WP7 -- dpi_in drawn, and a silent short caught before it reached fab
    tools/gen_dpi_in.py draws dpi_in.kicad_sch: unit 2 of the PCM-071, 22 pins
    fanning into the 22 hierarchical labels fpga_io has exported since WP5. No
    components at all, which is also how the "nothing may load DPI_R6/DPI_R7" rule
    is satisfied -- a sheet note says so, so a later reviewer does not add the
    "missing" termination.
    The bit mapping is the whole content of the sheet and the only thing that can
    be wrong in a way that still boots: VOUT0_DATA<n> = DPI_PIXEL[n], channel =
    BGR[n/6], bit = 2 + n%6, where the 2 is RGB666 keeping the top six bits of each
    channel. Verified three ways -- the generator asserts the 22 net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
    [dpi_in.kicad_sch, r2.kicad_sch]
2026-08-15 R2: WP8 -- som drawn; the hierarchy has no dangling interfaces left
    tools/gen_som.py draws som.kicad_sch: PCM-071 units 1, 3 and 4 (unit 2, the DPI
    link, is on dpi_in), the microSD on MMC1, and the last 12 interface nets.
    patch_mcu_pg_som.py claims PC8 for PG_SOM at the MCU end. Root state: 100 names,
    100 joined, 0 one-sided -- wire_root.py's DANGLING_OK is now empty, so anything
    one-sided from here is a genuinely forgotten interface rather than pending work.
    TWO PINS CHOSEN THAT docs/som.md HAD LEFT OPEN. PHYTEC's manual never uses the
    word "wake" -- it is not in the document -- so the answer came from TI's AM62x
    datasheet (SPRSP58C) instead. Cross-referencing every X1 pin's AM62x ball
    aga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
    [mcu.kicad_sch, r2.kicad_sch, som.kicad_sch]
2026-08-15 R2: Stage D preparation -- audit, the missing EPD guidelines, a layout plan
    Starting the PCB work. Placement itself is blocked (below), but three things
    that must precede it were not done, and now are.
    FOOTPRINT AUDIT. 312 placed parts, every one with a footprint assigned, and
    only two that did not resolve. The project's own fp-lib-table is healthy and
    points at pcb_common/footprints.pretty (204) and r2.pretty; the broken tables
    are the global ones, which are the owner's and do not affect this project. That
    is a better starting position than "library tables are broken" suggested.
    EPD LAYOUT GUIDELINES (epd-port.md 11). This was the one sheet group with none,
    and its own 7 said "the EPD sup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
2026-08-15 R2: WP6a -- frontlight drawn, and it closes a hole rather than adding a feature
    The netlist said it plainly before this sheet existed:
    +5V2_FL C147.1 J6.44 J6.7 <- three loads, no source
    +VSYS_FL R72.1 U22.1 <- a shunt into an ammeter, going nowhere
    R1 fed +5V2_FL from +5V_DCDC through shunt R72, so the panel saw about 4.99 V.
    WP2 moved the frontlight to the cell -- power_mon's U22 ch3 became
    +VSYS -> +VSYS_FL -- and left the converter to WP6. Until now the rail was
    orphaned at one end and the shunt dead-ended at the other. Verified against R1
    by exporting its netlist from a copy in /tmp; pcb/mainboard/ never touched.
    U53 is a second TPS61022, same topolog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
    [frontlight.kicad_sch, r2.kicad_sch]
2026-08-15 R2: WP6b -- io_expansion drawn; Stage C capture is complete
    Two FPC connectors, two gated rails, seven MCU pins, everything DNP.
    NOTES-R2-plan.md constraint 3 wants touch and pen "addable without a respin";
    this sheet is that provision, and it is honest about which half of the promise
    is certain:
    certain -- the seven MCU pins exist and are routed, and +3V3_TOUCH /
    +3V3_PEN exist. Those are what would otherwise force a
    whole-board respin.
    a guess -- the FPC pad order, because neither the touch controller nor the
    digitizer is chosen and the panel is not either.
    docs/io-expansion.md 5 puts that in front of the owner as the last open
    decision in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
    [dpi_in.kicad_sch, frontlight.kicad_sch, io_expansion.kicad_sch, mcu.kicad_sch, r2.kicad_sch, som.kicad_sch]
2026-08-16 R2: panel selection gets its own doc; 75 Hz was never a requirement
    The owner corrected constraint 2 -- 75 Hz had been read off the repo as a
    maximum and then treated as a spec. The real requirement is a fluid reader,
    "maybe even 40 Hz". That number was the binding constraint on panel size, and
    the only one, so the 10.3" GDEP103TC2-FT11 moves from rejected to viable:
    113 MP/s at 40 Hz clears the AM62x DPI link, Caster's error-diffusion dithering
    limit and DDR3 bandwidth, and its native SDCK 33.33 MHz / FR 84.99 Hz is
    clk_epdc exactly, so the panel side needs no gateware clock change.
    New docs/panel.md carries the analysis: the two rate budgets (input link and
    panel scan are separate clock d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
2026-08-17 R2: two TTL candidates worth asking for, and how to screen a listing
    panel.md gains §3.2 and an expanded §8. Tracing the model code on an E Ink
    shopkits listing back through README's panel table turned up that VD1400 is a
    model family with TTL members: ED070KC4 (7", 1680x1264, VD1400-GOC) and
    ES080KC2 (8", 1920x1440, VD1400-HOB), both 300 ppi Carta 1200, both exactly
    128-divisible, both inside every limit at 40 Hz. Neither is priced and neither
    is known to exist with a bonded frontlight and touch layer.
    §8 records three panels rejected on their product pages alone -- GDEY075T7-T01,
    E Ink VD1400-GOE, SeeKink B082A03 -- and §8.1 generalises what made them
    decidable without a datasheet. Th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
2026-08-17 R2: the panel is chosen, and both sheets it blocked are designed
    GDEP103TC2-FT11, 10.3", 1872x1404. The 6" GDE060F3-FT01 front-runner is EOL,
    which collapsed the two-panel plan into one panel -- and one frontlight driver,
    so the "two different voltage regulators" question answers itself.
    The frontlight hold lifts, and not because a document arrived. The datasheet had
    been in datasheets/e-ink_display/ throughout; the frontlight pinout is in the
    title block of the mechanical drawing on p.2, not in the numbered I/O section.
    It is LED1+/LED1-/NC/NC/LED2+/LED2-/NC/NC on an 8-pin FPC -- bare anodes and
    cathodes, so the board needs constant current, not the 4.99 V rail drawn.
    frontlight: LM3630A,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
2026-08-17 R2: LM3630A symbol and its DSBGA footprint, ahead of the frontlight capture
    The library work for docs/frontlight.md §4, so the sheet capture itself is
    purely a schgen run.
    The footprint is new because KiCad 10 has no match: Texas_DSBGA-12_..._P0.5mm
    has the right 3x4 grid at the wrong pitch, and Maxim_WLP-12_..._P0.4mm has the
    right pitch with A1..C4 pad names where the LM3630A needs A1..D3. The pitch is
    0.4 mm and that is legible only inside the drawing on lm3630a.pdf p.50 -- the
    text gives D and E but never the pitch, and inferring it from the body size
    gives 0.5 mm, which is wrong and not reworkable on a BGA. Rendered at 300 dpi
    and read. Exported to SVG and looked at: 4 rows x 3 column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
    [gen_yfq0012.py, patch_lm3630a_symbol.py]
2026-08-17 R2: WP6 -- frontlight captured; it is a current driver now, not a rail
    Implements docs/frontlight.md. The old sheet boosted +VSYS_FL to a 4.99 V rail
    and let the panel regulate its own LED current, which is what R1 did -- R1 drove
    an adapter board. GDEP103TC2-FT11's frontlight is bonded and its tail is
    LED1+/LED1-/LED2+/LED2-: bare anodes and cathodes. So U53's TPS61022, its
    feedback divider and the +5V2_FL net are gone, replaced by an LM3630A driving
    two independently dimmed strings from +VSYS_FL, plus J24 for the tail.
    Safe to regenerate rather than patch: the committed sheet's line multiset was
    identical to a fresh generator run, differing only in element order, so it had
    never been save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
    [frontlight.kicad_sch, r2.kicad_sch]
2026-08-17 R2: bring the docs in line with the captured frontlight and the chosen panel
    frontlight.md: status becomes CAPTURED; §4.2's parts table gains the real parts
    and LCSC codes -- FNR4030S100MT (C167879, Isat 2.4 A vs a 771 mA peak) and
    HC-FPC-05-09-8RLTAG (C5213749, whose footprint was already in pcb_common) --
    and C515 becomes 2.2 uF/50 V, because TI's 1 uF is 1 uF *effective* and a 0603
    loses most of that under 28.5 V of bias. §8 replaces "to be run" with what the
    netlist actually says. §9's claim that the DSBGA wants solder-mask-defined pads
    was wrong: TI specifies a copper land of 0.21-0.24 mm, so NSMD.
    io-expansion.md §5 was actively misleading -- it named the EOL 6" panel as the
    front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
2026-08-17 R2: cell attaches two ways -- Pico-Lock, or pads soldered straight to the board
    J2 becomes a Molex Pico-Lock 504050-0391: 1.5 mm pitch, 3 circuits, right-angle
    SMT, 3.5 A per contact against ~2 A of charge current, and 2.00 mm mated against
    the JST-PH's ~6.0. Right-angle on purpose -- the leads then exit parallel to the
    board instead of standing up, and thickness is what this device is short of once
    the cell's 7.0 mm and the SoM's 5 mm are counted. Pico-EZmate, which battery.md
    §10.9 had suggested, is rejected as too niche a family; Pico-Lock carries more
    current for 0.15 mm more height.
    J25 is new: three bare copper pads on the same three nets, for soldering the
    cell's leads directly. Not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
    [battery.kicad_sch]
2026-08-18 deleting unnecessary files from branch
    [2D.dwg, Back Plate1 Cut.dwg, Back Plate1.stl, Back Plate1.stp, Button1.stl, Button1.stp, Frame1.stl, Frame1.stp]
2026-08-18 R2: the SoM is priced, and one risk row had been stale for four days
    PHYTEC quoted PCM-071-5432DE11I at EUR 250.00 @ 1-9 pcs (order code
    C618992): AM6254 quad A53 + M4F, 2 GB DDR4, 32 GB eMMC, 64 MB QSPI NOR,
    4 kB EEPROM, Ethernet PHY, industrial temp.
    That closes the last YES row in "What is still open". It also settles the
    2026-08-13 switch from PCL-071 in the switch's favour on cost as well:
    EUR 31 below the solder-down unit price, and orderable singly against a
    reel-only minimum of five. One prototype's module cost goes from ~EUR
    1405 to EUR 250, and the phyBOARD kit workaround in som.md SS9.7 is
    retired.
    Not answered: MOQ and lead time. And PHYTEC's mail refers to a separate
    technical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
2026-08-18 R2: system overview, and the MCU has no way in from the factory
    Adds docs/system-overview.md: the block map, every inter-block link and
    what it carries, the rail tree with the enable owner for each rail, and
    the provisioning story. Written to answer four owner questions, and one
    of them turned into a finding.
    The finding (SS6.2). Of the four programmable devices on R2, three have a
    clean path in from a bare board: the SoM boots microSD and writes its own
    eMMC; the SoM writes the FPGA config NOR over SPI with PROG# low; the
    FPGA reloads itself from that NOR. The MCU has SWD and nothing else, on a
    header that is pads-only. So every board needs a probe and an open case
    to receive firmware -- w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
2026-08-18 R2: per-rail load lists, read off the netlist -- and one orphaned net
    Expands docs/system-overview.md SS3 with what actually hangs off every
    rail, taken from the exported netlist rather than from prose, plus SS3.2
    tracing the EPD high-voltage chain one level down (which converter makes
    which output, and off which switched branch).
    Three things that were true but not stated together anywhere:
    - +1V2_FPGA has exactly one load, the FPGA core. Cleanest rail on the
    board to gate.
    - The 5 V rail splits into six named branches before doing any work, and
    the EPD chain is gated twice -- EPD_PWR_EN through U6 for the chain,
    then EPD_POS_EN through U7/U8 for the source rails alone.
    - SW20, the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
2026-08-19 R2: MPNs into the schematic -- and five caps carry the wrong part number
    Sourcing data lived in docs/*.md, not in the schematic, so the BOM the
    fab would read had 3 of 96 lines with an MPN. Resolved every LCSC code
    already on the board against LCSC's own catalogue and wrote MPN +
    Manufacturer back: 53 -> 60 lines, 218 components. Added LCSC codes for
    L10-L13, U42 and J22/J23 from the per-sheet docs.
    Verified before writing: 321 refs and 519 nets identical before and
    after, no duplicated properties, pre-existing MPNs untouched.
    Cross-checking each passive value against the part its LCSC code
    actually names found five wrong ones, all of them the ADC sense-divider
    filter caps on power_mon: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
    [battery.kicad_sch, epd.kicad_sch, epd_power.kicad_sch, fpga_config.kicad_sch, fpga_ddr.kicad_sch, fpga_io.kicad_sch, frontlight.kicad_sch, io_expansion.kicad_sch]
2026-08-19 R2: WP6-8 review answers land; datasheets reorganised, three tools unbroken
    The datasheets for the SoM moved into datasheets/SoM Phycore AM62x/.
    parse_som_pinout.py, gen_som_symbol.py and gen_dpi_in.py all hardcoded
    datasheets/<name>, so the move silently broke them; they now resolve any
    datasheet-derived file at any depth under datasheets/ and keep the
    canonical path in the error message. parse_som_pinout.py re-runs clean
    and re-caches to the new location.
    The .kicad_sch churn is KiCad rewriting every sheet on save after the
    crash-and-abort-restoration. Verified not a design change: netlist
    exported before and after has the same 518 nets with identical pin
    membership, and the MPN propertie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
    [battery.kicad_sch, epd.kicad_sch, epd_power.kicad_sch, fpga_config.kicad_sch, fpga_ddr.kicad_sch, fpga_io.kicad_sch, frontlight.kicad_sch, io_expansion.kicad_sch]
2026-08-19 repo: stop line-diffing generated KiCad files and binaries
    The Board-Design branch diff against main is 2,053,615 lines, of which
    1.85 M are deleted STEP models and 145 k are .kicad_sch s-expressions.
    That swamps any review tool and is unreadable by a human too.
    Marking the generated and binary types -diff drops the same branch diff
    to 25,102 lines -- 30 files / 9.7 k lines of markdown, 34 files / 8.6 k
    of Python generators, and the firmware. That is the part a review should
    actually read.
    Cost: `git diff` now reports "Binary files differ" for schematics. That
    is the right default here -- schematic changes are verified by comparing
    netlist exports, not by reading s-expression lines. `git d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
2026-08-19 R2: triage the owner's WP6-8 notes -- and USB 3 is off the table
    ~50 questions across seven sheets, sorted into: already answered in the
    specs (6, with pointers), answered now (9), queued work (7), and owner
    decisions (8, four of them with a fabrication deadline).
    The answers worth having up front:
    - USB 3 is impossible on this module. The SoM's 240-pin table has only
    X_USB0_* and X_USB1_* as DP/DM/VBUS/DRVVBUS -- no SuperSpeed pairs, no
    PCIe, no SERDES. USB1 is entirely unused though: four pins, free now.
    - The buttons question has an asymmetric answer. SW21/SW22 sit on
    +3V3_AON behind pull-ups and need the MCU alive; SW20 goes straight to
    the charger's QON and works with everythi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
2026-08-19 R2: the panel listing and TCON manual answer the touch question
    The owner found the GDEP103TC2-FT11 vendor listing and the shipped
    DEJA-TC103 manual. Four results:
    - 2 x 9 LEDs in series is now confirmed, not inferred -- strike the
    hedge in frontlight.md §2. The 8-pin front-light connector is J24,
    which is why four of its pins are NC.
    - 1404 vs 1400 is not a discrepancy: panel.md pads down to 1872x1400
    because 1400 divides by 128 and 1404 does not. Four lines, 0.45 mm.
    - The 2x14 touch connector does NOT contradict J22's six pins. The
    TCON manual §4.4.2 says the touchscreen uses an external GT9110 touch
    board, which presents SDA/SCL/INT/RST. The 2x14 is between the ITO
    sensor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
2026-08-19 R2: the six approved edits, and one of them was already done
    Owner-approved 2026-08-19, KiCad closed for the pass.
    1. R225 22k -> 20.5K/1%, LCSC C57105 (0402WGF2052TCE, UNI-ROYAL, the
    family the rest of the board already uses). Rendered and checked:
    R224 390k over R225 20.5k with R213 100k injecting VGH_DAC, so
    20.5||100 = 17.01k and VGH = 1.2 x (1 + 390/17.01) = 28.71 V at
    DAC = 0 -- exactly epd-port.md 10.3's target.
    2. The five sense-divider caps that carried codes for the wrong
    capacitance -> C1523 (0402B102K500NT, 1 nF 50 V X7R, JLC Basic,
    5.3 M stock). One part covers both the 25 V and 50 V positions.
    2b. R88/R224 -> C54920667 (HRC0402F3903DNTO, 390k 1%, 20 k stock).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
    [battery.kicad_sch, dpi_in.kicad_sch, epd.kicad_sch, epd_power.kicad_sch, fpga_config.kicad_sch, fpga_ddr.kicad_sch, fpga_io.kicad_sch, frontlight.kicad_sch]
2026-08-19 R2: correct the touch finding -- the GT9110 board speaks USB by default
    The first read of EN-DEJA-TC103.pdf 4.4.2 took TOUCH_SDA/SCL/INT/RST as
    the GT9110 touch board's output. They are not: they are the ESP32 dev
    board's I2C interface. The same paragraph says the touch board "has a
    reserved USB communication interface", that using I2C "requires wiring
    modifications", and that the adapter between the two "can be designed
    independently and is not provided separately by our company".
    So J22's six signals are still the right choice, but an adapter has to
    be designed and it is not optional. The trade-off is now written out in
    io-expansion.md 4, and standby power decides it: +3V3_TOUCH can be
    sw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
2026-08-19 R2: pick the two SoM pins -- A59 and A60, and NRST needs a FET
    WP8 approved. mcu.md 5.8 proposes A59 X_MCU_MCAN1_TX -> SOM_MCU_NRST and
    A60 X_MCU_MCAN1_RX -> SOM_MCU_BOOT0, chosen against the module pin table
    and HW manual Table 6 rather than by placement:
    - Both sit in VDDSHV_CANUART, the same domain (jumper J14) as
    MCU_MCAN0_TX/RX which already carry SOM_IRQ#/SOM_WAKE# at A57/A58. No
    new module-jumper dependency, and A57-A60 becomes one contiguous block.
    - Not boot straps: all sixteen are X_GPMC0_AD0..15/BOOTMODE_0..15.
    - MCU domain, so reachable from the M4F and U-Boot -- a recovery path
    that needs Linux up is not a recovery path.
    - CAN is not a future worth protecting on an e-read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
2026-08-19 R2: the SoM can now reset the MCU and force its bootloader (WP8 closed)
    tools/patch_som_mcu_recovery.py applies mcu.md 5.8. On som, A59 and A60
    lose their no-connects and gain SOM_MCU_NRST / SOM_MCU_BOOT0. On mcu,
    three parts land on empty canvas at x>300:
    Q9 AO3400A Transistor_FET:Q_NMOS_GSD, SOT-23, C347475
    R510 100k gate pull-down
    R511 1k series into PA14
    NRST goes through the FET rather than straight to the pin, because the
    MCU gates the SoM's own supply -- "SoM off, MCU alive" is the normal
    standby state, and a direct tie would let an unpowered A59 clamp
    MCU_NRST toward a dead VDDSHV_CANUART and hold the MCU in reset for
    good. With Q9 the default is safe in every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
    [mcu.kicad_sch, r2.kicad_sch, som.kicad_sch]
2026-08-19 R2: PG_SOM would have hung bring-up; plus the X1 refdes collision
    From the review round of 2026-08-19. Verified each finding against the
    datasheets and the schematic's own netlist before acting.
    The one that matters -- PG_SOM. patch_mcu_pg_som.py told firmware to
    enable PC8's internal pull-down so "no SoM" would read "not good".
    X_PGOOD is open-drain with a 100k pull-up on the module (L-1038e.A5
    Table 13, 5.4); the G0's internal pull-down is 25/40/55k (stm32g0b1.pdf
    Table 55). Together: 3.3 x 40/140 = 0.94 V against V_IH 2.31 V, so PC8
    reads low while the module asserts good, power.md 5.1 step 3 never
    returns and MCU_EN_3V3 is never asserted. Not fixable in firmware -- the
    pull-down strengt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
    [mcu.kicad_sch]
2026-08-20 R2: two interrupts that could never fire, and the SoM footprint
    The EXTI collisions mcu.md §3.4 found are applied. An EXTI line is picked
    by the pin's *number*, so TOUCH_INT# on PC3 was fighting PD3 GAUGE_ALRT#
    and PEN_INT# on PC6 was fighting PD6 QON_SNS -- as drawn neither touch nor
    pen could raise an interrupt at all. Each swaps with an output, which needs
    no line, so it costs nothing. FL_INT# gets PB12 at the same time, which was
    frontlight.md §10.3's own first suggestion; §9's later push for PB7 was
    wrong, because PC7 KEY_PREV# holds EXTI7.
    518 -> 517 nets, the drop being the PB12 unconnected- pseudo-net, and
    exactly five membership changes. Every hierarchical label in the project
    n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
    [dpi_in.kicad_sch, fpga_config.kicad_sch, fpga_io.kicad_sch, mcu.kicad_sch, r2.kicad_sch, som.kicad_sch]
2026-08-20 R2: the USB1 second-port analysis, and the memory of the layout sketch
    Recommendation is yes. The pins expire at fabrication and the parts are
    mostly BOM lines the board already carries -- the receptacle and the ESD
    array are J1's and U3's. One new line, a current-limited VBUS switch, and
    about $0.60.
    The trap to record is Rp vs Rd: J1 has 5.1 k Rd because it is a sink; a
    source presents 56 k Rp to VBUS. And the number to watch is L10's Isat, not
    the boost -- a 500 mA port takes power.md 8.1's worst case from 1.3 A to
    1.8 A and the inductor peak margin from 55 % to about 20 %.
    The J1-as-dual-role alternative was checked and needs more parts than USB1,
    not fewer, and makes hosting and charg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
2026-08-20 R2: rebuild the SoM footprint on PHYTEC's DXF, and a BOM line nobody had
    The 3D archive came with PCM-071_1573-1.dxf, which is vector and numeric
    where L-1038e.A5 Figure 7 is a raster picture, and which PHYTEC's own
    README names authoritative alongside the datasheets. It gives the four
    60-pad columns, the pitch, the module outline and both M2.5 positions
    directly.
    It agreed with the picture-derived footprint to 8 um in x and 61 um in y.
    61 um is 20 % of a 0.305 mm pad's width, so it is corrected: the pads now
    sit exactly where the DXF puts them and the generator asserts it. The row
    skew is 0.0 um -- the DXF's connector centrelines are 4.800 and 27.200,
    symmetric about the module's midline,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
    [PCM-071_1573-1.dxf, epd.kicad_sch, mcu.kicad_sch, power_mon.kicad_sch, r2.kicad_sch, som.kicad_sch]
2026-08-20 R2: why there is no connector symbol, and the BOM line that was missing
    The question was a good one and the answer is that the schematic models the
    thing you reason about -- the SoM and its 240 signals -- while the footprint
    models the thing you solder, two connectors at a fixed offset. That split is
    deliberate (gen_som_symbol.py argued it) and PHYTEC's DXF has since made the
    cost of the alternative concrete: the two connectors are staggered 4.800 mm
    as well as spaced 22.400 mm, which is exactly the relationship a person
    nudges by accident. As one footprint it cannot be got wrong.
    The second reason is worse for the alternative. Samtec numbers its pads
    1-120 alternating between rows; the mod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
    [BTH-060-01-L-D-A-K-TR.stp, som.kicad_sch]
2026-08-20 R2: make the board arrive with the connectors already soldered
    The question "why are they not on the board?" found a real hole, and my
    previous commit had only half-fixed it. Making J26/J27 purchase-only put
    the parts on the order and left the board unassemblable, because a part
    that is not on the board is not in the position file either.
    A CPL has one row per reference. X2 alone produces a single placement at a
    single centroid, for a footprint that two separate parts occupy 22.4 mm
    apart and 4.8 mm staggered -- there is no part covering all 240 pads. And
    JLCPCB rejects a CPL designator with no BOM line, which X2 is. A board
    ordered that way comes back with 240 bare pads.
    So the two jobs a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
    [som.kicad_sch]
2026-08-20 R2: fix a sign error in the connector placement check, and record the plan
    The check I committed had the Y offsets mirrored. X2's footprint maps module
    (mx,my) to local (mx-16, 21.5-my) because KiCad's PCB Y axis points down, so
    the offsets are J26 (-11.200, -2.400) and J27 (+11.200, +2.400), not what
    was written. A board built to the old numbers would have had both connectors
    4.8 mm out -- and the check would have blessed it.
    Re-tested against synthetic boards: the corrected version passes a correct
    board and rejects the mirrored one by exactly 4.800 mm, which is twice the
    2.400 stagger and the signature of a Y flip.
    Also records the owner's decision to restructure into two 120-pin connec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
    [check_pcb_connectors.py]
2026-08-20 R2: the SoM is now two connectors, which is what the board has
    The owner's call, and the right one: "I would rather have the two BTH
    connectors and connect all signals/lines etc. to those two instead of the
    A,B,... split. Then routing it later would also make more sense for me."
    Clever loses to clear -- and the clever version could not be assembled
    anyway, because a position file has one row per reference and there is no
    single part covering 240 pads.
    J26 carries the module's A and B columns, J27 its C and D, 120 pins each.
    X2 survives as the module: outline and the two M2.5 holes, no pads, no
    nets, excluded from the position file because it is fitted by hand. Three
    footprints replace the o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
    [dpi_in.kicad_sch, r2.kicad_sch, som.kicad_sch]
2026-08-20 R2: make the connector's pin-1 marking legible, and write down the CPL rotation check
    The Value text sat exactly on the 'B1 A1' silk text -- the one marking that
    matters when someone is checking which way round the part goes. Reference
    and Value now clear the body outline rather than the pad field.
    som.md 10.4 explains what a CPL rotation is, why the number can be right
    and the placement still wrong (KiCad's 0 is the footprint as drawn; the
    machine's 0 is the part as it sits in the tape), how to check it in
    JLCPCB's order preview, and that the correction goes in the CSV rather than
    by rotating the footprint -- which would move the pads off PHYTEC's
    geometry and fail check_pcb_connectors.py.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
    [gen_som_footprint.py]
2026-08-20 R2: the Stage D playbook, and the half of it a machine can check
    docs/layout.md gains the working document Stage D needs: the KiCad steps in
    the order that avoids rework (set the stackup and net classes BEFORE F8, not
    after -- assigning classes later means re-routing the two groups you least
    want to do twice), the placement order with the fixed points the panel flex
    and the SoM decision have pinned down, the routing order, and the review
    loop.
    Section 7 is the part worth reading before touching anything: the five
    things that destroy the board. They are the ones where the failure is
    permanent, silent in every file, and not caught by DRC -- U9/U26's GND pin
    sitting at -20 V and -15 V; the DDR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
    [check_pcb.py]
2026-08-20 R2: point check_pcb.py at the right layout.md section for creating the board
2026-08-20 R2: diagnose the 305 missing footprints, and give the board 3D models
    The report is unambiguous once split by library: every failure is a stock
    KiCad library and every footprints:/r2: footprint resolves. The project
    libraries are found by relative path; the global table is broken.
    ~/.config/kicad/10.0/fp-lib-table holds one entry pointing at
    /tmp/.mount_kicadremp.../share/kicad/template/fp-lib-table -- an AppImage
    mount point. AppImages mount at /tmp/.mount_<random>, the name changes every
    launch, and the directory is gone when the app exits. It has pointed at
    nothing since it was written. This is standing ask 3: the 305
    footprint_link_issues in every ERC run since WP1 are this exact fault,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
    [BTH-060-01-L-D-A-K-TR.stp, PCM-071.step, r2.kicad_pcb]
2026-08-20 R2: a script to repair KiCad's library paths, instead of instructions
    The owner does not run the AppImage -- KiCad is an extracted AppDir at
    ~/Apps/kicad-10.0.4 (a symlink to ./AppDir) launched via AppRun. That makes
    the diagnosis better, not worse: /tmp/.mount_<random> is where an AppImage
    mounts itself while running, so the entry in fp-lib-table is a leftover
    written during an AppImage run before the extraction, and dead ever since.
    The symbol table never broke because it was written with absolute paths.
    tools/fix_kicad_paths.sh replaces the hand instructions. It derives the
    paths from the install rather than hardcoding them, verifies all 155
    library paths exist BEFORE installing anything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
    [r2.kicad_pcb]
2026-08-20 R2: place the two receptacles from X2, and fix three bugs found doing it
    The connectors move as one now. tools/place_som.py reads X2's position and
    rotation, snaps J26/J27 onto their exact offsets, and puts all three into a
    KiCad group -- so from here you drag the SoM, not three parts that have to
    agree with each other. It backs up the board, refuses to run while KiCad is
    open, and re-runs the geometry check to prove its own result.
    That symmetry is the reason this is a tool and not an instruction: the two
    offsets are exact negatives about X2's origin, so an error of the wrong kind
    does not shift a connector slightly, it puts J26 where J27 belongs. The
    module still seats and every one of 24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
    [ASP-205225-01.STEP, REF-177862-03.STEP, r2.kicad_pcb, r2.kicad_sch, som.kicad_sch]
2026-08-20 R2: 3D models — 322 of 327 now resolve, and the other five say why
    After the path fix set KICAD10_3DMODEL_DIR, 311 of 327 footprints already
    resolved. tools/add_3d_models.py handles the rest and makes the project
    self-contained: everything it uses lands in 3dmodels/ referenced by
    ${KIPRJMOD}, so the 3D view works on any clone.
    The assumption that R1 has these models is half right in a way worth
    recording. pcb_common keeps 66 STEP files NEXT TO its footprints rather than
    in a .3dshapes directory, which is why searching for 3D directories finds
    nothing -- but several are referenced by absolute paths from the original
    author, J24's pointing at /Users/wenting/Documents/projects/Enchanter/...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
    [FPC-SMD_50P-P0.50_FPC-05F-50PH20.step, FPC-SMD_8P-P0.50_HC-FPC-05-09-8RLTAG.step, HRO_TYPE-C-31-M-12.step, HY-TF1007B.STEP, r2.kicad_pcb]
2026-08-21 R2: import R1's design settings, and nine net classes with reasons attached
    The owner is starting to route and asked what track widths to use. R2's
    project file had never been through Board Setup: KiCad 10 stock values (0.4 mm
    tracks, 1.651 mm vias) and one stray `power` class whose five patterns match
    nets that do not exist on this board.
    R2's stackup turns out to be byte-identical to R1's -- same 0.127 mm prepreg,
    0.6 mm core, 0.035 mm outer copper, ENIG -- so every geometry R1 proved at
    DDR3-666 on a Spartan-6 transfers with its impedance intact. That is the whole
    justification for copying rather than calculating, and it is why R1's
    SDRAM/EPD/USB widths come across verbatim.
    tools/impor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
    [r2.kicad_pcb]
2026-08-21 R2: settings applied, and 200 of the board's 244 DRC errors were mine
    The owner ran tools/import_r1_settings.py --write. check_pcb.py now reports
    8 of 8 net classes present, 122 nets assigned, 0 dead patterns.
    Their own KiCad "import settings from another project" had already pulled R1's
    constraints and presets across first, which is visible in the script's before
    column -- and shows exactly why that is not enough on its own: it brought R1's
    class NAMES (DP, LVDS, SDRAM_A/H/L, POWER) and R1's patterns, none of which
    match an R2 net. Every net would have routed on Default.
    Then the DRC that followed found 244 violations, 200 of them solder_mask_bridge
    on J26 and J27 -- footprints this repo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
    [r2.kicad_pcb]
2026-08-21 R2: C6 goes 0805/10V -> 0603/16V, and clears two DRC errors doing it
    The question was whether the REGN decoupling cap could be smaller. It can,
    and the smaller part is the better part -- but not for the reason the doc
    gave.
    bq25896.pdf pin 22 asks for "a 4.7 uF (10 V rating) ceramic capacitor",
    placed close to the IC, and gives no range around it -- unlike tps63802.pdf
    which publishes a 10-50 uF window for its output cap. So the value is fixed
    and the package is the only free variable. REGN sits at 4.7-4.8 V here (spec
    table, V(VBUS) = 5 V), and a ceramic loses capacitance with the field across
    its dielectric, so a higher rating in a smaller case can beat a lower rating
    in a larger one.
    Fi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
    [battery.kicad_sch, r2.kicad_pcb]
2026-08-21 R2: a parallel board (r2_claude) and the toolchain that places it
    A second, independent layout of the same netlist, to be compared against the
    owner's. It lives in r2_claude.kicad_pcb with its own .kicad_pro so DRC picks
    up all nine net classes; r2.kicad_pcb is not touched by any of this.
    tools/claude_layout/ is the toolchain:
    sexp.py lossless s-expression reader/writer
    board.py footprints, pads, courtyards, board outline
    edit.py surgical moves/rotations, routing strip, silk handling
    place.py the placer -- floorplan, annealer, legaliser
    run_place.py the pipeline
    validate_geom.py checks our maths against KiCad's own IPC-D-356 export
    Two rul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
    [r2_claude.kicad_pcb, r2_claude.kicad_sch]
2026-08-21 R2: withdraw the RWU0007A thermal-pad concern -- it was wrong
    power.md §7 item 2 said KiCad's Texas_RWU0007A_VQFN-7_2x2mm_P0.5mm leaves the
    thermal-pad segments unnumbered, so U12's heat path is not tied to GND, and to
    copy the footprint into r2.pretty and renumber those pads 1 before layout.
    Reading the placed footprint with the layer field visible: the six unnumbered
    pads are F.Paste ONLY. They are stencil apertures -- each large pad split into
    two openings to control solder volume, the standard idiom at that size. Pads
    1/2/3 are F.Cu + F.Mask, numbered, and netted GND / SW / +5V_DCDC. Pin 1 is the
    thermal path per Table 5-1 and it is on GND already.
    Acting on the note would have renumb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
    [battery.kicad_sch, r2.kicad_pcb, r2.kicad_sch, r2_claude.kicad_pcb, som.kicad_sch]
2026-08-21 R2 claude: ground planes, the two HV islands, and a maze router
    Planes first, because GND is 344 of the 1047 ratsnest edges and layout.md
    7.2 wants the DDR3 bus over one continuous In1.Cu -- which only exists if
    In1.Cu is a plane rather than 344 tracks.
    F.Cu GND pour, so SMD ground pads connect where they sit
    In1.Cu the solid plane, the continuous reference
    In2.Cu R1 calls this "mixed"; the third routing layer here
    B.Cu GND pour
    + 76 stitching vias tying the outer pours to the plane
    GND ratsnest 666 -> 44 pads. Board DRC 11 violations, all silkscreen: no
    copper errors, no shorts, no dangling copper.
    layout.md 7.1 / epd-port.md 11.1, the item the docs call the single most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
    [r2_claude.kicad_pcb]
2026-08-21 R2: GND does not belong in a width class, and a check that says why
    The owner, mid-route: "I can't always have a 0.6 mm GND trace. Sometimes for
    signals it's just not necessary." Correct, and the class was at fault.
    GND was in PWR, whose track width is 0.6 mm. But GND's current path is the
    In1.Cu plane; a GND segment is almost always a short stub from a pad to a
    stitching via, where 0.6 mm buys nothing and gets overridden by hand every
    time. On Default it routes at 0.2 mm and takes a 0.6/0.3 via, which is also the
    more useful stitching via -- PWR's 0.8/0.35 is clumsy under a BGA. Clearance is
    0.11 either way. +VSYS stays in PWR: unlike GND it has real routed runs to the
    four converters that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
    [r2.kicad_pcb, r2_claude.kicad_pcb]
2026-08-26 routing and board layout
    [EVQPU-LC-02K.STEP, YFQ12_TEX.step, battery.kicad_sch, frontlight.kicad_sch, mcu.kicad_sch, power.kicad_sch, r1_glider.kicad_pcb, r2.kicad_pcb]
2026-08-29 placed almost all accessory electronics
    [r2.kicad_pcb]
2026-08-30 change layout and reduce board size + add second usb host only
    [5040500391.stp, epd.kicad_sch, fpga_config.kicad_sch, fpga_ddr.kicad_sch, frontlight.kicad_sch, io_expansion.kicad_sch, mcu.kicad_sch, r2.kicad_pcb]
2026-08-31 Touch decided: I2C hand-wired for the prototype; Caster bitgen applied
    Good Display's answer of 2026-08-31 closes the on-board GT9110H idea:
    the driving board is another customer's design and they will not share
    files, so the panel's ITO channel map is unobtainable at prototype
    scale. The production path is now priced instead -- US$750 tooling,
    MOQ 1000/lot, for a custom panel with the interface and touch IC of our
    choosing.
    Owner's decision: option C. Touch runs over I2C on J22, hand-wired to
    the vendor board's test points for the prototype. USB was rejected --
    USB0 is the charge port and USB1 is now the host port, so USB touch
    would have needed a hub and would have cost touch-to-wake perm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
    [epd_power.kicad_sch, io_expansion.kicad_sch, r2.kicad_pcb]
2026-08-31 Docs: library audit list and a first production costing
    libraries.md -- every symbol in r2.kicad_sym and every footprint in
    r2.pretty, with what it was derived from, which tools/ script emits it,
    and what was actually checked. Written for the owner's audit before the
    libraries get rehomed. Notes that pcb_common has never been modified,
    and calls out the three newest entries (TPS2553DBV and the two
    _Mirrored FPC land patterns) as the least reviewed.
    NOTES-production-costing.md -- what 1000 units costs and what a campaign
    would have to raise, prompted by Good Display's US$750 / MOQ 1000 quote.
    Central estimate EUR 340/unit COGS and a EUR ~548k goal, but the honest
    finding is the sensitivity: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
    [battery.kicad_sch, fpga_config.kicad_sch, io_expansion.kicad_sch, power.kicad_sch, r2.kicad_pcb]
2026-08-31 Declare the owner's Reflow symbol library; drop the dead library.pretty
    U902 (the config NOR, was U42) uses lib_id "Reflow:WSON_Flash", but
    sym-lib-table declared only "symbols" and "r2", so KiCad would report it
    as a missing symbol and offer to rescue it. Declared:
    Reflow -> ${KIPRJMOD}/library/Reflow.kicad_sym
    fp-lib-table also carried an entry for ${KIPRJMOD}/library.pretty, which
    does not exist on disk -- an error on every project open. The real
    footprint library is library/Reflow.pretty and was already declared
    separately as "Reflow", so the dead entry is removed.
    Verified: the netlist exports with no warnings and U902's eight nodes are
    identical to what U42 had -- pin 1 NOR_CS#, 2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
    [r2.kicad_pcb]
2026-08-31 Recover from the KiCad crash; finish the USB1_D+/D- rename
    KiCad crashed and deleted 150 tracked files plus 19 untracked ones.
    Recovery, in the order that matters:
    1. copied _restore_backup_2026-08-31T20-57-08-688 aside (261 MB)
    2. rescued the 4 untracked files that existed only there -- the
    PHYTEC PCM-071 STEP/x_t/Basic models and the library/3dmodels copy.
    The other 15 were __pycache__, .lck and .bak.
    3. git checkout of the 150 deletions (deletions only, so the six
    modified files were never touched)
    4. three files the crash had *rolled back* rather than deleted, and
    which git checkout therefore missed, restored from HEAD:
    r2.kicad_sym -- was 11 symbol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
    [io_expansion.kicad_sch, r2.kicad_pcb, r2.kicad_sch, r2_claude.kicad_pcb, som.kicad_sch]
2026-08-31 Fix the severed +3V3_TOUCH rail and U902's GND pin type
    +3V3_TOUCH reached only J22.1; U54.A1 and C517.1 sat on an unnamed
    Net-(U54-OUT) after the io_expansion re-layout. Added a stub and label on
    the switch output at (115.57..127, 68.58). The rail is now
    U54.A1 + C517.1 + J22.1 as intended.
    U902's GND (pin 4) was typed power_out in Reflow:WSON_Flash -- a flash's
    ground is a consumer. That one wrong type produced both pin_to_pin
    errors, conflicting with the GND PWR_FLAG and with U41.N11's M1 strap.
    Changed to power_in, and EP (pin 9) from power_out to passive. Patched in
    both the library and the copy fpga_config.kicad_sch embeds, since the
    schematic uses the embedded one.
    ERC: 14 errors /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
    [fpga_config.kicad_sch, io_expansion.kicad_sch]
2026-08-31 Renumber io_expansion to the page-14 scheme
    The owner's designator scheme is classifier + sheet page number + a
    two-digit part number, counted from 00 -- battery (page 2) is U200/J201,
    power (page 3) is U300-U304, fpga_config (page 9) is U902. Pages 10-14
    therefore need four digits, which the owner confirmed.
    io_expansion is page 14:
    U54 -> U1400 touch load switch J22 -> J1400 touch FPC
    U55 -> U1401 pen load switch J23 -> J1401 pen FPC
    U56 -> U1402 TPS2553 USB switch J28 -> J1402 USB-C host
    U57 -> U1403 USBLC6 ESD
    R520 -> R1400 CC1 pull-up C517 -> C1400 touch rail
    R521 -> R1401 CC2 pull-up C518 -> C1401 pen rail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
    [io_expansion.kicad_sch, r2.kicad_pcb]
2026-08-31 R2: renumber every sheet to the page-based designator scheme
    The owner's scheme is classifier + sheet page + two-digit part from 00. Four
    sheets already used it; this converts the remaining nine, so all thirteen now
    agree: pages 2-9 take three digits, pages 10-14 four. 292 of 333 designators
    changed. A part shared by several sheets takes its lowest page, so the FPGA is
    U700 (pages 7-9) and the two SoM connectors are J501/J502 (pages 5-6).
    The whole risk here is silently rewiring the board, so the netlist was diffed
    rather than eyeballed:
    nets 519 -> 519, total pin connections 1563 -> 1563
    named nets present in both whose pin multiset changed: 0
    ERC unchanged at 14 errors / 20 warning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
    [battery.kicad_sch, dpi_in.kicad_sch, epd.kicad_sch, epd_power.kicad_sch, fpga_config.kicad_sch, fpga_ddr.kicad_sch, fpga_io.kicad_sch, frontlight.kicad_sch]
2026-09-11 changing to osb62x-pm
    [OSD62-PM-BRK.brd, OSD62-PM-BRK.sch, OSD62x-PM-Pin-Mapping-V1.0.xlsx, battery.kicad_sch, dpi_in.kicad_sch, epd.kicad_sch, epd_power.kicad_sch, fpga_config.kicad_sch]
2026-09-13 Schematics update for new chip.
    [battery.kicad_sch, dpi_in.kicad_sch, epd_power.kicad_sch, fpga_config.kicad_sch, fpga_ddr.kicad_sch, fpga_io.kicad_sch, frontlight.kicad_sch, io_expansion.kicad_sch]
