UavL/Glider/(notices)

Notices in the files:
fw/Core/Src/main.c:
Copyright (c) 2025 STMicroelectronics.
All rights reserved.
This software is licensed under terms that can be found in the LICENSE file
utils/wbf_waveform_dump/main.c:
This is free software: you can redistribute it and/or modify it under the
terms of the GNU General Public License as published by the Free Software
pcb/r2-mainboard/datasheets/SiC OSD62x-PM/OSD62-PM-BRK-3/OSD62-PM-BRK.sch:
(c) Copyright, Octavo Systems LLC, 2024-2025. All Rights Reserved.
pcb/r2-mainboard/fpga_io.kicad_sch:
Copyright 2025 Modos Tech Inc
